Qexran/GongKeCompetition/训练/OpenMV巡线训练/训练工具TrackingLineProject_1.1/labeltool/tasks/D/verif/0094.jpg

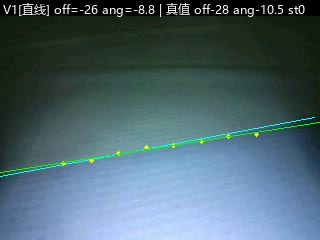
训练/OpenMV巡线训练/训练工具TrackingLineProject_1.1/labeltool/tasks/D/verif/0094.jpg
