Qexran/GongKeCompetition/README.md

# GongKeCompetition
2026年广东省工科大学生实验综合技能竞赛开源项目

持续施工中...
预计2026年1月1日完成所有工作。
给个三连吧TAT

## License

本项目基于 [Apache License 2.0](LICENSE) 开源。
