Qexran/GongKeCompetition/训练/md文档/GKS跑图评估_2026-10-09晚_四点待办.md

# GKS 跑图评估 —— 2026-10-09 晚（21:13:51 ~ 22:50:05）

> 数据源：`\\192.168.66.125\shared\Desktop\GKS_Competition\logs\`
> 覆盖 9 个 run 目录（`run_20261009_211414` ~ `run_20261009_224729`）、52 张归档帧。
> 本文只收敛**需要动手的四点**；时间线 / 视觉成功率 / 文档漂移那几节见当次会话的完整评估。

## 背景（5 行）

- 9 次跑图里 **7 次根本没跑起来**（串口找不到或刚连上就掉），跑起来的也只有 213532 跑满两趟。
- **所有跑图都是被 USB 串口掉线掐断的**，没有一次是路线逻辑跑错停下来的：
  窗口内 `[Errno 5] Input/output error` **12 次**，另有两次长时间找不到 `/dev/ttyUSB_GKS`
  （约 3.3 分钟、**12 分钟**，后者靠人工重插才回来）。
- Pi 侧的自动重启 + 重握手兜底是**活的**（每次 `握手成功（第 1 次尝试，用时 0.1s）`，重连后指令立刻恢复），
  **也没看出单片机被这条链弄聋**。这是赛前最该先解决的硬件问题，本文不展开。
- **路线与视觉本身是通的**：扫码 4/4、色球 4/4 三球齐、人质 4/4 三只齐、靶标 4/4 三色齐、
  平移射靶闭环 4/4 `SHOT ok: d=1~3px`、支点转弯接管 12/12 `PVL: r=2`（1568~1688ms）。
  抽看 13 张归档帧，**没有一张是框错的**。
- 下面四点里，**只有第 1 点是已确认的代码缺陷**（且只影响日志）；2~4 点是需要台架对照验证的可复现性问题。

---

## 1️⃣ 【固件·已确认】`ROAD fix:` 打印的是**横向**数值 —— 调试串张冠李戴

### 现象
只要同一步里横向（`use_y`）也动了，`ROAD fix: X mm(F/B)` 报出来的数字就是**横移量**，
不是纵移量；而且方向字母取自纵向、数字取自横向，两者会互相矛盾。

### 证据（`Application/app_rpi.c`）
| 行 | 代码 | 作用 |
|---|---|---|
| L1136 | `bt_fmt_f2(acMm, …, fMm)` | 纵向值写进 `acMm` |
| **L1212** | `bt_fmt_f2(acMm, …, fMmY)` | **横向值把 `acMm` 覆盖掉** |
| L1234 | `snprintf("ROAD fix: %smm(%s)", acMm, …)` | 拿被覆盖的 `acMm` 当纵向量打印 |

实际数据完全对得上（`ROAD_DX_SCALE_MM_PER_PX = 0.25`、`ROAD_DX_IDEAL_PX = 1070`）：

| 看路测得的 Δx | 横向那一行 | 打印的 `ROAD fix:` | 真正的纵向值 |
|---|---|---|---|
| 1048.7 | `fixy: skip (within deadband)` | `5.33mm(F)` | (1070−1048.7)×0.25 = **+5.33** ✅ 对（未被覆盖） |
| 1202.0 | `fixy: 4.92mm(R)` | `4.92mm(B)` | (1070−1202)×0.25 = **−33.0** ❌ 错 |
| 626.7 | `fixy: −21.86mm(L)` | `−21.86mm(F)` | (1070−626.7)×0.25 = **+110.8** ❌ 错，且与方向字母 F 矛盾 |
| 1312.0 | `fixy: 34.40mm(R)` | `34.40mm(B)` | (1070−1312)×0.25 = **−60.5** ❌ 错 |

窗口内 18 次看路里约 10 次横向也动了 → **这个 bug 在大多数步上都发作**。

### 影响
**实际运动是对的**（L1239 `vChassisMoveCameraForward(fMm, …)` 用的是没被覆盖的 `fMm`），
**只有日志一行错**。但这是「曾经把像素当角度读、导致一整轮排障跑偏」的同款陷阱：
现在这行会把人骗去调 `ROAD_DX_SCALE_MM_PER_PX` 或怀疑方向符号。

### 建议动作
L1234 之前补一句重格式化即可（一行）：

```c
bt_fmt_f2(acMm, (int)sizeof(acMm), fMm);   /* 横向那一段覆盖过 acMm, 打印前重新写回纵向值 */
(void)snprintf(acDbg, sizeof(acDbg), "ROAD fix: %smm(%s)", acMm, (fMm > 0.0f) ? "F" : "B");
```

顺手核对 `app_script.h` / `map.c` / `app_rpi.c` 里其它「两块标记共用同一个 `snprintf` 缓冲」的地方
有没有同类的跨段复用。

---

## 2️⃣ 【Pi·待查】连排两次看路，Δx 差 89~153px，而单次内散布只有 4~6px

### 现象
路线里 `看路` 是**连排两块**（本意是迭代收敛纵向）。但相邻两次测量差得离谱，而车在这两次之间
只收到了一条 5.33mm 的移动指令。

### 证据
| run | 第一次 | 第二次（约 3s 后） | Δ | 掩膜面积变化 |
|---|---|---|---|---|
| 215310 | Δx=1048.7，面积 355232，散布 4.0px | Δx=**1202.0**，面积 253516，散布 6.0px | **+153px** | **−29%** |
| 213532 | Δx=1120.0，面积 320324，散布 0.0px | Δx=**1209.0**，面积 249948，散布 20.0px | **+89px** | −22% |
| 222827 | Δx=1313.3，面积 196928，散布 2.0px | Δx=**1198.7**，面积 248228，散布 22.0px | **−115px** | +26% |

- 按 0.25 mm/px，5.33mm 的移动只该让 Δx 变 **21px** —— 实际变了 89~153px，**差一个数量级**。
- **单次内的逐帧散布只有 4~22px**，所以这不是测量噪声：**两次之间画面是真的变了**。
- 方向还不一致（+153 / +89 / −115），说明不是某个固定的系统性偏差。

### 嫌疑（按可能性排）
1. **有人在景**。这几次的归档帧里到处是人的腿/鞋/手：
   `215310/target_0001` 画面里有两条小腿，`222827/hostage_0001` 有只凉鞋，
   `221401/target_0007` 右上角有只手。跑图区显然有人围着转。
   而运行时覆盖把 `ROAD_ROI_BOTTOM` 从 0.72 放到了 **0.95**（见 `config_override.json`），
   ROI 已经把车身、地面大面积包进来，「最大连通块」的候选变多，更容易被前景干扰。
2. **补光灯开关时机**。`ROAD_LED_OFF_EN=1` 的时序是「`L,0` → 等 `ROAD_LED_OFF_DELAY_MS`(100ms) → 发 `G`」，
   而 `L,0` 要经 **MCU → Pi → OpenMV 三跳**才真的熄灯。前后两次测量只隔 3s，100ms 可能压根不够，
   灯态恰好横跨采样窗 → 两次看到的是两种照明。
3. **散布门挡不住这个**：`看路` 的 `散布超限` 判据只看**单次窗口内**的极差；
   一个人从窗口开始就站在景里、或者灯态在整个窗口里保持一致，测量就「自洽但是错的」。

### 建议动作
- **路线层**：别连排两块看路（要么去掉一块，要么中间插一个真正会改变位姿的步骤）。
- **判据层**：给看路加一道「同一停车位重复测量一致性」门，而不是继续靠窗内散布。
- **台架对照（先做这个，10 分钟能出结论）**：车摆好不动、现场清人、连发两次 `G,6000`，
  看两次 Δx 复现性；再在开/关 `ROAD_LED_OFF_EN` 两种条件下各做一遍。
  若静态复现良好 → 锅在前景/灯态；若静态就差 100px+ → 锅在测量本身（阈值/连通块选择）。

---

## 3️⃣ 【Pi + 固件】靶标「跨帧散布」作废 8/12 次，3 次把请求色整色丢掉 → 整步拒绝不动车

### 现象
`221401` 22:20 起的台架「射靶测试」里，12 次 `6`（靶标扫描）中有 **8 次（67%）**至少一个颜色被
「跨帧散布超限」作废；36 个色位丢掉 10 个（**28%**），其中蓝色最脆（12 次里 6 次被废）。

### 证据
12 次扫描的作废明细（`[WARN] 靶[X] 跨帧散布 NNpx 超限（机位在动或误检），作废`）：

```
靶[蓝] 91px | 靶[绿] 61px + 靶[蓝] 54px | 靶[蓝] 66px | 靶[红] 956px
| 靶[绿] 66px + 靶[蓝] 66px | 靶[蓝] 53px | 靶[蓝] 66px | 靶[红] 50px
```

12 次扫描保留的颜色数：红 10 / 绿 10 / **蓝 6**（应为各 12）。

**跨仓库后果**：有 3 次被作废的正好是**当次请求色**，固件收到不含该色的结果帧 →
整步拒绝、车一步不动：

```
[STM-DBG] SHOT fail: color 3 not found      ×2   (3 = 蓝)
[STM-DBG] SHOT fail: color 2 not found      ×1   (2 = 绿)
```

### 关键对比（说明这更像环境而非算法退化）
**同一晚路线内的 4 次靶标识别全部三色齐、零作废**（213532 两次、215310 一次、222827 一次）。
差别就是台架试验时人贴着车、手在画面里。

### 但脆性是真的
判定链目前是「该色整色作废 → 整步失败」。CLAUDE.md 记的 2026-10-07 那次（蓝 81px 冷启动散布被废、
cnt=2、目标红明明识别得很好）已经踩过一次；这次又踩了 3 次。

### 建议动作
- 请求色被作废时**先重采一次再判失败**（现在是一次就到底）。
- 或者把作废降级为「保留中位数 + WARN」——`截尾复核`（2026-10-07 加）已有雏形，可以再放宽一档。
- 台架上做对照时**先把人清出画面**，否则测到的是环境噪声。

---

## 4️⃣ 【固件·保持环】`TARGET_STREAM_MAX_S=12` 让保持模式每 12 秒瞎一次

### 现象
`221401` 的射靶测试（OLED 第 5 页「射靶测试」→ 保持档）里，Pi 的流线程**每 12 秒自己退出**
（`[WARN] 靶标流超过安全时长 12.0s，自动停止`），而保持环永不超时，只能靠自愈限速重发 `"7"`：

```
[STM-DBG] SHOT hold: stream stale, re-arm      ← 出现 5+ 次
```

每次重臂期间大约 **1 秒是完全盲的**（帧计数停涨 → 冻结），而保持模式的用途恰恰是
「一直咬住瞄准列」做人工标定 —— 反复瞎会直接影响标定读数。

### 附带发现：保持环的行程预算消耗比预期快
```
SHOT n=33  d=1px     tr=8mm   tot=-19mm
SHOT n=39  d=119px   tr=25mm  tot=-1mm     ← 一次扰动，1s 内 tr 25→82mm
SHOT n=54  d=7px     tr=82mm  tot=54mm
SHOT n=123 d=-226px  →  SHOT hold: noprog d=-226px frozen
```
`tc_travel_mm = 150` 只够这样一次半的大扰动。`d=-226px` 那次 noprog 冻结其实是**正确**的
（命令了约 124mm 车却不动 ⇒ 判断为锁错对象，拒动比瞎追好）。

### 建议动作
- **改 Pi 的运行时覆盖**：`TARGET_STREAM_MAX_S` 调到远大于一次实操时长
  （Web「设置参数」页可改，不用动源码、不用重启除服务和 gks 以外的东西）。
  它是安全阀（防 `"8"` 丢失后一直占相机），不是节拍器。
- 或者在保持档里让 `"7"` 只发一次、别靠自愈反复重臂。
- 若要继续用 12s：把 `tc_travel_mm` 按「一次扰动 ~60mm」重新给（现在 150 只够两次半），
  并接受每次重臂 1s 的盲窗。

---

## 附：口径

- 掉线计数 = 各 run 日志里 `接收失败: [Errno 5] Input/output error` 的行数（12）。
- 「看路」数据取自 Pi 的 `看路成功:` 行与固件的 `ROAD dx:` / `ROAD fixy:` / `ROAD fix:` 串，
  两张表按时间戳逐条手工配对（同一 attempt 的内部顺序是 `meas → dx → y → fixy → fix`）。
- 靶标作废/丢色统计取自 `221401` 的 `跨帧散布` 与 `靶标识别成功:` 行。
- 归档帧归档口径：每执行一次任务存一帧（成功 = 标注帧，失败 = 最后一帧原图），
  文件名 `<task>_NNNN.jpg` 递增不覆盖 —— ⚠️ **失败是时间维度时（跨帧/投票），
  归档的那一帧永远是"最后定格且正确"的那张**，光看图查不到原因。
