Qexran/GongKeCompetition/训练/md文档/对巡线改造第四版方案的评审.md

# 对《巡线改造（第四版）》的评审

> 结论先行：**v4 是四个版本里第一份可以批准实施的方案。** P1~P5 全部正确关闭，
> 其中"valid=0 ⟹ fWSum=0 ⟹ fW=0"的逐行核验（app_line.c:183-217）是重要新发现——
> 在 gyro_w=0 的现状下，valid=0 就是精确的"航向弃权"，不需要任何跨仓库常数。
> 但方案仍有一个**没量化过的新暴露**（R2，数字相当大）和一个**部署遗产丢失**问题（R1），
> 建议并入后再动工。

---

## 〇、P1~P5 关闭情况核验

| v3 评审项 | v4 处置 | 核验 |
|---|---|---|
| P1 angle 衰减到 0 = ±6rpm 常值旋转 | 删除衰减；窗口内保持上次可信值，窗口结束 valid=0（fW=0） | ✅ 逻辑成立；但窗口内冻结角本身有新的代价，见 R2 |
| P2 EMA 连坐删除 | 恢复 EMA(α=0.15) 作复核判据，带 robust running-mean 保护（0.5×sep 拒收）+ 只在健康帧更新 | ✅ 比我原版更好（多了拒收保护） |
| P3 二次拟合外推无 sanity | 三条门槛（控制列在跨度 1.5 倍内 / ≥6 点 / 曲率项 ≤0.5），不满足退回割线；趋势改 2~3 帧滑窗+6px 死区 | ✅ 成立 |
| P4 col_profile 无消费者 | 随 P2 恢复（EMA 复核需要 a/b） | ✅ |
| P5 阶段二时机 | 接受"赛后/§6 基线后再决定" | ✅ |

另外两处值得肯定的进步：
- **valid=0 ⟹ fW=0 的逐行核验**正确——这直接把"弃权"的实现成本降到零（发 valid=0 即可），
  也反过来解释了为什么 v2 的 NEUTRAL 常数从一开始就是多余的；
- 风险节**主动自曝**了强弓形直线的全点 RMS 误命中（两半斜差对弓免疫、全点 RMS 不免疫，
  两条判据是 OR）——这是本方案最诚实的自我标记，见 R3。

---

## R1【部署遗产】阶段一以 435 行原版为基底，会第三次丢掉两样已验证的修复

E:\main.py 当前是原版（435 行、4 字段、13条×12px、LED 1kHz）。方案的"不做"清单写着
"不动……LED、串口"，阶段一也完全没提性能——那么按此重写后：

1. **LED 蜂鸣修复丢失**：`freq=20000`（20kHz，实车确认过的蜂鸣问题）不在原版里，
   重写后蜂鸣声回来。一行改动，务必带上。
2. **帧率优化与测量仪器丢失**：STRIP 12→20（每帧 get_statistics 106→66 次）、
   邻域 ±1 条、色带 40/24、分阶段剖析器——都在 `.bak-strip20` 里。用户的未结抱怨
   恰恰是"帧率低、响应慢"，而 v4 新增的一堆动态阈值（OFFSET_SLEW / LOST_GRACE_MS /
   TRACK_GATE_PX 新鲜度）全部需要真实 fps 才能标定——**剖析器正是标定它们的仪器**。

**要求**：阶段一的基底改为 `.bak-strip20`（或显式移植上述三样），验收清单加一条
"prof 行 fps ≥ 20 且 LED 无声"。

## R2【新暴露，需量化】600ms 宽限窗内"冻结角 + valid=1" = 一次有界的航向过冲，但界不小

窗口期内 angle 不发新值、保持上次可信值，且 valid=1 → 固件航向环
**每拍都在拿这个冻结角当活测量做 P 控制**。过冲量的推演
（LINE_ANGLE_TO_W=2.0 rpm/°，1 rpm = 6°/s，LOST_GRACE_MS=600ms）：

| 出画前最后一帧的 angle | 航向环输出 | 600ms 内的偏转 |
|---|---|---|
| 0°（对齐常态，目标 −3°） | 6 rpm ≈ 36°/s | **≈ 22°** |
| 5° | 16 rpm ≈ 96°/s | ≈ 58° |
| 13.7°（img_0007 型） | 33 rpm ≈ 200°/s | **≈ 120°**（贴近 LINE_W_MAX=40rpm 限幅） |

也就是说：**最常见的"对齐状态下短暂丢线"事件，每次都要白给 20° 出头的航向偏转**；
拐角型角度下接近满限幅转半圈。原版（立即 valid=0）和我方版本都没有这个暴露——
它是宽限窗新引入的。若丢线原因是减速带撞击（正是本方案要救的场景），
这 20°~120° 叠加在撞击本身造成的航向紊乱上。

**建议（任选其一，都很便宜）**：
1. **窗口进入条件**：只有 `|last_angle| ≤ ANGLE_WINDOW_MAX_DEG(≈5°)` 时才开宽限窗
   （用 |last_angle| 作 |angle−target| 的代理，注明真常数在固件侧）；
   超限直接 valid=0 + state——方向反正由 Pi 定向找线接管；
2. **横摆预算缩窗**：`GRACE_MS = min(600, YAW_BUDGET_DEG / (|last_angle+3|×12°/s))`
   ——对齐情形给满 600ms，大角度情形自动缩到几十毫秒。

顺带指出一个更深的张力（台架要专门测）：只要 line_angle_target≠0，
valid 0↔1 抖动时**航向通道就是 (angle−target)×2 ↔ 0 的方波**，幅度随
|angle−target| 增大——在拐角处（切线 13~30°）恰好最大。v3 的"抽搐"如果实车日志显示
旋转通道在抖，根子在这里，而不是 steer 通道（steer 在保持期≈PID，本来就近乎连续）。

## R3 强弓形误命中（方案已自flag，补一个降险建议）

两条判据是 OR → 强弓形直线必然走全点 RMS 那条误命中。可以降险：
**分级而非并联**——两半各 ≥2 点时以两半斜差为唯一判据（对弓免疫）；
只有半边点不够时（0004/0006 型）才允许全点 RMS 兜底。
弓形误判就只剩"半边点不够 + 恰好弓形"的组合，暴露面小得多。
0004/0006 的兜底能力保留。台架复标时按这个结构测。

## R4 小项

- 文档"风险/验收"两节重复粘贴了一遍（编辑痕迹），定稿前清一下；
- img_0001 验收期望 state=3 与方向推演一致（+100 → err=−0.8 → 远离边界）✓；
- LOST_GRACE_MS=600ms 与 Pi 侧 LINE_STALE_TIMEOUT=0.5s / 30Hz 转发无时序冲突（已核）；
- EMA α=0.15 + 0.5×sep 拒收 + 健康帧更新——比我方原版（固定 α、无拒收）更完善，采纳。

---

## 结论

| 项 | 判定 |
|---|---|
| P1~P5 关闭 | ✅ 全部成立 |
| R1 部署遗产（LED 20kHz + strip20/剖析器） | ❌ 需并入阶段一基底 |
| R2 宽限窗冻结角的航向过冲（常态 ≈22°/次，拐角型可到 120°） | ❌ 需加窗口进入条件或按横摆预算缩窗 |
| R3 强弓形误命中 | ⚠️ 已自flag；建议"分级判据"降险 |
| 总体 | **批准实施（并入 R1/R2 后）**；§6 排查清单最先执行，拿基线 |

执行顺序建议：§6 摆车读 ang（零代码，定"越来越偏"的因）→ 阶段一（基底 = .bak-strip20
+ 本方案全部条目 + R1/R2 修正）→ PC 回归 + 台架复标 → 实车日志标定动态阈值 →
赛后决定阶段二。
