Qexran/GongKeCompetition/训练/md文档/爆爆桶对位_改动与适配指南.md

# 爆爆桶对位（看爆爆桶）—— 改动清单与适配指南

> 2026-10-24 实现 · 覆盖 OpenMV（相机盘 E:\） / 树莓派（GKS_Competition） / 单片机（GongKeCompetition）三端
> 相机固件版本升 **v3.4**（开机 UART 横幅 `gks-line v3.4 (2026-10-24: 新增爆爆桶检测 'B'起流/'b'停流)`）

---

## 1. 功能总览

爆爆桶（黑色桶块）对位是一个**独立阶段任务**（对位时车不巡线，2026-10-24 定案）：

```
OpenMV v3.4（检测黑色桶，每帧只报面积最大的一个桶 = 最近/最清晰）
   │  UART 文本帧: "B,<valid>,<cx>,<cy>,<w>,<h>\r\n"   @115200
   │  控制字节: 'B'=起流  'b'=停流  'S'=全停（兼容）
   ▼
树莓派（纯转发，独立线程，~20Hz；与巡线流/靶标流三方互斥）
   │  二进制 COORD 帧 TAG=0x0B: [0x0B][status][cx][cy][w][h] = 10B 定长
   │  单片机命令: "J"=起流（可带毫秒预算 "J,15000"）  "K"=停流
   ▼
单片机 ucRpiBarrelAlign（0x0B 流帧 → cx 偏差 → 纵移闭环）
   │  轴映射与平移射靶同款：相机装 90°，图像 cx ↔ 车体纵移 v_y（vChassisMoveCameraForward）
   ▼
底盘（位置/速度双模式；收敛拍数 + 行程闸 + noprog 闸 + 停稳窗）
```

设计要点（决策记录）：
- **多桶策略 = "OpenMV 挑好再报"**：相机端每帧只报面积最大的一个桶，Pi 不掺和选择（以后换策略只改相机/单片机，帧不变）。
- **检测不用任何 LAB 颜色阈值表**：暗阈值 L<26 一把尺（运行时可调），换场地不用重标颜色。
- **未标定自举**：`bc_cx_aim=0` 时对位步进**只测不改**模式——起流采 3 秒报中位 cx、一格不动（`BKT meas:` 日志行 + 蓝牙遥测 `bucket_err`），解决"瞄准常数永远是 0"的鸡生蛋问题。
- **帧活性靠帧计数**（同 0x05 靶标流语义）：无桶/陈旧也照发，`status bit0` 才是"本拍有没有桶"。

---

## 2. 帧契约速查

### 2.1 OpenMV → Pi（UART 文本，115200）

```
B,<valid>,<cx>,<cy>,<w>,<h>\r\n
```

| 字段 | 含义 |
|---|---|
| valid | 1=本帧选中了一个桶；0=没找到（坐标为上一帧沿用值，同 L 帧语义） |
| cx/cy | 选中桶 bbox 中心像素坐标（**320×240 QVGA 口径**） |
| w/h | 桶 bbox 宽高 [px]（轴对齐外接框） |

### 2.2 Pi → 单片机（二进制 COORD，TAG=0x0B，~20Hz）

```
DATA = [0x0B][status u8][cx u16 LE][cy u16 LE][w u16 LE][h u16 LE]   共 10 字节
```

| 字段 | 含义 |
|---|---|
| status | bit0 = 1 本拍有桶 / 0 无桶或数据陈旧（流还活着，帧计数照涨）；其余位保留 |
| cx/cy/w/h | 同上；valid=0 时是沿用值 |

示例（valid=1，桶中心 (143,67)、85×54）：
`0B 01 8F 00 43 00 55 00 36 00`

### 2.3 单片机 → Pi 命令

| 命令 | 含义 |
|---|---|
| `"J"` | 爆爆桶坐标流开始（独立线程，0x0B 流帧 ~20Hz）；`"J,<毫秒>"` = 单片机愿意等多久（同阻塞类指令口径，Pi 折算预算） |
| `"K"` | 爆爆桶坐标流停止（幂等） |

### 2.4 Pi → OpenMV 控制字节

| 字节 | 含义 |
|---|---|
| `'B'` | 开始爆爆桶流（发 B 帧；桶模式独占时跳过巡线测量省帧预算） |
| `'b'` | 停止爆爆桶流 |
| `'S'` | 全停（巡线 L 流 + 爆爆桶 B 流） |

### 2.5 与既有协议的兼容性（三端任一端不升级都不炸链路）

- 旧相机收到 `'B'` → 未知控制字节，忽略 → 流起不来，单片机帧计数停涨自动冻结（安全退化）。
- 旧 Pi 收到 `"J"` → 未知指令打一行 WARN。
- 旧单片机收到 0x0B 帧 → 没有该分支，10B 帧落进通用 last-packet 分支（不会误触发什么，等待方靠超时长鸣退出）。
- **旧固件发裸 "J" 没问题**；新 Pi 收到未知 'B' 字节进 openmv 串口时也只是忽略。

---

## 3. 各端改动文件清单

### 3.1 相机端（E:\，OpenMV MicroPython）

| 文件 | 改动 |
|---|---|
| `main.py` | v3.4：新增「爆爆桶检测」段（常量 + `bucket_probe/bucket_filter_pick/bucket_tiles/bucket_detect/bucket_frame_work`）；UART 加 `'B'/'b'` 命令与 `'N'` 参数（暗阈值 BUCKET_L_MAX，'V' 回执带 N=）；主循环加桶模式独占分支（第 0 步）与两流同开兜底（第 7.5 步）；桶模式下拍照仍可用（'P' 存的是带检测框的帧） |
| `bucket_test.py`（新） | 台架验证脚本：同目录有 1.bmp~6.bmp → 回放模式（打印候选簇/剔除原因/命中/耗时）；无 → 实时预览画框 + 1s 统计。不碰 UART 不写盘 |

相机端检测算法（标定依据：`C:\Users\Administrator\Desktop\爆爆桶图像\1~6.bmp`，2026-10-24 实拍）：
- 检测带 ROI y∈(30,175)（实拍桶体全部在内，避开顶部暗区/底部蓝区）。
- 暗阈值 `BUCKET_L_MAX=26`：桶 lum 4~8、地面 85~150、顶部暗区 ≥29，两侧都有余量。
- **几何剔线**（黑界线与桶亮度完全相同，只能几何区分）：宽>280 或 宽/高>8 或 左右同时触边 → 判线丢弃；桶 sanity 20≤w≤240、15≤h≤140。
- 主路径 `find_blobs`（进桶模式首帧探 3 种调用形态——本固件 2026-09-13 有 "can't convert tuple to int" 前科）；探测全败或运行中异常 → **永久落** `get_statistics` 瓦片网格兜底（16×16 瓦 180 块 + 4 邻接聚类 + 4px 列细扫精化 cx，~60ms/帧，全项目验证过的 API 必可用）。
- 实际走的路径会打印 +（DIAG 开时）镜像 UART：`自检: find_blobs 用 'lab' 形态` 或 `→ 瓦片兜底`。

### 3.2 树莓派端（\\192.168.143.125\shared\Desktop\GKS_Competition）

| 文件 | 改动 |
|---|---|
| `openmv_serial.py` | `_parse_bucket_line()` 解析 B 帧（**在 _parse_line 之前拦截**，防污染 bad_lines）；缓存 `_bucket/_bucket_ts`；`get_latest()` 增加 `bucket` 子字典（valid/cx/cy/w/h/timestamp/expecting/silent_s）；`send_command` 支持 `'B'/'b'`（expecting 状态 + "发了 B 无数据"告警） |
| `tasks/_bucket.py`（新） | 转发线程 `run_bucket_stream`：取快照 → 判新鲜（BUCKET_STALE_TIMEOUT）→ `build_bucket_frame`（函数名刻意唯一，防 __init__.py 重导出覆盖）→ `send_frame(TYPE_COORD, ...)`；`BUCKET_SEND_HZ` 限流；abort/超时/断串口退出 |
| `tasks/__init__.py` | 导出 `run_bucket_stream, build_bucket_frame` |
| `handler.py` | `"J"/"K"` 注册（"J" 进 `_MS_COMMANDS` 支持毫秒后缀）；`_cmd_bucket_start/_cmd_bucket_stop`（照靶标流模式：收尾等待窗 + 重复启动忽略 + finally 兜底发 'b'）；**三方互斥**——起桶流前停巡线流+靶标流，巡线/靶标/阻塞类任务起流前也停桶流；`"x"` 取消、`end/r/RM` 重启、`_safe_restart_program`、串口重连收尾全部联动停桶流 |
| `config.py` | `BUCKET_SEND_HZ=20` / `BUCKET_STALE_TIMEOUT=0.5` / `BUCKET_MAX_S=30` / `BUCKET_LOG_HZ=1`，全部登记 EDITABLE_CONFIG（Web「设置参数」可在线调） |
| `docs/串口协议.md` | 命令表加 J/K 两行；新增 **§6m 爆爆桶坐标流** 章节（帧布局/示例/多桶策略/部署顺序） |

### 3.3 单片机端（C:\Users\Administrator\Desktop\GongKeCompetition，9 个文件）

| 文件 | 改动 |
|---|---|
| `app_rpi.h` | 帧常量 `RPI_BUCKET_TAG=0x0B` / `RPI_BUCKET_LEN=10` / `RPI_BUCKET_ST_OK`；命令枚举 `RPI_TASK_BUCKET_START=28 "J"` / `RPI_TASK_BUCKET_STOP=29 "K"`（尾注释单行，控制台解析要求）；`ucRpiBarrelAlign` 声明 |
| `app_rpi.c` | `s_apcTaskCmd` 加 "J"/"K"；COORD 分发加 **0x0B 分支（插在通用 `ucDataLen>=9` 之前**——否则整帧被当 last packet 吞掉）；新原语 `ucRpiBarrelAlign`（含 `BKT_*` 内部常量） |
| `app_config.h` | `BUCKET_ALIGN_*` 十六个编译期默认宏（含取值范围与标定方法注释） |
| `app_beam.c` | `bc_*` 静态量 + getter/setter + `BEAM_ADAPT_*` 适配器；桶帧快照 `vSetBucketFrame/vGetBucketFrame/ulGetBucketFrameCount`（临界区、只帧计数无 ready）；蓝牙参数表「爆爆桶」组 18 行（含只读遥测 `bucket_err`） |
| `app_beam.h` | bc_* 声明 + 桶帧快照声明 |
| `app_script.h` | 积木枚举 `STEP_BARREL_ALIGN_WAIT` + DSL 参数注释行 |
| `app_script.c` | `case STEP_BARREL_ALIGN_WAIT`（调 `ucRpiBarrelAlign`；刻意**不进** FillTaskOf——车的补光照不到桶，OpenMV 自带补光上电常亮） |
| `map.c` | 预设表 `g_astScriptPreset46`（等握手 → 爆爆桶对位 20s）+ 注册表行 `{46, "测试爆爆桶对位", ..., 1u 可重入}` |
| `map.h` | `SCRIPT_PRESET_46` 枚举成员 + `SCRIPT_PRESET_NEXT_ID 47u` |

对位原语 `ucRpiBarrelAlign(timeout, keep_res)` 的流程（照抄平移射靶精调环，跳过二维码/粗调/双相机段）：

```
① 起流：发 "J"（等链路，失败直接返回，不发 "K"）
② 等停稳：连续 3 个新帧桶 cx 变化 < 4px（上限 800ms，到点照常往下走）
③ 若 bc_cx_aim=0（未标定）→ 只测模式：采 3s 报中位 cx（"BKT meas:" 行），停流返回 0
④ 闭环（每拍 bc_ctrl_ms=180ms）：
     中止位 → 帧新鲜度（停涨 > bc_stale_ms 冻结；> 2× 且限速到 → 重发 "J" 自愈）
     → 取桶帧（无桶continue）→ fDpx = cx − bc_cx_aim（swap 选轴）
     → 收敛判据（|fDpx| < bc_conv_px 连续 bc_conv_ticks 拍，排在 noprog 之前）
     → 偏差mm = fDpx × bc_px_to_mm × bc_sign → 位置模式（钳 ±bc_step_mm，
       阻塞 vChassisMoveCameraForward 纵移）/ 速度模式（rpm 连续修，零速带顶格）
     → 最小出力门 bc_db_mm / 行程闸 bc_travel_mm / noprog 闸
⑤ 无论成败发 "K" 停流（速度模式先显式停车）
⑥ keep_res=1 → 累计纵移折世界系记「路径残留偏移」
⑦ 收官：BKT ok / fail: noprog / fail: travel / abort / fail: timeout
```

---

## 4. 部署步骤（三端都向后兼容，推荐此序）

### 第 1 步：树莓派

```bash
sudo systemctl restart gks
```

- 验证：`journalctl -u gks -f` 无 import 错误；旧相机在位时无异常刷屏。
- 此时可先用**模拟器**（TCP:9997）验证 0x0B 帧收发。

### 第 2 步：相机（E:\）

1. 拷 `main.py` + `bucket_test.py` 到相机盘根，重启相机。
2. **先把 6 张实拍 bmp（`C:\Users\Administrator\Desktop\爆爆桶图像\`）拷到相机盘根**。
3. OpenMV IDE 打开 `bucket_test.py` ▶ 运行 → 回放模式：
   - 每张图打印 `命中 cx=.. cy=.. w=.. h=..` + 候选簇与剔除原因（`剔:过宽/过扁(线)` 等）；
   - 6/6 命中即算法与阈值就绪；命中率低 → 按剔除原因调 `BUCKET_L_MAX`（26→±5 扫）或几何门。
4. `tune_test.py`（Pi 上 `~/Desktop/tune_test.py`，需先 `sudo systemctl stop gks` 独占串口）：
   发 `B` 起流 + `D` 开遥测 → 应看到 `B,v=1,cx=..` 帧与 `#桶 v=1 ...` 状态行；发 `N30` 看阈值即时生效回执 `#OK N=30.0`。
5. 台架实时模式（删掉/挪走 bmp 再跑 bucket_test.py）看 fps：find_blobs 路径应 >20fps；瓦片兜底 ~13-15fps。

### 第 3 步：单片机（需 Keil，人工执行）

1. Keil 打开 `MDK-ARM/GongKeCompetition.uvprojx` 重新编译（本机无 AC5，**未编译过，以编译结果为准**）。
2. 烧录后，控制台（webconsole）重启 + 浏览器 Ctrl+F5（积木目录是加载时拉的）。
3. 蓝牙 Tab 应出现新分组「爆爆桶」（18 个参数 + 遥测 bucket_err）。

---

## 5. 现场标定流程（预设 46「测试爆爆桶对位」，可重入）

**前提**：车摆到"正对爆爆桶、即推桶臂/车头动作的起始位姿"。

| 步骤 | 操作 | 看什么 |
|---|---|---|
| ① 读瞄准列 | 不填 bc_cx_aim（保持 0）→ 跑一次预设 46 | `BKT meas: cx=143 cy=67 w=85 h=54 n=..  <-- 填进 bc_cx_aim`；或蓝牙遥测 bucket_err 稳定值。把 cx 填进蓝牙「爆爆桶」组 `bc_cx_aim` |
| ② 定方向 | 前后挪车 ±20mm，各跑一次 | `bucket_err` 变大 = bc_sign 对；单调变小也正常（在逼近）；**跑起来后偏差越来越远 = bc_sign 反了，改 -1** |
| ③ 标比例尺 | 记下挪动的真实 mm ÷ bucket_err 变化 px | 填 `bc_px_to_mm`（出厂 0.8 是**占位值**，必须实测重标） |
| ④ 收敛验证 | 再跑一次预设 46 | 日志 `BKT ok: d=..px`，车应自动微调到桶正对后停住；已在死区内则第一拍就收敛 |

标定完把终值回写 `app_config.h` 的 `BUCKET_ALIGN_*` 固化（同 tc_* 那套纪律）。

---

## 6. 参数速查表

### 相机端（'N<0~100>\n' 运行时调，重启回编译值）

| 参数 | 默认 | 说明 |
|---|---|---|
| BUCKET_L_MAX（'N'） | 26 | 暗阈值。检不到桶 → 调大；把暗区/阴影检进来 → 调小 |
| BUCKET_ROI_Y | (30,175) | 检测带。桶在画面里的高度带变了才动它 |
| BUCKET_LINE_W / _AR | 280 / 8.0 | 剔线门。误把桶当线删 → 抬宽门；线漏进来 → 降 |
| BUCKET_TILE | 16 | 瓦片边长（仅兜底路径）。帧率不够可放大（漏远端小桶则缩小） |

### 树莓派（Web「设置参数」在线调）

| 参数 | 默认 | 说明 |
|---|---|---|
| BUCKET_SEND_HZ | 20 | 转发上限频率；相机 ~13-15fps 时有新帧就发 |
| BUCKET_STALE_TIMEOUT | 0.5 | B 帧过期阈值（秒），过期按 valid=0 发 |
| BUCKET_MAX_S | 30 | 流安全上限（秒）；"J,\<ms\>" 会覆盖 |
| BUCKET_LOG_HZ | 1 | 状态日志限流 |

### 单片机（蓝牙「爆爆桶」组，断电回编译值）

| 参数 | 默认 | 说明 |
|---|---|---|
| bc_cx_aim | 0 | 瞄准列 [px]（0~320）。**0 = 只测模式**（标定自举） |
| bc_swap | 1 | 轴映射：1=cx→纵移（本车）；0=cy→纵移（换装法才改） |
| bc_px_to_mm | 0.8 | 比例尺 [mm/px]。**占位值，必须实测重标** |
| bc_sign | +1 | 纵移方向。偏差单调变大 = 反了改 -1 |
| bc_db_mm | 3.0 | 最小出力门 [mm]。**与 conv_px 配套**：conv_px × px_to_mm 应 ≥ db_mm，配反会"带外却永不出力"白烧超时 |
| bc_conv_px / bc_conv_ticks | 6.0 / 6 | 收敛带 [px] / 拍数。别比检测噪声（±2~4px）和 1rpm 顶格步长（~1.7px/拍）更紧 |
| bc_kp_scale / bc_step_mm | 0.8 / 20 | 环增益 / 单拍上限。振荡降 kp |
| bc_travel_mm | 150 | 行程闸（安全夹） |
| bc_ctrl_ms / bc_stale_ms / bc_meas_ms | 180 / 600 / 3000 | 节拍 / 帧新鲜度 / 只测时长 |
| bc_vel_mode | 1 | 0=位置模式（每拍一步停一步）1=速度模式（连续修） |
| bc_accel / bc_speed | 120 / 60 | 纵移加减速 |
| bucket_err（只读） | — | 本拍桶偏差 [px]——标定与排障第一入口 |

---

## 7. 排障指南

| 症状 | 先查什么 |
|---|---|
| 跑对位步秒退、日志 `BKT meas: ... n=0` 或一直 settle | 相机没升级到 v3.4（发 'B' 无回应——openmv_serial 会打"已触发爆爆桶流('B')但 Ns 无 B 帧"）；或 OpenMV 未上电/插错口 |
| Pi 日志 bad_lines 猛涨 | 相机在发 B 帧但 Pi 解析器是旧版（部署顺序错了：先 Pi 后相机） |
| 单片机帧计数停涨、冻结不动 | Pi 侧流线程死了（看 `[爆爆桶流]` 日志与 fps）——正常时 `BC_MAX_S=30s` 会自退、单片机 2×stale 后自愈重发 "J" |
| 回放模式命中率高、实时不命中 | 实时帧过了 `lens_corr`（回放样本是已校正的 'P' 帧）——用 'P' 拍现场帧喂回放对比；多为光照差异，调 'N' |
| 桶检到了但 cx 抖 ±8px | 走的是瓦片兜底路径（`探no`）——正常，列细扫已压到 ±2px；仍抖则 bc_conv_px 放大到 ≥8 |
| 桶贴黑界线时 valid=0 | 粘连成大块被剔线门杀——宁缺勿假是有意行为；调 ROI 上沿避开线，或等分榜现场给桶前留出地面 |
| 偏差单调变大 | bc_sign 反了 |
| 原地振荡 | 降 bc_kp_scale 或加大 bc_db_mm |
| `BKT fail: noprog` | 方向反 / 比例尺离谱 / 桶被顶住 —— 看 BKT n= 过程串的 d 走向 |
| `BKT fail: travel` | bc_travel_mm 用光：方向反或误检带飞；先看 bucket_err 遥测 |

---

## 8. 已知限制与诚实记录

1. **单片机 C 代码未经编译**（本机无 Keil/AC5）——全部按 `ucTargetShootCore` 既有模式书写，以编译结果为准；改了 app_script.h/map.* 后控制台要重启 + Ctrl+F5。
2. **find_blobs 探测结果未知**：三种形态（lab/flat/gray）若全失败自动走瓦片兜底，`#` 遥测与 IDE 打印会标明实际路径。
3. **桶贴黑界线粘连**是最大的算法风险（亮度完全相同）；几何过滤宁可错杀（valid=0）不放假桶。
4. **bc_px_to_mm=0.8 是占位值**，上场前必须按 §5-③ 实测重标。
5. E:\main.py 的改动通过补丁脚本完成（E 盘对编辑工具只读），补丁带 CPython 语法自检且已通过；**MicroPython 运行时行为仍需上机验证**（已规避 math.hypot 等 MP 不支持的 API，全部沿用工程验证过的 get_statistics / draw_* / % 格式化）。
6. 会话中 Windows shell 与 SMB 共享一度故障，树莓派 5 个 Python 文件均已通过 py_compile；共享恢复后建议肉眼过一遍 `handler.py` 的「爆爆桶坐标流」段（约 1146 行起）。
7. 临时工作目录 `C:\Users\Administrator\Desktop\_bucket_work`（补丁脚本/探针/文档中间件）用完可删。
8. 三端改动**均未提交 git**（E:\ 仓库 + 单片机仓库 + 树莓派仓库），需要的话再说。

---

## 9. 后续可扩展项（按需再做）

- **同时巡线+看桶**：相机端两流可同开（帧率掉到 ~10fps），Pi 侧把 0x0B 并进 `_line.py` 同一循环即可（现架构是互斥的，用户当前选择独立阶段）。
- **多桶上报**：0x0B 改 count 数组版（照 0x04 布局），单片机按"离瞄准列最近"挑——当前"挑好再报"够用。
- **对位后自动推桶**：预设里在 `STEP_BARREL_ALIGN_WAIT` 后排 `STEP_CHASSIS_MOVE_CAMERA_*`/世界系平移积木即可，无需新代码；keep_res=1 时勾"叠加残留"把对位平移吃进下一步。
- **OLED 测试页**：照「射靶测试」页给爆爆桶加一页（读 bucket_err + 保持档），现场调瞄准列更顺手。
