Qexran/GongKeCompetition/训练/OpenMV巡线训练/训练工具TrackingLineProject_1.1/harness/out/B_report.txt

===== 视频21: 容器帧 520 → 内容帧 276 =====

================ 视频21 | 内容帧 276 帧 = 19.7s ================
-- 分段时间线 (起-止 帧: 标签, off 均值) --
  #   0- 275: [直线(有效)]  off均值= -55.8  长276
-- 异常检测 --
  (无标签翻转 / 无 offset 跳变)
-- 汇总: 有效率 276/276 = 100% | [直线V ×n]
角度帧间步: n=275 max=2.30° p95=1.20° median=0.20° 超0.3°帧占比=42%
静态段(|Δoff|<=2)角度步: n=273 max=2.30° p95=1.20° median=0.20° 超0.3°=42%
叠加图已存: f0001, f0038, f0041, f0047, f0055, f0115, f0116, f0163

===== 视频22: 容器帧 456 → 内容帧 232 =====

================ 视频22 | 内容帧 232 帧 = 16.6s ================
-- 分段时间线 (起-止 帧: 标签, off 均值) --
  #   0- 231: [直线(有效)]  off均值=  +5.0  长232
-- 异常检测 --
  (无标签翻转 / 无 offset 跳变)
-- 汇总: 有效率 232/232 = 100% | [直线V ×n]
角度帧间步: n=231 max=2.30° p95=1.20° median=0.20° 超0.3°帧占比=41%
静态段(|Δoff|<=2)角度步: n=231 max=2.30° p95=1.20° median=0.20° 超0.3°=41%
叠加图已存: f0046, f0083, f0113, f0115, f0131, f0133, f0153, f0207

===== 视频23: 容器帧 456 → 内容帧 240 =====

================ 视频23 | 内容帧 240 帧 = 17.1s ================
-- 分段时间线 (起-止 帧: 标签, off 均值) --
  #   0- 239: [直线(有效)]  off均值= -72.0  长240
-- 异常检测 --
  (无标签翻转 / 无 offset 跳变)
-- 汇总: 有效率 240/240 = 100% | [直线V ×n]
角度帧间步: n=239 max=2.90° p95=2.00° median=0.20° 超0.3°帧占比=46%
静态段(|Δoff|<=2)角度步: n=228 max=2.90° p95=1.80° median=0.20° 超0.3°=45%
叠加图已存: f0026, f0037, f0068, f0069, f0124, f0181, f0189

===== 视频24: 容器帧 229 → 内容帧 120 =====

================ 视频24 | 内容帧 120 帧 = 8.6s ================
-- 分段时间线 (起-止 帧: 标签, off 均值) --
  #   0- 119: [直线(有效)]  off均值= -58.5  长120
-- 异常检测 --
  (无标签翻转 / 无 offset 跳变)
-- 汇总: 有效率 120/120 = 100% | [直线V ×n]
角度帧间步: n=119 max=2.00° p95=1.50° median=0.20° 超0.3°帧占比=36%
静态段(|Δoff|<=2)角度步: n=116 max=2.00° p95=1.40° median=0.20° 超0.3°=35%
叠加图已存: f0060, f0065, f0066, f0067, f0082, f0084, f0099, f0105

DONE
