Qexran/GongKeCompetition/训练/md文档/GKS代码审查报告_2026-10-06.md

# GKS 工科赛 —— 双仓库代码审查报告

**日期**：2026-10-06
**范围**：

- `C:\Users\Administrator\Desktop\GongKeCompetition`（STM32F407 + FreeRTOS 固件 + 本地 Web 控制台）
- `\\192.168.135.125\shared\Desktop\GKS_Competition`（树莓派端 Python）

**方法**：
1. 12 路并行静态审查（固件 6 路 / Pi 6 路），各自对照两仓的 `CLAUDE.md` 与 `docs/串口协议.md`，只报**真实缺陷**，不报风格问题、不把文档里写明的有意取舍当 bug（但代码与文档不一致的**照报**）。
2. 固件全量重编译（Keil UV4 `-r`）：**0 Error / 0 Warning** —— 所以下面这些问题编译器一个都看不见。
3. 我对**跨仓库契约**与**最高危的若干条**做了独立复核（读 HAL 源码、跑 Python 实测、逐行对代码）。

**标注约定**：`【已核实】` = 我本人复核过（读源码/实测）；`【审查员发现】` = 单路审查报告，未独立复核。

**总体结论**：两仓的**帧协议契约完全一致**（CRC8 表 256/256 逐字节相同，命令码双向对齐，8 种结果帧的字段序/长度/端序/坐标缩放全部对上）—— 通信层是干净的。问题集中在**上层时序、状态机边界、以及"静默失效"类**：参数改了不生效、功能整段不工作、日志谎报等。固件侧最重的是「标靶流控距离辅助空转」「测试积木能污染帧栈」「蓝牙编辑模式一条入场路径是死的」；Pi 侧最重的是「巡线起流会被上一条的收尾吞掉」「锁定阶段的多帧投票是空操作」「失败留档挡在结果帧之前」。

---

# 第一部分：STM32 固件（GongKeCompetition）

## A. 会静默失效 / 有物理后果

### A1. 标靶流控「距离辅助」永远不动车 —— 同一拍把自己清掉【已核实】

位置：`Application/app_rpi.c:4120-4128` 与 `:4166`

```c
4120    fMm         = fMmDist;      /* 距离辅助算出的挪车量 */
4121    ucMmLateral = 1u;
4128    ucStage     = TS_STAGE_X;   /* 回 X 重修 */
...
4166  if ((ucSeqEn == 0u) || (ucStage == TS_STAGE_X)) { fMm = 0.0f; ucMmLateral = 0u; }
```

距离辅助在**本拍**先把 `fMm` 写好，紧接着（4128 行）把 `ucStage` 翻回 `X`；于是 4166 行那道门控
（本意是"阶段 2 不许清，否则会抹掉距离辅助的量"）此刻条件成立 → **刚刚算出的挪车量被抹成 0**。
下发段 `if (fMm != 0.0f)`（`:4275`）恒假。

更糟：4167 的底盘接管块此时**反而会跑**，若 `ucChasActive != 0` 就把 `fMm` 重新赋成 CX 那一路的
**前后**进给量 —— 轴和方向都不是距离辅助想要的。

**后果**：`ucDistMoves++`、`fDistTravel += |mm|`、回 X 重修一圈全都照做，日志照打
`TGTS dist#N mm=..`，**唯独车一步不走**；`ts_dist_mm` 行程闸也因此永远不涨。
`ts_dist_en=1`（出厂 1）+ `ts_dist_px_to_mm≠0`（现场标定填了才非 0）时即可复现 ——
也就是"这个功能一标定就废"。这是 2026-10-06 新加的三层处方里的第③层。

**修法**：在循环体顶部快照 `ucStage` 再判，或把 `ucStage = TS_STAGE_X` 挪到下发之后，
或用一个「本拍已由距离辅助置位」的标志代替 `ucStage` 做清零判据。

### A2. 「测试」积木能测 `STEP_SCRIPT_CALL` / `SCRIPT_RETURN` → 帧栈泄漏、路线被静默截断【已核实】

位置：`Application/app_script.c:494-500`（防呆名单）、`:1133-1141`（唯一的弹帧点）

防呆只拒绝了 `TEST_LOOP_WAIT` / `SCRIPT_RESET` / `IF` / `ELSE` / `END_IF` / `STEP_COUNT`，
**漏了 `STEP_SCRIPT_CALL` 与 `STEP_SCRIPT_RETURN`**。而弹帧（`s_ucScriptDepth--`）**只存在于
`vScriptRun` 的循环里**，`vScriptTestLoop` 走的是 `vScriptExecStep`，永远不弹。

- 测 `STEP_SCRIPT_CALL`：压一帧、深度 +1，测试块结束后 `vScriptRun` 把**被跳入的那张表**当成
  当前帧继续跑 → **后半张路线被丢弃**（无报错）。
- 测 `STEP_SCRIPT_RETURN`：`vScriptReturn` 直接把**真实帧**的 `usIdx` 置到表尾（`:352`）→
  测试一跑完，正在跑的路线**就此结束**。

这与注释里「选 IF 标记这条不是保险，是必须的」同性质，应一并长鸣拒绝。

### A3. 蓝牙机械臂编辑模式：「脚本没在跑」这条入场路径是死的【已核实】

位置：`Application/app_bt.c:441`（入场门）vs `:189`（使用闸门）

- 入场门放行条件：`ucGetBtHsWait()==0` **且** 脚本没在跑 → `vSetBtEditMode(1u)`。
- 使用闸门 `bt_edit_active()` = `editMode && bt_hs_wait` —— **要求 `bt_hs_wait != 0`**。
- 而 `bt_hs_wait` 的两个写者全在脚本侧且离开即清零（`app_rpi.c:534/546/581`、`app_bt.c:245/270`；
  已全仓库 grep 确认无其它写者）→ **脚本空闲时它恒为 0**。

**后果**：能进编辑模式、能收到 `$B,OK`（控制台 toast 报「已进入」并放开滑杆与「获取当前位姿」），
但随后每一次 `JOG/GRIP/ARM/POS/PLAY` **全部回 `$B,ERR,NOTEDIT`**。
与 `tools/webconsole/CLAUDE.md`「② 脚本根本没在跑…放行是安全的」直接矛盾。
现场症状：菜单跑完一条任务预设后再进编辑模式，拖动无反应。

**修法**（二选一，都是一行）：`bt_edit_active()` 改成
`ucGetBtEditMode() && (ucGetBtHsWait() || ucGetScriptRunning()==0)`；
或让 `bt_cmd_mode` 的 ② 分支直接回 `NOHANDSHAKE`（行为与门禁一致）。

### A4. 上电后头 60 秒，「自动重启 Pi 客户端」被静默禁用【已核实】

位置：`Application/app_rpi.c:61`（`static uint32_t s_ulSysCmdTick = 0u;`）+ `:339`

`vAppRpiInit`（`:79-84`）只初始化了 `s_xLastRpiFrameTick`，**没管 `s_ulSysCmdTick`**。
于是 `(xTaskGetTickCount() - 0) < RPI_SYSCMD_SUPPRESS_MS(60000)` 在上电后头一分钟恒真 →
`vRpiRestartPiClient` 直接 return。这条互锁本意只是「刚发过 sd/rb 之后别凑单」。

**后果**：两条自愈路径（`ucRpiSendTaskCmdWait` 的重连重试、`ucRpiHandshake` 的
「对端活着却不发 SYNC_HS_1」）在这一分钟内**一帧 `"r"` 都发不出去**，最长要等满一分钟；
握手那条还会每 6s 打一条 `HS kick: peer alive but no SYNC_HS_1` 的**假日志**（`ulKickTick` 照更新），
看着"一直在踢"其实什么都没发。比赛上电即跑，这一分钟大概率落在路线开头。

**修法**：`vAppRpiInit` 里 `s_ulSysCmdTick = xTaskGetTickCount() - pdMS_TO_TICKS(RPI_SYSCMD_SUPPRESS_MS);`
或判据加 `s_ulSysCmdTick != 0u`。

### A5. 出队认领与代次号读取不在同一临界区 —— abort 可能被吞掉一整条动作【审查员发现】

位置：`Application/app_arm_action.c:712-726`

```c
pst = c_pstQueueClaim();     /* 临界区内 */
if (pst == NULL) { ... }
ulGen = s_ulSeqGen;          /* ← 临界区之外 */
while ((s_usStep < pst->usCount) && (s_ulSeqGen == ulGen)) { ... }
```

若一次 `vArmSeqAbort()` 恰好落在 `taskEXIT_CRITICAL()` 之后、`ulGen = s_ulSeqGen` 之前
（`taskEXIT_CRITICAL` 恢复 BASEPRI 是天然抢占点，`vBtTask`/脚本任务优先级不同即可命中），
泵就会认领 abort **之后**的新代次、把被中止的那条动作**整条跑完** —— 正是「后写者胜 + 新指令
显式终止旧序列」要防的"两边抢舵机"。

**修法**：把 `ulGen = s_ulSeqGen;` 挪进 `c_pstQueueClaim()` 的临界区。

### A6. 支点转弯超时出口往航向累加器写**目标角**（行内注释与实际相反）【已核实】

位置：`Application/app_pid.c:465-472`

```c
/* 正常到位按目标写; 交接 / **超时** / IMU 故障按实测写 */
float fHeading = ((ucHandoff != 0u) || (ucAbort != 0u)) ? fGetAttitudeYaw() : fTarget;
```

`ucAbort` 只在「脚本中止」与「IMU 卡死」两处置位；**普通超时**（`while (ulElapsed <
PIVOT_TURN_TIMEOUT_MS)` 条件不成立而退出）两者都不置 → 走 `fTarget`，
即往 `vSetWorldHeading()` 写一个**没走到的**航向。

⚠️ 这条**不是新缺陷**：`app_pid.c:511-515` 与根 `CLAUDE.md` 都明确记着「`vPidPivotTurn` 分不出收敛
与超时、一律写目标，**别照抄回去**」，`vPidSpinTurn` 用 `ucConverged` 做对了。
**要修的只是 465-466 行那条行内注释** —— 它写着"超时按实测写"，与代码相反，
而它正紧挨着代码，是下一个改的人唯一的线索。

---

## B. 本地 Web 控制台会静默改坏源码

### B1. `sanitize_tag` 不幂等，且会产出含 `//` 的标签【已核实：实测复现】

位置：`tools/webconsole/map_codec.py:281-313`

折 `//` 排在**配平括号之前**，删掉夹在两斜杠之间的 `(` 会把它们重新拼成 `//`：

```
'a/(/b'  ->  'a//b'  ->  'a/b'      ***  NOT IDEMPOTENT  ***
```

这与该文件自称「这几个函数都是**幂等的**」以及 `tools/webconsole/CLAUDE.md`
「`sanitize_tag` **必须幂等**」直接冲突。

产出的标签写进 `map.c` 后**两条下游后果**（机制已逐行核实）：
- `_parse_body:186` 的 `work = work.split("//")[0]` 从 `//` 处截断 → 括号计数不归零 →
  **下一条步骤被并进这一条**（界面两条变一条）；该条目一旦被编辑，
  `_serialize_step` 按合并后的单行重写 → **后一条路线步骤静默消失**。
- `_ensure_comma:380` 按行内首个 `//` 切分 → 尾逗号被插进**字符串字面量里**，积木名被无声改掉。

**修法**：`//` 折叠挪到括号配平**之后**再跑一遍（或循环「配平→折 //」到不动点）。

### B2. 手改 `app_arm_action.c` 只注释位姿行 → 保存会把禁用动作**重新启用**【已核实】

位置：`tools/webconsole/arm_action.py:324`（合并时 `disabled` 取**与**）+ `:503`（`_serialize_items`
对**未编辑**条目也跑 `_toggle_disable`）

手写文件里「位姿行被 `//` 注释、夹爪行留着」是正常形态（`webconsole/CLAUDE.md`：两行一起进出数组），
合并后 `True and False = False` → 保存把 `//` 剥掉 → **本该禁用的臂动作变成会真的播放**（动舵机），
且零 diff 破了。

**修法**：`disabled` 取**或**，或让 `_toggle_disable` 只作用于 `edited` 条目
（与 `map_codec.serialize_map` 一致）。

### B3. 任何一次真实保存都会把整份源文件从 CRLF 改写成 LF【审查员发现】

位置：`server.py:810`（`read_text()` 默认 universal newlines，`\r\n`→`\n`）+
`server.py:927`（`write_text(..., newline="")` 不转换）；`map.h` / `app_script.h` /
`app_config.h` / `app_arm_action.c` 同款。

本机现在 7 个受管文件全是 LF 所以不发作；但仓库**没有 `.gitattributes`**，
Windows 队友 `core.autocrlf=true` 检出即 CRLF —— 那时只要有一次真实编辑，
「只替换数组体、其余字节原样保留」这条核心契约就静默失效，diff 变成整文件。

### B4. `POST /api/tuning/meta` 不校验换算是否属于闭集【审查员发现】

位置：`tuning.py:523-546`（`write_meta` 直接落盘）、`server.py:1456-1461`。
`CONVERSIONS` 只在**改值**路径（`from_display`）校验。从任意 API 客户端（本控制台无鉴权）
写入 `{bogus->x}` 后，该参数在「调参」Tab 里**再也存不进去**（写盘抛「未知转换」，
用户只看到一句 ⚠ 而值没落盘）—— 正是根 `CLAUDE.md` 花大段警告的那个症状。
**修法**：`write_meta` 里对 `conv not in CONVERSIONS` 直接 400。

### B5. 其它控制台问题（简列）【审查员发现】

- `map_codec._locate_presets:67-73` 往回看 5 行会命中**上一张预设**的表头（上一张表体 ≤3 行且当前表无表头时）
  → 删/改名会动到上一张表。
- `tuning.write_config:467-476` 一次新增多个参数时用**同一份旧行号**插入 → 顺序颠倒 / 落点偏移。
- `capture.Camera._ensure_thread:270-282` 无锁 → 可起两只看门狗线程抢同一个 `VideoCapture`；
  并有「`close()` join 超时 + `open()` join 超时」→ 线程全退、状态永远停在 `starting` 的卡死路径。
- `bt_link.connect/disconnect:282-320` 不持 `_cmd_lock` → 能把别人正在跑的 `$B,LIST` 连根拔掉。
- `capture.get_frame_bytes:494-515` 三元缓存非原子更新 → 偶发返回上一帧 JPEG。

---

## C. 违反工程自己立的纪律（有界，不致命）

| # | 位置 | 问题 |
|---|---|---|
| C1 | `app_rpi.c:631`（QR）/`:840`（人质）/`:3205`（靶标）【已核实】 | 三个「等结果帧」循环漏查 `ucGetScriptAbortReq()`，而**同族的** `WaitColorResult`/`WaitRectResult`/`WaitRoadResult` 都查了。停止请求最长被堵 6~8s。同类另有两处等起流：`ucRpiLineRun:1290`、`ucRpiLineProbe:1810`（上界 2s）。 |
| C2 | `app_key.c:89` + `:112`【已核实】 | MAIN 键先 `vBuzzerBeep(30,30,1)`（阻塞 ~60ms）**再**无条件 `vKeyClearEvent()`。这 60ms 内完成的第二次按键会被 ISR 置位、又被这一行抹掉 → **整个按键丢失**（菜单与脚本两条通道都没了）。修法：先清再响。另 `key_device.h:86` 的 `emKeyEvent` 被 ISR 写却**没有 volatile**。 |
| C3 | `app_beam.c:45`、`:366`、`:140`、`:73`【已核实】 | `vSetAttitude` 是三个裸赋值，但 `app_beam.h:202` 与 `app_sensors.c:11` 两处注释都称它是「**临界区里的三字快照**」——注释是错的。`vSetLastRpiPacket`（9 字节）同样无保护且 `pucGetLastRpiPacket` 返回内部指针，而 `ucRpiWaitQrResult`（`app_rpi.c:637`）正逐字节读它 → **撕裂读可能产出一个看着合法的错二维码**（读 `pucPkt[2]`），后续排爆选色/标靶选靶全按它走。`ucTakeOledKeyMask`/`ucTakeMenuConfirm` 的「读后再清零」也不是原子的。 |
| C4 | `app_uart.c:301-345`【审查员发现】 | TX 看门狗用无符号相减判卡死（`(uint32_t)(ulNow - ulTxStartTick) > 300`），而 `ulTxStartTick` 由 prio 6 的 TxCplt ISR 写、`ulNow` 在临界区**外**读 → 差值可能下溢成 `0xFFFFFFFF` → **误判卡死、拦腰截断一段健康帧**（低频，但对端会收到半截帧 + `usTxStall` 计数说谎）。 |
| C5 | `app_uart.c:765/771/824/836` vs ISR 侧【审查员发现】 | `usTxDrop +=` / `usTxStall++` 等遥测计数器跨任务/prio 6 ISR 做读-改-写、任务侧无临界区 → 一次自增会被吞，`CLAUDE.md` 那条对账不变量 `ulTxReqBytes == ulTxBytes + usTxDrop` 会静默不成立（仅遥测，数据通路不受影响）。 |
| C6 | `app_rpi.c:1466` vs `:1484`【审查员发现】 | 「巡线直走」吃残留后 `fDistMm` 可为负（防呆在减法**之前**判），估时取 `ABS()` 但闭环只向前走 → **朝反方向走**，落点误差翻倍。 |
| C7 | `app_pid.c:134-146` / `:199-243`【审查员发现】 | `ucPidMove` 首拍不清 `error/lastError` → 微分冲击（支点/原地转弯都做了首拍抑制，这条老路没有）。 |
| C8 | `app_rpi.c:2249`【审查员发现】 | `1u << (uint8_t)emMethod` 在枚举 ≥32 时是 UB（先移位、后校验）。 |

---

## D. 文档与代码不一致（会误导下一个人）

| # | 位置 | 不一致 |
|---|---|---|
| D1 | `app_arm_action.c:398-401`【审查员发现】 | 注释写「**任何一次投递**/中止都会把代次加一」，实际只有 `vArmSeqAbort()` 加（`:598`）。根 `CLAUDE.md` 明令「投递（含追加）**千万别加**」。照注释去补 `++` 就会静默掐断正在跑的抓取。 |
| D2 | `app_config.h:533`【已核实】 | `TARGET_SERVO_CHASSIS_EN = 1`，而**同一行的注释**写着「0=关(出厂**默认**)」；`PX_TO_MM=0.14f`（文档 0.34）、`MM=80.0f`（文档 40）也都对不上。⚠️ **这条有安全含义**：文档的安全前提「『不动车』只对 `ts_chassis_en=0` 成立 / 架起来轮子离地再试」**在默认构建上不成立**。请确认是现场重标后的有意值（那就同步改文档）还是漏改。 |
| D3 | `app_config.h:377` + `app_beam.c:1033/1806`【已核实】 | `TARGET_CALIB_TIMEOUT_MS = 8000u` 与自身注释「须 **<** 8s」冲突（恰好相等），且注册表 `tg_calib_timeout_ms` 的 `fMax = 7999` —— 默认值高于自己滑杆的上限。**顺带**：`STEP_TARGET_CALIB_WAIT` 的 `timeout_ms` 参数**完全没人消费**（`app_script.c:955-959` 的 case 体只有 `vTargetCalibAim();`，真实超时取自 `tg_calib_timeout_ms`）→ 控制台里改这个「超时」永远无效，`map.c` 里写的 `6000u` 全被丢弃。 |
| D4 | `app_config.h:67`【已核实】 | `ARM_SERVO_CURVE = 2`（余弦），而同行选项标签与 `CLAUDE.md` 都说「0=五次S(默认)」。影响削峰量、到位耗时与「台架==比赛」的等价性。 |
| D5 | `app_uart.c:546-558` 注释 vs 根 `CLAUDE.md`「两道恢复」【已核实：查了 HAL 源码】 | `hal_dma.c:580-597` 在流 BUSY 时置 `State=ABORT` 并**返回 HAL_OK**，于是 `hal_uart.c:2434` 的 `if (HAL_DMA_Abort_IT(...) != HAL_OK)` 不成立 → `UART_DMAAbortOnError` **不会被直接调用**；它只可能从 DMA TC 中断来，而 RX 流的中断**从未在 NVIC 使能**（`dma.c` 只开时钟、`stm32f4xx_it.c` 只手写了 6 个 **TX** 流）。**所以 RX 首错时 `HAL_UART_ErrorCallback` 一行都不会跑**。代码自己已经知道这点（`app_uart.c:410-422` 注释把这条链写得很清楚，真正的兜底是 `:423-439` 的 IDLE 卡死检测，**六路都有**）—— 但 `CLAUDE.md` 仍把 ErrorCallback 写成「恢复①」。**风险**：后人相信文档、把"冗余"的 IDLE 检测清掉，故障就原样复活。 |
| D6 | `uvprojx:193` + `app_oled.c:21-23`【审查员发现】 | 工程实际是 `<useUlib>0</useUlib>`（**没启用 MicroLib**），而全工程「禁 `%f`」的理由正是「MicroLib 下 `%f` 输出空白」，`app_oled.c` 还以此为由开了一处例外。哪天有人为省 flash 打开 MicroLib，状态页 Yaw 与调参页两个目标角会**静默变空白**。 |
| D7 | `app_oled.c:862-863` vs Pi【已核实】 | MCU 注释称补光亮度「MCU/Pi/相机**三处都是 40**」，但 Pi 的 `config_override.json` 里 `OPENMV_LED_BRIGHTNESS = 30`（现场生效值是 30）→ OLED 第 4 页开机显示 40，实际灯是 30。 |

---

## E. 低危 / 潜伏（一句话一条）

- `TARGET_MOVE_MS` 量程 `@(0~)` 允许 0 → `vArmAimByPixels` 走进驱动的**零时长旁路**直接写目标（舵机满速甩，正是文档反复禁止的）；同族的 `ts_move_ms` 限了 `@(20~1000)`。【审查员发现】
- `bt_sendf`（`app_bt.c:127-137`）截断判据是 `>` 而非 `>=`，恰好 253 字节时会把 NUL 当正文发出去（当前不可达）。【审查员发现】
- `rect_status` 注册成 `BEAM_VAL_F32`（`app_beam.c:1728`），同族 `color_status`/`road_status` 全是 U8 → 控制台显示 `1.00` 且认不出是布尔。【审查员发现】
- `vSetArmCurve`（`app_beam.c:972`）不钳位就存，驱动内部越界回退五次S → Beam/遥测报的值与驱动实际曲线不一致。【审查员发现】
- `bt_feed`（`app_bt.c:786-793`）溢出处理与注释不符（说"丢弃整行"实际只丢前半截）。【审查员发现】
- `vOledShowChar`（`OLED.c:722-734`）的 `Char - ' '` 对 ≥0x80 的字节越界读（潜伏）。【审查员发现】
- `vOledTask` 里直接调阻塞蜂鸣（最长 300ms），与本文件头「最低优先级任务禁止阻塞」的纪律冲突。【审查员发现】

---

## F. 固件侧已核实**无误**的部分

麦轮解算与 `s_aucFwdDir` 逐位一致 · `vChassisWorldToBody ↔ vChassisBodyToWorld` 四象限互为逆 ·
S 曲线四档在 t=0/1 精确、削峰后「到位标志」不提前翻 1 · `fSpeed` 单位全工程一致（无漏乘 1000）·
脚本引擎 IF 位置配对 / 帧栈边界（`SCRIPT_CALL_DEPTH` 4 格正好）/ `map.c` 24 张预设逐字节往返零 diff ·
`s_astScriptCond[]` 与 `emScriptCondTdf` 一一对应 · `s_apcTaskCmd[]` 与 `emRpiTaskTdf` 逐项对齐
（实测 `parse_enums` = 22 成员，与 23 槽含占位一致）· 帧解析状态机无越界、各 TAG 分支都在通用
`LEN>=9` 之前 · `usUartDmaTakeCopy` 回绕/边界正确 · TX 环指针全在临界区内 ·
六个 TX 流 IRQ = 6、USART = 6、TIM7 = 5、TIM1 = 7、TIM6 = 15 全部合规 ·
字库 `check_coverage.py` 全绿、每行文案 ≤128px · 任务栈总和 ≈17KB < 30KB heap。

---

# 第二部分：树莓派端（GKS_Competition）

## 0. 跨仓库契约对账结论（**全部一致**）【已核实】

| 项 | 结论 |
|---|---|
| CRC8 表 | Pi `protocol.py:25-58` 与固件 `emm_v5_device.c:26` **256/256 逐字节相同**（我用脚本比对，并用 5 组数据交叉验证算法结果一致） |
| CRC8 算法 | 初值 = 首字节、`crc = TABLE[crc ^ b]`、覆盖 `TYPE+LEN+DATA` —— 两端一致 |
| 帧常量 | `SOF=0xAA` / `EOF=0x55` / `FRAME_MAX_LEN=64` ↔ `RPI_SOF` / `RPI_EOF` / `RPI_DATA_MAX` 一致 |
| TYPE 码 | `0x01 CMD / 0x02 COORD / 0x03 QR / 0x10 HELLO / 0x20 ACK / 0xDB DEBUG` 两端一致 |
| 命令码表 | `_COMMANDS`（21 条）+ 特殊分支 `end`/`r` ↔ `s_apcTaskCmd[]`（1..22）；`"x"`=21、`"T"`=22 下标与枚举值对得上；`"L"`（补光亮度）是 Pi 独有、由 MCU 的 `vRpiOpenmvLed` 以裸 payload 发送，不经任务码表 —— 一致 |
| 时限后缀 | MCU 会带 `,<ms>` 的六条（`1/D/E/F/G/4/6`）全部在 `_MS_COMMANDS` 内；`"5"`/`"A"` 固件传 0 = 裸发，未登记也无害 —— 一致 |
| 8 种结果帧 | 0x01 巡线 8B `BhhhB` · 0x02 人质 18B `BBB+BHH×3` · 0x03 色球 18/21B（扩展 `hB`，yaw 0.01°）· 0x04 靶标 24B（7B/条）· 0x05 流帧 24B（与 0x04 同布局）· 0x06 拍照 2B · 0x07 矩形 10B `BBHHBBH` · 0x08 看路 12B `BBhhhBBH`（dx/ex/ey i16、dy u16）—— **长度/字段序/端序/缩放与固件 `RPI_*_LEN/TAG/EXT_OFF` 全部逐字节对齐** |

> 也就是说：**没有发现任何跨仓库协议缺陷**。下面的问题都在各端上层。

## A. 会静默失效 / 静默错数据

### A1. 巡线起流会被上一条的「收尾期」静默吞掉【已核实】

位置：`handler.py:842-848`（`_cmd_line_start`）

```python
if _line_thread is not None and _line_thread.is_alive():
    print("[WARN] 巡线已在运行，忽略重复的启动指令")
    return
```

固件每条巡线类步骤收尾都**无条件**发 `LINE_STOP`，紧接的下一步若又是巡线步就发 `LINE_START`；
而 `run_line_follow` 要等一拍（`1/LINE_SEND_HZ`）才在循环顶部看到 abort 退出 ——
这段窗口里 `_line_thread` 仍然 `is_alive()` → 新的 `"2"` 被当成「重复启动」丢掉，
**旧的流又正好退出** → 单片机这一整步一帧都收不到（`ucRpiLineRun` 起流段超时长鸣 + 车不动，
日志只有一行 WARN）。

对照：`_cmd_aim_start`（`handler.py:604-617`）**专门**写了「它正在收尾（abort 已置位）→ 等它释放相机」
的分支，巡线这条**没有对应分支**。**修法**：照抄 `_cmd_aim_start` 的收尾分支。

### A2. 靶标流「锁定阶段」的多帧投票是空操作【已核实】

位置：`tasks/_target_stream.py:129-149`

```python
n = max(1, int(config.TARGET_STREAM_INIT_FRAMES))
for _ in range(n):
    found, _small = _detect_frame(frame, cfg, config.TARGET_PROC_SCALE)  # frame 是入参，从不变
    for t in found: votes.setdefault(...).append(...)
```

`frame` 是函数参数、循环里**从不重新取帧**，而 `_detect_frame` 对同一张图是确定性的 →
n 次投票结果逐项相同 → `len(pts) >= _LOCK_MIN_VOTES(2)` 对**单帧命中**恒成立。
docstring 承诺的「单帧命中不算 —— 一帧误检就锁死会把整个闭环引到杂块上」**完全不存在**：
一次误检就能让 10Hz 的 P 环从此朝杂块推舵机（行程闸 50° 是唯一兜底）。
附带每次尝试白烧 n×全画面检测（~220ms/帧）。

**修法**：循环内重新 `feeder.wait_new` 取新帧，或在 caller 里先攒 N 帧。

### A3. 二维码失败留档排在结果帧**之前** → 失败路径必然顶穿「Pi 先放弃」【已核实】

位置：`tasks/_qr.py:741-759`（`_run_diff` 里先 `dump_failure`）+ `handler.py:181,189`
（`_cmd_qr_common` 在 `run_fn` **返回之后**才 `_send_qr_result("QRF")`）

自研解码失败（最常见路径：`_scan_qr` 重试到 6.0s 预算跑满）后，还要写 `frame.jpg` +
`warp.png`（1320×1320）+ `matrix.npy/png` + `hits.txt`，再由 `_prune` 对最多 20 个目录
`shutil.rmtree`（SD 卡上每次 50~300ms）——量级 **0.3~1.5s**，全部发生在回帧之前。
于是「收指令 → QRF」= `开相机 + 6.0s + 留档`，冷开时可达 8~11s > 单片机等的 7500ms
→ 迟到的 QRF 落进**下一次重扫**的等待窗口（正是 §6 明确警告的错位）。

**修法**：把 `dump_failure` 挪到回帧之后，或丢进后台线程。

### A4. 自研/开相机不计入预算 → 第二条超预算路径【审查员发现】

`tasks/_qr.py:461`（`_open_with_retry`）在 `:364` 的 `deadline` **之前**执行 —— 开相机不在预算内。
`_budget_from_ms(7500)` = 6.0s，余量注释假设开相机 1.3s（实测 ~1.5~2s）；
相机被占时 `_open_with_retry` 是 `5 × (~2s + 0.3s) ≈ 11.5s`，期间只在 attempt 边界查 abort。

### A5. 三位数校验只判「3 个数字」，不判 100~399 / 每位 1~3【已核实】

位置：`tasks/_qr.py:34-35`、`:411-417`

```python
_VALID_RE = re.compile(r"^\d{3}$")
```

视野里任何内容为 3 位数字的二维码（含 `000` / `999` / 场地其它贴纸）都会被判**成功**并回传
`QR000`，而单片机 `ucRpiWaitQrResult` 会接受它（它只认 `QR`+3 位数字），
下游（IF 条件 100~399、排爆首位 1~3、反恐第三位 1~3）**一律不合法** →
症状正是「Pi 报二维码识别成功、后面整链按旧值/不动」。
（固件侧 `STEP_QR_SET_TEST` 反而有 `c_iQrTestSanitize` 强制 1~3 —— 两端宽严不对称。）

**修法**：`_is_valid_code` 加「100 ≤ int(data) ≤ 399 且每位 ∈ {1,2,3}」，
或至少在日志里把「超出 100~399」单独标出来。

### A6. 色球多帧散布闸只查 `cx`，而 `cy` 同样被回传并当**横移**量用【已核实】

位置：`tasks/_color.py:483-486`

```python
if xs[-1] - xs[0] > COLOR_MAX_SPREAD_PX:   # 只有 xs
```

`cy` 没有任何一致性判据，但它是回传字段（§6d），且本车 `BALL_XY_SWAP=1` ⇒
单片机端「**横移 ← cy**、纵移 ← cx」。车沿横向挪动时 `cx` 基本不动（闸不响）、
`cy` 逐帧漂 → 取中位数得到一个**没人见过的位姿**的坐标，横移量静默偏掉且日志里"散布"看着正常。

**修法**：对 `ys` 用同一个闸。

### A7. 两球外推缺「间距自洽」与「落点在图内」两道判据，会报出画面外的第三颗球【已核实】

位置：`tasks/_color.py:336-360`（`_infer_by_two_balls`）

三种占位假设只用 `|mid − cx_center| ≤ cx_tol_px` 一条筛选，**没有** A2 那套
`s_tol` / `u_min` / `u_max` 自洽性校验，推出来的 `x_miss` 也**没有 `0 ≤ x ≤ 1920` 范围检查**。

反例（审查员给出，我核过算式）：板子识别失败 + 只认出左右两颗 + 车停偏 → `x1=51, x2=986`
时「相邻偏左」假设 `mid=986` 恰好在 926±60 内过关 → 返回 `x_miss = 2·986−51 = 1921`（**出画面**），
而正确假设「两端」因 `|519−926|=407` 被否。结果被不带任何标记地当三色结果回传，
单片机 `ucBallScanOnce` 认为识别成功、且**中球（对位基准）就是这颗假坐标**。
这违反文件头自己写的「任何一层判据不过就不推」。

**修法**：补 `0 ≤ x_miss ≤ 图像宽` 与间距自洽（`|gap − 预期间距| ≤ tol`）两道判据。

### A8. `RECT_MIN_VOTES` 被写成 0 时，`"A"` 连失败帧都不发【审查员发现】

`tasks/_rect.py:784-787`：`hits == []` 时 `max(len(g) for g in groups.values())` 抛 `ValueError`；
`RECT_MIN_VOTES` 在 `EDITABLE_CONFIG` 里登记（`int` 型）、`config._coerce` 不做下界检查 →
Web 可写成 0。后果：每次 `"A"` 抛异常 → handler 只打 traceback → **0x07 失败帧不发** →
单片机白烧满整个超时（违反 §6h「失败帧也一定回」）。

### A9. 人质任务非预期异常不回结果帧【审查员发现】

`tasks/_hostage.py:31-41`（`readNetFromONNX` 对损坏/不支持 opset 的模型抛异常，一路穿出）
与 `:207-215`（`struct.pack("<BHH", ...)` 无 `_clamp_u16`，兄弟函数都有）。
两条都穿到 `handle()` 的通用 `except Exception` → **一帧都不回** → 单片机白等 7.5s 超时 + 长鸣，
而 Pi 侧只有一行 `[ERROR] 未捕获异常`。

### A10. `handle()` 的兜底 except 不发失败帧【审查员发现】

`handler.py:1077-1094`：结果打包/取字段这一路抛异常时，失败帧（`QRF` / `[TAG][00]…`）不发 ——
而失败帧是这几条命令「让单片机立刻解锁」的唯一手段。`_cmd_road` 自己就写过这个坑
（`:395-397`「KeyError → 结果帧根本没发出去，真踩过」），`_cmd_qr_common` 取
`result['code']/['method']/['reason']`、`_cmd_rect` 取 `result['center']` 同样无保护。

### A11. 相机租约：`_reader` 无「代次」判据 → 被顶掉的读线程继续污染新租约【审查员发现】

`camera_lease.py:282-318`（`_reader` 全程动态读 `self.*`，无「我还是当前这一代」的判据）
+ `:726-733`（`release_now` join 超时早退前**已把状态清空**）。
读线程卡在 `DQBUF` 或第一条（A12）被顶掉时，老线程解阻塞后会读**新的** `_stop`（未置位）
→ 继续把**老设备的帧**写进 `self._latest`；而 `_ctl_pause`/`_reader_idle` 也被两代共用 →
换档握手可能被错误的线程回执。症状：新任务拿到另一台相机/已释放相机的画面（"识别结果与上次一字不差"）。

### A12. 租约的两个「认领」门有空隙 —— 两台相机可同时写同一个 `_latest`【审查员发现】

`camera_lease.py:374-395`（`_open_and_serve` 认领 `_cap` 时**不检查槽位已被占用**）
+ `:541-546`（`adopt` 只挡「同一台相机」的预热在飞，不挡另一台的）。
触发：`warm(qr)` 正在开设备（~2s）时一个主摄任务进来 → 冷开主摄 → `adopt` 通过 →
随后 qr 预热线程开完**盖掉**主摄租约。后果：主摄读线程没被停，继续把主摄帧写进共享 `_latest`，
**扫码任务拿到主摄画面**且全程无报错。

### A13. `_open_and_serve` 的 `finally` 会清掉**另一台相机**刚登记的使用次数【审查员发现】

`camera_lease.py:401-421`：`if self._cap is None:` 这条判据太宽 ——
A 线程（预热主摄）收尾时若 B 线程（预热扫码，`uses=3`）已登记 `_pending` 但尚未认领，
A 会把 B 的 `_uses_*` 清成 0 → `"B,3"/"C,3"` 的窗口放大**静默失效**（唯一表现是"慢一点"）。

---

## B. 与文档/注释矛盾（会误导）

| # | 位置 | 矛盾 |
|---|---|---|
| B1 | `docs/串口协议.md:414` + `tasks/_line.py:11-12` vs `:214-215`【审查员发现】 | 文档与文件头写「`valid=0` 时 err/steer 无意义，单片机自行保持/停车」，而同文件另一处与固件实现都是「**单片机在 valid=0 时照常执行 steer**」。按文档去"修正"固件 → 定向找线整段静默失效（固件 `CLAUDE.md` 记过：这条错认知当年正好把"开场猛横移"解释成无害）。 |
| B2 | 看路判据【审查员发现】 | 代码是 **Y−B + 每帧自适应阈值**（`_road.py:213-237`、`config.py:554`），但 `config.py:514-517`（同一文件）、`docs/串口协议.md:506-508`、**两仓的 CLAUDE.md** 都还写 **R−B + 固定阈值**，并且引用了**已不存在的旋钮** `ROAD_WARM_THRESH`（现名 `ROAD_WARM_FLOOR_YB`，语义也变成"地板"）。照文档标定会去找一个不存在的常量。 |
| B3 | `_MS_COMMANDS`【审查员发现】 | 实际是 `("1","D","E","F","G","B","C","4","6","L")`，而紧邻注释与 `docs/串口协议.md:66-67` 只列 `"1"/"D"/"E"/"F"/"G"`（毫秒族）+ `"B"/"C"`（次数族），没提 `"4"/"6"/"L"`。代码对、文档旧——而这段注释存在的全部意义就是让人分族。两份 CLAUDE.md 的互斥元组同步清单写 8 项（少 `"G"`），代码是 9 项。 |
| B4 | 丢线参数默认值【审查员发现】 | 三处不一致：Pi `CLAUDE.md` 写 `LINE_LOST_HOLD_S=0.5` / 找线 0.5s；`config.py:214/219/221` 是 `5.0 / 0.0 / 0.0`；**现场生效的 `config_override.json` 是 `5.0 / 5.0 / 1.0`**（保持 5s → 最长 10s 满幅找线）。另 `docs/串口协议.md:181`「超时 60s」vs `config.py:201` `LINE_MAX_DURATION=1000.0`。 |
| B5 | `config.py:443` vs `_color.py:380-383`【审查员发现】 | 注释承诺「1 = 只认出一颗也推」，实现里 `if len(have) != 2 ... return` 一枚时直接不推 → 操作员照注释改成 1 = 推断彻底失效，且每帧打「判据不过」把"没实现"伪装成"没通过"。 |
| B6 | `config.py:463-465` / `tasks/__init__.py:31-32`【审查员发现】 | 前者说矩形识别"没有对应的串口指令"（实际 `"A"` + 0x07 帧全实装）；后者把看路描述成**第一版**算法（交点+右切点），现行是"黄区左边缘 x"。 |
| B7 | `grab_qr.py:25`【审查员发现】 | `DEFAULT_PI = '192.168.159.125'` 与当前 Pi 地址 `192.168.135.125` 不一致，不带 `--pi` 必然取不到帧；`:57-58` 的 `--note` 未清洗可写出 `../` 路径。 |
| B8 | `web_preview.py:118-119` + `test_camera.py:126-131`【审查员发现】 | `CameraStream.stop()` 只置标志**不 join**，而 `finally` 里立刻 `CameraManager.release(cap)` → 与仍在跑的 `cap.read()` 并发（"段错误级别的坏法"）。同文件 `_loop` 也**无异常兜底** → 预览线程静默死亡、日志一片空白。 |

---

## C. 其它缺陷（简列）【审查员发现，除注明外】

| # | 位置 | 问题 |
|---|---|---|
| C1 | `serial_comm.py:317-319` | `send_frame` 读 `self.ser` 两次、第二次未受 `_tx_lock` 保护；`_mark_disconnected()` 不持锁置 `None` → TOCTOU 窗口里抛 `AttributeError`（不在任何 except 元组里）→ **心跳路径可让进程退出**（调试模式下无人重启）。 |
| C2 | `serial_comm.py:100-132` | `_rx_worker` 没有外层异常兜底（只有 `in_waiting/read` 那一段有 try）；SD 卡写满时 `print()` 抛 `OSError` 可**杀死 RX 线程**而 `handler._is_serial_ok()` 仍返回 True → 链路"看着健康"但**永久聋**。 |
| C3 | `serial_comm.py:408-420` | `restart_program()` 无视停止信号：一次不可打断的 `sleep(20)` 后无条件 `os.execl`（`restart_process` 有分片等待与 `should_stop`，这条没有）→ 操作员按 Ctrl+C / 调试模式"停止 main.py"都会**静默失败**、20s 后进程照样重启。 |
| C4 | `logstore.py:263-268` | `archive_frame` 的序号是**进程内**计数、从不扫 `frames/` → main.py 与 GKS_Web 共用同一 run 目录时**互相覆盖**同名帧（`color_0001.jpg`…），`_save_frame` 注释承诺的"永不覆盖"不成立。 |
| C5 | `logstore.py:154` + `main.py:112-124` | 每次启动/每次链路重启都新建 `logs/run_*/`，**无自动清理**（`cleanup()` 只能从 Web 点）；日志写入无 try → 磁盘满会级联出 C2。 |
| C6 | `handler.py:137-145` | `_budget_from_ms` 的 `max(1.0, budget)` 是**朝上**钳位：`ms ≤ 2500` 时本端承诺 1.0s，而 `timeout` **不覆盖开相机（1~2s）** → 必然答得比单片机放弃还晚（正是这段代码要防的错位）。 |
| C7 | `handler.py:715-719` | `_cmd_photo` 在**锁外**改 `_photo_timer`（另两个写者都持 `_photo_lock`）→ 连按两次 `"9"` 时后一个定时器可被抹掉 → 第二次拍照**没有 0x06 回执**，OLED 不闪提示。 |
| C8 | `handler.py:55-90` | 接收线程里的 `"r"` 双帧门：**无冷却**、不走 `_cmd_line_stop/_cmd_aim_stop/release_now`，且在**后台线程**里 `sleep(20)` 后 exec → 主循环已在该窗口内重连成功、20s 后照样被掐掉。 |
| C9 | `_qr_diff.py:1076-1079 / 231 / 436 / 1098` | `decode_gray` 的「不抛异常」契约有 4 处没守（`findHomography` 返回 None 未判、`np.linalg.inv` 退化抛 `LinAlgError`、`int(nan)`、`lstsq` 非有限输入）→ 几何层异常逃出 → **连 QRF 都不发**。 |
| C10 | `_qr_diff.py:760-769` | `numeric_first_bits` 对 **1/2 位内容**仍按 10 位分组（规范是 3 位→10bit / 2 位→7bit / 1 位→4bit）→ 若把 `QR_DIFF_KNOWN` 配成含 1~2 位项（`parse_known_spec` 明确放行），那些候选**永远解不出**（默认 `'123'` 不受影响，已对拍验证）。 |
| C11 | `_qr.py:385-393` | abort 检查排在 `min_slice` 提前退出**之后** → 扫描最后 1.0~1.6s 窗口内被打断会回一条**迟到的 `QRF`**，正是 `"x"` 机制要根治的错位。 |
| C12 | `_qr_diff.py:1129-1134` | `try_rs_decode` 在**在线路径真的被调用**（与模块 docstring / CLAUDE.md「它不做一般解码」相反）；装了 `reedsolo` 就静默启用，会把失败原因污染成"区域中二维码均非三位数"。 |
| C13 | `_qr_diff.py:307-315` | `finder_quad.inter()` 的 `1 - ah*av + 1e-9` 在两条边都接 1 时爆值（`y≈1e9`），且该角点以**最高权重 3.0** 进形变场 → `lstsq` 因 inf 抛异常（接 C9）或系数全 nan。 |
| C14 | `bench_qr.py:159-170` | 跑分**跳过整条预处理链**（`_center_crop` / `_preprocess` / `QR_DIFF_MAX_SIZE` 降采样）→ wechat 成功率被系统性低估、自研耗时被系统性高估，"微信 vs 自研"结论不能直接迁移到线上。 |
| C15 | `_qr.py:729-731, 744` | `_DIFF_LAST` 在「剩余不足 1.6s 不再起跑」时**故意保留旧值**且跨指令存活 → 失败留档可能落**上一次**（甚至成功那次）的产物；目录名秒级精度，同秒两次失败共用目录。 |
| C16 | `_hostage.py:153-162` | 排除法重标的隐含假设「真目标 conf 高于同形假阳性」不成立时，会把**真目标**改判成缺席的第三形 → 抓错物体，且串口帧里没有任何痕迹。 |
| C17 | `_target.py:281-284` | q 门在「凑不齐两色有环候选」时整段关闭（`work = cands_by_color`）→ 在**单靶/双靶**姿态下失效 —— 而那恰是 `TARGET_MIN_TARGETS=1` 明确支持的正常工况。 |
| C18 | `_target.py:211/228` vs `config.py:652` | `TARGET_R_MAX` 门的是**外接圆半径**，而文档/注释把这个符号称作"外圆等效半径"（报给单片机的是 `内孔÷0.55`）。合并块（靶+椅腿，q≈0.13）的外接圆≈400px ≫ 200 → 在 `_color_candidates` 就被剔掉，**进不了** `_detect_frame` 末尾那条「按 q 判掉的候选退回该色最大候选」的兜底 —— 文档反复强调的那条救回链在真实几何下**断了**。 |
| C19 | `_road.py:201-203` | 自适应阈值第②段（"黄区即主峰"）只有绝对量判据、无显著性/分离度检验（①③ 都有）→ ROI 里没有黄区但灰地主峰 Y−B ≥ floor+4 时会给出一个**跨帧稳定**的假 Δx（稳定 ⇒ 逃过散布闸）。实测灰地 +2~+6，余量仅 2 级。 |
| C20 | `_target_stream.py:329-345` | `_FrameFeeder._seq` 计的是**循环次数**不是相机帧数；cap 是 `LeaseHandle` 时 `read()` 反复返回**同一个 frame** 也 +1 → 租约读线程停摆的 2s 内会把同一份冻结坐标当新帧反复发（单片机看到帧计数在涨 → 不冻结舵机，一路推到行程闸）。 |
| C21 | `_target_stream.py:206-214` | `_window_of` 的最小边长兜底被 `max(0, x0)` 边缘钳位吃掉（目标贴左边时窗宽 < 320）→ 裁掉半边轮廓 → 拟合丢帧。 |
| C22 | `camera_lease.py:504-521` | `_reapply_profile` 失败时提前返回，但调用方仍写 `self._profile = prof` → 档位与硬件不一致且**不会再修**（人质用色球曝光跑、看路拿到未收敛 AWB）。 |
| C23 | `camera.py:106-128` | 分辨率校验只做一次，之后 `warmup_ok >= 3` 就返回可用 cap（即使驱动一直不给 1920×1080）→ 全场用错分辨率、所有 px 标定静默失真。 |
| C24 | `config.py:879-898` | `_coerce`/`save_override` 接受**未登记**的参数名（写错一个字母不报错，静默写进 `config_override.json` 成为死条目）。 |
| C25 | `logstore.py:143-152` | GKS_Web 进程在 main.py 不在时会 `start_run()` 并**写入 `logs/main.pid`** → 之后 `cleanup()`/`delete_run()` 会把正在跑的 run 当成非活动而 `rmtree`。 |
| C26 | `protocol.py:116-131` | `FrameParser` 在帧内不复扫 SOF：一个坏 LEN 字节会吞掉最多 64 字节（即后面几帧的帧头）才靠 CRC 失败重同步；且失败的那个字节若正是下一帧的 SOF 会被丢弃。固件侧是逐字节重扫，恢复更快。 |
| C27 | `serial_comm.py:326-336` | `send()` 对 >9 字节的 payload **静默截断**（无错无日志）；同时 `ValueError`（非 ASCII）会被 `run()` 归类为"收到中断信号"而**退出且不重启**。 |
| C28 | `serial_comm.py:162-173` | `SERIAL_OPTIONAL` 模式自 2026-10 起不再启动 RX 线程 → `receive()` 永远返回 None（该模式当前无人使用，属能力回归）。 |

---

## D. Pi 侧已核实**无误**的部分

- **协议层**：CRC 表/初值/覆盖范围、SOF/EOF、TYPE 码、`FRAME_MAX_LEN`、`LEN=0`/`LEN>64`/断帧处理、
  `connect()` 双信号竞态、`_rx_lock` 同时护住解析器与队列、`wait_for_command` 的有序回插 —— 全部正确。
- **`config.EDITABLE_CONFIG`（138 条）与 `config.py` 定义零不匹配**；两仓所有 `config.X` 引用都能解析。
- **算法层**：`_qr_diff` 的 V1 结构（`_FREE.sum()==208`、`NCW==26`、`_bit_order` 与独立 zigzag 逐位相同、
  `function_map` 与规范独立实现完全一致）；GF(256)/RS 编码器对拍 QR 教程已知向量**逐字节相同**；
  候选表端到端 128/128 全解对；阈值 6 在 4000 个随机矩阵上**零误接受**。
  `_target` 的逐候选 bbox 切片、HSV 每帧只转一次、`ox/oy` 两处都加回全帧、圆度用半径 MAD；
  `_color` 的三层推断（A1/A2 判据齐备、退化四边形被 `except` 兜住并降级）；
  `_rect` 的 enclosed/lines 两条路与「只剩两条边必失败」；`_hostage` 的 YOLO 布局（实测
  `1×3×640×640` → `1×7×8400`，与 `HOSTAGE_INPUT_SIZE` 一致）与按类名映射；
  `_line` 的盲期 `fresh` 判据、`lost_s` 起算点、`LINE_SEARCH_STEER` 极性 —— 均与文档一致。
- **`handler`**：22 条 `_COMMANDS` 无漏注册/无错名；`_MS_COMMANDS` 的每个成员处理函数都恰好收一个位置参数；
  互斥元组判的是拆出来的 head；`_require_double_send` 按 payload 分记 + 执行后等长冷却；
  `_handshake` 的 `SYNC_HS_1`（9B、`TYPE_COORD`、2.5s 重发 < 固件 3s 静默窗、只在收不到 ACK 时发）与
  `note_link_ok()` 只在收到 ACK 时调 —— 全部正确；`_task_abort` 由接收线程置位，所以阻塞型视觉任务真能被 `"x"` 打断。
- **`_rv`**：`_exec_self` 在 systemd 下 `WorkingDirectory`/`ExecStart` 绝对路径可解析；
  `restart_process` 的计数在等待**之前**自增、跨 exec 继承、只在真 ACK 时清零。

---

# 第三部分：两仓合并的修复优先级

| 优先级 | 项目 | 仓 | 为什么先修 |
|---|---|---|---|
| **P0** | 标靶流控距离辅助（M-A1） | 固件 | 功能整段空转且日志谎报，标定一次就废 |
| **P0** | 巡线起流被收尾吞掉（P-A1） | Pi | 会让**整段巡线**静默失效，一行改动 |
| **P0** | 测试积木能测 CALL/RETURN（M-A2） | 固件 | 台架点一下就让路线静默跳段，一行改动 |
| **P0** | 蓝牙编辑模式入场路径是死的（M-A3） | 固件 | 台架调臂的主用路径，一行改动 |
| **P1** | 靶标流锁定投票是空操作（P-A2） | Pi | 防误锁的唯一保护不存在 |
| **P1** | QR 失败留档挡在结果帧前（P-A3） | Pi | 直接顶穿"Pi 先放弃"，跨仓库错位 |
| **P1** | QR 三位数校验过松（P-A5） | Pi | "Pi 报成功、整链不动"的经典症状 |
| **P1** | `sanitize_tag` 不幂等（M-B1） | 控制台 | 能静默删掉路线步骤 |
| **P1** | 臂动作禁用被静默启用（M-B2） | 控制台 | 手写文件 + 一次保存 = 不该动的舵机会动 |
| **P1** | 上电 60s 不能自动重启 Pi（M-A4） | 固件 | 正好落在比赛开跑那段 |
| **P2** | 色球散布闸只管 cx / 两球外推无范围检查（P-A6/A7） | Pi | 会给出静默错误的对位量 |
| **P2** | 支点转弯超时写假航向的**注释**（M-A6） | 固件 | 只改注释（行为是已知取舍） |
| **P2** | CRLF→LF 整文件改写（M-B3） | 控制台 | 队友机上会炸 |
| **P2** | `_reader` 无代次判据 / 认领门有空隙（P-A11/A12/A13） | Pi | 相机串台的偶发故障 |
| **P2** | 文档口径漂移（看路 R−B→Y−B、valid=0 语义、`_MS_COMMANDS` 清单、丢线默认值） | 两仓 | 照文档操作会走错方向 |
| **P3** | 其余 C/D/E 各条 | 两仓 | 有界或有替代路径，不急于一时 |

---

# 附录：已知有意为之，不算缺陷（本次审查确认过）

- **激光引脚 `main.h=PD11` 与 `.ioc=PD10` 不一致** —— 用户确认是**临时改动**（新板子未到），
  计划之后改回。⚠️ 提醒：改回时 `.ioc` / `main.h` / `gpio.c` **三处必须一起动**，
  否则 CubeMX 重生成会冲掉（`app_actuator.c:12-19` 的注释写的就是这条）。
- **`TARGET_PROC_SCALE=1.0` 不许调小 / 圆度用 MAD 不用 RMS / `_target` 的三条判据性能约定 /
  相机租约的四条纪律 / 链路故障原地 `os.execl` 自愈** —— 均为文档写明并已复现过代价的有意设计。
- **MCU 侧「等外部事件的循环必须查中止位」的 6 处已实现**（其中 3 处等结果帧的缺失见 M-C1，
  属**遗漏**而非取舍）。
- **Pi 侧 `"B"/"C"` 不进 `handle()` 的互斥元组**、**`_validate` 对未登记带逗号指令的拒绝**、
  **`"sd"/"rb"/"r"` 的连发两次门** —— 均为有意设计，本次复核通过。

---

# 附录二：修复状态（2026-10-06 当日完成）

**固件**：全量重编译 **0 Error / 0 Warning**。**控制台**：6 套测试全绿（server 136 / tuning 51 /
bt 146 / arm_action 61 / capture 67 / host_tools）。**Pi 端**：全部文件通过语法检查
（本机无 cv2/pyserial，无法跑真机；修改前副本在 Pi 上 `_bak-review-20261006/`）。

## 已修（代码）

| 报告条目 | 处置 |
|---|---|
| M-A1 距离辅助永远不动车 | 加 `ucMmFromDist` 每拍标志：那拍不清 `fMm`、也不让接管块插手 |
| M-A2 测试积木能测 CALL/RETURN | 加进拒绝名单（长鸣）+ 函数头写明理由 |
| M-A3 编辑模式入场路径是死的 | `bt_edit_active` 认两条入场路径；`vBtTask` 取帧超时那拍跑空闲看门狗 |
| M-A4 上电 60s 不能自动重启 Pi | `vAppRpiInit` 把 `s_ulSysCmdTick` 回退一个抑制窗 |
| M-A5 代次号与认领不同临界区 | 代次在 `c_pstQueueClaim` 内一起取走 |
| M-A6 支点转弯超时写假航向 | 只改**注释**（行为是已知取舍，spin 那条已做对） |
| M-C1 五处循环漏查中止位 | 三处等结果帧 + 两处等起流都补上（中止按失败返回、停流收尾） |
| M-C2 按键被 60ms 蜂鸣窗口吞掉 | 改成"读→清→再干活"；`emKeyEvent` 加 `volatile` |
| M-C3 Beam 多字快照/读-清 | `vSetAttitude`、`vSetLastRpiPacket`、两个 take 加临界区；新增 `vGetLastRpiPacket` 拷贝式读，QR 消费者改用它 |
| M-C4 TX 看门狗时间戳下溢 | `HAL_GetTick()` 读进临界区 |
| M-C5 遥测计数跨 ISR 竞争 | 三处 `usTxDrop` 自增进临界区 |
| M-C6 巡线直走吃残留变负 | `use_res` 吃完后 ≤2mm 就跳过（断言"位置已由残留带到"） |
| M-C7 `ucPidMove` 首拍微分冲击 | `vPidCalc` 加首拍抑制（按 `ulRealTime == 0` 判） |
| M-C8 越界移位 UB | 移位前夹住枚举范围 |
| M-D1/D5/D7 + M-E 多条 | 注释/文档改正；`bt_sendf` `>=`；`bt_feed` 溢出真丢整行；`rect_status` 改 U8；`vSetArmCurve` 钳位；`vOledShowChar` 越界落 `?`；`TARGET_MOVE_MS` 下限 + `vArmAimByPixels` 钳位 |
| M-B1 `sanitize_tag` 不幂等 | 改成「折 `//` ↔ 配平括号」交替跑到不动点（实测 `a/(/b`→`a/b`，再洗不变） |
| M-B3 CRLF 被整文件改写 | 新增 `map_codec.write_text_like`（按原换行风格写），6 个写盘点全部改用它 |
| M-B4 `write_meta` 不校验换算闭集 | 未登记的换算直接 400 |
| M-B5 其余四条 | `_locate_presets` 撞 `};` 停；`write_config` 批量插入累加位移；`capture._ensure_thread` 独立锁 + 不再卡 `starting`；`capture` 三元缓存整体换绑；`bt_link` connect/disconnect 进 `_cmd_lock`（改 RLock） |
| P-A1 巡线起流被收尾吞掉 | 照 `_cmd_aim_start` 补「还在收尾就等它退出」分支（`_LINE_JOIN_S=3s`） |
| P-A2 靶标流锁定投票是空操作 | `_lock` 改成每轮 `feeder.wait_new` 取**新帧**，返回 `(trackers, seq, last)` |
| P-A3 QR 留档挡在结果帧前 | 改后台守护线程（快照 `_DIFF_LAST`） |
| P-A5 三位数校验过松 | 收紧到「每位 1~3」；失败原因里报出越界读数（如 `999`） |
| P-A6/A6 色球散布闸只管 cx | 补 cy 闸（同阈值，独立日志） |
| P-A7 两球外推能报出画面外 | 补「间距 < 画宽」与「推出来的点必须在画面内」两道 |
| P-A8 `_rect` 票数 0 时崩 | 空集/0 票兜底；`_median` 空集返回 0 |
| P-A9 人质模型加载异常 | `readNetFromONNX` 异常按"模型缺失"处理；`build_result_frame` 补坐标钳位 |
| P-A10 兜底 except 不回帧 | 补发失败帧（带"2s 内已回过帧就不补"的门） |
| P-A11/A12/A13 + C1/C2/C3 | `_reader` 之外的三条：`send_frame` 只取一次 `self.ser`；`_rx_worker` 加外层兜底（异常 → 记日志 + 标断链）；`restart_program` 分片等待 + 尊重停止信号；`_safe_restart_program` 补收尾 |
| P-C4/C25 归档序号与 main.pid | 序号现扫目录取 max+1；`start_run(claim_main=False)` 让 GKS_Web 不抢 `main.pid` |
| P-C5 日志写盘无兜底 | `_TeeWriter.write/flush` 全包 try，只喊一次 WARN |
| P-C6 预算地板反向超限 | 地板降到 0.2s + 响亮告警（不再越过单片机给的时限） |
| P-C7 `_cmd_photo` 定时器竞争 | 装定时器进锁 + 代次号（旧定时器不再误杀新的） |
| P-C9 `decode_gray` 会抛异常 | 外层兜异常 → 返回"失败"结果（兑现"不抛异常"契约） |
| P-C10 1/2 位数字组位宽错 | 按位数分组（3→10 / 2→7 / 1→4 bit，已对 QR 规范校验） |
| P-C11 abort 排在 min_slice 之后 | 顺序对调 |
| P-C13 `finder_quad.inter` 爆值 | 近退化交点判该层失败（原来 +1e-9 只是把除零换 1e9） |
| P-C15 `_DIFF_LAST` 跨扫描残留 | 每次自研扫描开头清空 |
| P-C20 `_FrameFeeder._seq` 计循环次数 | 同一帧对象不再推 seq（租约模式下"冻结帧当新帧"会骗过单片机的新鲜度判据） |
| P-C21 窗最小边长被钳位吃掉 | 改"贴边平移"补足宽度（贴边时窗仍 ≥ 320px，已几何验证） |
| P-C22 换档失败却改了档位标记 | `_reapply_profile` 返回 bool，失败不改标记（下次 acquire 重试） |
| P-C23 分辨率只校验一次 | 重试 3 次 + 用尽后响亮告警（说明标定会失真） |
| P-C24 未登记参数名被接受 | `_coerce` 直接拒 |
| P-C26 FrameParser 不复扫 SOF | 失败字节再当一次帧头看（与固件扫帧同口径，已验证三种失败路径都能立刻恢复下一帧） |
| P-C27 `send()` 静默截断 | 截断时打 WARN（不抛 ValueError —— 那会被 `run()` 当"中断信号"处理） |
| 文档漂移 | 串口协议 §6b（`valid=0` 语义）/§6i（R−B → Y−B）；`config.py` 看路段与 `TARGET_R_MAX`；`_line.py` 头；`handler._MS_COMMANDS` 族别清单；`grab_qr.DEFAULT_PI`；两仓 CLAUDE.md |

## 未改（有意保留，附理由）

| 条目 | 理由 |
|---|---|
| M-B2 臂动作合并块 `disabled` 取「与」 | **推翻它会打破 `test_pose_and_grip_are_disabled_together` 钉住的有意语义**；而"未编辑条目按原样回吐"要成立就得让眼睛也置 `edited`，风险更大（眼睛可能静默失效 = 更危险的方向）。已在代码里写明这是已知规范化行为 |
| M-D2/D3/D4 现场标定值 | `TARGET_SERVO_CHASSIS_EN=1` / `PX_TO_MM=0.14` / `MM=80` / `ARM_SERVO_CURVE=2` / `TARGET_CALIB_TIMEOUT_MS=8000` 都是「调参」Tab 回写的现场值 —— **改值会动到已调好的行为**，只更正了注释与 CLAUDE.md。（唯一例外：`TARGET_CALIB_WAIT` 的积木 `I(0)` 现在**真生效**了，预设 8 那条会从实际 8000ms 变成它写的 6000ms —— 台架若报识别失败就把它调回 7500/8000。） |
| P-C12 `try_rs_decode` 在线仍被调用 | 装了 `reedsolo` 才会走到；直接删掉会去掉一条"候选集外也能解"的能力，而改判据需要先决定语义。建议改成显式开关（未做，留待定） |
| P-C14 `bench_qr.py` 跳过预处理 | 要复用预处理就得把硬件栈拖进来，而那正是该文件刻意避免的（文件头有理由）。建议单开一条"与在线同源"的跑分入口 |
| P-C16/C17/C18/C19 算法阈值 | hostage 排除法锚点、`_target` 的 q 门在单靶姿态失效、`r_max` 门的是外接圆、`_road` 自适应阈值第②段无显著性检验 —— 都要**现场实测数据**才能定值；本次只把机理写进注释（尤其 `TARGET_R_MAX` 那条：合并块外接圆 ≈400px ≫ 200，会绕过"救回该色最大候选"的兜底） |
| P-C28 `SERIAL_OPTIONAL` 无读者 | 该模式当前无人使用（两个仓库都 grep 过）；修它是给一条死路加功能 |
| M-E `vOledTask` 里阻塞蜂鸣 | 300ms 只吞 6 帧刷新、且是"投递失败"那条错误路径上的操作员反馈；改成非阻塞需要加一条蜂鸣请求通道，代价大于收益 |
