Qexran/GongKeCompetition/训练/md文档/对转角单帧不可分分析的反驳.md

# 对"转角弧与车歪看直边单帧不可分"分析的反驳

> 针对观点："在单帧里，转角弧与车歪了看直边不可分（判据全部失败），
> 直穿路口纯视觉无解，只能点数不够时弃权 + 排表绕开。"
> 结论先行：**该观点对一半。** img_0007 型的单帧不可分是真数学极限；
> 但"判据全部失败"是测量方法错误——全点 RMS 与两半斜差在实测中干净分离了
> 0004/0005/0006 型路口帧。且"只能排表绕开"忽略了系统里本来就有陀螺。

---

## 一、实测：把巡线管线在 7 张原图上跑一遍

模拟管线：8 列 × 13 条（12px）、b 通道、own_mid、邻域 swing、min_swing=0.5×max(spread,20)。

| 图 | 点数 | 全点RMS | 内点RMS | 两半斜差 |
|---|---|---|---|---|
| 0001 压黄区 | 2 | 0.0 | 0.0 | — |
| 0002 正常 | 8 | 3.7 | 3.7 | 7.8° |
| 0003 远边界 | 7 | 1.4 | 1.4 | 4.1° |
| **0004 路口** | 6 | **13.3** | 3.2 | **29.9°** |
| **0005 路口** | 7 | **8.6** | 3.3 | **20.3°** |
| **0006 左偏** | 6 | **9.3** | 5.7 | **22.8°** |
| **0007 右偏** | 8 | 3.1 | 3.1 | 3.9° |

（点数与原分析略有出入属正常：提取参数不同。0004/0005/0006 的曲率信号
远超直线图的噪声量级，结论对参数不敏感。）

## 二、对方说对的：img_0007 型单帧不可分是真极限

- 0007 全点 RMS 3.1、两半斜差 3.9°，与直线图完全同量级 ——
  大半径弧在测量窗内就是近似直线，单帧里"歪着看直边"与"弧的切线段"**不可分**。
- 由此推论正确：相机看到线就会贴弧走（把弧切线当航向基准）；
  单帧视觉定义不了"直穿"所需的"直"；
- "点数不够弃权"确实覆盖 0004/0006 那类部分弧（我们的实现已有：拟合需 ≥6 点）。

## 三、对方说错的：测量方法论错误

**"7 张图 RMS 全在 1.33~3.9、转角不突出"是用 RANSAC 剔完离群之后的内点 RMS 量的。**

- 内点 RMS 天然小：点正是因为残差大才被剔掉的。这等于**先藏起曲率，再宣布看不见曲率**；
- 换成**全点 RMS**：0004=13.3、0005=8.6、0006=9.3，直线图全部 ≤3.7
  —— 门槛 5.5~6 即可干净分开；
- **两半斜差**更显著：路口帧 20~30° vs 直线帧 ≤7.8°；
- 原分析只报了 img_0007（7 张里唯一真的近似直线的一张）就推广到全部，
  于是得出"判据全部失败"的过度结论。所谓"空间均匀性"判据失败可以成立，
  但"全部失败"不成立。

## 四、歪打正着：它指出了我们代码的一个真盲点

我们当前 `state=1` 曲线判据用的**恰恰是内点 RMS**（`robust_fit` 返回的 `e`
是对内点集合算的）：0004/0005 上 = 3.2/3.3，低于 `CURVE_RMS_PX=5`，
**现有代码在这些路口帧上确实不触发曲线重拟合**。

修复（一行改动）：判据换成 **全点 RMS > 6 或 两半斜差 > 12°**（数值可调），
0004/0005/0006 型帧即可被标为曲线并触发近半段重拟合 ——
近段切线比全弧平均切线更接近车下一步要走的路面。

img_0007 型维持现状：它本来就是窗内近似直线，全局拟合 = 切线，行为已经正确。

## 五、"纯视觉无解"对，但前提不成立：我们不是纯视觉

"要直穿路口，那一刻画面里除了转角没有别的参照" —— 对，但**系统里有陀螺**：

- 直穿路口的正确姿势从来不是"让视觉认出路口"，而是
  **"那一刻让视觉弃权（不纠航向），陀螺咬住世界航向直行"** ——
  `line_gyro_w=100`（纯陀螺）或定时直行段，现有巡线收敛积木已支持；
- 视觉弃权的触发可以是排表（人工），也可以是上面的曲率判据（自动）；
- img_0007 型（单帧真不可分的）还有**单帧之外的时域判据**：
  图像角在变而陀螺报车没转 = 路在弯（路边弯 vs 车自转）；
  MCU 的陀螺融合链路本就具备这两个量。

"只能靠排表绕开"低估了已有机制。

## 六、对原始问题（过减速带找回线）的影响：无

AI 自己承认"相机能看到线就一定能纠航向"。贴弧走对**找回线**不是缺陷而是正解
——弧的切线就是当下该对的基准。只有"直穿"那个任务才需要本节的陀螺兜底。

---

## 结论

| 命题 | 判定 |
|---|---|
| img_0007 型单帧不可分 | ✅ 成立（真数学极限） |
| "判据全部失败" | ❌ 不成立——内点 RMS 方法错误；全点 RMS/两半斜差可分 0004/0005/0006 |
| "0005/0007 类只能排表绕开" | ❌ 不成立——曲率判据可自动识别 0005；直穿由陀螺负责，排表只是人工触发方式之一 |
| "点数不够弃权" | ✅ 成立且已实现 |
| "贴弧走是缺陷" | ❌ 对找回线任务而言是正解 |

**待办**：把 `state=1` 判据从内点 RMS 换成全点 RMS / 两半斜差（OpenMV main.py，一行改动）。
