Qexran/GongKeCompetition/训练/OpenMV巡线训练/训练工具TrackingLineProject_1.1/labeltool/METRICS_LOG.md

# METRICS_LOG

每次算法改动追一行：日期 / 改动摘要 / off MAE / 状态判对率（口径：A~K 全任务，与
/compare 同源；`python harness/score_local.py` 复算。**第十六次起任务面扩为
A~K+U/V/T/P 共 12 任务 2403 帧**，历史行的口径仍是 A~K 1407 帧，对比时注意）。

| 日期 | 改动 | off MAE | 状态判对率 | 备注 |
|---|---|---|---|---|
| 2026-10-01 | 基线（用户改 MEAS_X (50,270) + gain10 后，第十四次训练起点） | 5.13 | 1158/1407 = 82.3% | angMAE 1.495°；角度最大单帧台阶 I 12.5° / J 17.5° / K 3.7° / A 4.3°；REACQ 死锁 A 21帧+E 27帧 |
| 2026-10-01 | （更早）再前基线：MEAS_X 改前 | 5.43 | 1110/1407 = 78.9% | K 58-112 全段假丢线（0→2×55）、I 0→3×51 |
| 2026-10-01 | **第十四次**：① _five_ok 跨度 120→90 ② 抛物线兜底 quad_fit_line(RMS≤2.0, 角度保持) ③ Δ同侧验收质量豁免 nk≥8/rms≤3.0 ④ 点票行连续门 ROW_VOTE_BAND=70 ⑤ 角度限速 ANG_RATE_MAX=5.0°/帧 | 5.12 | **1216/1407 = 86.4%** | angMAE 1.550°；角度最大台阶 I 6.6 / J 9.2 / K 5.8 / A 8.2；off 台阶 std 全任务 pred<gt；死锁 A/E 全清；A offMAE 9.42→7.66 |
| 2026-10-01 | **第十六次**：column_crossing 尾部新增「色度台阶重锚定 + 边缘强度门」（EDGE_STEP_SHARP=6.0，方向对齐门挡 LED 热点回卷），MARGIN_MIN 10→5；新任务 U/V/T/P（国赛图，视频23/24/25/27，996 帧）纳入训练面 | 3.82 | **2188/2403 = 91.1%**（A~K 子集 1268/1407 = 90.1%） | V 0→203/245、T 0→185/198（两任务原全盲）；U 84.0→95.6%、P 76.9→97.0%、J 65.3→80.8%、A 79.6→85.9%、D 87.8→94.9%；回退仅 B −3 / E −6 / I −1（I 的 3→0×29 与既有「口径差」记录同型）。off_max：A 171→10、I 112→17、P 42→9、U 51→37，全任务 ≤37。无真值体检：地图2 有效率 29→52%；**地图1 55→34%** —— 深灰段边界在暗场里台阶只有 3~5，低于强度门被整列不采（宁缺勿假；同段旧输出是钳在 off−99 的勉强有效），帧 24-25 的新增跳变是边界真扫掠非假锁 |

## 第十六次后剩余已知问题（按收益排序）

1. **V 残余 42 帧丢线（0→2×23 / 0→3×15 / 0→4×4）**：黄区离补光最远的帧，真边台阶
   6.2 恰卡在 EDGE_STEP_SHARP=6.0 门下（V#1 col63 实测）。抬门会放进渐变假线
   （5.0/4.0 档 V offMax 75~150 实测），治本 = 提高该场地补光/曝光后重录。
2. **B 3→0×4 / E 3→0×7 / I 3→0×29（已核实 = 口径差，非算法错，2026-10-01 复核）**：
   这些帧 gt=3（按车所在面标压黄）**且带真值线**，预测 valid 且 off 误差仅 2~17
   （E#13/14/91/195 实测 ≤12）—— 算法在"车压黄但边界仍可见"的帧上测得准，
   而标注口径把这种帧标丢线；旧算法在这些帧恰好测不出才"碰对"标签（E 基线
   混淆 0→3×2、I 基线 3→0×20 佐证此为存量现象）。按第十四次口径差处理：比对
   时人工剔除，不动算法。
3. 第十四次的 J 1→0×30（缓弧无分辨力）、A 雾区褶皱假有效（~5 帧）两条仍未动。

## 第十四次后剩余已知问题（第十四次原文存档）

1. **J 0→2×36**：边界在弱照度渐变里（暗区），逐列穿越锁到 LED 光边而非真边界 →
   拟合失败丢线。方向 = 第十三次记录的「按列照度包络归一化」，需另立一次改动。
   （第十六次后 J 0→2 残余见新表；本条的原机制描述仍有效。）
2. **J 1→0×30**：8 列采样对缓弧无分辨力（gt1 帧 RMS 1.1~4.4 与 gt0 最大 4.85 重合；
   近段-全局角差同样重合）。提 NCOL 或换曲率判据前先别动 CURVE_RMS_PX。
3. **A 56-57/108 等压黄期雾区褶皱假有效（~5 帧）**：过曝雾区的纯 L 褶皱边 nk=7，
   恰卡在验收豁免门（nk≥8）之下；且这些帧 base+15 阈值在深偏工作点下碰巧放行。
4. **口径差（非算法错误，约 40 帧）**：A/I/D 的 gt2/gt3 帧带真值线且预测 off 与真值
   吻合（边界可见+车在灰/黄区）。标注口径 = 车所在面；算法 st 仅丢线帧报方向、
   valid 帧恒 0/1（第七次解耦设计）。比对时这类「误判」应人工剔除。

## 第十八次（2026-10-06）：off 门自适应角度中位数（ANG_MED_N=5 + ANG_MED_OFF_GATE=6.0）

B1~B4（视频21~24，无标注）实测：静态场景角度帧间步是"主流态+单帧凹陷"的双稳态
翻动（视频23 #65-73：4.5↔2.7 两态逐帧交替），基线超 0.3° 帧占比 35~46%。

| 视频 | 基线 p95/max/超0.3% | 改后 p95/max/超0.3% |
|---|---|---|
| 21 (B1) | 1.20° / 2.30° / 42% | **0.90° / 2.30° / 13%** |
| 22 (B2) | 1.20° / 2.30° / 41% | **0.20° / 1.30° / 5%** |
| 23 (B3) | 1.80° / 2.90° / 45% | **0.90° / 2.80° / 14%** |
| 24 (B4) | 1.40° / 2.00° / 35% | **0.30° / 0.90° / 4%** |

GT 全任务（A~K/P/T/U/V，2403 帧）代价：state 与 off **逐位不变**（2188/2403=91.1%
与第十六次持平）；angMAE +0.25~0.66（A +0.66 / K +0.57 / I +0.51，均值 ~+0.4°）=
中位数在真实转弯坡上的滞后，系统性可补偿，换静态随机噪声 −3 倍。⚠️ 已否决：子条
带精采样（21/24 好但 22/23 反而差）、混合理智斜率 TS（16 代复测无增益 off 也差）、
无条件 med5/med3（转弯代价更大）。B2 桶区：机器人在沿桶区圆弧走，遮挡+弧线斜率
差导致的摆动被中位数压住单帧部分；弧线曲率的几何级建模另立改动。
