Qexran/GongKeCompetition/现场/决赛文档.pdf

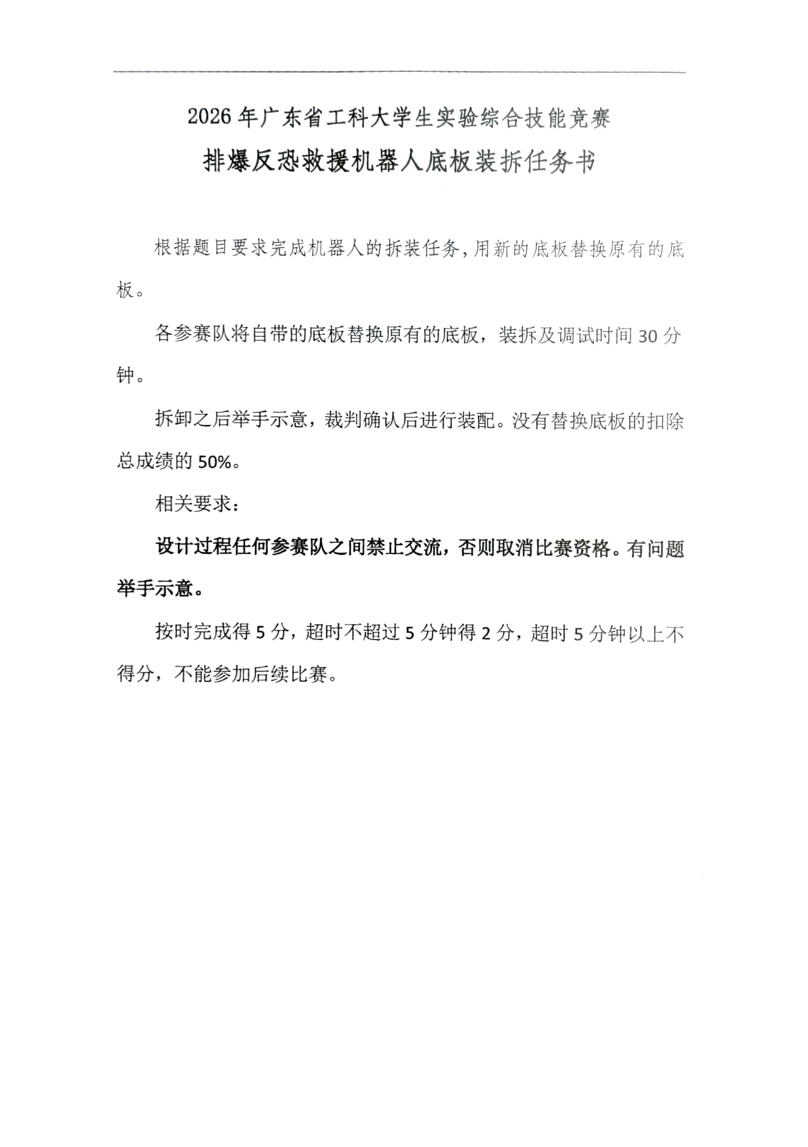
[picture p3: page 1]
