Qexran/GongKeCompetition/训练/OpenMV巡线训练/训练工具TrackingLineProject_1.1/harness/out/B_视频23_f0189_raw.png

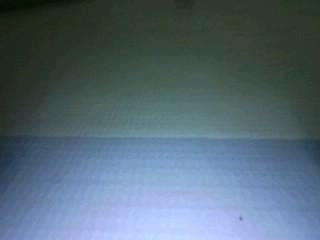
训练/OpenMV巡线训练/训练工具TrackingLineProject_1.1/harness/out/B_视频23_f0189_raw.png
