Qexran/GongKeCompetition/训练/OpenMV巡线训练/训练工具TrackingLineProject_1.1/harness/out/B_视频24_f0099_overlay.png

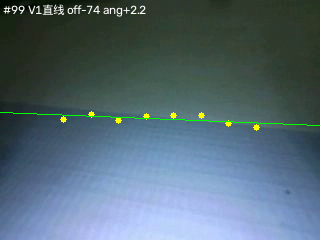
训练/OpenMV巡线训练/训练工具TrackingLineProject_1.1/harness/out/B_视频24_f0099_overlay.png
