Qexran/GongKeCompetition/训练/OpenMV巡线训练/训练工具TrackingLineProject_1.1/harness/out/dbg2/K_f072.jpg

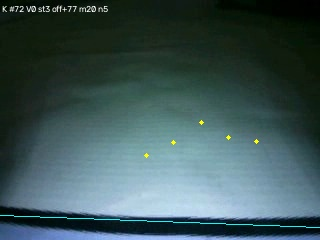
训练/OpenMV巡线训练/训练工具TrackingLineProject_1.1/harness/out/dbg2/K_f072.jpg
