Qexran/GongKeCompetition/训练/OpenMV巡线训练/训练工具TrackingLineProject_1.1/labeltool/tasks/15/frames/0039.jpg

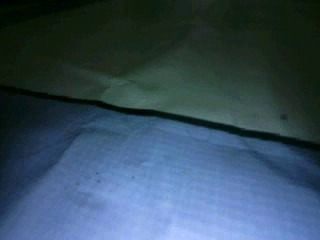
训练/OpenMV巡线训练/训练工具TrackingLineProject_1.1/labeltool/tasks/15/frames/0039.jpg
