Qexran/GongKeCompetition/训练/二维码训练(已弃用)/DiffcultQR/dev/rebuilt_norm.png

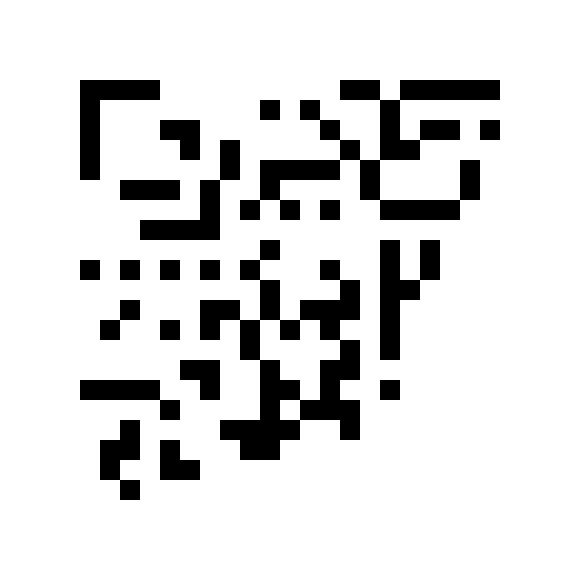
训练/二维码训练(已弃用)/DiffcultQR/dev/rebuilt_norm.png
