Qexran/GongKeCompetition/训练/二维码训练(已弃用)/DiffcultQR/dev/roi.png

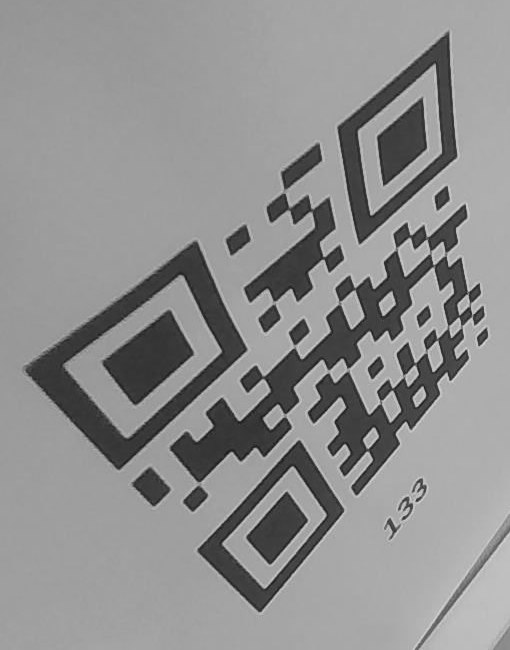
训练/二维码训练(已弃用)/DiffcultQR/dev/roi.png
