Qexran/GongKeCompetition/训练/二维码训练(已弃用)/qr_oblique_offline/qr_crop_big.png

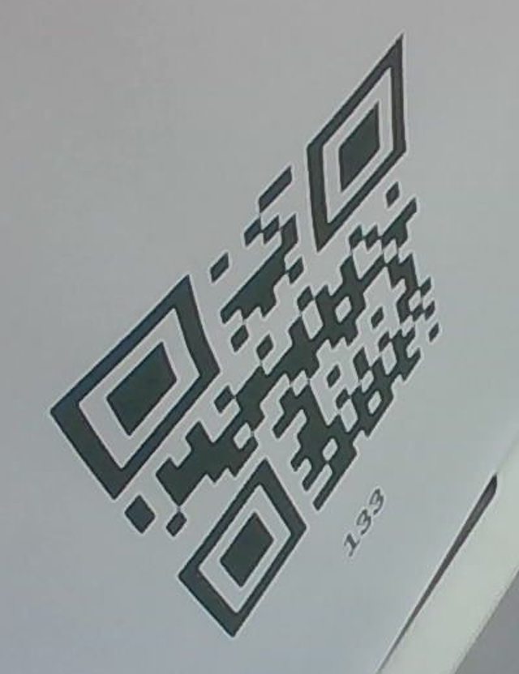
训练/二维码训练(已弃用)/qr_oblique_offline/qr_crop_big.png
