Qexran/GongKeCompetition/训练/二维码训练(已弃用)/qr_oblique_offline/real_rect_finders.png

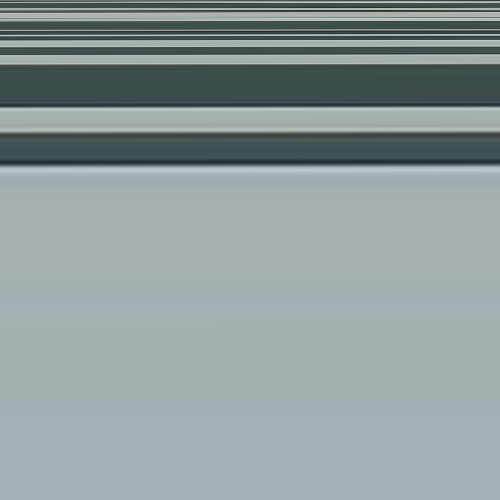
训练/二维码训练(已弃用)/qr_oblique_offline/real_rect_finders.png
