Qexran/GongKeCompetition/训练/矩形框(已弃用)/矩形框识别情况2.jpg

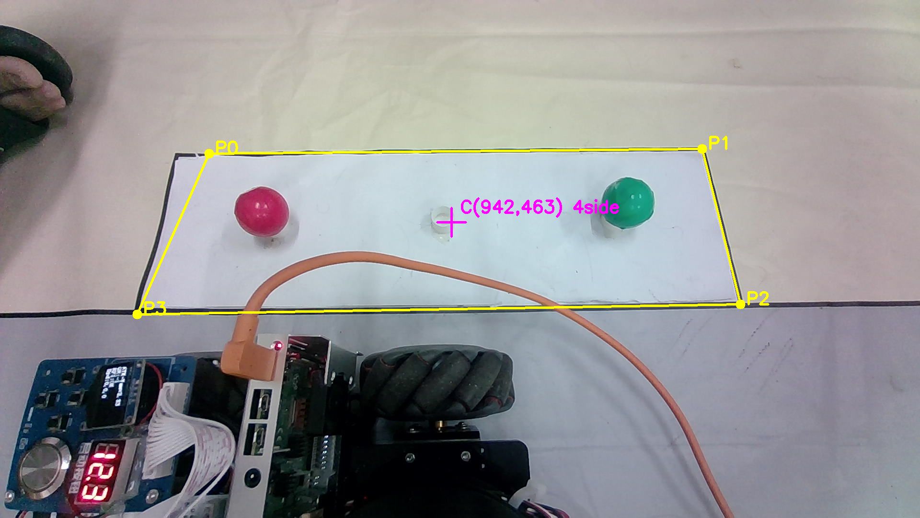
训练/矩形框(已弃用)/矩形框识别情况2.jpg
