Qexran/GongKeCompetition/模型/SLDPRT/地图.SLDPRT

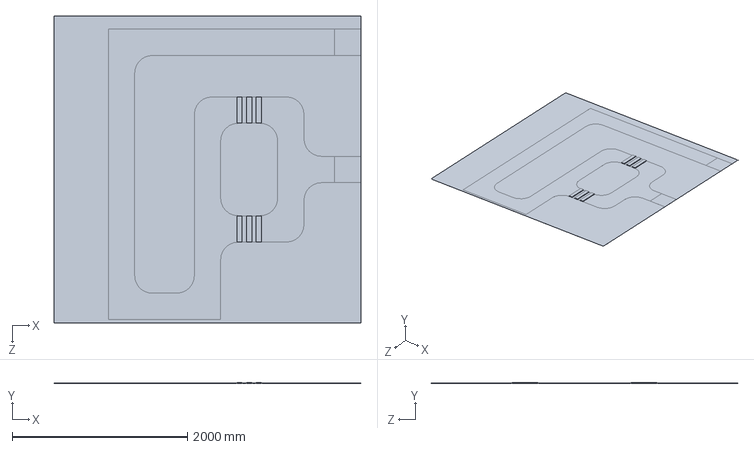
[picture p24: CAD file, 2026-11-12]
模型/SLDPRT/地图.SLDPRT
3500.0 x 10.1 x 3500.0 mm
