Qexran/GongKeCompetition/模型/STEP/球托.STEP

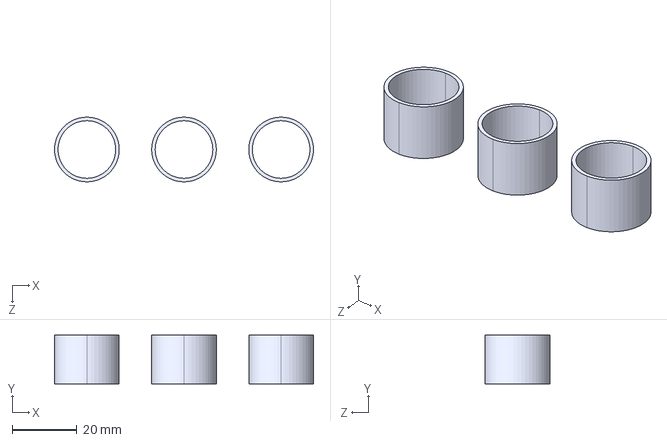
[picture p25: CAD file, 2026-11-12]
模型/STEP/球托.STEP
80.0 x 15.0 x 20.0 mm
