Qexran/GongKeCompetition/模型/SLDPRT/固定基准板3A 4mm.SLDPRT

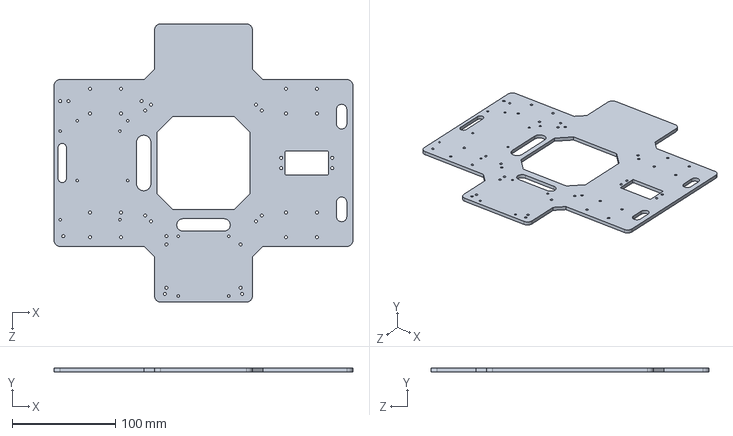
[picture p26: CAD file, 2026-11-12]
模型/SLDPRT/固定基准板3A 4mm.SLDPRT
290.0 x 4.00 x 270.0 mm
