Qexran/GongKeCompetition/模型/STEP/激光支架.STEP

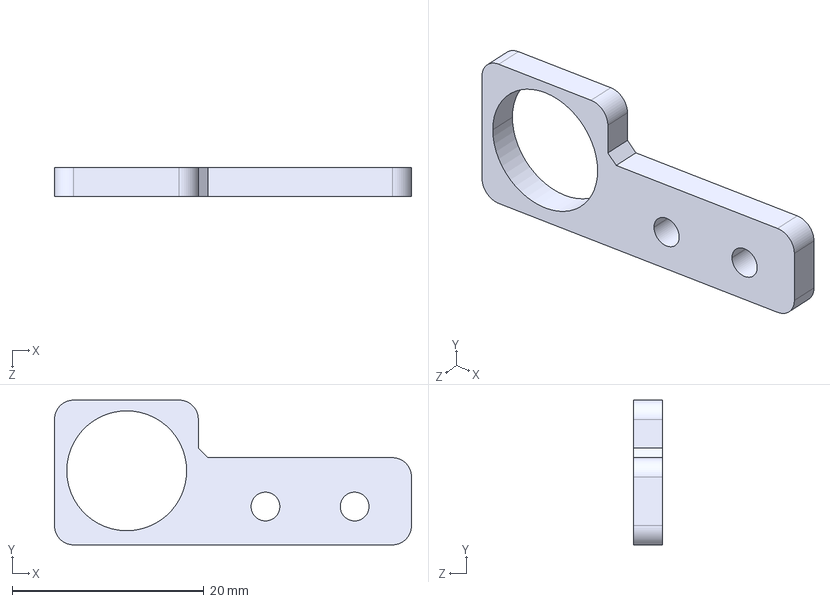
[picture p27: CAD file, 2026-11-12]
模型/STEP/激光支架.STEP
37.2 x 15.1 x 3.00 mm
