Qexran/GongKeCompetition/模型/SLDPRT/底板3A.SLDPRT

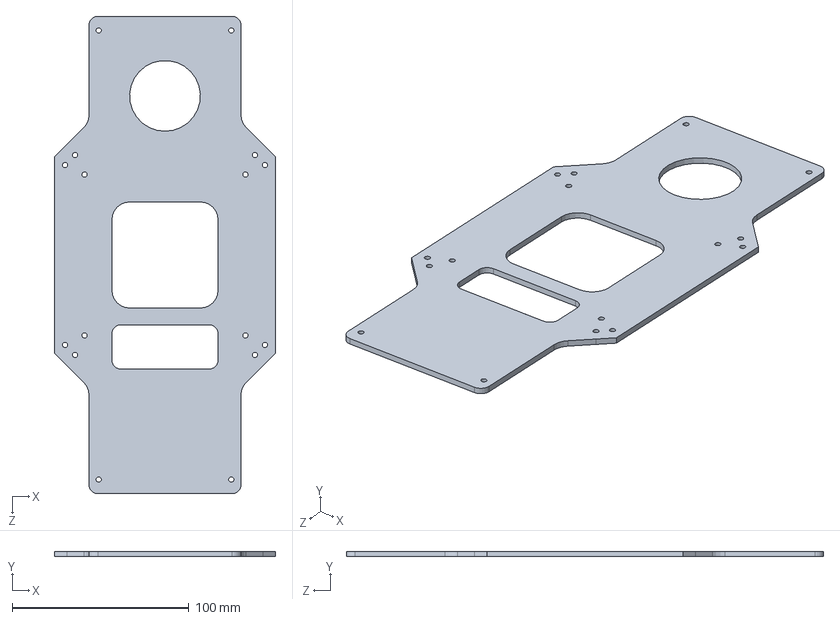
[picture p28: CAD file, 2026-11-12]
模型/SLDPRT/底板3A.SLDPRT
125.0 x 3.00 x 270.0 mm
