Qexran/GongKeCompetition/模型/STEP/靶子.STEP

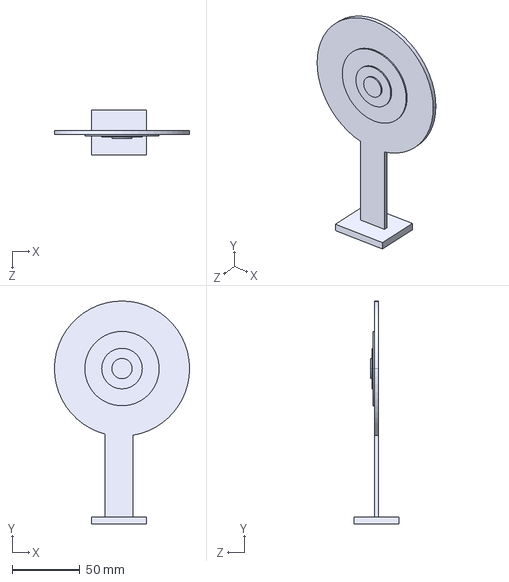
[picture p29: CAD file, 2026-11-12]
模型/STEP/靶子.STEP
100.0 x 165.0 x 33.0 mm
