Qexran/GongKeCompetition/模型/STEP/人质放置台.STEP

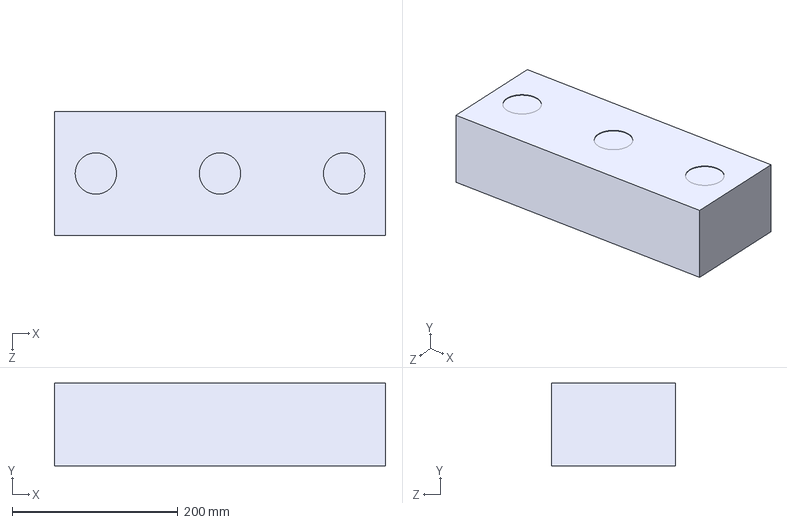
[picture p30: CAD file, 2026-11-12]
模型/STEP/人质放置台.STEP
400.0 x 100.0 x 150.0 mm
