Qexran/GongKeCompetition/模型/STEP/人质放置台V2.0.STEP

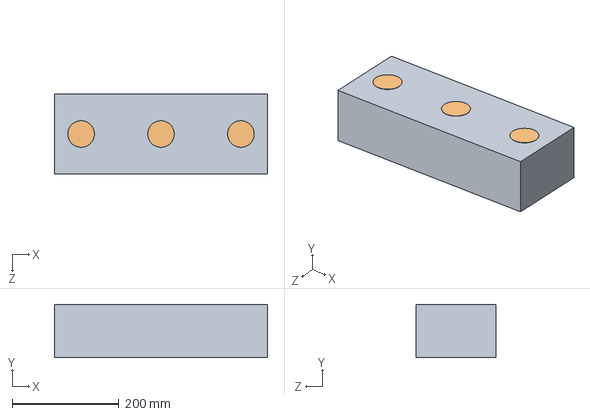
[picture p31: CAD file, 2026-11-12]
模型/STEP/人质放置台V2.0.STEP
400.0 x 100.4 x 150.0 mm
