Qexran/GongKeCompetition/模型/STEP/球体.STEP

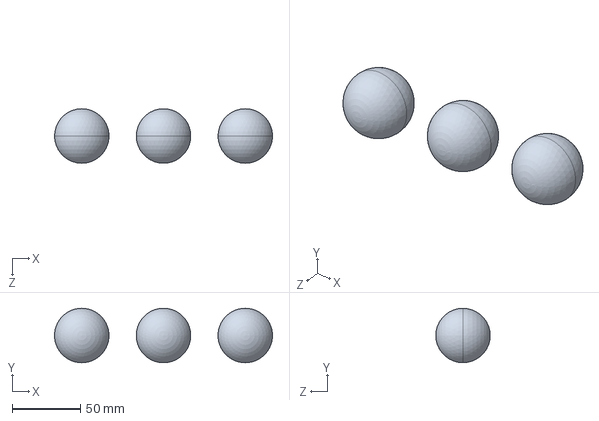
[picture p32: CAD file, 2026-11-12]
模型/STEP/球体.STEP
160.0 x 40.0 x 40.0 mm
