Qexran/GongKeCompetition/模型/SLDASM/c测试.SLDASM

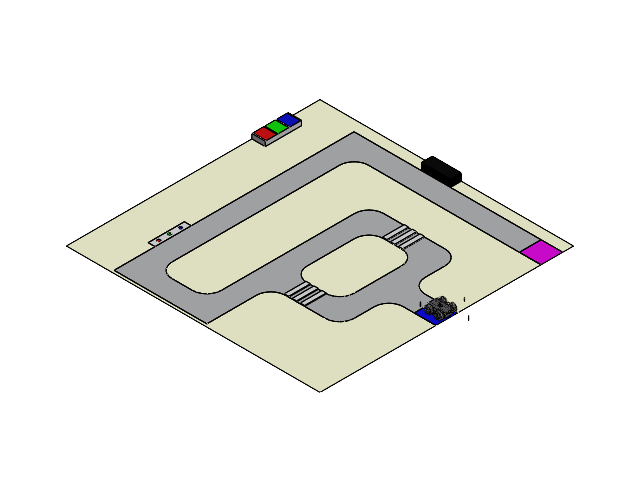
[picture p33: CAD file, 2026-11-12]
模型/SLDASM/c测试.SLDASM
100mm麦克纳姆轮右 x 2
100mm麦克纳姆轮左 x 2
ts-1145a-b-a_White.step.STEP x 8
User_Library-XH2_54-4P-AW.step.STEP x 4
XH2.54-8P_H-0.step.STEP x 4
Extruded.step.STEP x 4
Extruded-1.step.STEP x 4
42_STEPPER_MOTOR.STEP x 4
SHIM_3x7x3.STEP x 16
M3x6mm_Phillips.STEP x 16
ZDT_X42_V1.2.STEP x 4
WIRE_2.54.STEP x 4
42步进电机支架 x 4
M3x40铜柱
M3x50铜柱
M3x8螺丝杯头内六角
固定基准板3A 4mm x 2
M3x60铜柱 x 5
地图
