Qexran/GongKeCompetition/模型/SLDASM/装配体1.SLDASM

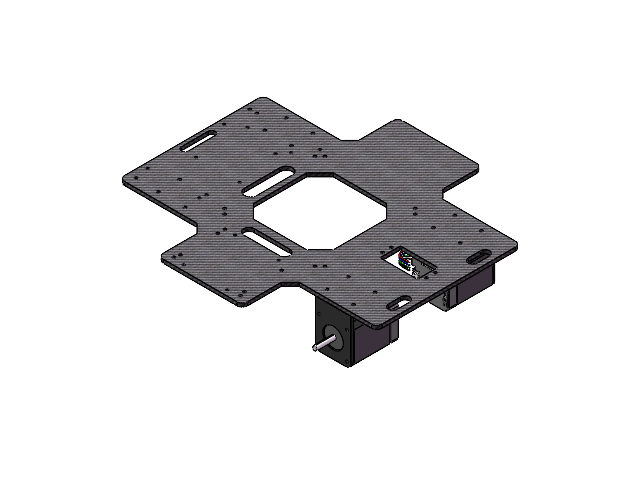
[picture p35: CAD file, 2026-11-12]
模型/SLDASM/装配体1.SLDASM
固定基准板3A 4mm
ts-1145a-b-a_White.step.STEP x 4
User_Library-XH2_54-4P-AW.step.STEP x 2
XH2.54-8P_H-1.step.STEP x 2
Extruded.step.STEP x 2
Extruded-0.step.STEP x 2
42_STEPPER_MOTOR.STEP x 2
SHIM_3x7x3.STEP x 8
M3x6mm_Phillips.STEP x 8
ZDT_X42_V1.2.STEP x 2
WIRE_2.54.STEP x 2
42步进电机支架 x 2
