Qexran/GongKeCompetition/(list of files, cad)

Other CAD files:
模型/3mf/AAA第二部分人质.gcode.3mf
模型/3mf/摄像模块2.gcode.3mf
模型/3mf/拓展支架.gcode.3mf
模型/3mf/QE球体.gcode.3mf
模型/3mf/靶子.gcode.3mf
模型/3mf/AAA主摄像头支架.gcode.3mf
模型/3mf/激光支架.gcode.3mf
模型/3mf/AAA第一部分人质.gcode.3mf
模型/3mf/球托.gcode.3mf
模型/SLDPRT/人质放置台.SLDPRT
模型/SLDPRT/球体.SLDPRT
模型/SLDPRT/球托.SLDPRT
