Qexran/GongKeCompetition/训练/二维码训练(已弃用)/qr_oblique_offline/cmp_clean_vs_printed.png

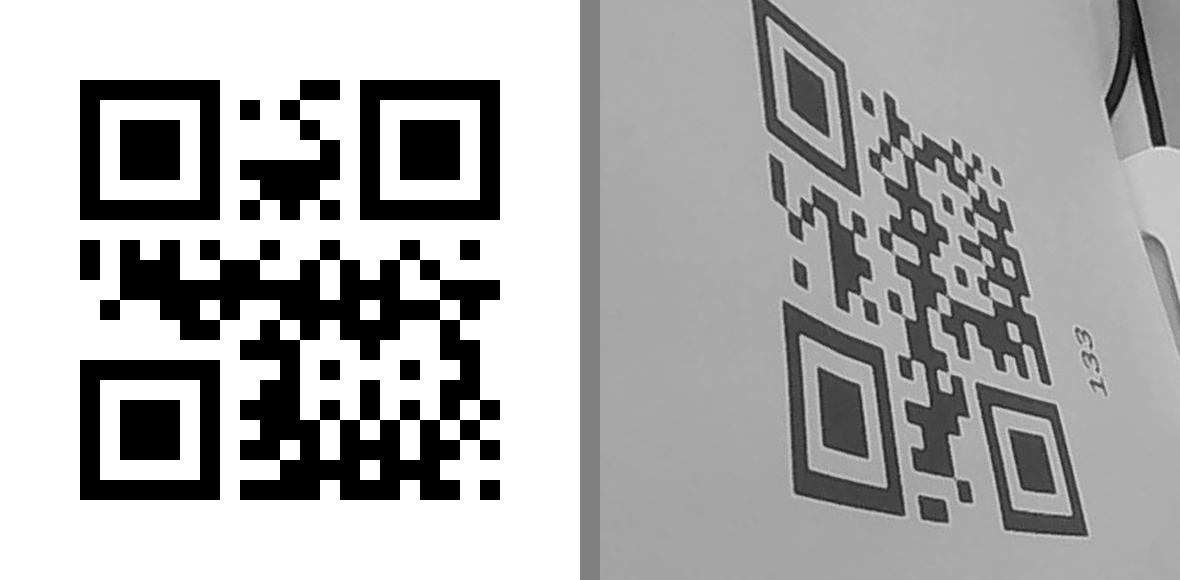
训练/二维码训练(已弃用)/qr_oblique_offline/cmp_clean_vs_printed.png
