Qexran/GongKeCompetition/训练/人质/旧pt模型/results.csv

epoch | time | train/box_loss | train/cls_loss | train/dfl_loss | metrics/precision(B) | metrics/recall(B) | metrics/mAP50(B) | metrics/mAP50-95(B) | val/box_loss | val/cls_loss | val/dfl_loss | lr/pg0 | lr/pg1 | lr/pg2
1 | 222.14 | 1.3998 | 3.15121 | 1.70891 | 0.16354 | 0.19511 | 0.329 | 0.22599 | 0.77034 | 2.37033 | 1.16214 | 0.000327778 | 0.000327778 | 0.06755
2 | 440.061 | 0.78244 | 1.75138 | 1.1833 | 0.25904 | 0.85236 | 0.38195 | 0.31677 | 0.49088 | 1.72936 | 0.90411 | 0.000656748 | 0.000656748 | 0.0345456
3 | 657.388 | 0.71168 | 1.54578 | 1.12775 | 0.5481 | 0.54601 | 0.51375 | 0.38804 | 0.49696 | 1.65958 | 0.94395 | 0.000981318 | 0.000981318 | 0.00153687
4 | 875.394 | 0.68295 | 1.41595 | 1.10581 | 0.45629 | 0.64501 | 0.6045 | 0.44331 | 0.52493 | 1.46713 | 1.00094 | 0.0009802 | 0.0009802 | 0.0009802
5 | 1088.64 | 0.62714 | 1.27263 | 1.08294 | 0.60073 | 0.51003 | 0.6906 | 0.55264 | 0.47372 | 1.35204 | 0.99444 | 0.0009736 | 0.0009736 | 0.0009736
6 | 1304.23 | 0.60404 | 1.27543 | 1.07039 | 0.61647 | 0.78515 | 0.76134 | 0.63345 | 0.49746 | 1.17649 | 1.02868 | 0.000967 | 0.000967 | 0.000967
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
