Qexran/GongKeCompetition/训练/OpenMV巡线训练/OPENMV调试训练过程截图/dbg_verify.png

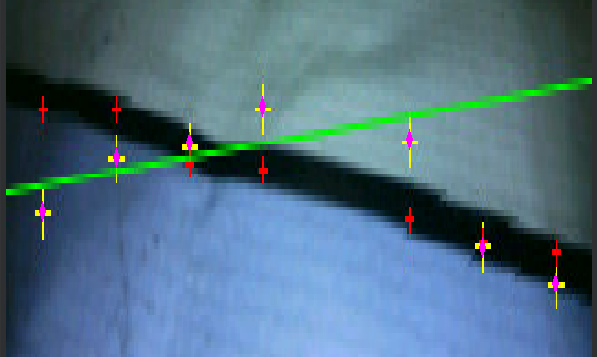
训练/OpenMV巡线训练/OPENMV调试训练过程截图/dbg_verify.png
