Qexran/GongKeCompetition/训练/OpenMV巡线训练/OPENMV调试训练过程截图/uuu.bmp

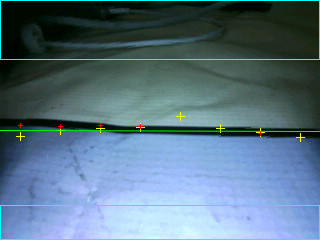
训练/OpenMV巡线训练/OPENMV调试训练过程截图/uuu.bmp
