Qexran/GongKeCompetition/训练/OpenMV巡线训练/OPENMV调试训练过程截图/直线误判成拐弯的情况.bmp

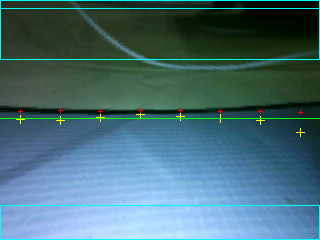
训练/OpenMV巡线训练/OPENMV调试训练过程截图/直线误判成拐弯的情况.bmp
