Qexran/GongKeCompetition/PCB/SCH_主板_2026-09-06.pdf

# 电机输入

# 控制面板

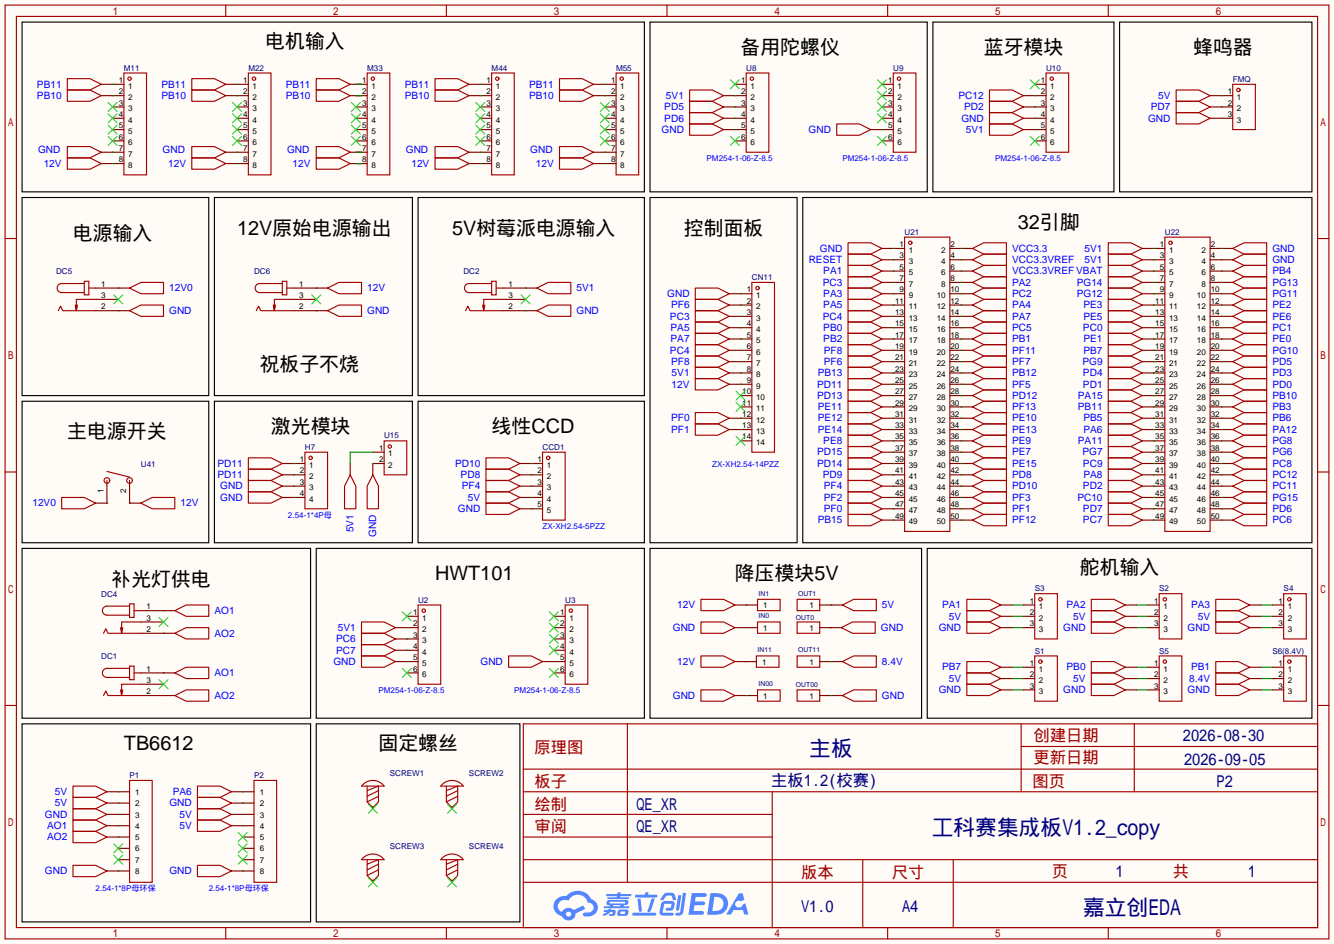
[picture p75: page 1]
