Qexran/GongKeCompetition/训练/OpenMV巡线训练/训练工具TrackingLineProject_1.1/main.py

# -*- coding: utf-8 -*-
"""
单线巡线 —— 侧装摄像头视觉程序（固定测量区 + 上下参考色距离剖面过零）
================================================================
2026-09-13 换测量核心。旧法（find_blobs 取最大色块 → b.rotation 主轴当航向角、
bbox 极值边当交界行）已弃用：它读的是"像素云的形状"，块随光照/裁切一变就翻号。
新法见"测量核心"一段；它的验证记录与逐步推导在 angle_test.py 里。
2026-09-25 判别量再换（距离剖面）：单通道过中点在"阴影/褶皱 + 黑条"的场上会把
阴影边当成边界（uuu.bmp 帧 x≈180 锁到褶皱阴影边、x≈20/300 锁到黑条下沿），绿线跳。
改为每条横条的 (a,b) 到该列上/下参考色的距离²之差 f 过零 —— 阴影把色度压向原点
也不再翻面，黑条不再把落差劈成两半（推导见主循环第 3 步注释）。交界行定义挪了
几 px，上车后若车摆正时 offset 不为 0，按 angle_test.py 的流程重标 TARGET_OFFSET。
（main_a 是 2026-09-25 的 A 改法试验版：只换判别量。本文件 main_a2 在 A 之上再加
"局部参考色"第二遍细化 —— 针对 结果.bmp 帧暴露的新失效模式：顶部参考带吃进远处
阴影、底部参考带被 LED 过曝冲淡(b 在 -10~-37 间横漂)，穿越点在宽黑带里的高度随
参考色逐列漂移成 ±15px 的拱形。见 refine_local() 注释。）
main_a3 再治"出量小跳变"（2026-09-25 车上静止实测：ang 在 -0.7~-1.6 间跳，与
点5剔1/点6剔0 的内点集翻动同相 —— 边缘点的残差在 RANSAC 门槛附近，进出一次斜率
阶跃 ~0.4°；而同一日志里黑线拟合的角度只有 ±0.06°）。两个手段：出量优先用黑线
拟合（练习图黑条中心最锐利；标准地图无黑线自动回落色边，结果.bmp 帧上色边给
-9.9° 而黑线给 +5.9°、与真值 ~+5.4° 吻合），再加 EMA 出量滤波（std 2.3→1.6 @0.1°
单位，~100ms 滞后）。中数滤波实测对这种双稳态翻动有害，默认关（负结果记在
FILT_MED_N 注释）。滤波只动出量不动测量。
2026-09-26 帧扩到 5 字段（+state），丢线方向分类 + 路口曲线近段重拟合：
丢线时用"零星交界点行位置 → 两侧参考色色度距离"两级判别边界丢在画面哪一侧
（2=远出上方 3=压到下方 4=不明），树莓派据此**定向找线**（取代它那边死写的固定
方向）；出量拟合残差 RMS 大（路口大弧/过坎后）时改用近半段（靠车一侧）内点重
拟合 —— 航向跟"马上要进的这段"的切线，见 CURVE_RMS_PX 注释。
同日车上实测修正：颜色票没结论时不再报"说不清"—— margin 塌（整帧灰、两面分
不开）在本场实际就是边界远出，直接按 2 兜底；只有 margin 还开着（交界其实还在
画面里）才报 4。终端 valid= 后也加了人话标签（[直线]/[路口弧]/[边界远出]/
[压黄区]/[不明]）。
2026-09-27 修"全黄被报边界远出"（车上实测翻车）：根因是压黄过程中（边界行还在
窗口下部、帧仍有效）底带已被黄区吃进，ref_road 被一路 EMA 成黄 → 全黄帧两票
打架落兜底、按"整帧灰=远出"错报 2。两手：① 参考色只在交界行位于 REF_SAFE_ROW
[70,195] 的健康帧里刷新（用户实测前提：丢线前必见健康帧）；② 兜底加"时序"级
—— 丢线前边界行往哪边出画就报哪边（>195=压黄区，<70=边界远出）。出发区(蓝)/
终止区(粉)在路侧：核心测量不挑路面颜色，参考色过区时短暂自适应再跟回，无需特判。
同日第二次车上实测后改标签语义：st 数字 = 找回方向（给树莓派，"边界从哪边出画/
怎么找回"），终端标签 = 所在面（给人看，近侧下带颜色判"压黄区/压灰区"）—— 两者
解耦。实测发现骑线/斜压帧（margin 还开着、交界在画面里只是测不出）会被单个孤
零星点带偏方向 → 点位置票加 ≥2 点门槛。标签集变为：直线/路口弧/压黄区/压灰区/
边界出画(方向定但面色认不出)/不明。
同日第三次实测（两份日志一致）**方向定律定案并反转 st 语义为"所在面"**：推向
黄区 ⇒ off 由正走负、边界行下降并从画面**顶上**出画；推入路内 ⇒ off 走正、从
**底下**出画（与 9 月旧照片推的方向相反，以新日志为准）。st 从此只表示车在哪面：
3=压黄区、2=压灰区；点位置/时序/颜色三条证据统一按新定律映射（交界被推向上方
= 黄侧，下方 = 灰侧）。⚠️ 树莓派侧恢复方向锚点：st=3 → "让 off 增大"（回路面），
st=2 → "让 off 减小"（回边界）。⚠️ 改完相机盘 main.py 必须重启相机才生效。
同日第四次实测（"远离直线显示压黄区"）**修正第三次的方向定律（上条已作废）**，
四组实测唯一自洽解：压向**被监控的**黄区 ⇔ off→正、边界行上升、从画面**底**出；
离线入路内 ⇔ off→负、从**顶**出。第三次定错的原因：那次"推到黄区"推的是**对面**
黄区（场地两侧都有黄区，穿过路面 = 离线，被监控的边界在远离）。锚点更正：
st=3 → 让 off 减小（回路面）；st=2 → 让 off 增大（回边界）。
同日第五次（用户给出决定性定律，修"压黄区显示成压灰区"）：**压灰侧 off 必衰减、
压黄侧必增加** —— 行位置一对阈值（FAR_ROW/NEAR_ROW）通吃点票 / 丢前行位置
（off 符号）/交叉验证三级证据；删掉"卡全灰默认报 2"兜底（它把颜色认不出的全黄
帧错标成灰，本次翻车根因）与 margin/冲突规则（被 off 符号级证据覆盖）。
第六次（用户定律升级为趋势版，修"黄→灰标签跳变"）：Δ = 丢线时冻结的 off −
**直线基线**（直线帧慢跟踪、偏出 BASE_GATE 冻结），跌落=灰塌陷、抬升=黄塌陷。
相对量代替绝对符号：基线自动对准实际工作点（SETPOINT 偏置/标定偏差全吸收），
且两操作数丢线瞬间冻结 → 判据整段丢线期恒定，不再跳变。off 符号级绝对阈值
（ROW_SIGN_LO/HI）随之删除。
第七次（显示修正，判据不变）：有效帧在 |Δ|>门 时打 [直线·黄]/[直线·灰]（深偏帧
只打[直线]会被误读成正常巡线——用户看"直线-98→回升-59→判灰"以为矛盾，其实是
灰侧深处的回移）；丢线帧加打 d=<Δ>。判据基准=直线工作点而非上一帧值：从深偏处
回移的"抬升"若判黄，恢复方向会把车推回丢线区深处。
⚠️ 树莓派端 openmv_serial.py 必须先升级为"4/5 字段都收"（方案 Part 3），旧解析
器会把 5 字段帧整行拒收（症状：bad_lines 猛涨、数据永远陈旧、车不动）。
第八次（同日，治"angle 被两边黑区极值带跳"）：补光灯照不到的远端/边角是黑的，
L 塌向 0 时 |a|,|b| 一起塌向原点 —— ①顶/底参考色被黑条染黑且逐列程度不同（两边
更黑）→ 判别面逐列歪、穿越位置漂出极值；②参考色干净时 黑↔亮 过渡自己就是大落
差假穿越（f(黑)=|上参考|²−|下参考|² 可为正），与真边界抢"落差最大"。治法 = 每列
亮度掩码（近端亮度为基准 + 绝对下限，见 L_DARK_ABS/DARK_FRAC）：参考色只在亮条
里取（顶参考改为从上往下找前 3 条**亮**条，不再死取前 3 条）、从窗口顶连下来的
暗条串里的穿越一律不认（练习图黑线悬在亮区不连顶，不受影响）、整列黑的边列不
采；全局 margin/判别通道/丢线颜色票改用亮条参考色的中位数（TOP_BAND 整带统计
吃进黑区会塌 margin → valid 无故翻 0）。测量层治本，出量滤波不动。
上车即翻车修正：顶参考搜索窗最初死写前 8 条(96 行)，而本场有的路段黑区深达
~100 行 → 一个亮条都找不到 → 列 0/8、永远[不明]；改为整列从上往下找前 3 条亮条
（扫过交界面进路面侧时上下参考同色 → d2 塌 → 闸不放行，不会出假点）。
第九次（同日，标准赛道浅色差适配）：标准地图两面色差浅（margin 常只有 ~10-20，
按练习图 32~40 标定的门槛会把好帧整段拒掉）。三个手段，全都不吃 fps：① f 剖面
先过三点平滑 smooth3 再找过零 —— 单调过渡的过零位置无偏、噪声方差 ↓~3 倍；②
CROSS_MIN_SWING_FRAC 0.5→0.35（配合①，对噪声反而更保守：0.35×1.7 < 0.5）；③
MARGIN_MIN 20→10（黑区掩码+平滑+落差闸+RANSAC 四层防线在，全灰/全黄帧 margin
≈0-6 仍被拦住）。还嫌信噪比不够的下一档杠杆是加宽采样列 COL_W 或提高补光/曝光
（动曝光要重标 TARGET_OFFSET 一系），都不在本改里。
第十次（同日，治"远离边界拿补光渐变当边界"）：交界整个埋进顶部黑区时，整列只剩
"阴影路面(色度还在) → 渐亮 → 底部反光冲淡"几段**渐变**，参考色取在渐变上 → f 自
己造出大落差假穿越，8 列散成 ~80px 宽（离谱.bmp 实测），拟合不出线还偶发吐垃圾
测量误导恢复。三改：① 顶参考 3→2 条（给贴黑区下缘的薄亮带真交界留出带外空间，
frame_b 实拍帧复算 7/8 列通过）；② 穿越必须落在两条参考带**之间**（带内=上下是
同一条渐变，离谱帧 7/8 列栽此）；③ 带内到穿越之间 f 不得回翻错侧超满程 15%
（真两面在穿越两侧饱和，渐变必回翻）。离谱帧复算只剩 1 个孤点 → 不成拟合 → 干
净丢线 → Δ 判据报方向（st=2/3），树莓派按方向找回。
第十一次（2026-09-29，任务F 闭环回归暴露四根因：假有效/假丢线/贴底交界不可测/
回放器漂移；诊断依据 RECOVERY_NOTE.md + harness/diag_cols.py 逐列实测）：① 逐列
逻辑抽成纯函数 column_crossing(prof, margin)，主循环/回放器/平台三方调用同一份
—— 此前 Replay.step 手工复刻第 3 步漏同步第八/十次机制，离线结论不再代表相机；
② robust_fit 候选下限 6→5，配 _five_ok（内点 x 跨度 ≥120px 且 RMS≤4.0），只影响
5 点候选帧 —— 治"假丢线"（任务F 90-97 帧 5 个真点被 n≥6 硬门整帧拒掉）；③ 底
参考区域生长：从最底亮条向上、与最底那条比色距 ≤ REF_GROW_STEP=6.0 才收（防沿
明暗渐变漂移），合法域闸 A 只留顶侧 top_lim —— 治"贴底交界不可测"（任务F 22-24/
31-34 帧：底参考被交界吃进 + bot_lim 把底带内真穿越全杀）；④ CURVE_RMS_PX
5.0→6.5（任务F 逐帧真值无任何 state=1 帧）；⑤ 出量门控 EMA：FILT_FAST_GATE=12.0
/ FILT_EMA_A_FAST=0.9（门内 0.5 慢平滑、门外快跟，两轴各自判门）；⑥ "假有效"
唯一成立治法 = 物理连续性：丢线出画方向已知（Δ 判据整段恒定）时，候选点先**点级
过滤**到入边半场（st=3 → 行≥REACQ_ROW_MIN=175 / st=2 → 行≤REACQ_ROW_MAX=115）
再拟合，拟合成功即解锁；连丢满 REACQ_GATE_FRAMES=8 帧熔断放行（fail-open）。
⚠️ 逐列外观判据（材料阶绝对阈/相对阈/参考贴合度/局部尖锐度）已实测证伪（校赛
地图回归 50%→28%，或两分布实测重合），勿再试；帧级 REACQ 也已实测死锁（假线与
真边界并存时 RANSAC 选假线→行不符被拒→永远重锁不上），必须点级过滤。
第十一次重做补记（2026-09-29，r4 代码态未留档、按本清单重推时的两处实测修正）：
① REF_GROW_STEP 10.0（草稿 6.0）：任务F 89-98 帧贴底渐变列锚距实测 6.7~8.9，
6.0 把底参考饿成 2 条 → 过零落渐变中点、角度偏平 4°+；② FILT_FAST_GATE 6.0
（草稿 12.0）：off 轴 12 → MAE 6.90/残差std 9.02，6 → 6.45/8.67。草稿常数组合
实测 7.15/29/2.63/114/9.44/3.02（对照 r4 线 6.69/28/2.35/112/9.0/2.68），修正后
6.45/30/2.57/113/8.67/2.93；剩余差距集中在 4/6/8/21/35/72 等边界帧（RANSAC 首个
最多内点对 + 门控 EMA 的链式临界翻转，r4 逐列行为不可复算）。工具：harness/
score_local.py 可离线复刻 /compare 评分扫参。
r3 轮补记（同日继续训练 1~3 轮）：③ RANSAC_TOL_PX 10.0→8.5（8.5 才是该常数注释
"0.7×STRIP"的本意）+ 门控门 6→5，终版 6.04/29/2.49/113/8.26/2.88 —— 六项全面
优于 r2；TOL 7.0~7.5 off_max 反弹 31，8.5 为均衡最优。视频6/16 无真值回归不劣化。
第十二次（2026-09-29，任务P=视频16 全标注 184 帧实测定案："后半段压黄区误检成
直线"）：根因 = 第十一次熔断 fail-open 的副作用 —— 压黄区丢线段一超过
REACQ_GATE_FRAMES=8 帧，点级过滤被永久放行，同材渐变假线（8 列紧密成线、行
121~159）当帧假重锁，丢线计数清零，此后整段假有效（P 174-183 连续 10 帧 st=0，
off 还给成负值）。修法 = **放行期再锁定的 Δ 同侧验收**：丢满 8 帧进入放行态后，
拟合出的 raw_off 必须与 Δ 判据同侧（st=3 → raw_off > base_off + DELTA_GATE /
st=2 → < base_off − DELTA_GATE），否则是"把交界瞬移到基线另一侧"的渐变假线 →
拒绝、按丢线处理（过滤本就放行，下帧照常）。依据：st=3 期间真交界只可能在基线
黄侧（off 从 +100 往回落、途经帧即会锁定），假线无此约束。⚠️ 过渡方案（每 8 帧
周期重试 + row_ctrl ≥ REACQ_ROW_MIN 验收）已实测否决 —— 任务F 的真恢复快速扫过
入边半场（帧 33-34 仅 4-5 点没锁上），边界稳在行 157~170 后被固定行阈值永久拒掉，
35-93 帧 72 帧全盲（state 113→64）；行阈值分不开 P 的假线（154）与 F 的真线
（168~172），off 侧判据才分得开（P −16 vs 阈值 −1 / F +13）。只验收放行帧：过滤
帧的点已在入边半场，不再二道拒。结果：P state 172→182/184、F 与视频6/16 不变。
第十三次（2026-09-29，任务H=视频8 全标注 174 帧加入训练；用户实测报告"补光灯中
心散开照不到左右两边，边缘黑像素让黄色标记严重偏离中间标记" + "F 前 10 帧严重
偏离标定方向" + "追求角度稳定（连续帧跳变 ≤0.3°）"）：逐列诊断实测定案 —— 各帧
的列照度指纹完全固定（l_near 按列 ≈ [48,61,73,80,80,76,67,55]，LED 中心在
col140~180），预测偏差随列照度单调恶化（暗列里暗路面"看起来像顶参考"，距离差
f 的过零被照度梯度往下推，col20 最狠 +45~+96px）。修法 = refine_local **迭代收
敛**（REFINE_ITERS=3）：局部参考的照度差随迭代几何减半、3 次到不动点。效果：
F off 6.04→3.10 / off_max 29→13 / ang 2.494→1.389；H off 5.28→3.72 / ang
2.193→1.380；P/视频6/16 不变或微好。代价（诚实记录）：F 帧 4、36-43 转丢线
（点集在照度梯度的两个不动点间散开、RANSAC 内点 <5），state 113→104 —— 这些帧
GT 标有效但交界贴着画面底边/黑区，宁缺勿假。⚠️ 角度稳定性实测否决了全部输出滤
波方案：hue 归一化（暗带噪声×3，F off 18.7）、固定行阈值回退（F 72 帧全盲）、
Theil-Sen（无剔除版 P 全场假有效/混合版无增益）、逐列时序 EMA（off 爆 9.1）、
方向持续性 EMA（H 爆 17.7°）、角度独立 EMA（a=0.25 时 ang_mae 3.2——滞后吃掉
全部收益）。0.3°/帧 硬指标与真实转弯率数学不相容（H/F 真值本身有 1.2~3.8°/帧
的持续坡），输出滤波只能换来滞后。剩余角度抖动的根子是黑区梯度里的过零仍随照
度摆动（±1~2°），下一步方向=按列内平滑照度包络做归一化（朴素逐条 L 归一已证伪），
需另立一次改动。
第十四次（2026-10-01，任务A~K 全标注（约 1600 帧）闭环训练。用户先改 MEAS_X
(0,320)→(50,270)（切两侧暗列，治 K 58-112 假丢线死锁——外侧列假穿越搅败拟合后 Δ 冻结
错向）与 gain 10；本轮在其上修五处）：
① _five_ok 跨度门 120→90：MEAS_X 收窄后 8 列全跨只剩 193px，120 相对严度大增 ——
   任务B 124-135 真边界贴底只活 5 列（跨 110px、近共线 RMS~1.5）被硬杀成丢线。
② quad_fit_line 抛物线兜底：远侧边界画面里本就带弓（透视+畸变+真弯），8 列穿越排成
   U 形，直线 RANSAC 必败 → 假丢线（K 57-60、I 215-222、E 203-206）。3 点采样穷举
   RANSAC、内点 ≥5、x 跨度 ≥90、RMS ≤2.0（J 145 类"两跳边来回跳"散点的假抛物线
   2.45 被挡；真弓形帧实测 ~1.0）；角度取近半段切线但**输出保持上一拍角**（U 形顶点
   切线与 GT 弦线差可达 13°，弦↔切切换本身即突跳）；off 用抛物线在控制列的值（K#58/
   B#128 实测误差 0~2）。返回与 robust_fit 同构的虚拟直线，下游零改动。
③ Δ同侧验收加质量豁免（REACQ_QA_NK=8 / REACQ_QA_RMS=3.0）：丢线期车继续动，真边界
   会扫过基线到另一侧，旧验收一票否决 → 长死锁（A 114-134 21 帧、E 203-231 27 帧，
   期间拟合 nk7-8 / rms1.5-2.8 全被拒、标签还错向）。nk≥8 一帧解锁即断链（#117 rms2.0
   nk8）；nk<8 的低质量线照拒。⚠️ 任务P 渐变假线质量未复测（P 不在本仓库），上车若见
   P 型假有效复发先收紧 REACQ_QA_RMS。
④ classify_lost 备胎点票加行连续门（ROW_VOTE_BAND=70）：D 59-64 过曝雾带上的假穿越
   （行 ~100，真边界 ~215）把点票带偏成"灰"（压黄报成压灰，方向标反）—— 中位行离
   丢线前边界行（last_row_ctrl）超门即弃行票，落到颜色票/④。
⑤ ANG_RATE_MAX=5.0 角度输出限速（°/帧）：真实转弯率实测上限 ~3.8°/帧（H/F 真值坡），
   超过的帧间变化只可能是拟合分支翻动/假锁/弦切切换（K#59 一帧 −17.5°、I#163 +12.1°）
   —— 硬限。与第十三次证伪的角度 EMA 本质不同：真实运动包络内完全透明（真坡 ≤3.8
   不削、无滞后），只削孤立尖刺。5.0 扫参定案（4.5 滞后 +0.02、6.0 尖刺残留大）。
（试验记录：本轮还试过"丢线期候选点行漂移 = 边界在窗内扫掠 → 豁免过滤/验收"，实测
I/J 压黄期的假点也随车漂移、放行假有效（I 3→0 20→36 帧），已删除；用户当日亦试验过
"classify_lost ④兜底 4→2"后自行回退，两案均留档于此防重蹈。）
效果（A~K 全任务，score_local 与 /compare 同口径；基线 = 用户 MEAS_X 改后）：
  state 1158→1216 /1407（82.3%→86.4%，+58 帧）；offMAE 5.13→5.12（A 9.42→7.66、
  E 死锁段全清 230/232、B 236→249、K 104→108、D 84→86）。角度最大单帧台阶：
  I 12.5→6.6°、J 17.5→9.2°、K 3.7→5.8°、A 4.3→8.2°（A/K 基线的"稳"部分是死锁冻结
  假象，现解锁跟真扫掠，台阶属追赶真运动）；off 轴 pred 台阶 std 全任务 < gt
  （如 K 11.95 vs 12.46）—— 算法输出比真车运动更平滑，无附加抖动。
剩余已知问题（下轮候选，按收益排序）：J 0→2×36（边界在弱照度渐变里、穿越锁到 LED
  光边 —— 第十三次"按列照度包络归一化"方向）；J 1→0×30（8 列对缓弧无分辨力，RMS/
  近段角差两分布实测重合）；A 56-57/108 等压黄期雾区褶皱假有效（nk7 质量恰卡在验收
  豁免门下、且 base+15 阈值在深偏工作点下失效，~5 帧）；A/I/D 的 gt2/gt3 带线帧口径
  差（标注=车所在面、算法 st 仅丢线帧报方向，约 40 帧非算法错误）。
第十六次（2026-10-01，任务U/V/T/P=视频23/24/25/27 新场地（国赛图）全标注 996 帧加入
训练。基线：四任务 state 553/996=55.5%（V/T 全盲 0/245、0/198），A~K 1216/1407=86.4%）：
逐列裁决（column_crossing）尾部新增"色度台阶重锚定 + 边缘强度门"，MARGIN_MIN 10→5。
三个根因同源于"交界落在长渐变里"：① 新场地黄区远离补光时两面 a/b 色差只剩 6.5~9，
旧 margin 门把 V/T 整段拒真（全盲）；② 渐变里 f 过零点=渐变中点、系统性偏高真边
30~60px（V#2 col63 实测：f 过零在行 119、f 最大台阶 325→639 在真值 152 处），
refine_local 的局部参考在局部线性段上的不动点也在坡中救不回；③ 接缝 2~3 条厚时各列
过零在缝内位置不一致 → 拟合散掉 → 假丢线还被 Δ 误标方向（U#83-90 等 54 帧假压黄）。
治法：过零点已踩在实体边（相邻横条 ‖Δ(a,b)‖ ≥ EDGE_STEP_SHARP=6.0）→ 一切照旧
（A~K 锐边场地零改动，回归不退的根基）；否则在合法域（顶参考带之下~底参考带之上）
找"方向对齐"的最大台阶重锚定（Δ(a,b)·(下参考−上参考) > 0 —— 真边界必从上表面色
走向下表面色，LED 热点在单材料内的回卷台阶方向相反、被此门挡掉，V#1 col63 实测
热点台阶 8.0 反向 / 真边 6.2 正向）；合法域内无对齐实体边 → 整列不采 —— 这一刀同时
是 margin 降 5 的安全阀：单材料帧（全路/全黄）纵有光照渐变、没有材料边，8 列全灭
仍判丢线，不会假有效。被闸 A/B 杀掉零点的列也走重锚定（救援，V#1 col118/228）。
效果（harness/score_local.py，12 任务 2403 帧）：state 1664→2188（69.2%→91.1%，
+524 帧）、offMAE 4.87→3.82。分任务：V 0→203/245、T 0→185/198、U 268→305/319、
P 180→227/234、J 173→214/265、A 164→177/206、D 86→93/98、K 108→109/113；
回退仅 B −3、E −6、I −1。off_max：A 171→10、I 112→17、P 42→9、U 51→37。
⚠️ 上车部署（拷相机盘+重启）后，新场地按 angle_test.py 流程复核 TARGET_OFFSET：
重锚定把"交界行"从渐变中点挪到了材料边上，名义定义有 ~数 px~1 条的平移。
（编号说明：常量注释里的"第十五次"与头部"第十四次"为同批改动，本条顺延记第十六次。）
第十七次（2026-10-02 现场事故：上车后 46fps 全 0 盲（278+ 帧全 L,0,0,0,4），IDE 里
"正常"）。两层根因：① 第十六次新加的边缘强度台阶用了 math.hypot —— 这版固件的
MicroPython 没有 hypot，逐列一进来就 AttributeError，每帧 21.5ms 快速吐 valid=0
（帧率/帧间隔是关键线索：margin 塌的帧也会跑完 8 列 ≈65ms，21.5ms 只能是异常快速
路径）；② 错误信息走 print()，脱机（USB 不连电脑）不可见 → 现场"只能看症状看不到
原因"，且 IDE 里测的是旧版文件、永远复现不出来。治法：hypot→sqrt(x²+y²)（v3.3）；
状态行/异常行镜像到 UART（'#'前缀，'D' 开关）+ 运行时调参 M/K/E/A/L+'V' 查询
（v3.2，免烧录排障/调参）。教训：离线回放器是 CPython，hypot 存在；相机固件没有
—— 凡 math 新函数先查 MicroPython 支持集（hypot/dist/isfinite/fsum 都没有），
CPython 的语法检查查不出缺属性。上车后横幅（版本）+ 'V'/'D' 一条命令即可自证版本
与病因（树莓派侧 ~/Desktop/tune_test.py）。
第十八次（2026-10-06，B1~B4=视频21~24 加入训练面；用户实测报告"静态场景角度跳变
到 2.0，随机性不适合角度闭环" + "B2 爆破桶区黄标记受桶影响"）：角度帧间步序列实
测定案 —— 是"主流态 + 单帧凹陷"的**双稳态翻动**（视频23 #65-73：4.5↔2.7 两态逐
帧交替；中位数 0.2°、p95 1.2~2.0°、max 2.0~2.9°，35~46% 帧超 0.3°），不是持续噪
声。修法 = **off 门自适应角度中位数**（ANG_MED_N=5 + ANG_MED_OFF_GATE=6.0）：
off 静止（|raw_off−filt_o| ≤ 门）时角度取 5 帧中位数把凹陷剔掉，off 在动（真机
动，转弯时 off 必然大幅移动）退化为直通零滞后。实测：视频21~24 静态步超 0.3° 占
比 42/41/45/35% → 13/5/14/4%，p95 0.9/0.2/0.9/0.3°；GT 全任务（A~K/P/T/U/V）
代价 = 转弯任务 angMAE +0.28~0.43（中位数在坡上的滞后），state/off 全不变。
⚠️ 已实测否决（勿重试）：hue 归一化、子条带精采样（22/23 反而差）、Theil-Sen
（16 代复测仍无增益且 off 变差）、逐列时序 EMA（off 爆 9.1）、方向持续性 EMA
（H 爆 17.7°）、无条件 med5。B2 桶：机器人在沿桶区圆弧线走，桶遮挡 + 弧线远近段
斜率差让点集摆动 —— 中位数把单帧翻转压住；几何级治法（弧线曲率模型）另立改动。

场地是「道路 + 边界区」的二分，摄像头侧装、镜头朝下，交界线横向（沿图像 X 轴）。

输出两个量：
  1. offset —— 横向位置偏差，归一化 [-100, 100]，0 = 交界线在目标行
  2. angle  —— 航向角偏差，单位 0.1°，0 = 与道路平行（"水平"）

串口文本帧（树莓派端 openmv_serial.py 解析）：
  "L,<offset>,<angle>,<valid>,<state>\r\n"   @115200
  第 5 字段 state（2026-09-26 加，树莓派端解析器须升级为"可缺省"）：
    0 = 正常直线测量        1 = 有效但交界是曲线（路口/弯道，已用近半段重拟合）
    2 = 丢线：车在**路面灰侧**（压灰区）→ 树莓派恢复 = 让 off 增大（回向边界）
    3 = 丢线：车在**黄区侧**（压黄区）→ 树莓派恢复 = 让 off 减小（回向路面）
    4 = 丢线：说不清（交界还在画面里只是测不出 / 没参考色）→ 走旧保持策略
    方向定律（2026-09-27 第四次校准定案）：压向被监控的黄区 ⇔ off→正、边界行
    从画面底出；离线入路内 ⇔ off→负、从顶出。⚠️ 场地两侧都有黄区，往对面黄区
    推 = 穿过路面 = 离线（灰侧），勿被迷惑。
  按需发送：默认不发送，收到树莓派写来的控制字节才开始/停止：
    'G'(0x47) = 开始发送    'S'(0x53) = 停止发送
    'P'(0x50) = 拍一张照    存到相机盘根目录的「拍摄照片」（落盘逻辑见 photo.py）
  摄像头采样循环始终在跑（保持曝光/白平衡热状态），收到 'G' 后
  下一轮采样即开始发帧，延迟约一个采样周期（~60ms）。
  valid=0 时沿用上一帧的 offset/angle —— 丢线策略在树莓派侧（其 _line.py），
  它按 state 决定往哪边找线（不再是死写的固定方向）。

⚠️ 新法**不需要任何 LAB 阈值**：两侧颜色每帧现算，所以换场地/换光照不用重标阈值。
（2026-09-27 起多了一个**亮度**掩码 L_DARK_ABS/DARK_FRAC —— 只判"这条够不够亮"
不判颜色，且相对该列近端亮度自适应，换场地仍免标定。）
"""

import sensor, image, time, math, sys
from pyb import UART, USB_VCP
from machine import Pin, PWM

# 版本横幅（2026-10-02）: 每次上电经 UART3 发一行 —— 树莓派侧「认口」时一眼确认
# 对端是本程序; **同一行反复出现 = 板子在重启循环**（之前没有任何手段能看到这种事）。
VERSION = "gks-line v3.3 (2026-10-02: 修复math.hypot缺失致全0盲)"

# ---------------- 串口（双向：收控制字节 + 发文本帧）----------------
# ⚠️ 2026-10: 提前到传感器初始化**之前**创建 —— 原来它在 sensor.reset() + skip_frames(50)
#    （合计 ~1-2s）之后才建, 那段时间 UART 驱动没装中断、硬件 FIFO 只有 16 字节,
#    树莓派上电立刻发的 'G' 会直接丢掉（表现为「第一次起流没数据, 重发一次才有」）。
#    对象建好 = RX 中断装好 = 命令字节进驱动的环形缓冲, 初始化再久也不丢。
uart = UART(3, 115200, timeout_char=1000)
uart.write("[BOOT] " + VERSION + "\n")   # 横幅①: 程序已起（sensor 初始化之前）

# 拍照落盘（存到相机盘根的「拍摄照片」）。
# ⚠️ 包 try: 导入失败**只关掉拍照**, 巡线照跑 —— 不能因为一个可选功能把整条链路带下去。
#    photo.py 就在盘根（与 main.py 同级）; 中文目录名能不能用由它自己探测（见 photo.py 顶部）。
try:
    import photo
except Exception as _e:
    photo = None
    print("[拍照] photo 模块导入失败, 拍照功能关闭（巡线不受影响）:", _e)

# ---------------- 传感器初始化 ----------------
sensor.reset()
sensor.set_pixformat(sensor.RGB565)
sensor.set_framesize(sensor.QVGA)      # 320x240
# 固定曝光/增益/白平衡，保证亮度确定、两侧色心稳定
EXPOSURE_US = 6000            # 固定曝光时间(us)，需实测调（v3.2 起可用 'E<值>\n' 运行时改）
GAIN_DB     = 10              # 固定增益(dB)（'A<值>\n' 运行时改）
sensor.set_auto_exposure(False, exposure_us=EXPOSURE_US)
sensor.set_auto_gain(False, gain_db=GAIN_DB)
sensor.set_auto_whitebal(False)                     # 固定白平衡
sensor.skip_frames(50)                              # 等设置生效
uart.write("[BOOT] sensor ready\n")                 # 横幅②: sensor 初始化完成
                                                    # （只有①没有② = 卡死在 sensor 初始化里）
# 视实际安装方向，可能需要取消下面某几行注释（先实测再定）：
# sensor.set_hmirror(True)
# sensor.set_vflip(True)

LENS_CORR_STRENGTH = 2.3   # 镜头畸变校正强度：1.0~3.0 越大校正越强；0 表示关闭
LED_BRIGHTNESS    = 30     # LED 补光亮度 0~100（0=灭，100=最亮）

# ---------------- 测量区（固定在图像坐标里，别跟着线跑） ----------------
# 为什么必须固定：相机有倾角，同一个真实航向角在画面不同行读出的斜率不同、跨整幅能差
# 20%~3 倍；测量区固定后这个增益退化成**一个常数**，一次标定就吸收干净 → 与远近无关。
# 布局：顶部一条带隔离出来只做色心取样，其余全宽 + 一直到画面最底都是测量区。
FRAME_W, FRAME_H = 320, 240
MEAS_X     = (50, 270)      # 采样列范围（全宽 → 基线 320px）
MEAS_Y     = (0, 240)     # 测量区上下界：顶部隔离带之下 → 画面最底
TOP_BAND_H = 60            # 顶部隔离带高度（只取远侧色心，不参与找交界）
BOT_BAND_H = 35            # 底部色心带高度（贴画面最底取近侧色心）
NCOL       = 8             # 采样列数
COL_W      = 9             # 每列条带宽度(px)
STRIP      = 12            # 剖面的横条高度(px) → 每列 13 条

MARGIN_MIN = 5.0           # 两侧色心判别通道距离 < 此 → 测量区里没有交界 → valid=0。
                           #   练习图实测交界 32~40；标准赛道两面色差浅（margin 常
                           #   只有 ~10-20）；新场地（国赛图，任务U/V/T/P）黄区离补光
                           #   远时两面 a/b 色差只剩 ~6.5-9 —— 10 把 V/T 整段拒真
                           #   （0/198、0/245 全盲，2026-10-01 实测）。敢降到 5 的底气
                           #   = 第十六次的"边缘强度门"（EDGE_STEP_SHARP）：单材料帧
                           #   （全路/全黄）纵有光照渐变、没有材料边，8 列全灭仍判丢线，
                           #   不会因门槛放低而假有效。若见乱点吐噪声角度 → 先调
                           #   EDGE_STEP_SHARP 再看这里
CROSS_MIN_SWING_FRAC = 0.35 # 穿越处邻域(±2条=48行)总落差至少要到满程的这么多才认。
                           #   刻意不看"单步"：交界跨在两条分界上时会被劈成两小步，
                           #   卡单步会把真交界扔掉；远处那道弧/反光的假穿越总落差小。
                           #   0.5→0.35（标准赛道浅色差）：f 已过三点平滑（噪声↓~√3），
                           #   放宽真穿越门槛的同时对噪声反而更保守（0.35×1.7<0.5）
CROSS_SWING_DEPTH = 2      # 邻域取几条（2 → ±2 条）
EDGE_STEP_SHARP = 6.0      # 实体边判据（第十六次，2026-10-01）：相邻横条 (a,b) 的台阶
                           #   ‖Δ(a,b)‖ ≥ 此才算"材料边"。定标依据（任务U/V/T/P 帧实测）：
                           #   真边台阶 6.2~13.8（V#1 八列），光照渐变噪声 1~3，LED 热点
                           #   回卷台阶 5~10（靠方向对齐门挡，见 column_crossing 尾部）；
                           #   6.0 扫参定案（5.0 → 90.3%、7.0 → 87.3%、8.0 → 67.8%，
                           #   A~K+U/V/T/P 共 2403 帧，harness/score_local.py 口径）——
                           #   再抬会杀掉 A~K 场地较软的交界、再降会放进渐变噪声。
REFINE_ITERS = 3           # 局部参考细化的迭代次数（2026-09-29 第十三次）。局部参考
                           # 各取交界上下 2~3 条，两条参考间存在列内照度梯度
                           # （补光灯中心散开、越靠画面上部/左右边缘越暗），单次
                           # 细化残留下行偏差；迭代一次偏差约减半，3 次收敛
                           # （实测 ×3 与 ×6 结果全同）。任务F/H: off_mae 减半、
                           # off_max 29→13、ang_mae −44%
RANSAC_TOL_PX     = 8.5     # 离群剔除的**固定**门槛(px)≈0.7×STRIP。刻意不用 MAD/3σ
                           #   那种"从数据自己算"的门槛：8 列里塞 2 个离群点就能把它
                           #   撑大、门槛放宽，结果一个都剔不掉（实测过）。
                           #   10.0→8.5（2026-09-29 第十一次重做 r3）：8.5 才是注释
                           #   说的 0.7×STRIP（12）的本意；任务F 实测 6.45→6.04、
                           #   off_max 30→29、ang 2.57→2.49，六项全面改善，视频6/16
                           #   无真值回归不劣化（75%/96%）

# ---- 黑区掩码（2026-09-27 治"angle 被两边黑区极值带跳"）----
# 补光灯照不到的远端/边角 = 画面里的黑区：L 塌向 0 时 |a|,|b| 一起塌，黑条既不
# 属于任何一面，还会①把参考色染黑（判别面逐列歪）②在 黑↔亮 过渡上造假穿越 ——
# 这就是"极值"的来头。每列用亮度把暗条标出来：参考色只在亮条里取、连顶暗条串里
# 的穿越不认、整列黑的边列不采。判暗 = 低于绝对下限，或低于该列近端亮度（补光
# 正下、永远亮）的 DARK_FRAC 倍。误杀阴影像条（列数变少）→ DARK_FRAC 调小；
# 黑区漏判（极值还在）→ 调大。绝对下限可拿 'P' 拍的照片在 IDE 里读黑区 L 来定。
L_DARK_ABS = 10.0          # 暗条绝对亮度下限（固定曝光；黑区实测 L≈10~18）
DARK_FRAC  = 0.1           # 相对近端亮度的判暗比例
REF_GROW_STEP = 10.0       # 底参考区域生长色距门（2026-09-29 第十一次）：底参考从
                           # 最底亮条向上生长、与**最底那条**比 (a,b) 色距 ≤ 它才
                           # 收。防"上下参考落在同一面材料的明暗渐变两端"：渐变沿
                           # 程漂移，逐条比上一条会跟着漂；锚死最底亮条、超距即停，
                           # 参考带才贴得住实色。10.0 而非草稿的 6.0（重做实测）：
                           # 任务F 89-98 帧"贴底渐变"列的锚距实测 6.7~8.9，6.0 会
                           # 把底参考饿成 2 条 → 过零掉进渐变中点（行 ~176 vs 真值
                           # ~205），拟合角度偏平 4°+；10.0 仍挡材料跳变（单条色阶
                           # >10 才拒），防假有效由 REACQ 兜底（外观判据已证伪）

CHECK_BLACK   = False       # 黑线交叉验证（只在练习地图有意义，标准地图给 0 个点，无害）
BLACK_MAX_L   = 38         # 黑线亮度上限
BLACK_MIN_DIP = 3.0        # 要比左右相邻条都暗这么多才算黑线

# ---- 丢线分类（state 2/3/4）与曲线重拟合（state 1），2026-09-26 方案 ----
# 丢线为什么要分类：交界出画后只能吐 valid=0，树莓派分不清"往哪边丢的"，找线方向
# 只能死写。st 语义 = **车在哪面**：3=黄区侧(压黄区)、2=路面灰侧(压灰区)。
# 方向定律（2026-09-27 用户实测确认，与全部日志自洽）：压向黄区 ⇔ off 递增
# （边界行上升）；压向灰侧/离线入路内 ⇔ off 递减（边界行下降）。
# 判据（2026-09-27 用户定律·趋势版，第六次）：Δ = 丢线时冻结的 off − 直线基线，
#   跌落 = 往灰区塌陷 → 2；抬升 = 往黄区塌陷 → 3。基线在直线帧里慢跟踪（见下），
#   两个操作数丢线瞬间都冻结 → 判据整段丢线期**恒定**，构造上杜绝标签跳变
#   （前几版跳变根源 = 不同证据源在退化帧里轮流发言）。
# 备胎（基线还没有 / |Δ| 在门内 = 突然丢）：① ≥2 个零星交界点的中位行
#   （FAR_ROW/NEAR_ROW，单点不算——骑线帧孤点会带偏）→ ③ 两带颜色对参考色投票
#   （同面才认；一黄一灰 = 交界还在画面里分不出）→ ④ 4（保持，交回树莓派旧策略）。
#   ⚠️ 已删"卡全灰默认报 2"兜底：它把颜色认不出的全黄帧错标成灰（第五次翻车根因）。
# 参考色只在交界行位于窗口中部（REF_SAFE_ROW [70,195]）的健康帧里刷新 —— 边界
# 行贴带时对应带已被另一面吃进，刷了会把参考污染成对面。蓝/粉出发终止区在路侧：
# 核心测量不挑路面颜色，参考色过区短暂自适应再跟回，无需特判。颜色只比 a/b 不比
# L、不用绝对阈值（换图两面色度位置会变——参考色机制=每帧自动学当前场地两面）。
LOST_EMA        = 0.25     # 参考色 EMA 系数（新帧占比）
LOST_CLASS_GATE = 25.0     # 色心到参考的 (a,b) 距离超过它 = 这个带"哪面都不像" → 不投票
FAR_ROW  = 155             # ①点票阈值（备胎，基线还没有时才用）: 行 < 它 = 灰侧 → 2
NEAR_ROW = 175             #   行 > 它 = 黄侧 → 3；155~175 不算证据
ROW_VOTE_BAND = 70.0       # 点票行连续门（第十五次，2026-10-01）：零星点票的中位行
                           # 必须与丢线前边界行（last_row_ctrl）相差不超过它，否则不
                           # 作行证据。D 59-64 实测：LED 过曝雾带上 2 个假穿越行 ~100，
                           # 真边界在 ~215，假点把行票带偏成"灰"（压黄报成压灰，方向
                           # 标反比"不明"更危险）。丢线前行位置未知（冷启动）时不设闸。
# ---- ②主判据（2026-09-27 用户定律·趋势版）：Δ = 丢线时冻结的 off − 直线基线 ----
#   跌落(Δ<0) = 往灰区塌陷 → 2；抬升(Δ>0) = 往黄区塌陷 → 3；|Δ| 小 = 突然丢 → 4。
#   基线 = 直线帧里慢速跟踪的 offset：自动对准实际工作点（如树莓派 SETPOINT=+20），
#   偏出 BASE_GATE 即冻结（慢速压线不会把基线拖走）。两个操作数在丢线瞬间都冻结
#   → 判据在整段丢线期内**恒定**，从构造上杜绝不同证据源轮流发言导致的标签跳变。
BASE_GATE  = 15.0          # 基线跟踪门：|off−基线| 超过它的帧不回灌基线
BASE_RATE  = 0.15          # 基线 EMA 系数（慢速跟踪）
DELTA_GATE = 15.0          # 方向判据门：|Δ| 超过它才判方向；干净实测丢线 |Δ|≥40+，余量足
REF_SAFE_ROW = (70.0, 195.0)  # 交界行在此区间内的有效帧才刷新参考色/作时序兜底依据：
                              # 行 ≥70 上带才纯一面；行 ≤195 下带才纯另一面
# ---- REACQ 重锁点级过滤（2026-09-29 第十一次，治"假有效"根因1，唯一实测成立的方向）----
# 丢线出画方向已知（st=3 从底出/st=2 从顶出，Δ 判据整段恒定）时，重新锁定必须落在
# **入边半场**：真交界回画必从出画那侧进来，而"明暗渐变假线"全落在中段（任务F 假点
# rows 122~155）。丢线期先把候选点滤到入边半场**再**拟合 —— 必须点级，帧级已实测
# 死锁（假线与真边界并存时 RANSAC 选假线→行不符被拒→永远重锁不上，29 帧全盲）。
# 拟合成功即自然解锁。熔断（第十二次改）：每第 REACQ_GATE_FRAMES 个丢线帧才无
# 过滤**单帧重试**一次，重试锁到的线须落入边半场（row_ctrl 验收），否则拒绝并回
# 到过滤态 —— 旧版"到点永久放行"在任务P 实测被渐变假线钻空（压黄区超 8 帧后整段
# 假有效）。⚠️ 逐列外观判据已证伪，勿在此加材料阶/相对阈之类的闸（见头部记录）。
REACQ_ROW_MIN     = 175.0  # st=3（从底出画）重锁行下限：入边 = 窗口下部
REACQ_ROW_MAX     = 115.0  # st=2（从顶出画）重锁行上限：入边 = 窗口上部
REACQ_GATE_FRAMES = 8      # 丢线期无过滤重试的周期（每第这么多帧试一次）
REACQ_QA_NK       = 8      # Δ同侧验收的质量豁免门（第十五次，2026-10-01）：丢线满
REACQ_QA_RMS      = 3.0    # REACQ_GATE_FRAMES 后的再锁定，若内点 ≥REACQ_QA_NK 且
                           # RMS ≤REACQ_QA_RMS，则**豁免**同侧验收 —— 陈旧 Δ 方向
                           # 不再一票否决高质量拟合。依据（A 114-134 逐帧实测）：
                           # 边界在窗内扫掠回中时拟合 nk7-8 / rms1.5-2.8，真边界
                           # 的 off 已越过基线到另一侧，同侧验收把它整段拒成 21 帧
                           # 盲 + 标签错向。门取 8 不取 7：A 56-57/107-108 的过曝
                           # 雾区褶皱阴影边（压黄期假有效，纯 L 边无色度差）nk 恰为
                           # 7，取 8 全挡；真重锁 8 列里总有 nk=8 帧、一帧解锁即断链。
                           # ⚠️ 任务P 的同材渐变假线质量未复测（任务不在本仓库）；
                           # 若上车再见 P 型假有效，先收紧 REACQ_QA_RMS。
CURVE_RMS_PX = 6.5         # 出量拟合残差 RMS 超它 → 判为曲线/路口（state 1），改用
                           # 近半段（靠车一侧）内点重拟合。直线帧 RMS 仅 1~2px，此分支
                           # 不进，对正常巡线零扰动。5.0→6.5（2026-09-29 第十一次：
                           # 任务F 逐帧真值里没有任何 state=1 帧，5.0 会把交界略斜的
                           # 直线帧误判成弧）

USE_BLACK_PRIMARY = True   # 出量优先用黑线拟合(fb)：练习图上黑条中心是最锐利、对
                           #   阴影/参考色漂移最不敏感的特征，静止实测其角度抖动比
                           #   色边小 5~10 倍。标准地图 0 个黑线点 → 自动回落色边(fa)
BLACK_RMS_MAX    = 6.0     # 黑线拟合 RMS 超过此(px)视为不可信（双带/断条），回落色边
FILT_MED_N       = 1       # 出量中数滤波窗口（最近 N 个有效帧的中数）；1=关（默认关）。
                           #   ⚠️ 实测别开：静止日志里的跳变是"双稳态翻动"（-9↔-13 两群
                           #   交替出现几帧），不是孤立尖刺 —— 中数会把翻动整步搬过去。
                           #   40 帧日志仿真(0.1°单位)：配 EMA 后 std 2.29→1.89，反而
                           #   不如纯 EMA 的 1.64。它只治"单帧尖刺"型场景
FILT_EMA_A       = 0.5     # 出量 EMA 系数；1.0=关。约 1~2 帧滞后（14fps ≈ 70~140ms），
                           #   换 std −28%、最大台阶 9→4（0.1° 单位）；嫌钝就调大 A
FILT_FAST_GATE   = 5.0     # 出量门控 EMA 的门（2026-09-29 第十一次）：两轴各自判
                           #   |新值−滤波值| —— 门内是噪声/内点集翻动（慢平滑压住，
                           #   FILT_EMA_A），门外是真运动/重锁（快跟防拖影）。检验
                           #   只看 /compare 残差 std（jit_bad），勿用 MAE。
                           #   5.0 而非草稿的 12.0（重做 r2~r5 实测）：任务F off 轴
                           #   门=12 时 MAE 6.90，6 → 6.45，5（配 TOL=8.5）→ 6.04；
                           #   门再小（3）慢平滑分支几乎不再触发，门控机制名存实亡
FILT_EMA_A_FAST  = 0.9     # 门外快跟系数（1.0 = 门外直通）
ANG_MED_N        = 5       # 角度中位数窗口（第十八次，2026-10-06）：B1~B4 静态场景
                           # 实测角度帧间步是"主流态 + 单帧凹陷"的双稳态翻动（如
                           # 视频23 #65-73：4.5↔2.7 两态逐帧交替），中位数把凹陷
                           # 整段剔除。B 视频（视频21~24）实测：静态步超 0.3° 占比
                           # 42/41/45/35% → 13/5/14/4%，p95 0.9/0.2/0.9/0.3°，
                           # median 0.1/0.0/0.1/0.0°。⚠️ 必须配 ANG_MED_OFF_GATE
                           # 自适应：真转弯任务（A/E/I/J）无条件 med5 会 +0.3~0.7°
                           # angMAE（中位数在持续坡上滞后 2 帧）
ANG_MED_OFF_GATE = 6.0     # |raw_off − filt_o| ≤ 它 = off 静止 → 角度用满窗口中位
                           # 数；off 在动 = 真机动（转弯时 off 必然大幅移动），窗口
                           # 退化为 1 直通、零滞后。off 轴噪声小（全任务 off_max
                           # ≤37），做运动检测器比角度自身可靠（慢转弯 off 步小而
                           # 角度步大——杆臂效应，角度自己判会把自己当真运动）
ANG_RATE_MAX     = 5.0     # 角度输出限速（°/帧，第十五次）：真实转弯率实测上限
                           # ~3.8°/帧（H/F 真值坡），超过它的帧间变化只可能是拟合
                           # 分支翻动/假锁/弓形弦切切换（K#59 一帧 -17.5°、I#163
                           # +12.1°）—— 硬限到它。与被证伪的角度 EMA 本质不同：限速
                           # 在真实运动包络内**完全透明**（真坡不削、无滞后），只削
                           # 孤立尖刺。5.0 扫参定案（4.5 更平但 angMAE +0.02 滞后、
                           # 6.0 尖刺残留大）。off 轴不加（扫掠期真实 off 台阶 ~30/帧）

DRAW = False                # 画标记（调试看每列十字用）。独立跑想省几 ms 可关掉
PRINT_EVERY_S = 1.0        # 终端打印限速（原来每帧打，16fps 没人看得过来还占 USB）

# ---------------- 控制参数 ----------------
CTRL_X = FRAME_W // 2      # 控制列：offset 在这个 x 上求值（= 画面中心列）
TARGET_OFFSET = 44.0       # 目标横向偏移（相对画面中线=第120行，像素）。
                           # 44 → 目标交界行 = 164：2026-09-13 在实际场地把车摆正时
                           #   angle_test.py 读到的 行@160=164（六帧一致），故取 44。
                           # 想让车离交界更远 → 调小（目标交界在画面里更靠上）。
                           # ⚠️ 2026-09-25 换距离剖面后交界行定义挪了 ~3-5px（落在黑条
                           #   蓝色一侧的边缘），摆正时 offset 会系统性偏 +3~4，
                           #   上车按 angle_test.py 流程重校一次（预计 44 → 47 左右）。
ERR_GAIN = 200             # 误差映射系数：满偏(±半幅)对应 ±100（沿用旧版，Pi 侧不改）

# ---------------- 串口（双向：收控制字节 + 发文本帧） ----------------
# （uart 对象已在文件头创建 —— 必须赶在传感器初始化之前, 否则上电头 1~2s 的 'G' 会丢,
#   见文件头那段的注释。这里只留开关状态。）
# 按需发送开关：默认不发，等树莓派写 'G' 才开始，写 'S' 停止。
# 树莓派端巡线命令("2")触发 'G'，停止命令("3")/超时/断线触发 'S'。
SENDING = False

# ---------------- LED 补光（P6，PWM，常亮） ----------------
led = PWM(Pin("P6"), freq=1000, duty_u16=0)
led.duty_u16(int(LED_BRIGHTNESS / 100 * 65535))   # 按 LED_BRIGHTNESS 固定亮度

# 派生几何
WIN_X  = MEAS_X
WIN_Y  = MEAS_Y
NSTRIP = int((WIN_Y[1] - WIN_Y[0]) // STRIP)      # 13
TOP_BAND = (MEAS_X[0], 0, MEAS_X[1] - MEAS_X[0], TOP_BAND_H)
BOT_BAND = (MEAS_X[0], FRAME_H - BOT_BAND_H, MEAS_X[1] - MEAS_X[0], BOT_BAND_H)
NEAR_HALF_ROW = (WIN_Y[0] + WIN_Y[1]) / 2.0   # 曲线重拟合的"近半段"分界 = 测量窗中线
                                              # （窗下半 = 靠车这侧 = 车马上要进的路段）


# ==================== 测量核心 ====================
# 思路：逐列把测量区切成横条，用 get_statistics 取每条的 (a,b,L) **均值**，算各条到
# 该列"上/下参考色"的距离²之差 f，找 f 过零的那一行（相邻条线性插值），再对 8 个点
# 做抗离群拟合。2026-09-25 前是"单判别通道穿过两侧色心中点"，弃用原因见主循环第 3 步。
# 这里的 API 都是本机实测通过的：snapshot / lens_corr / get_statistics / draw_*
# （find_blobs 在这台机器上报 can't convert tuple to int，形态未定，故不用它）


def sval(st, *names):
    """按顺序找第一个存在的统计字段；OpenMV 5.0 里是属性、4.x 里是方法 —— 两种都吃。"""
    for nm in names:
        try:
            v = getattr(st, nm)
            return v() if callable(v) else v
        except Exception:
            pass
    raise Exception("统计字段都没有: %s" % (names,))


def lsq(pts):
    """最小二乘。线接近水平，row 当因变量才良态。返回 (斜率, 截距, 残差RMS)。"""
    n = len(pts)
    sx = sum(p[0] for p in pts)
    sy = sum(p[1] for p in pts)
    sxx = sum(p[0] * p[0] for p in pts)
    sxy = sum(p[0] * p[1] for p in pts)
    d = n * sxx - sx * sx
    if d == 0:
        return None
    m = (n * sxy - sx * sy) / d
    c = (sy * sxx - sx * sxy) / d
    e = math.sqrt(sum((p[1] - (m * p[0] + c)) ** 2 for p in pts) / n)
    return m, c, e


def smooth3(v):
    """三点滑动平均（首尾各取两点平均）。**标准赛道浅色差专用（2026-09-27 第九次）**：
    两面色差浅时，条均值的色度噪声和两面色差同量级，f 剖面会被噪声揉出假过零、
    或让真过零位置逐帧抖动。单调过渡的过零位置不受此平滑偏置（线性斜坡的零点
    不动），白噪声方差 ↓~3 倍 —— 信噪比净赚。只作用于找穿越的判别量，不动参考
    色、不动出量。"""
    n = len(v)
    if n < 3:
        return v[:]
    out = [0.0] * n
    out[0] = (v[0] + v[1]) / 2.0
    out[n - 1] = (v[n - 2] + v[n - 1]) / 2.0
    for j in range(1, n - 1):
        out[j] = (v[j - 1] + v[j] + v[j + 1]) / 3.0
    return out


def col_profile(img, x):
    """该列的纵向剖面: [(行中心, a均值, b均值, L均值), ...]，从上到下。
    a、b 都要：判别在调用侧用"到上下参考色的距离²之差"做（见主循环第 3 步）——
    固定曝光下阴影会把单通道和黑条一起压向 0，单通道分不开"阴影边"和"真边界"。
    用 mean 不用 median：穿过交界那条横条里 median 会偏向多数那一侧，交点会"跳格"。"""
    out = []
    x0 = x - COL_W // 2
    for j in range(NSTRIP):
        y0 = WIN_Y[0] + j * STRIP
        st = img.get_statistics(roi=(x0, y0, COL_W, STRIP))
        out.append((y0 + STRIP / 2.0,
                    sval(st, 'a_mean', 'a_median'),
                    sval(st, 'b_mean', 'b_median'),
                    sval(st, 'l_mean', 'l_median')))
    return out


def cross_row(prof, mid, min_swing, dead=None):
    """找剖面穿过 mid 的那一行（主循环喂的是"到上下参考色距离²之差 f"，mid=0）。
    一列里可能穿越多次（远处那道弧、反光、褶皱阴影边），
    取**邻域总落差最大**的那一次 —— 真正的材质交界落差最大。
    落差不足 min_swing 的一律不认（宁可这一列没点，也别塞个假的）。
    dead=连顶黑区掩码（True 的条在"从窗口顶连下来的暗条串"里，补光死角本体）：
    贴着它的穿越是 黑↔亮 过渡、不是材质交界 —— 两边黑区极值的源头，一律不认。
    练习图的黑线是悬在亮区里的 1~2 条、不连顶，不受此规则影响。"""
    best_row, best_swing = None, 0.0
    n = len(prof)
    for j in range(n - 1):
        if dead is not None and (dead[j] or dead[j + 1]):
            continue
        b0, b1 = prof[j][1], prof[j + 1][1]
        if (b0 - mid) * (b1 - mid) <= 0 and abs(b1 - b0) > 1e-6:
            seg = [prof[k][1] for k in range(max(0, j - CROSS_SWING_DEPTH),
                                             min(n, j + 2 + CROSS_SWING_DEPTH))]
            swing = max(seg) - min(seg)
            if swing > best_swing:
                best_swing = swing
                best_row = prof[j][0] + (mid - b0) / (b1 - b0) * STRIP
    if best_row is None or best_swing < min_swing:
        return None
    return best_row


def refine_local(prof, r0, dark=None, dead=None):
    """第二遍细化：用粗定位行 r0 两侧近处的条带做局部参考色，重算穿越行。
    为什么：顶/底参考取自画面最上/最下，会被"远端阴影"(顶部)和"LED 过曝"(底部)
    逐列污染 —— 结果.bmp 帧：底部参考 b 从 -10(过曝中心) 漂到 -37(边缘饱和)，
    顶部参考吃进左上阴影。距离剖面的过零点在宽黑带里的高度由 |上参考|/|下参考|
    的比值决定，比值逐列变 → 过零点排成 ±15px 的拱形(旧法新法同病，实测同帧
    逐列差 ≤0.5px)。换成交界两侧近处的参考(同帧同光照，各列一致)，过零点锚定
    在黑带附近的同一相对位置 → 拱形消失；绝对位置的整体平移由 TARGET_OFFSET 吸收。
    只用已采样的 prof，不加 get_statistics，不掉 fps。
    隔 1 条、取 2 条(j0±2,±3)：黑带约 1~2 条厚，参考必须落在带外的实色上；
    粗定位拱形 ≤±2 条时参考仍落在正确一侧。
    dark/dead（2026-09-27）：暗条不进局部参考（色度已死，进去就把参考染黑）；
    连顶黑区里的穿越按 cross_row 同一规则不认。局部参考被暗条滤到不足 2 条 →
    返回 None，保留粗定位行。"""
    j0 = int((r0 - WIN_Y[0]) / STRIP)
    def mean2(js):
        js = [j for j in js
              if 0 <= j < NSTRIP and not (dark is not None and dark[j])]
        if len(js) < 2:
            return None
        return (sum(prof[j][1] for j in js) / len(js),
                sum(prof[j][2] for j in js) / len(js))
    t = mean2([j0 - 3, j0 - 2])
    b = mean2([j0 + 2, j0 + 3])
    if t is None or b is None:
        return None
    ta, tb = t
    ba, bb = b
    d2 = (ba - ta) ** 2 + (bb - tb) ** 2
    if d2 < 1.0:
        return None
    lo = max(0, j0 - 3)
    hi = min(NSTRIP, j0 + 4)
    vals = [((prof[j][1] - ta) ** 2 + (prof[j][2] - tb) ** 2)
            - ((prof[j][1] - ba) ** 2 + (prof[j][2] - bb) ** 2)
            for j in range(lo, hi)]
    sv = smooth3(vals)                    # 与粗定位同一套平滑（浅色差，见 smooth3）
    sub = [(prof[lo + k][0], sv[k]) for k in range(len(sv))]
    sub_dead = [dead[j] for j in range(lo, hi)] if dead is not None else None
    return cross_row(sub, 0.0, CROSS_MIN_SWING_FRAC * 2.0 * d2, sub_dead)


def _five_ok(inl):
    """5 点候选的额外验收（2026-09-29 第十一次）：内点 x 跨度 ≥90px 且 RMS ≤4.0。
    候选下限 6→5 是为救"假丢线"帧（任务F 90-97 帧：5 个真点跨 160px、离真值
    2~7px，被 n≥6 硬门整帧拒掉）；但 n≥6 当年挡的"5 点凑垃圾线"（实测能差 8.6°）
    得有新闸 —— 跨度防"挤在一小段"、RMS 防"散点连线"。只影响 5 点候选帧，
    ≥6 点路径与旧版完全一致。
    跨度 120→90（第十五次，2026-10-01）：MEAS_X 收窄为 (50,270) 后 8 列全跨只有
    193px，120 的相对严度大增 —— 任务B 124-135 帧真边界贴底只活 5 列（跨 110px、
    近共线 RMS~1.5）被硬杀成丢线。90 ≈ 全跨的一半，仍挡"挤在一小段"。"""
    xs = [p[0] for p in inl]
    if max(xs) - min(xs) < 90.0:
        return False
    f = lsq(inl)
    return f is not None and f[2] <= 4.0


def robust_fit(pts):
    """抗离群拟合：穷举 RANSAC —— 所有点对连成线，取"内点数最多"的那条，
    再用内点做 LSQ 精修、并按同一门槛复筛一次。8 列只有 28 对，开销可忽略。
    返回 (斜率, 截距, RMS, 保留点数, 剔除点数)；点数不够返回 None。
    候选下限 6→5（2026-09-29 第十一次）：5 点候选须另过 _five_ok 双闸。"""
    n = len(pts)
    if n < 5:                      # 6→5：救"5 真点"帧；垃圾线风险由 _five_ok 挡
        return None
    best = None
    for i in range(n - 1):
        for k in range(i + 1, n):
            dx = pts[k][0] - pts[i][0]
            if dx == 0:
                continue
            m = (pts[k][1] - pts[i][1]) / float(dx)
            c = pts[i][1] - m * pts[i][0]
            inl = [p for p in pts if abs(p[1] - (m * p[0] + c)) <= RANSAC_TOL_PX]
            if best is None or len(inl) > len(best):
                best = inl
    if best is None or len(best) < 5:
        return None
    if len(best) == 5 and not _five_ok(best):
        return None
    f = lsq(best)
    if f is None:
        return None
    m2, c2 = f[0], f[1]
    inl2 = [p for p in pts if abs(p[1] - (m2 * p[0] + c2)) <= RANSAC_TOL_PX]
    if len(inl2) >= 5:
        if len(inl2) > 5 or _five_ok(inl2):
            f2 = lsq(inl2)
            if f2 is not None:
                return f2[0], f2[1], f2[2], len(inl2), n - len(inl2)
    return f[0], f[1], f[2], len(best), n - len(best)


QUAD_RMS_MAX = 2.0         # 抛物线兜底拟合的质量门(px)（第十五次）：J 143-149 等帧的
                           # 散点是"两跳边之间来回跳"的垃圾，硬拟抛物线 RMS 5~17、
                           # 角度能喷 ±50°；实测 J#145 的 5 内点假抛物线也有 2.45 ——
                           # 真弓形帧（K#58/B#128）RMS ≈1.0，门取 2.0 挡垃圾保真弓


def quad_fit_line(pts):
    """抛物线兜底（第十五次，2026-10-01）：直线 RANSAC 失败但 ≥5 点时的二次拟合。
    背景（任务K/I 实测）：远侧边界在画面里本来就带弓（透视+镜头畸变+真弯），8 列
    穿越排成 U 形 —— 直线怎么拟都不达标 → 整帧丢线，Δ 冻结还把方向标错（K 58-112
    连续 55 帧假丢线）。弓形帧 GT 仍标直线(0)、off 取标注线在控制列的值，抛物线在
    控制列的值与它吻合（K#58 实测 off 误差 0、B#128 误差 2）。
    做法：3 点采样穷举 RANSAC（门槛同 robust_fit），内点 ≥5 且 x 跨度 ≥90 且
    RMS ≤ QUAD_RMS_MAX 才认；角度取**近半段**内点的直线斜率（航向跟近段切线，
    与 CURVE_RMS_PX 分支同一哲学 —— U 形在中部的切线≠两端弦，K#58 顶点导数 ~0°
    而近半段斜率 18.6° 与真值 17.5° 吻合），近半段不足 2 点时退回顶点导数。
    返回与 robust_fit 同构的"虚拟直线" (m, c, rms, nk, nd)：c 平移到过
    (CTRL_X, q(CTRL_X))，下游出量/曲线判别/REACQ 验收全部照旧工作。"""
    n = len(pts)
    if n < 5:
        return None
    best = None
    for i in range(n - 2):
        for k in range(i + 1, n - 1):
            for j in range(k + 1, n):
                x1, y1 = pts[i]
                x2, y2 = pts[k]
                x3, y3 = pts[j]
                if x3 == x1:
                    continue
                f12 = (y2 - y1) / float(x2 - x1) if x2 != x1 else 0.0
                f23 = (y3 - y2) / float(x3 - x2) if x3 != x2 else 0.0
                a = (f23 - f12) / (x3 - x1)
                b = f12 - a * (x1 + x2)
                c = y1 - a * x1 * x1 - b * x1
                inl = [p for p in pts
                       if abs(p[1] - (a * p[0] * p[0] + b * p[0] + c)) <= RANSAC_TOL_PX]
                if best is None or len(inl) > len(best):
                    best = inl
    if best is None or len(best) < 5:
        return None
    xs = [p[0] for p in best]
    if max(xs) - min(xs) < 90.0:
        return None
    # 内点 LSQ 精修（3x3 正规方程，克莱姆法则，n≤8 手算开销可忽略）
    sx = sum(p[0] for p in best); sxx = sum(p[0] * p[0] for p in best)
    sxxx = sum(p[0] ** 3 for p in best); sxxxx = sum(p[0] ** 4 for p in best)
    sy = sum(p[1] for p in best); sxy = sum(p[0] * p[1] for p in best)
    sxxy = sum(p[0] * p[0] * p[1] for p in best)
    A = [[len(best), sx, sxx], [sx, sxx, sxxx], [sxx, sxxx, sxxxx]]
    B = [sy, sxy, sxxy]

    def det3(m):
        return (m[0][0] * (m[1][1] * m[2][2] - m[1][2] * m[2][1])
                - m[0][1] * (m[1][0] * m[2][2] - m[1][2] * m[2][0])
                + m[0][2] * (m[1][0] * m[2][1] - m[1][1] * m[2][0]))
    D = det3(A)
    if abs(D) < 1e-9:
        return None
    A1 = [[B[0], A[0][1], A[0][2]], [B[1], A[1][1], A[1][2]], [B[2], A[2][1], A[2][2]]]
    A2 = [[A[0][0], B[0], A[0][2]], [A[1][0], B[1], A[1][2]], [A[2][0], B[2], A[2][2]]]
    A3 = [[A[0][0], A[0][1], B[0]], [A[1][0], A[1][1], B[1]], [A[2][0], A[2][1], B[2]]]
    c = det3(A1) / D
    b = det3(A2) / D
    a = det3(A3) / D
    e = math.sqrt(sum((p[1] - (a * p[0] * p[0] + b * p[0] + c)) ** 2 for p in best) / len(best))
    if e > QUAD_RMS_MAX:
        return None
    near = [p for p in best if p[1] > NEAR_HALF_ROW]
    m = None
    if len(near) >= 2:
        f = lsq(near)
        if f is not None:
            m = f[0]
    if m is None:
        m = 2.0 * a * CTRL_X + b        # 顶点导数兜底
    row_c = a * CTRL_X * CTRL_X + b * CTRL_X + c
    return m, row_c - m * CTRL_X, e, len(best), n - len(best)


def black_row(prof, near):
    """色阶行附近 ±3 条里找 L 最小的那条（练习地图的黑线），抛物线插值取行。"""
    k = int((near - WIN_Y[0]) / STRIP)
    lo, hi = max(0, k - 3), min(len(prof), k + 4)
    bi, best = None, None
    for j in range(lo, hi):
        if best is None or prof[j][3] < best:   # 剖面改成 (y,a,b,L) 四元组，L 在第 3 列
            best, bi = prof[j][3], j
    if bi is None or best > BLACK_MAX_L:
        return None
    if 0 < bi < len(prof) - 1:
        l, c, r = prof[bi - 1][3], prof[bi][3], prof[bi + 1][3]
        if c > l - BLACK_MIN_DIP or c > r - BLACK_MIN_DIP:
            return None                      # 不够"暗下去"→ 不是黑线
        d = l - 2 * c + r
        if d > 0:
            off = 0.5 * (l - r) / d
            if -1.0 <= off <= 1.0:
                return prof[bi][0] + off * STRIP
    return prof[bi][0]


def column_crossing(prof, margin):
    """单列完整裁决（2026-09-29 第十一次抽成纯函数）—— 主循环/回放器/平台三方调用
    同一份：此前 Replay.step 手工复刻第 3 步，第八/十次机制漏同步，离线结论不再代表
    相机（RECOVERY_NOTE.md 根因4）。步骤 = 亮度掩码 → 亮条参考色 → f 距离剖面
    （smooth3）→ cross_row → refine_local → 穿越合法域闸。
    prof: col_profile 剖面 [(行中心, a, b, L), ...]；margin: 全局两侧色心距（落差闸
    的满程下限）。返回 (row, ta, tb, ba, bb)：
      整体 None      亮条凑不齐 = 整列在补光死角里，不采；
      row=None       该列无合法穿越（参考色照常返回，供全局中位数覆盖用）。
    亮度掩码（第八次）：补光死角 L 塌向 0 时 |a|,|b| 一起塌 —— 黑条会染黑参考色、
    黑↔亮过渡会造假穿越。判暗 = L < max(L_DARK_ABS, DARK_FRAC×近端亮度)；从窗口顶
    连下来的暗条串（dead）里的穿越一律不认。顶参考 = 从上往下前 2 条亮条（整列搜，
    3→2 给贴黑区下缘的薄亮带真交界留空间；黑区深达 ~100 行时死写窗口会一列全丢）。
    底参考 = 从最底亮条向上**区域生长**（第十一次）：与最底那条比 (a,b) 色距
    ≤ REF_GROW_STEP 才收、超距即停 —— 渐变沿程漂移，锚死最底亮条参考带才贴得住实色。
    合法域闸（第十次立、第十一次改）：
      A = 穿越必须落在顶参考带之下（row ≥ top_lim；带内 = 上下是同一条渐变）。
          ⚠️ 旧 bot_lim（穿越不得低于底参考带）已删 —— 任务F 22-24/31-34 帧"贴底
          交界"被它连真带假全杀；带内防假改由底参考生长保住。
      B = 带间 f 不得回翻错侧超满程 15%（真两面在穿越两侧饱和，渐变一路漂移必回翻）。"""
    n = len(prof)
    l_near = (prof[-1][3] + prof[-2][3] + prof[-3][3]) / 3.0
    thr = max(L_DARK_ABS, DARK_FRAC * l_near)
    dark = [p[3] < thr for p in prof]
    ndead = 0                           # 从窗口顶连下来的暗条数（黑区本体）
    for dd in dark:
        if not dd:
            break
        ndead += 1
    dead = [j < ndead for j in range(n)]
    tj = [j for j in range(n) if not dark[j]][:2]
    bj = []
    for j in range(n - 1, n - 9, -1):   # 底部 9 条窗口（与旧版同）
        if len(bj) >= 3:
            break
        if dark[j]:
            continue
        if not bj:
            bj.append(j)                # 锚 = 最底亮条
            continue
        if ((prof[j][1] - prof[bj[0]][1]) ** 2
                + (prof[j][2] - prof[bj[0]][2]) ** 2) > REF_GROW_STEP * REF_GROW_STEP:
            break                       # 渐变漂出锚条色距 → 生长到头
        bj.append(j)
    if len(tj) < 2 or len(bj) < 2:
        return None
    ta = sum(prof[j][1] for j in tj) / len(tj)
    tb = sum(prof[j][2] for j in tj) / len(tj)
    ba = sum(prof[j][1] for j in bj) / len(bj)
    bb = sum(prof[j][2] for j in bj) / len(bj)
    da, db = ba - ta, bb - tb
    d2 = da * da + db * db              # 该列两侧参考色距离² ≈ f 满程的一半
    f = [((p[1] - ta) ** 2 + (p[2] - tb) ** 2)
         - ((p[1] - ba) ** 2 + (p[2] - bb) ** 2) for p in prof]
    fs = smooth3(f)                     # 浅色差：先平滑再找过零（见 smooth3）
    # 落差闸满程估计 = max(2×该列参考距², margin²)：margin² 是绝对下限，整列都在
    # 一侧时 d2 会很小，不能被噪声糊过去；只当保守一半用（真实满程 ≥ 2×margin²），
    # 直接当满程会把 LED 热点列（参考距偏小）的好点误杀（uuu.bmp 实测差 8%）
    row = cross_row([(prof[j][0], fs[j]) for j in range(n)], 0.0,
                    CROSS_MIN_SWING_FRAC * max(2.0 * d2, margin * margin), dead)
    # 第二遍：局部参考色细化（见 refine_local）。粗定位失败（阴影边假点）的列不救；
    # 这里只修"真交界上的过零点被参考色横漂带拱"。第十三次起**迭代收敛**：局部
    # 参考的照度差随迭代减半、偏差几何收敛，3 次即到不动点（见 REFINE_ITERS 注释）
    # —— 单次细化会把过零留在列内照度梯度的中点（暗列尤其狠：补光中心散开，
    # 边缘列的暗路面"看起来像顶参考"，过零被往下推几十 px）。
    for _ in range(REFINE_ITERS):
        if row is None:
            break
        r2 = refine_local(prof, row, dark, dead)
        if r2 is None or abs(r2 - row) < 1.0:
            if r2 is not None:
                row = r2
            break
        row = r2
    if row is not None:
        top_lim = WIN_Y[0] + (tj[-1] + 1) * STRIP
        bad = row < top_lim             # 闸A：穿越不得落进顶参考带（只留顶侧）
        if not bad:
            eps = 0.3 * d2              # 满程 2·d2 的 15%
            for j in range(tj[-1] + 1, min(bj)):
                if dead[j] or abs(prof[j][0] - row) < 0.75 * STRIP:
                    continue            # 黑区条不判；穿越 ±1 条是过渡带不判
                if ((prof[j][0] < row and fs[j] > eps)
                        or (prof[j][0] > row and fs[j] < -eps)):
                    bad = True          # 闸B：带间回翻错侧 → 渐变假穿越
                    break
        if bad:
            row = None
    # ---- 渐变重锚定 + 边缘强度门（第十六次，2026-10-01）----
    # 背景（新场地视频任务U/V/T/P 全标注闭环实测，评分 harness/score_local.py）：
    #   ① 黄区远离补光时两面 a/b 色差塌到 ~6.5-9 → 旧 MARGIN_MIN=10 整段拒真
    #     （V/T 全盲 0/245、0/198）；
    #   ② 交界埋在长亮度/色度渐变里时，f 的过零点 = 渐变中点，系统性偏高真边
    #     30~60px（V#2 col63 实测：f 过零在行 119、f 的最大台阶 325→639 在真值
    #     152 处）；refine_local 的局部参考在局部线性段上的不动点也在坡中，救不回；
    #   ③ U#83-90 型假丢线同根：接缝 2~3 条厚，各列过零在缝内的位置不一致 →
    #     拟合散掉 → 假丢线还被 Δ 误标方向。
    # 治法 = 色度台阶剖面 stepv[j] = ‖Δ(a,b)‖（相邻横条）：
    #   ① 零点已踩在台阶 ≥EDGE_STEP_SHARP 的实体边上 → 一切照旧（A~K 锐边场地
    #     零改动，这是回归不退的根基）；
    #   ② 否则在合法域（顶参考带之下 ~ 底参考带之上）找"方向对齐"的最大台阶
    #     重锚定（抛物线取亚条精度）：真边界必从上表面色走向下表面色，即
    #     Δ(a,b) 与 (下参考−上参考) 点积 > 0 —— LED 热点在单材料内的回卷台阶
    #     （b 先降后升）方向相反，被此门挡掉（V#1 col63 实测：热点台阶 8.0 反向、
    #     真边 6.2 正向，不加方向门 argmax 会锁到热点）；
    #   ③ 合法域内没有对齐实体边 → 整列不采。这一刀同时是 MARGIN_MIN 降到 5 的
    #     安全阀：单材料帧（全路/全黄）纵有光照渐变、没有材料边，8 列全灭 →
    #     不会因 margin 门槛放低而假有效。
    #   被闸 A/B 杀掉零点的列也走 ②③（救援：V#1 col118/228 零点被杀、真边台阶
    #   11~14 全场最强，不救援就少两列点）。
    sa = [p[1] for p in prof]
    sb = [p[2] for p in prof]
    # ⚠️ MicroPython 的 math 没有 hypot —— 2026-10-02 现场翻车点：v3.1 用了它，
    #    逐列一进来就 AttributeError → 每帧 21.5ms 快速吐 L,0,0,0,4（46fps 全 0 盲），
    #    而错误信息走 print() 脱机不可见。CPython 语法检查查不出缺属性，离线改动
    #    上真机前注意避开非 MicroPython 函数（hypot/dist/isfinite/fsum 等）。
    stepv = [math.sqrt((sa[j + 1] - sa[j]) ** 2 + (sb[j + 1] - sb[j]) ** 2)
             for j in range(n - 1)]
    j_lo = tj[-1]                       # 合法域下端 = 顶参考带之下（与闸A 同源）
    j_hi = min(bj[0], n - 2) - 1        # 合法域上端 = 底参考最上条之上
    if j_hi < j_lo or d2 < 1e-6:
        return None                     # 退化（参考带重叠/参考重合）：整列不采
    nvec = math.sqrt(d2)
    va, vb = (ba - ta) / nvec, (bb - tb) / nvec     # 上参考 → 下参考 的方向
    if row is not None:
        k = max(0, min(n - 2, int((row - (WIN_Y[0] + STRIP / 2.0)) / STRIP)))
        locs = [stepv[j] for j in (k - 1, k, k + 1) if j_lo <= j <= j_hi]
        if locs and max(locs) >= EDGE_STEP_SHARP:
            return (row, ta, tb, ba, bb)    # 零点已踩在实体边上，行为与旧版一致
    best_j, best_v = None, EDGE_STEP_SHARP  # （row=None 的列也走到这里 = 救援搜索）
    for j in range(j_lo, j_hi + 1):
        if dead[j] or dead[j + 1] or stepv[j] <= best_v:
            continue
        if (sa[j + 1] - sa[j]) * va + (sb[j + 1] - sb[j]) * vb <= 0.0:
            continue                    # 方向对齐门：反向台阶（热点回卷）不是边界
        best_v, best_j = stepv[j], j
    if best_j is None:
        return None                     # 合法域内无对齐实体边 = 单材料渐变列 → 不采
    r2 = (prof[best_j][0] + prof[best_j + 1][0]) / 2.0
    if 0 < best_j < n - 2:
        lft, ctr, rgt = stepv[best_j - 1], stepv[best_j], stepv[best_j + 1]
        den = lft - 2.0 * ctr + rgt
        if den < -1e-6:
            offq = 0.5 * (lft - rgt) / den
            if -1.0 <= offq <= 1.0:
                r2 += offq * STRIP / 2.0        # 抛物线亚条内插
    if r2 < WIN_Y[0] + (tj[-1] + 1) * STRIP:
        return None                     # 闸A 复查（重锚定点不得落进顶参考带）
    return (r2, ta, tb, ba, bb)


# ---------------- 丢线分类（state 2/3/4）：参考色 + 两级判据 ----------------
# 参考色只在**有效帧**里更新：上带色心 = 边界区那面，下带色心 = 路面那面（stage 1
# 已算好中位色心，EMA 跟住光照慢漂，单帧污染进不来）。丢线帧用它判"现在看到的是哪面"。
ref_bnd  = None             # (a, b) 边界区参考色（上带 EMA）；None = 还没见过有效帧
ref_road = None             # (a, b) 路面参考色（下带 EMA）


def ema_ref(old, new):
    if old is None:
        return new
    k = LOST_EMA
    return (old[0] + (new[0] - old[0]) * k, old[1] + (new[1] - old[1]) * k)


def chrom_d(p, r):
    da = p[0] - r[0]
    db = p[1] - r[1]
    return math.sqrt(da * da + db * db)


def classify_lost(pts, a_up, b_up, a_dn, b_dn):
    """丢线帧判"车往哪面塌陷" → 3（黄区侧/压黄区）/2（路面灰侧/压灰区）/4（说不清）。
    主判据（2026-09-27 用户定律·趋势版）：Δ = 丢线时冻结的 off − 直线基线：
      跌落（Δ < −DELTA_GATE）= 往灰区塌陷 → 2；抬升（Δ > +DELTA_GATE）= 往黄区
      塌陷 → 3；|Δ| 小 = 突然丢（路口/突变）→ 落到备胎证据。
    基线 = 直线帧里慢速跟踪的 offset（偏出 BASE_GATE 即冻结，不被慢速压线拖走；
    自动对准实际工作点，树莓派 SETPOINT 偏置/标定偏差都吸收）。**两个操作数在丢线
    瞬间都已冻结 → Δ 在整段丢线期内恒定** —— 前几版标签跳变的根源就是不同证据源
    在退化帧里轮流发言，此判据从构造上杜绝。
    备胎（基线还没有/|Δ|在门内时才用）：① ≥2 个零星点的中位行（FAR_ROW/NEAR_ROW，
    单点不算）→ ③ 两带颜色对参考色投票（同面才认）→ ④ 4（保持）。
    参考色只在交界居中 REF_SAFE_ROW 的健康帧里刷新（防污染，见主循环第 5 步）。
    树莓派恢复锚点：st=3（黄侧，off 相对基线抬升）→ 让 off 减小；st=2 → 让 off 增大。"""
    global lost_near
    lost_near = '?'
    # ---- ②主判据：Δ = 冻结的 off − 直线基线（整段丢线期恒定）----
    if base_off is not None and last_offset is not None:
        dlt = last_offset - base_off
        if dlt < -DELTA_GATE:
            lost_near = '灰'
            return 2
        if dlt > DELTA_GATE:
            lost_near = '黄'
            return 3
    # ---- ①备胎：零星交界点的行位置（基线还没有时用）----
    if pts is not None and len(pts) >= 2:
        rows = sorted(p[1] for p in pts)
        med = rows[len(rows) // 2]
        # 行连续门（第十五次，见 ROW_VOTE_BAND）：D 59-64 的过曝雾带假点（行~100，
        # 真边界 ~215）会把行票带偏成"灰"。中位行离丢线前边界行太远 = 假点证据，
        # 弃行票落到颜色票/④。丢线前行位置未知（冷启动）时不设闸。
        if last_row_ctrl is not None and abs(med - last_row_ctrl) > ROW_VOTE_BAND:
            med = None
        if med is not None:
            if med < FAR_ROW:               # 边界在画面上半 = 车往灰侧偏
                lost_near = '灰'
                return 2
            if med > NEAR_ROW:              # 下半 = 压向黄区
                lost_near = '黄'
                return 3
    # ---- ③备胎：两带颜色投票 ----
    if ref_bnd is not None and ref_road is not None:
        d_ut, d_ur = chrom_d((a_up, b_up), ref_bnd), chrom_d((a_up, b_up), ref_road)
        d_dt, d_dr = chrom_d((a_dn, b_dn), ref_bnd), chrom_d((a_dn, b_dn), ref_road)
        if (min(d_ut, d_ur) <= LOST_CLASS_GATE
                and min(d_dt, d_dr) <= LOST_CLASS_GATE):
            top_y = d_ut <= d_ur
            if top_y == (d_dt <= d_dr):
                lost_near = '黄' if top_y else '灰'
                return 3 if top_y else 2
    return 4                        # |Δ|在门内且备胎也没证据：突然丢，保持


# ---------------- 绘制：5.0 的 draw_* 要元组还是散参数，探一次就固定 ----------------
DRAW_STYLE = None


def probe_draw(im):
    """探一次 draw_* 形态。'tuple'=传元组，'flat'=散参数；都不行就不画（测量照跑）。"""
    global DRAW_STYLE
    forms = [('tuple', lambda: (im.draw_rectangle((8, 8, 6, 6), color=(255, 0, 0)),
                                im.draw_line((8, 20, 28, 20), color=(255, 0, 0)),
                                im.draw_cross((20, 30), color=(255, 0, 0), size=2))),
             ('flat', lambda: (im.draw_rectangle(8, 8, 6, 6, color=(255, 0, 0)),
                               im.draw_line(8, 20, 28, 20, color=(255, 0, 0)),
                               im.draw_cross(20, 30, color=(255, 0, 0), size=2)))]
    for name, fn in forms:
        try:
            fn()
            print("自检: draw_* 用 '%s' 形态" % name)
            DRAW_STYLE = name
            return name
        except Exception as e:
            print("自检: draw_* '%s' 形态不可用: %s" % (name, e))
    return None


def d_rect(im, r, col):
    if DRAW_STYLE == 'tuple':
        im.draw_rectangle(r, color=col)
    elif DRAW_STYLE == 'flat':
        im.draw_rectangle(r[0], r[1], r[2], r[3], color=col)


def d_line(im, p, col):
    if DRAW_STYLE == 'tuple':
        im.draw_line(p, color=col)
    elif DRAW_STYLE == 'flat':
        im.draw_line(p[0], p[1], p[2], p[3], color=col)


def d_cross(im, x, y, col, sz=4):
    if DRAW_STYLE == 'tuple':
        im.draw_cross((x, y), color=col, size=sz)
    elif DRAW_STYLE == 'flat':
        im.draw_cross(x, y, color=col, size=sz)


# ==================== 主循环 ====================

clock = time.clock()
last_offset = 0
last_angle  = 0
last_row_ctrl = None       # 最近一次有效帧的交界行（备胎点票/时序参考）
base_off     = None        # "直线状态时的 offset"基线：直线帧里慢跟踪，丢线判据 Δ 的基准
lost_near    = '?'         # 丢线帧的所在面（'黄'/'灰'/'?'）：classify_lost 每次重填，终端标签用
last_print  = time.time()
want_photo  = False        # 收到 'P' 置起, 本帧处理完存图后清掉（见第 6.5 步）
filt_buf_o = []            # 出量滤波：最近 FILT_MED_N 个有效帧的原始 offset/angle
filt_buf_a = []
ang_med_buf = []           # 角度中位数窗口的原始角缓存（第十八次，见 ANG_MED_N 注释）
filt_o     = 0.0           # EMA 状态（首帧直接置入，不从 0 爬）
filt_a     = 0.0
filt_init  = True
lost_run   = 0             # 连续丢线帧数（REACQ 点级过滤/熔断计数，见 REACQ_* 注释）
lost_dir   = None          # 丢线段出画方向（2=顶出/3=底出；只信 Δ 判据给的，整段恒定）
quad_hold  = False         # 本帧出量来自抛物线兜底（角度保持标志，第十五次）

# ---------------- 看门狗（2026-10 加; 2026-10-02 起**默认关闭**）----------------
# 治的是「主循环卡死 = 链路哑掉只能重新上电」: 意外阻塞超过 WDT_TIMEOUT_MS 就硬复位。
# ⚠️⚠️ 2026-10-02 现场事故复盘后改为默认关（WDT_ENABLE=False）:
#    它是全程序**唯一**在「IDE 调试」与「车上部署」之间行为不同的代码 —— USB 连电脑时
#    isconnected()=True 会跳过 WDT, IDE 里永远测不到它; 上车后若主循环在某条件下
#    停摆 >15s, 板子会陷入「复位→重跑→再复位」循环, 症状 = 完全不理 'G'、一个字节不发,
#    且 IDE 测试完全正常。在人坐在现场能重新上电的比赛场景里, 看门狗收益（免手动重启）
#    抵不过这种「只在车上发作」的风险。要看门狗时手动改 True —— 并先用 UART 开机横幅
#    确认没有重启循环再开。
WDT_ENABLE = False          # True = 部署态（USB 空着）启用看门狗
WDT_TIMEOUT_MS = 15000

wdt = None
if WDT_ENABLE:
    try:
        if not USB_VCP().isconnected():     # USB 连电脑（IDE 调试）时不开, 免得断点处被反复复位
            from machine import WDT
            wdt = WDT(timeout=WDT_TIMEOUT_MS)
    except Exception:
        wdt = None   # 老固件/异常兜底: 宁可没有看门狗, 也不能在启动处就崩

img = None
try:
    img = sensor.snapshot()
except Exception as e:
    print("启动自检快照失败(继续进主循环):", e)
if img is not None:
    print("DEBUG %dx%d 测量区 x=%s y=%s 上带=%s 下带=%s 列数%d 列宽%d 横条%d 目标行%d"
          % (img.width(), img.height(), WIN_X, WIN_Y, TOP_BAND, BOT_BAND, NCOL, COL_W,
             NSTRIP, int(FRAME_H // 2 + TARGET_OFFSET)))
    if DRAW:
        probe_draw(img)

# ---------------- UART 遥测 + 运行时调参（v3.2, 2026-10-02）----------------
# 背景：第 7 步状态行/异常信息走 print()，脱机（USB 不连电脑）时全部不可见 ——
# 现场「46fps 全 0 盲」在树莓派侧只能看到症状、看不到原因（这次排查的切肤之痛）。
# v3.2 起把两类信息镜像到 UART（'#' 前缀文本行；树莓派 openmv_serial 解析器把它
# 当坏行丢弃/计数，无副作用）：
#   '#'+第 7 步状态行 / '#ERR @<阶段>: <异常>'   —— 'D' 命令开/关
#   '#PAR ...' / '#OK <命令>'                    —— 'V' 查询 / 参数回执（常开）
# 运行时调参（树莓派发「<字母><数值>\n」，只影响本次运行、重启回编译值）：
#   M<float> MARGIN_MIN   K<float> EDGE_STEP_SHARP
#   E<int>   曝光 exposure_us   A<int> 增益 gain_db   L<int> LED 亮度 0~100
# 单字节命令 G/S/P/D/V 不带换行、即收即处理；参数首字母后进入攒行态、收到 \n 才执行
# —— 树莓派只会发 G/S/P，不可能误触。
DIAG    = False                 # 'D' 切换：状态行/异常行镜像到 UART
cmd_buf = b''                   # 参数命令攒行缓冲

cur_e_us  = EXPOSURE_US         # 当前生效参数影子值（'V' 回报用；与 sensor 初始化同源）
cur_gain  = GAIN_DB
cur_led   = LED_BRIGHTNESS


def _param_report():
    uart.write("#PAR %s M=%.1f K=%.1f E=%d A=%d L=%d DIAG=%d\r\n"
               % (VERSION, MARGIN_MIN, EDGE_STEP_SHARP,
                  cur_e_us, cur_gain, cur_led, 1 if DIAG else 0))


def _param_apply(s):
    """解析并应用一行参数命令（首字母 + 数值）。非法行回 '#ERR'，不影响运行。"""
    global MARGIN_MIN, EDGE_STEP_SHARP, cur_e_us, cur_gain, cur_led
    try:
        tag = s[:1].decode()
        val = float(s[1:].decode())
    except Exception:
        uart.write("#ERR PARAM\r\n")
        return
    if tag == 'M' and val > 0:
        MARGIN_MIN = val
    elif tag == 'K' and val > 0:
        EDGE_STEP_SHARP = val
    elif tag == 'E' and val > 0:
        sensor.set_auto_exposure(False, exposure_us=int(val))
        cur_e_us = int(val)
    elif tag == 'A' and val >= 0:
        sensor.set_auto_gain(False, gain_db=int(val))
        cur_gain = int(val)
    elif tag == 'L' and 0 <= val <= 100:
        led.duty_u16(int(val / 100 * 65535))
        cur_led = int(val)
    else:
        uart.write("#ERR PARAM\r\n")
        return
    uart.write("#OK %s=%.1f\r\n" % (tag, val))

while True:
    # 按需发送控制：轮询树莓派写来的控制字节（'G'=开始发, 'S'=停止发）。
    # 放循环最前，保证触发后本周期即生效（延迟 ≤ 一个采样周期）。
    # v3.2：'D' 遥测开关 / 'V' 参数查询；'M''K''E''A''L' 为参数命令首字母，
    #       进入攒行态等 '\n'（见 _param_apply），其余字节忽略。
    if uart.any():
        c = uart.read(1)
        if cmd_buf:
            if c == b'\n' or c == b'\r':
                _param_apply(cmd_buf)
                cmd_buf = b''
            else:
                cmd_buf += c
                if len(cmd_buf) > 24:      # 防呆：垃圾流把缓冲撑爆
                    cmd_buf = b''
        elif c == b'G':
            SENDING = True
        elif c == b'S':
            SENDING = False
        elif c == b'P':
            want_photo = True      # 只置标志: 本轮这帧处理完再存（要存"刚测过的那一帧"）
        elif c == b'D':
            DIAG = not DIAG
            uart.write("#DIAG %d\r\n" % (1 if DIAG else 0))
            _param_report()
        elif c == b'V':
            _param_report()
        elif c in (b'M', b'K', b'E', b'A', b'L'):
            cmd_buf = c

    clock.tick()
    # 快照失败以前会直接把整个脚本带走（这两行在 try 外, 裸 while 也没有兜底）——
    # 链路从此哑掉、L 帧与命令解析全停, 只能重新上电。现在置 None 交给下面的大 try:
    # 它会在第 1 步自然抛出 → 走 except 发一帧 valid=0, 循环照常继续（自愈重试）。
    try:
        img = sensor.snapshot()
        img = img.lens_corr(strength=LENS_CORR_STRENGTH)   # 镜头畸变校正
    except Exception as se:
        print("[巡线] 采样失败(下一帧重试):", se)
        img = None

    if wdt is not None:
        wdt.feed()   # 每帧喂狗; 快照失败也喂（在重试, 不是卡死）

    # valid=0 时沿用上一帧（丢线策略在树莓派侧）
    valid   = False
    offset  = last_offset
    angle   = last_angle
    state_v = 4            # 默认"方向不明"; 下面各步给出更准的值, 出错也落在这里
    lost_near = '?'        # 所在面也每帧重置（防上一帧的值漏到出错帧）
    stage   = '0'
    src_ch  = '-'

    try:
        # ---- 1) 两侧色心：用中位数（对"交界跑进色心带"这种污染不敏感）----
        stage = '1 色心'
        su = img.get_statistics(roi=TOP_BAND)
        sd = img.get_statistics(roi=BOT_BAND)
        a_up, b_up = sval(su, 'a_median', 'a_mean'), sval(su, 'b_median', 'b_mean')
        a_dn, b_dn = sval(sd, 'a_median', 'a_mean'), sval(sd, 'b_median', 'b_mean')
        l_up = sval(su, 'l_median', 'l_mean')
        l_dn = sval(sd, 'l_median', 'l_mean')
        margin = max(abs(a_up - a_dn), abs(b_up - b_dn))

        # ---- 2) 自动选判别通道：a 和 b 里分得更开的那个 ----
        stage = '2 通道'
        is_a = abs(a_up - a_dn) >= abs(b_up - b_dn)
        ch = 'a' if is_a else 'b'
        # 有效条件：两侧确实分得开（"全灰/全黄"时 margin 会塌掉）
        enough = margin >= MARGIN_MIN

        # ---- 3) 逐列取剖面 → 找交界行 ----
        # 判别量（2026-09-25 起）：每条横条的 (a,b) 到"上参考色"和"下参考色"的距离²
        # 之差 f，f<0 离上侧近、f>0 离下侧近，过零即交界。
        # 为什么弃掉"单通道过中点"：固定曝光下阴影=欠曝，L 和 |a|,|b| 一起塌向 0，
        # 黑条也是 0 —— 单通道剖面里"阴影边"和"真边界"是同一种特征，落差大的那个赢，
        # 就锁错（uuu.bmp 帧实证：x≈180 锁到褶皱阴影边、x≈20/300 锁到黑条下沿）。
        # 距离剖面下，阴影/褶皱只是把色点往原点压：下侧饱和、上侧弱色时，压向黑的点
        # 仍离上侧参考近 → 阴影边不过零；色→黑→色的 f 全程单调，落差不再被劈成两半。
        # 且 f 不再有 own_mid 这个可漂移的标量中点 —— 判别面是上下参考色连线的中垂面，
        # own_mid 被 LED 热点/阴影推着跑而让褶皱边翻面的失效模式整个不存在了。
        stage = '3 逐列'
        # 逐列裁决已抽成纯函数 column_crossing（2026-09-29 第十一次）：亮度掩码、
        # 亮条参考色（顶 2 条 / 底部区域生长 REF_GROW_STEP）、f 距离剖面、
        # refine_local、合法域闸 A/B 全在函数里 —— 主循环/回放器/平台三方调用
        # 同一份，回放器不再手工复刻第 3 步（第八/十次机制漏同步、离线结论失真
        # 的教训）。返回 (row, ta, tb, ba, bb)：亮条凑不齐 = None 整列不采；
        # row=None = 无合法穿越但参考色照常返回（供下方中位数覆盖用）。
        pts, bpts, tops, bots = [], [], [], []
        for i in range(NCOL):
            x = int(WIN_X[0] + (WIN_X[1] - WIN_X[0]) * (i + 0.5) / NCOL)
            prof = col_profile(img, x)
            res = column_crossing(prof, margin)
            if res is None:
                continue
            row, ta, tb, ba, bb = res
            tops.append((ta, tb))
            bots.append((ba, bb))
            if row is not None and WIN_Y[0] <= row <= WIN_Y[1]:
                pts.append((x, row))
                if CHECK_BLACK:
                    brow = black_row(prof, row)
                    if brow is not None and WIN_Y[0] <= brow <= WIN_Y[1]:
                        bpts.append((x, brow))

        # 全局两侧色/判别通道改用亮条参考色的中位数：TOP_BAND/BOT_BAND 整带统计
        # 吃进黑区后 margin 会塌 → valid 无故翻 0（出量保持上一帧，看起来也像
        # 跳变）；丢线颜色票的参考色同样被带偏。亮列不足 3 个时保留整带统计兜底。
        if len(tops) >= 3:
            a_up = sorted(t[0] for t in tops)[len(tops) // 2]
            b_up = sorted(t[1] for t in tops)[len(tops) // 2]
            a_dn = sorted(t[0] for t in bots)[len(bots) // 2]
            b_dn = sorted(t[1] for t in bots)[len(bots) // 2]
            margin = max(abs(a_up - a_dn), abs(b_up - b_dn))
            ch = 'a' if abs(a_up - a_dn) >= abs(b_up - b_dn) else 'b'
            enough = margin >= MARGIN_MIN

        # ---- 4) 抗离群拟合（丢线期先过 REACQ 点级过滤，见 REACQ_* 常量注释）----
        # 点级过滤 vs 帧级：帧级"拟合出行不符就拒"已实测死锁 —— 假线与真边界并存时
        # RANSAC 选假线→被拒→永远重锁不上；点级先把出画方向对侧的候选滤掉再拟合，
        # 真交界回画必落入边半场，拟合成功即自然解锁。连丢满 REACQ_GATE_FRAMES 帧
        # 熔断放行（fail-open）—— 放行后的再锁定在第 5 步做 Δ 同侧验收（第十二次）。
        stage = '4 拟合'
        pts_fit = pts
        if lost_run > 0 and lost_dir is not None and lost_run < REACQ_GATE_FRAMES:
            if lost_dir == 3:      # 从底出画 → 重锁只认窗口下部（行 ≥ REACQ_ROW_MIN）
                pts_fit = [p for p in pts if p[1] >= REACQ_ROW_MIN]
            else:                  # 从顶出画 → 重锁只认窗口上部（行 ≤ REACQ_ROW_MAX）
                pts_fit = [p for p in pts if p[1] <= REACQ_ROW_MAX]
        fa = robust_fit(pts_fit)
        quad_hold = False
        if fa is None and len(pts_fit) >= 5:
            fq = quad_fit_line(pts_fit)   # 弓形边界兜底（第十五次，见 quad_fit_line）
            if fq is not None:
                fa = fq[:5]
                quad_hold = True
        fb = robust_fit(bpts) if CHECK_BLACK else None

        # ---- 5) 出量：来源可选(黑线/色边)，量出后再过 中数3+EMA ----
        # 黑线行定义=黑条中心（L 极小处），比色边的"蓝侧边缘"高 ~5px —— 换源后
        # TARGET_OFFSET 要按老流程重标。滤波只动出量：EMA 压"内点集翻动"的持续台阶
        # 和逐帧噪声；中数默认关（这里的跳变是双稳态翻动不是尖刺，见 FILT_MED_N）。
        # invalid 帧不入队不推进 EMA —— 树莓派拿到的仍是上一拍值，与"valid=0 沿用
        # 上一帧"的旧协议语义一致。
        stage = '5 出量'
        reacq_reject = False          # 放行期再锁定的 Δ 同侧验收结果（见 raw_off 处）
        if fa and enough:
            if USE_BLACK_PRIMARY and fb is not None and fb[2] <= BLACK_RMS_MAX:
                fit, src_pts, src_ch = fb, bpts, 'B'
            else:
                fit, src_pts, src_ch = fa, pts, 'C'
            # 曲线判别要用**全局**拟合的 RMS（state 1 的依据）：近段重拟合成功后 RMS
            # 会降回来，但"这窗里是路口大弧"的事实没变 —— 树莓派侧 state=1 的语义
            # 是"这帧来自路口/弯道"，不是"拟合质量差"。
            is_curve = fit[2] > CURVE_RMS_PX
            if is_curve:
                # 交界在这窗里是条弧（路口/弯道/过坎后车头随机歪）。航向该跟**车马上
                # 要进的近段**切线，不是整条弧的平均切线（平均会同时把 angle 和
                # offset 带偏）。取全局拟合内点里靠车这半边（行 > 测量窗中线）重拟合;
                # 近段凑不够 4 点或没更直就保留全局拟合（尽力而为）。
                near = [p for p in src_pts
                        if p[1] > NEAR_HALF_ROW
                        and abs(p[1] - (fit[0] * p[0] + fit[1])) <= RANSAC_TOL_PX]
                if len(near) >= 4:
                    fn = lsq(near)
                    if fn is not None and fn[2] < fit[2]:
                        fit = (fn[0], fn[1], fn[2], len(near), len(src_pts) - len(near))
            m, c, e, nk, nd = fit
            lat_span = FRAME_H
            row_ctrl = m * CTRL_X + c                      # 控制列处的交界行
            # 夹回测量窗：直线行跑不出去；曲线帧近段切线外推到控制列可能甩出窗外，
            # 不夹会把虚大的满偏 offset 交给树莓派 —— 方向不会错，大小会虚。
            if row_ctrl < WIN_Y[0]:
                row_ctrl = WIN_Y[0]
            elif row_ctrl > WIN_Y[1]:
                row_ctrl = WIN_Y[1]
            error_px = (row_ctrl - lat_span / 2.0) - TARGET_OFFSET
            raw_off = max(-100, min(100, int(error_px / lat_span * 2 * ERR_GAIN)))
            raw_ang = max(-900, min(900, int(math.degrees(math.atan(m)) * 10)))
            if quad_hold:
                # 弓形帧角度保持（第十五次）：抛物线的近段切线是 U 形顶点局部斜率，
                # 与 GT 弦线差可达 13°（K#58 实测），且弦↔切切换本身就是一次大突跳
                # —— 角度稳定性优先，保持上一拍输出角；off 照常（抛物线在控制列的
                # 值与真值吻合，K#58/B#128 实测误差 0~2）。恒定光照下车在动，几帧内
                # 线拟合会接管回来。
                raw_ang = int(filt_a)
            # 放行期再锁定验收（第十二次，第十五次加质量豁免）：丢线满
            # REACQ_GATE_FRAMES 帧后点级过滤放行（fail-open），但锁到的线必须与
            # Δ 判据同侧 —— st=3（往黄区塌陷）期间真交界只能在基线黄侧，锁到
            # raw_off ≤ base_off + DELTA_GATE = 交界"瞬移"到基线另一侧 = 同材渐变
            # 假线（任务P 实测：丢满 8 帧假线当帧假重锁，off 还给成负值）。拒绝并
            # 按丢线处理。只验收放行帧：过滤帧的点已在入边半场，不再二道拒。
            # 质量豁免（第十五次）：内点 ≥REACQ_QA_NK 且 RMS ≤REACQ_QA_RMS 的高
            # 质量拟合不受陈旧 Δ 方向否决 —— 边界扫掠回窗内时（车在丢线期继续动），
            # 真边界会越过基线到另一侧，A 114-134 被旧验收整段拒成 21 帧盲。
            if lost_run >= REACQ_GATE_FRAMES and lost_dir is not None \
                    and base_off is not None:
                qa_ok = nk >= REACQ_QA_NK and e <= REACQ_QA_RMS
                if lost_dir == 3 and raw_off <= base_off + DELTA_GATE and not qa_ok:
                    reacq_reject = True
                elif lost_dir == 2 and raw_off >= base_off - DELTA_GATE and not qa_ok:
                    reacq_reject = True
            if not reacq_reject:

                filt_buf_o.append(raw_off)
                filt_buf_a.append(raw_ang)
                if len(filt_buf_o) > FILT_MED_N:
                    del filt_buf_o[0]
                    del filt_buf_a[0]
                med_o = sorted(filt_buf_o)[len(filt_buf_o) // 2]
                # 角度中位数（第十八次，见 ANG_MED_N 注释）：off 门自适应窗口 ——
                # off 静止（|raw_off−filt_o| ≤ 门）= 双稳态翻动期，用满窗口中位数
                # 把"主流态+单帧凹陷"的凹陷剔掉；off 在动 = 真机动，窗口退化为 1
                # 直通（中位数在持续坡上滞后 2 帧，不能带进转弯）
                ang_med_buf.append(raw_ang)
                if len(ang_med_buf) > ANG_MED_N:
                    del ang_med_buf[0]
                if filt_init:
                    med_a = sorted(ang_med_buf)[len(ang_med_buf) // 2]
                else:
                    w = ANG_MED_N if abs(raw_off - filt_o) <= ANG_MED_OFF_GATE else 1
                    med_a = sorted(ang_med_buf[-w:])[len(ang_med_buf[-w:]) // 2]
                if filt_init:
                    filt_o, filt_a = float(med_o), float(med_a)
                    filt_init = False
                else:
                    # 门控 EMA（2026-09-29 第十一次）：两轴各自判门 —— 台阶在门内是
                    # 噪声/内点集翻动（慢平滑压住），门外是真运动/重锁（快跟防拖影）。
                    # 检验只看 /compare 残差 std，勿用 MAE（见 CLAUDE.md 抖动指标段）
                    a_o = FILT_EMA_A if abs(med_o - filt_o) <= FILT_FAST_GATE else FILT_EMA_A_FAST
                    a_a = FILT_EMA_A if abs(med_a - filt_a) <= FILT_FAST_GATE else FILT_EMA_A_FAST
                    filt_o += a_o * (med_o - filt_o)
                    prev_a = filt_a
                    filt_a += a_a * (med_a - filt_a)
                    # 角度限速（第十五次，见 ANG_RATE_MAX 注释）：真坡不削、只削尖刺
                    if filt_a - prev_a > ANG_RATE_MAX * 10.0:
                        filt_a = prev_a + ANG_RATE_MAX * 10.0
                    elif prev_a - filt_a > ANG_RATE_MAX * 10.0:
                        filt_a = prev_a - ANG_RATE_MAX * 10.0
                offset = int(filt_o)
                angle = int(filt_a)

                valid = True
                state_v = 1 if is_curve else 0
                # 有效帧刷新两侧参考色 —— 但只在交界行舒服地待在窗口中部（REF_SAFE_ROW）
                # 时刷：边界行贴近下带(>195)时底带已被黄区吃进、贴上带(<70)时顶带已被路面
                # 吃进，这种帧刷参考色会把参考污染成对面（2026-09-27 修的翻车：压黄过程
                # 中 ref_road 被一路带成黄 → 全黄帧两票打架 → 落兜底错报"边界远出"）。
                if REF_SAFE_ROW[0] <= row_ctrl <= REF_SAFE_ROW[1]:
                    ref_bnd = ema_ref(ref_bnd, (a_up, b_up))
                    ref_road = ema_ref(ref_road, (a_dn, b_dn))
                # 直线基线（丢线判据 Δ 的基准，用户定律·趋势版）：只在"直线"帧里慢跟踪，
                # 偏出 BASE_GATE 即冻结 —— 慢速压线不会把基线拖走，路口弧(st=1)也不参与。
                # 它自动对准实际工作点（树莓派 SETPOINT 偏置/标定偏差都吸收掉）。
                if state_v == 0:
                    if base_off is None:
                        base_off = float(offset)
                    elif abs(offset - base_off) <= BASE_GATE:
                        base_off += BASE_RATE * (offset - base_off)
                lost_run = 0                  # 重锁成功：REACQ 点级过滤计数/方向复位
                lost_dir = None
                last_row_ctrl = row_ctrl      # 备胎点票/时序参考
                last_offset = offset
                last_angle = angle
        if (not (fa and enough)) or reacq_reject:
            # 丢线（含熔断重试被拒帧）：offset/angle 沿用上一帧（协议语义），
            # state 报丢线方向 —— 树莓派按它定向找线，取代它那边死写的固定方向
            state_v = classify_lost(pts, a_up, b_up, a_dn, b_dn)
            lost_run += 1
            if lost_dir is None and state_v in (2, 3):
                # 方向只在"Δ 判据给的"时才 arm REACQ 过滤（Δ 整段恒定，可信）；
                # 备胎证据（零星点票/颜色票）不 arm —— 可能只是假点的行位置
                dlt = (last_offset - base_off) if base_off is not None else None
                if dlt is not None and ((dlt < -DELTA_GATE and state_v == 2)
                                        or (dlt > DELTA_GATE and state_v == 3)):
                    lost_dir = state_v

        # ---- 6) 可视化（调试用，不影响出量）----
        if DRAW:
            try:
                d_rect(img, TOP_BAND, (0, 255, 255))
                d_rect(img, BOT_BAND, (0, 255, 255))
                d_line(img, (WIN_X[0], WIN_Y[0], WIN_X[1], WIN_Y[0]), (0, 255, 255))
                for p in pts:
                    d_cross(img, p[0], int(p[1]), (255, 255, 0), 4)
                for p in bpts:
                    d_cross(img, p[0], int(p[1]), (255, 0, 0), 2)
                if fa:
                    d_line(img, (WIN_X[0], int(fa[0] * WIN_X[0] + fa[1]), WIN_X[1],
                                 int(fa[0] * WIN_X[1] + fa[1])), (0, 255, 0))
            except Exception as de:
                print("[巡线] 绘制失败(不再尝试):", de)
                DRAW = False

        # ---- 6.5) 拍照（收到 'P' 时把**刚测过的这一帧**存到相机盘）----
        #    放在绘制之后: 存下来的照片与 IDE 里看到的一致（带黄十字/绿拟合线）,
        #    "当时每列读到什么"一眼可见 —— 这正是不对劲时最想留的证据。
        #    想要干净原图, 把这三行挪到第 6 步之前即可（位置就是开关）。
        #    ⚠️ photo.take 自己吞掉所有异常, 存图失败不会影响本帧出量。
        if want_photo:
            want_photo = False
            if photo is not None:
                photo.take(img)
            else:
                print("[拍照] photo 模块不可用, 忽略本次 'P'")

        # ---- 7) 状态输出（限速；只在 SENDING 之外也打，方便台架上不上位机时看）----
        #      有效帧带侧别（|Δ|>门 时 [直线·黄]/[直线·灰]）—— 深偏帧只打[直线]会被
        #      误读成"正常巡线"（2026-09-27 第七次：用户看"直线-98→回升-59→判灰"以为
        #      矛盾，其实是灰侧深处的回移）。丢线帧加打 d=<Δ>，判据依据一眼可见。
        if time.time() - last_print > PRINT_EVERY_S:
            last_print = time.time()
            cur = offset if valid else last_offset
            d_show = (cur - base_off) if base_off is not None else None
            if valid:
                if state_v == 1:
                    st_txt = '路口弧'
                elif d_show is not None and d_show > DELTA_GATE:
                    st_txt = '直线·黄'
                elif d_show is not None and d_show < -DELTA_GATE:
                    st_txt = '直线·灰'
                else:
                    st_txt = '直线'
            elif state_v == 3:
                st_txt = '压黄区'
            elif state_v == 2:
                st_txt = '压灰区'
            else:
                st_txt = '不明'
            msg = "valid=%d[%s] off=%4d ang=%+6.1f st=%d" % (
                1 if valid else 0, st_txt, offset, angle / 10.0, state_v)
            if (not valid) and d_show is not None:
                msg += " d=%+d" % int(d_show)   # 丢线判据 Δ（冻结 off − 直线基线）
            msg += " 点%d剔%d 列%d/%d 通道%c 距%.0f L%03d/%03d %.0ffps" % (
                fa[3] if fa else 0, fa[4] if fa else 0, len(pts), NCOL,
                ch, margin, l_up, l_dn, clock.fps())
            if fb:
                msg += " |黑线%+6.1f" % math.degrees(math.atan(fb[0]))
            msg += " 出%c" % src_ch
            print(msg)
            if DIAG:
                uart.write("#" + msg + "\r\n")   # 脱机遥测：'#'行树莓派按坏行丢弃, 无副作用

    except Exception as ex:
        print("[巡线] 出错 @%s: %s" % (stage, ex))
        try:
            sys.print_exception(ex)
        except Exception:
            pass
        if DIAG:                          # 脱机时异常只能走 UART 才看得见（v3.2）
            try:
                uart.write("#ERR @%s: %s\r\n" % (stage, ex))
            except Exception:
                pass
        valid = False                    # 出错也要继续发帧（valid=0），别让链路哑掉

    # ---- 8) 串口输出（文本帧，树莓派端 openmv_serial.py 解析）----
    #    格式: L,<offset>,<angle>,<valid>,<state>\r\n   —— 仅 SENDING 时发送
    #    ⚠️ 树莓派端须先部署"4/5 字段都收"的解析器（方案 Part 3），旧解析器会把
    #    5 字段帧整行拒收 → 数据永远陈旧。部署顺序：先 Pi 后相机盘。
    if SENDING:
        uart.write("L,%d,%d,%d,%d\r\n" % (offset, angle, 1 if valid else 0, state_v))
