Qexran/GongKeCompetition/电控/GongKeCompetition/Application/app_config.h

/**
  * @file       app_config.h
  * @brief      应用层统一配置：设备号映射、任务优先级等。
  */

#ifndef __APP_CONFIG_H
#define __APP_CONFIG_H

#include "main.h"
#include "project_config.h"
#include "app_uart.h"
#include "key_device.h"
#include "servo_device.h"
#include "emm_v5_device.h"

/* ==================== UART 设备号映射 ==================== */
#define UART_RPI        UART_ID_RPI      /* 树莓派 // USART1  PA9/PA10 */
#define UART_OPENMV     UART_ID_OPENMV   /* OPENMV // USART2  PD5/PD6（现由副陀螺口占用, 见 UART_GYRO_SUB） */
#define UART_EMM        UART_ID_EMM      /* EMM V5 步进驱动 // USART3  PB10/PB11 */
#define UART_EXT        UART_ID_EXT      /* 外部串口 // UART4  PA0/PC11 */
#define UART_BT         UART_ID_BT       /* 蓝牙 // UART5  PC12/PD2 */

/* ==================== 姿态传感器选型开关 ==================== */
/* 两个物理口**各选一个设备类型, 可以互换、也可以选同型号**（两口都插 M0 / 都插 ATK 都行）——
   固件按本段选型给每个口分派解析, 不认死谁在哪个口。口 / 设备码的对应在 app_sensors.h：
     主口 = USART6 (PC6/PC7, 板上丝印 HWT101_TX/RX)
     副口 = USART2 (PD5/PD6, 板上丝印 VICE_GYRO)
   ⚠️ 选错（与实物不符）**不报错**, 只是那个口收不到帧 —— 看蓝牙的 gyro_main_frames /
      gyro_sub_frames 哪个不涨，或 OLED 标签。开了自动切换时会被换掉。
   每口下面的「回传频率 / 波特率」作用于**该口当前选的设备**（ATK 没有这两个旋钮, 填了也不理会;
   M0 / HWT101 开机由固件自动下发, 不用上位机）。 */
#define GYRO_MAIN_DEV   2    /* 主陀螺设备 @(0~2) // 0=ATK-901 1=M0 2=HWT101; 选项:0=ATK-901 1=M0 2=HWT101 */
#define GYRO_SUB_DEV    1    /* 副陀螺设备 @(0~2) // 同上; 选项:0=ATK-901 1=M0 2=HWT101 */
#define SENSOR_GYRO_SRC 0    /* 启用哪一颗 @(0~1) // 首选(下面"自动切换"里说的首选就是它); 运行时开关=蓝牙 gyro_src(零重编译), 本宏只是上电默认; ⚠️手动切源瞬间 yaw 会跳到另一颗的零点, 闭环/走路线时别切; 选项:0=启用主口那颗 1=启用副口那颗 */
#define GYRO_AUTO_SWITCH 1   /* 陀螺自动切换 @(0~1) // 1=热备: 当前那颗停摆就立刻换另一颗(跑路线中也换), 首选恢复健康再自动切回; 0=关(与加这个功能前一致); 运行时量=蓝牙 gyro_auto_switch; 每次换源往 Pi 打一条 GYRO: 串 */
#define GYRO_AUTO_SWITCH_MS 600u  /* 停摆判定窗 [ms] @(200~) // 连续这么久收不到当前那颗的姿态帧才判停摆; 太短会在开机自配期误判(ATK 初始化 ~0.4s, M0/HWT101 开机配置 ~0.5s) */

/* ---- 每口的回传频率与波特率（作用于该口当次选的设备; 改完要重编译烧写）----
   ⚠️ 会合机制: 两口在 CubeMX 里固定 115200 **别动**, 模块 RAM 不保存、上电也回 115200 ——
   固件每次开机都在 115200 上先"会合", 下发完新波特率后 MCU 本口立刻跟着换挡, 两端没有中间态。
   所以波特率只在「下发开关」打开时生效; 填错给模块重新上电即自愈, 不必拿上位机救。 */
#define GYRO_MAIN_RATE_HZ    200.0f  /* 主口回传频率 [Hz] @(0.1~200) // 主口那颗的开机回传频率, 固件就近匹配该型号的档位表(HWT101 连续档最高 200Hz, 125Hz 档是 WT931 专属; M0 档到 1000 但 ⚠️>200 时两帧把 115200 打满会丢帧, 除非波特率也提到 230400); ATK 不理会 */
#define GYRO_MAIN_BAUD       230400u /* 主口波特率 @(4800~230400) // 主口那颗的开机波特率; 仅下一行开关=1 时生效(先按 115200 会合→下发模块→MCU 本口跟着换); 模块只改 RAM 不写 Flash, 断电自愈; 选项:4800=4800 9600=9600 19200=19200 38400=38400 57600=57600 115200=115200 230400=230400 */
#define GYRO_MAIN_BAUD_APPLY 1       /* 主口下发波特率 @(0~1) // 1=开机把上一行的波特率发给主口模块并把 MCU 主口一起换挡(改它要重编译); 0=不碰波特率(默认, 与选 115200 等价) */
#define GYRO_SUB_RATE_HZ     100.0f  /* 副口回传频率 [Hz] @(0.1~200) // 同主口那两条, 作用于副口 */
#define GYRO_SUB_BAUD        115200u /* 副口波特率 @(4800~230400) // 同主口; 选项:4800=4800 9600=9600 19200=19200 38400=38400 57600=57600 115200=115200 230400=230400 */
#define GYRO_SUB_BAUD_APPLY  0       /* 副口下发波特率 @(0~1) // 同主口; ⚠️副口选 M0 时波特率最大 115200(M0 档位表没有 230400, 编译期会拦) */

/* ==================== 陀螺模块专属参数（跟型号, 不跟口 —— 挂在哪个口都对同型号生效） ==================== */
#define M0_GYRO_YAW_SIGN     (-1.0f)     /* M0 yaw方向符号 @(-1~1) // 模块顺时针为正、本工逆时针为正, 故默认 -1; 装反/方向不对就翻符号; 用蓝牙 m0_yaw 与 att_yaw 对比现场确认 */
#define M0_GYRO_ZERO_ON_BOOT 1           /* M0 上电yaw零点 @(0~1) // 1=开机给模块发一次 yaw 置零(只改模块 RAM, 不写 Flash)让"开机朝向=0°"成立; 0=沿用模块上次保存的零点 */
#define GYRO_HWT_ZERO_ON_BOOT 1          /* HWT 上电yaw零点 @(0~1) // 1=开机给 HWT101 发一次 CALSW=CALANGLEZ Z轴置零(同样只改 RAM); 与 M0 那条配对 —— 两颗都以上电朝向为零点, 热备互切时 yaw 才不会跳出一大截; ⚠️上电时车必须静止 */

/* ==================== 按键设备号映射 ==================== */
#define KEY_MAIN        emKeyDevNum0    /* 启动/确定 // PF6 */
#define KEY_LEFT        emKeyDevNum1    /* 左 // PF8 */
#define KEY_RIGHT       emKeyDevNum2    /* 右 // PA5 */
#define KEY_UP          emKeyDevNum3    /* 上 // PC4 */
#define KEY_DOWN        emKeyDevNum4    /* 下 // PA7 */

/* ==================== 机械臂舵机映射（6 轴） ==================== */
#define ARM_SERVO1      emServoDevNum0  /* 舵机1 // SERVO1 5V 180° TIM4_CH2 PB7 */
#define ARM_SERVO2      emServoDevNum1  /* 舵机2 // SERVO2 5V 180° TIM2_CH3 PA2 */
#define ARM_SERVO3      emServoDevNum2  /* 舵机3 // SERVO3 5V 180° TIM2_CH2 PA1 */
#define ARM_SERVO4      emServoDevNum3  /* 舵机4 // SERVO4 5V 180° TIM2_CH4 PA3 */
#define ARM_SERVO5      emServoDevNum4  /* 舵机5 夹爪 // SERVO5 5V 180° TIM3_CH3 PB0 */
#define ARM_SERVO6      emServoDevNum5  /* 舵机6 底座 // SERVO6 8.4V 360°角度型 TIM3_CH4 PB1 */

/* ==================== 机械臂组 / 夹爪 ==================== */
/* 组动作联动 5 轴 = SERVO1,2,3,4 + SERVO6(底座)，参数顺序与此一致；
 * 夹爪 SERVO5 不进组，由 SET_ZHUASHOU 单独控制 */
#define ARM_GROUP_NUM               5           /* 组动作轴数 @(5~5) // ⚠️结构量非旋钮: 与 app_arm.c 的 5 元素初始化表、afF[6] 三处耦合, 改动必编译错或越界读 */
#define ARM_GRIPPER                 ARM_SERVO5  /* 夹爪舵机 // 不进组, 由 SET_ZHUASHOU 单独控制 */
#define ARM_GROUP_WAIT_TIMEOUT_MS   3000u       /* 组动作等待超时 [ms] @(0~) // Wait 轮询超时即放行(只是**下界**: 实际还会按「全臂最坏行程/速度闸 + 余量」自适应加长, 否则 360° 轴走满程会被提前放掉) */
#define ZHUASHOU_OPEN_ANGLE         0.0f        /* 夹爪全开角度 [°] @(0~180) // 新夹爪结构行程即 0~180 (旧爪为 45~85); 张开/闭合反了就与下一行**对调** */
#define ZHUASHOU_CLOSE_ANGLE        180.0f      /* 夹爪全闭角度 [°] @(0~180) // 同上; 必须整行对调而非各自改值, 否则已录的动作预设会整体反向 */
#define ZHUASHOU_MOVE_MS            300u        /* 夹爪开合时长 [ms] @(0~) // S 曲线; app_arm.c 另用它 *4 作自身等待上界 */
/* 全臂总速度闸 —— **拖动与播放都受它管**（app_arm.c 初始化时写进 6 个舵机的 fSpeed）。
 * 拖动时是恒速趋近的速度; 播放时是 S 曲线的削峰上限（曲线中段峰值 1.875·Δ/时长,
 * 大行程会明显超出舵机允许转速, 由它削掉）。越小越慢。
 * 参考: 这类 5V 舵机空载约 0.12~0.16s/60° ≈ 375~500°/s; 折半到 200~260 已经很斯文。 */
#define ARM_SERVO_MAX_SPEED_DPS     160.0f      /* 舵机最高转速 [°/s] @(30~1000) // 全臂速度上限; 越小越慢。⚠️这是上电初值: 运行时量=蓝牙/积木 arm_speed_dps, 中途可用「舵机速度」积木改 */
#define ARM_SERVO_CURVE             0         /* 插值曲线 @(0~3) // S曲线播放的进度形状: 0=五次S(默认,两端零速,峰速1.875×均值) 1=三次S(峰速1.5×,中段更匀) 2=余弦(峰速1.57×,减速段更长) 3=线性(恒速,靠削峰成梯形)。全局六轴共用, 当场生效(进行中的动作下一拍就按新曲线算, t 不重置); 运行时量=蓝牙 arm_curve; 选项:0=五次S 1=三次S 2=余弦 3=线性。⚠️ **0 = 与加这个选择功能之前逐字节一致**（那才是"默认"的意思）; 本机现值是 **2（余弦）** —— 现场选定的, 别照"默认"两字改回 0（会动到已经调过的动作手感 + 削峰量 + 到位耗时） */

/* ==================== 组动作角度偏移（台架标定） ==================== */
/* **下发角 = 动作预设里写的角 + 本偏移**，作用于全部组动作。
 *
 * 为什么需要它:「编辑模式拖到位」与「组动作播放到位」的**物理落点**不一定一致 ——
 * 拖滑杆是恒速趋近、播放是 S 曲线（快得多），舵机死区 + 齿轮回差会让两者停在不同地方，
 * 带整臂惯量的底座 S6 最明显。于是台架上拖准的位姿一进路线就偏。
 * 现场用「蓝牙」Tab 的「臂偏移」组当场试出来填（零重编译）；这里只是**断电后的上电默认**，
 * 「调参」Tab 改的也是这个持久默认。
 *
 * ⚠️ 只作用于**组动作**（STEP_ARM_GROUP_WAIT / NO_WAIT / $B,ARM / 动作预设播放 ——
 *    app_arm.c::vArmGroupMoveNoWait 是它们唯一的收口）。刻意**不含**拖滑杆的点动（$B,JOG）
 *    与夹爪：编辑模式是标定基准，把它也挪走就成了「滑杆读数与物理位置互相追着跑」，永远标不准。
 * ⚠️ 标靶校准（vArmAimByPixels）也不吃它 —— 那步是增量式、靠像素偏差自己迭代。
 * ⚠️ 这是**单向补偿**（只按你标定的那个方向修）。若回差是主因，反方向来的动作会过头。 */
#define ARM_GROUP_OFS_S1            0.0f        /* 组偏移-舵机1 [°] @(-90~90) // 下发角 = 预设角 + 本值 */
#define ARM_GROUP_OFS_S2            0.0f        /* 组偏移-舵机2 [°] @(-90~90) // 同上 */
#define ARM_GROUP_OFS_S3            0.0f        /* 组偏移-舵机3 [°] @(-90~90) // 同上 */
#define ARM_GROUP_OFS_S4            0.0f        /* 组偏移-舵机4 [°] @(-90~90) // 同上 */
#define ARM_GROUP_OFS_S6            0.0f        /* 组偏移-底座S6 [°] @(-180~180) // 量程 0~360, 偏移上限放宽; 主诉偏差轴 */

/* ==================== 补光灯（TIM9_CH1@PE5 PWM, 频率见 app_actuator.c 的 FILL_LIGHT_PWM_HZ, 千分比占空比） ==================== */
#define FILL_LIGHT_ON_DUTY          1000u       /* 开灯占空比 [%] {‰->%} @(0~100) // 底层是千分比 0~1000（按当前周期等比换算, >1000 静默钳位）; 界面填 % 自动换算 */

/* ==================== 任务补光（看路/色球/射靶/人质/主摄扫码 步骤期间自动开灯, 步末自动关） ==================== */
/* 6500K 补光灯装在主摄旁（机械臂倒数第二节）, 四类任务 + 主摄二维码扫描这些要靠相机
 * 看东西的步骤全程点亮、出了那一步就灭 —— 开/关的唯一出口在 app_script.c::vScriptExecStep
 * （进步查表开灯、出步无条件灭）, 与路线里手排的 STEP_BUGUANG_KAI/_GUAN 积木互不替代。
 * ⚠️ 2026-10 起这批宏只是**上电默认**: 真值在 Beam（「蓝牙」Tab「补光」组, OLED
 *    「名字调参」也能按名绑定）, 改完**下一个任务步骤就生效**、断电回宏 —— 现场调好
 *    把终值写回这里固化。宏本身仍进「调参」Tab（改它 = 改默认, 要重编译）。 */
#define FILL_TASK_EN                1           /* 任务补光总开关 @(0~1) // 0=各任务一律不碰灯（现场不想要补光时一键全关, 不用逐个改五个开关）; 只管自动这盏, 积木手动开灯不受它管 */
#define FILL_TASK_PCT               60          /* 默认亮度 [%] @(0~100) // 各任务的亮度**留空**时用这一档。灯就在主摄旁边, 太亮会冲淡颜色/反光, 先按 60 现场再调 */
#define FILL_TASK_ROAD_EN           1           /* 看路开灯 @(0~1) // 看路对位/看路校准（主摄看黄区那两步）期间开。⚠️ 灯在主摄旁, 若黄区 R−B 色差被冲淡（当年关 OpenMV 灯 ROAD_LED_OFF_EN 就是这个顾虑）, 先把这一档关掉试 */
#define FILL_TASK_ROAD_PCT          70          /* 看路亮度 [%] @(0~100) // 留空=255 默认取FILL_TASK_PCT(界面空框+「默认」hint, 跟随默认亮度); 填 0=这一任务开灯但 0% 亮(等效灭); 1~100=单独覆盖 */
#define FILL_TASK_BALL_EN           1           /* 色球开灯 @(0~1) // 色球识别/色球对位/色球单动作抓取/排爆抓取 期间开 */
#define FILL_TASK_BALL_PCT          70          /* 色球亮度 [%] @(0~100) // 留空=255 默认取FILL_TASK_PCT(空框+「默认」hint); 填 0=开灯但 0% 亮(等效灭); 1~100=单独覆盖 */
#define FILL_TASK_SHOOT_EN          0           /* 射靶开灯 @(0~1) // 标靶识别/标靶对位/标靶校准/标靶流控/平移射靶/射靶保持 期间开 */
#define FILL_TASK_SHOOT_PCT         60          /* 射靶亮度 [%] @(0~100) // 留空=255 默认取FILL_TASK_PCT(空框+「默认」hint); 填 0=开灯但 0% 亮(等效灭); 1~100=单独覆盖 */
#define FILL_TASK_HOSTAGE_EN        1           /* 人质开灯 @(0~1) // 人质识别/人质对位/人质单动作抓取/反恐任务 期间开 */
#define FILL_TASK_HOSTAGE_PCT       50          /* 人质亮度 [%] @(0~100) // 留空=255 默认取FILL_TASK_PCT(空框+「默认」hint); 填 0=开灯但 0% 亮(等效灭); 1~100=单独覆盖 */
#define FILL_TASK_QR_EN             0           /* 二维码开灯 @(0~1) // 只挂主摄扫码（STEP_QR_SCAN_MAIN_WAIT）; 扫码副摄那步不挂 —— 灯在机械臂主摄旁, 照不到副摄画面。⚠️ 黑白码反光/过曝会把码打花, 扫不出来先关这一档或降亮度试试 */
#define FILL_TASK_QR_PCT            60          /* 二维码亮度 [%] @(0~100) // 留空=255 默认取FILL_TASK_PCT(空框+「默认」hint); 填 0=开灯但 0% 亮(等效灭); 1~100=单独覆盖 */

/* ==================== 边走边转（PID 闭环, 依赖 IMU） ==================== */
#define PID_TIMEOUT_CALIBRATE_MS    1000u       /* 粗调段时长 [ms] @(0~) // vPidTurn */
#define PID_TIMEOUT_FINE_MS         1000u       /* 精调段时长 [ms] @(0~) // vPidTurn / vPidMoveAndTurn */
#define PID_TIMEOUT_BACKOFF_MS       400u       /* 回退时长 [ms] @(0~) // vBackToRoad; 设 0 会改变状态机行为 */
#define PID_TIMEOUT_TRANSIT_MS       300u       /* 边走段时长 [ms] @(0~) // vPidMoveAndTurn */
#define PID_TIMEOUT_TRANSIT_FINE_MS  500u       /* 消差段时长 [ms] @(0~) // vPidMoveAndTurn */
#define CHASSIS_BACK_OFF_SPEED        (-30)     /* 回退速度 [rpm] // 负值=后退; vBackToRoad */
#define PID_MOVE_MS_PER_MM          4.0f        /* 边走边转时间估算 [ms/mm] @(0~) // pro 标定初值 */

/* ==================== 弧线转弯（位置模式写死, 不走 PID/不依赖 IMU） ==================== */
#define ARC_TURN_PULSE_PER_DEG      2.0f        /* 每度差动脉冲 [脉冲/°] @(0~) // 两轮组差动脉冲, 待实车标定 */
#define ARC_TURN90_FWD_MM           150.0f      /* 90°弧线前进量 [mm] @(0~) // 待实车标定 */
#define ARC_TURN_SPEED              80          /* 弧线速度 [rpm] @(0~65535) // 落进 uint16_t; 保守首测 */
#define ARC_TURN_ACCEL              100         /* 弧线加速度 @(0~255) // ⚠️落进 uint8_t, >255 会静默截断 */

/* ==================== 支点转弯（单侧双轮 + 陀螺仪闭环, vPidPivotTurn） ==================== */
/* 只驱动**一侧**双轮当动力、另一侧持 0 不主动转（当支点）, 靠 IMU 航向闭环转到目标角。
 * 物理方向定死: 左转 = 驱动右侧 {2,4} 正转, 右转 = 驱动左侧 {1,3} 正转
 * （见 app_chassis.c::vChassisPivotDrive）, 与陀螺仪符号无关。
 * ⚠️ 单侧出力, 增益与 vPidTurn（四轮）不可直接套用, 须实车单独标定。
 * 标定顺序: KP(偏差大就加 / 到位后过冲就减) → MAX_SPEED(压过冲) → CONVERGE_DEG(精度)。 */
#define PIVOT_TURN_KP               3.0f        /* 比例系数 @(0~) // 单侧两轮出力, 增益须实车标定 */
#define PIVOT_TURN_KI               2.0f        /* 积分系数 @(0~) // 2026 现场实测**有意开启**(消单侧驱动静差, 配 MAX_INTEGRAL=7); 若见到位前来回摆先降它, 0=关积分 */
#define PIVOT_TURN_KD               1.0f        /* 微分系数 @(0~) // 抑制过冲 */
#define PIVOT_TURN_MAX_INTEGRAL     7.0f        /* 积分限幅 @(0~) // KI=0 时无作用 */
#define PIVOT_TURN_MAX_SPEED        130.0f      /* 驱动轮转速限幅 [rpm] @(0~) // 直接决定最快角速度 */
#define PIVOT_TURN_ACCEL            0           /* 电机加速度 @(0~255) // 0=驱动不插值, 由 50ms 闭环自己平滑; ⚠️落进 uint8_t, >255 静默截断 */
#define PIVOT_TURN_PERIOD_MS        50u         /* 闭环节拍 [Hz] {ms->Hz} @(20~200) // 底层 vTaskDelay; 与 PID 任务同节拍 */
#define PIVOT_TURN_CONVERGE_DEG     1.0f        /* 到位角度阈值 [°] @(0~) // |err| 连续 N 次小于它即认定到位 */
#define PIVOT_TURN_CONVERGE_N       4           /* 到位采样数 @(1~50) // × 节拍 = 稳定窗; 太小会被陀螺噪声骗到 */
#define PIVOT_TURN_TIMEOUT_MS       4000u       /* 安全超时 [ms] @(0~) // 超时强制停车; 防 IMU 故障时长转 */
#define PIVOT_TURN_MIN_DEG          0.5f        /* 最小转角 [°] @(0~) // 小于此值不发指令直接返回 */
#define PIVOT_TURN_YAW_SIGN         (1.0f)      /* 航向符号 // 左转时陀螺仪 yaw 反而变小(装反/符号反)才改 -1; 待实车核对 */
/* --- 交接给巡线（STEP_PIVOT_LINE_WAIT: 转到阈值就让巡线接管, 陀螺退出） ---
 * 发 LINE_START 后**边转边等起流**: 两个判据都在转弯闭环里逐拍查（误差进 HANDOFF_DEG
 * **且** 帧已起流）→ 那几百毫秒起流时间就被转弯吃掉了, 这才是省时间的地方。
 * ⚠️ 写成"先等满起流、再开始转"就一点没省（串行版真写过, 已改回）。
 * 三个**时长**都是积木参数（fwd_ms 交接前盲走 / settle_ms 交接后只对准 / line_ms 交接后沿线走）,
 * 本段只留两个"怎么动"的量 —— 交接阈值与前进速度。
 * ⚠️ 前提是**转弯终点能看到线**; 看不到线时 Pi 会按它的定向找线策略做大横移。
 * ⚠️ 交接**不停车**: 驱动侧残留转速由巡线的第一拍覆盖（省一次停稳再起步）。
 * 标定顺序: HANDOFF_DEG(先小后大, 看落点) → fwd_ms(看相机什么时候看得见线) → FWD_SPEED。 */
#define PIVOT_LINE_HANDOFF_DEG      10.0f       /* 交接阈值 [°] @(0~90) // 转弯误差小于它就把舵交给巡线(陀螺退出)。必须 > PIVOT_TURN_CONVERGE_DEG 否则永不触发; 太大则车还在快速转就松手, 巡线拿到的是一张旋转中的画面 */
#define PIVOT_LINE_FWD_SPEED        60          /* 前进速度 [rpm] @(0~65535) // **两处共用**: ①交接前**盲走**一段(fwd_ms, 不看线) ②交接后**沿线走**(line_ms, 边前进边修)。都用**体坐标系**(vChassisMove 的 v_y, 正=前进), 不走 vChassisMoveWorld 的变换 → 不依赖航向累加器。本值只定快慢, 走多久由积木参数给 */

/* ==================== 原地转弯（四轮绕中心自转 + 陀螺仪闭环, vPidSpinTurn） ==================== */
/* 四个麦轮**对称反向**出力、绕车身中心自转（解算见 app_chassis.c::vChassisMove 的 w 通道:
 * vx=vy=0 时 speed[1..4]=∓w 两组反向, 配合电机 1/2 反装即绕中心自转）。w>0 = 逆时针 = 左转。
 * 与支点转弯的区别: 支点只驱动单侧、车心会平移; 本动作车心基本不动。
 * ⚠️ 四轮对转靠辊子打滑, **同样的轮速下角速度约为支点转弯的 2 倍**（差速自转 ω=2v/轮距）,
 *    且打滑更大 —— 增益**不可**套用 PIVOT_TURN_*（见上面那条警告）, 须实车单独标定。
 * 标定顺序: MAX_SPEED(先压住打滑) → KP(偏差大就加 / 到位后过冲就减) → CONVERGE_DEG(精度)
 * → YAW_SIGN(方向反了改 -1)。 */
#define SPIN_TURN_KP                3.0f        /* 比例系数 @(0~) // 四轮自转出力, 增益须实车标定 */
#define SPIN_TURN_KI                2.0f        /* 积分系数 @(0~) // 默认 0: 自转静差小, 上积分易来回摆 */
#define SPIN_TURN_KD                1.0f        /* 微分系数 @(0~) // 抑制过冲 */
#define SPIN_TURN_MAX_INTEGRAL      7.0f        /* 积分限幅 @(0~) // KI=0 时无作用 */
#define SPIN_TURN_MAX_SPEED         100.0f      /* 自转轮速限幅 [rpm] @(0~) // 直接决定最快角速度; 保守首测, 打滑就先降它 */
#define SPIN_TURN_ACCEL             0           /* 电机加速度 @(0~255) // 0=驱动不插值, 由 50ms 闭环自己平滑; ⚠️落进 uint8_t, >255 静默截断 */
#define SPIN_TURN_PERIOD_MS         50u         /* 闭环节拍 [ms] @(20~200) // 底层 vTaskDelay; 与 PID 任务同节拍 */
#define SPIN_TURN_CONVERGE_DEG      1.0f        /* 到位角度阈值 [°] @(0~) // |err| 连续 N 次小于它即认定到位 */
#define SPIN_TURN_CONVERGE_N        4           /* 到位采样数 @(1~50) // × 节拍 = 稳定窗; 太小会被陀螺噪声骗到 */
#define SPIN_TURN_TIMEOUT_MS        4000u       /* 安全超时 [ms] @(0~) // 超时强制停车; 防 IMU 故障时长转 */
#define SPIN_TURN_MIN_DEG           0.5f        /* 最小转角 [°] @(0~) // 小于此值不发指令直接返回 */
#define SPIN_TURN_YAW_SIGN          (1.0f)      /* 航向符号 // 左转时陀螺仪 yaw 反而变小(装反/符号反)才改 -1; 待实车核对 */

/* ==================== 底盘动作组（时间轴速度混合播放器, app_chassis_action.c, 2026-10 加） ==================== */
/* 一组「世界系平移段 / 陀螺闭环转弯段 / 臂事件」排在时间轴上, 20ms 一拍的速度混合器
 * 连续播放（叠加=向量求和; 直走+转弯叠加=弧线）, 取代「位置模式走一步→停→转一步」。
 * 数据表在 app_chassis_action.c 的数据区（控制台「底盘动作组」Tab 生成）。
 * 增益/限幅分两层（同巡线那套）: 本区宏 = 上电默认, 蓝牙「底盘动作组」的 ch_*
 * 运行时量当场改（20ms 生效）、断电回宏。保护/判据类（CONV/ARM_WAIT/TURN_MS/
 * STALE/ITEMS_MAX）刻意不做运行时量: 安全阀不给无线一键关掉的通路。 */
#define CH_ACT_TIME_SCALE          1.0f        /* 时间系数 k @(0.01~5) // 平移段 mm→时长: 位置模式同款估时 × k = 实际播放时长（同 line_time_scale 的角色: 估时搬到速度模式斜坡带系统偏差, 走过了调小/没走到调大, 落点偏差全折进 k 现场标）。⚠️上电默认: 蓝牙组 ch_time_scale 当场改、下一次播放生效; 控制台排时间轴用宏默认值折算显示 */
#define CH_ACT_HEAD_KP             2.0f        /* 航向环比例系数 [rpm/°] @(0~20) // 转弯段的 PID 比例项 + 航向保持共用（与支点/原地转弯的 KP 同量纲）。⚠️ 纯 P 在目标附近指数减速拖尾 —— 到位慢配 KI, 超调配 KD */
#define CH_ACT_HEAD_KI             0.7f        /* 航向环积分系数 @(0~5) // **只作用转弯段**（保持层仍是纯 P）。与支点/原地转弯同口径: integral += err*KI, 带 ±KI_MAX 限幅。消静差/消拖尾 —— 到位慢就加它, 到位前来回摆就减/关 */
#define CH_ACT_HEAD_KD             0.0f        /* 航向环微分系数 @(0~20) // **只作用转弯段**: (err−上拍err)*KD 直接进输出, 抑制超调 —— 超调就加它/减 KP。⚠️ 20ms 拍比支点/原地转弯的 50ms 快 2.5 倍, 从那边抄增益先除 2~3 试 */
#define CH_ACT_HEAD_KI_MAX         7.0f        /* 航向环积分限幅 @(0~50) // 同 PIVOT/SPIN_TURN_MAX_INTEGRAL 的口径; KI=0 时无作用 */
#define CH_ACT_HEAD_DB_DEG         1.0f        /* 航向保持死区 [°] @(0~10) // 只作用于保持层（转弯段的收敛判据用 CH_ACT_CONV_DEG）, 同巡线陀螺死区 */
#define CH_ACT_W_MAX               100.0f      /* 旋转通道限幅 [rpm] @(0~200) // 转弯/保持的 w 上界。⚠️ 只约束**没设段内 w≤ 的转弯**（段值 >0 时盖过它, 2026-10 改: 段上抬速度必须看得见效果）与航向保持层。保守首测, 打滑先降它 */
#define CH_ACT_WHEEL_MAX           500.0f      /* 四轮转速饱和钳 [rpm] @(0~1000) // |vx|+|vy|+|w| 的保守上界, 超了保 w、平移按余量缩（叠加多段时防超速）。默认给足: 单段速度本身就该在段参数里管 */
#define CH_ACT_CONV_DEG            1.0f        /* 转弯收敛阈值 [°] @(0~) // |err| 连续 N 拍小于它 = 收敛（同支点/原地转弯） */
#define CH_ACT_CONV_TICKS          4           /* 转弯收敛拍数 @(1~50) // ×20ms = 稳定窗; 太小会被陀螺噪声骗到 */
#define CH_ACT_TURN_MS             4000u       /* 转弯防故障兜底 [ms] @(0~) // 单段转弯已转动超过它仍未收敛 = 真故障（机械打滑/增益配错/IMU 停摆期间在转）: 写指令目标+长鸣放行。⚠️ **不是段上限** —— 转弯没有段上限（转到位为止, 组尾等收敛, 2026-10 车主定案）; 正常转弯永远碰不到这个兜底; 0=关（危险: 故障时长转） */
#define CH_ACT_ARM_WAIT_MS         60000u      /* 等臂事件默认上限 [ms] @(0~) // 同臂队列 drain 的 60s 护栏; 超时放行但必须响（表里 ARM_WAIT 的 dur=0 时用它） */
#define CH_ACT_ARM_GRACE_MS        120u        /* 等臂认领宽限 [ms] @(0~1000) // ARM 事件与 ARM_WAIT 同刻时, 臂泵要过一拍才把 busy 抬起来; 没见过 busy=1 前至少等这么久再判「臂已跑空」 */
#define CH_ACT_GYRO_STALE_MS       500u        /* IMU 停摆判定 [ms] @(0~) // 姿态帧号停涨超过它 = 航向权威整拍不出力（0=关, 危险: 误差冻结成常数 w 会一直转）。帧号法, 同巡线 */
#define CH_ACT_TELEM_MS            250u        /* 行内遥测间隔 [ms] @(0~1000) // 播放中按此节拍发 CA: 遥测（t=时间轴 vx/vy=当拍车体速度 w=旋转 h=航向误差 a=权威0无/1保持/2转弯/3支点, !=IMU停摆）—— 调 k 全靠它; 0=关 */
#define CH_ACT_ITEMS_MAX           16          /* 每组条目上限 @(1~32) // 播放器的运行时状态数组按它静态分配; 超了整组拒绝(长鸣) */
#define CH_ACT_LOOP_MS             20u         /* 播放器节拍 [Hz] {ms->Hz} @(5~200) // 底层 20ms（同巡线: 一拍 4 条 EMM 速度帧 ≈8.4ms 忙等 + 延时, 20ms 是验证过的预算, 别更快）; 控制台时间轴的吸附网格也是它 */

/* 支点转弯段（CH_ACT_KIND_PIVOT）的航向 PID —— 出厂值直接**引用** PIVOT_TURN_*
 * （现场标定过的那一套; 「调参」Tab 改支点转弯增益, 这里跟着变）, 蓝牙
 * 「底盘动作组」的 ch_pivot_* 当场改、断电回此引用值。20ms 拍 vs 支点转弯
 * 的 50ms: 同名增益出力更猛, 现场从 PIVOT_TURN_* 抄到 ch_pivot_* 先除 2~3 试。 */
#define CH_ACT_PIVOT_KP            (PIVOT_TURN_KP)        /* 支点段 P */
#define CH_ACT_PIVOT_KI            (PIVOT_TURN_KI)        /* 支点段 I（现场实测有意开启, 消单侧驱动静差） */
#define CH_ACT_PIVOT_KD            (PIVOT_TURN_KD)        /* 支点段 D */
#define CH_ACT_PIVOT_KI_MAX        (PIVOT_TURN_MAX_INTEGRAL)   /* 支点段积分限幅 */
#define CH_ACT_PIVOT_W_MAX         (PIVOT_TURN_MAX_SPEED) /* 支点段驱动侧轮速限幅 [rpm] */

/* ==================== RPI 通信 ==================== */
#define RPI_HANDSHAKE_CONFIRM_MS    3000u       /* 握手静默确认窗 [ms] @(2500~) // 须大于 Pi 端 2.5s 重发周期 */
#define RPI_DISCONNECT_TIMEOUT_MS   8000u       /* 心跳超时判定 [ms] @(6000~) // 须 > Pi 二维码阻塞(~6s) */

/* ---- 链路不通时挂起任务 / 自动重启 Pi 客户端（2026-09 加, 见 app_rpi.c 的
 *      ucRpiSendTaskCmdWait）----
 * ⚠️ RPI_LINK_RETRY_TIMEOUT_MS 与 RPI_DISCONNECT_TIMEOUT_MS **没有大小关系**:
 *    计时从**投递任务那一刻**起算, 不是从链路翻转起算（等待者只在链路已经不是 OK 时才等）。
 *    真正的硬下界是 RPI_HANDSHAKE_CONFIRM_MS —— 小于它会在 Pi 刚起来、正走握手静默窗时
 *    又去打断它 → 自激成"无限重启"。 */
#define RPI_LINK_RETRY_TIMEOUT_MS   6000u       /* 等链路重连超时 [ms] @(1000~60000) // 等超过它就发一对 "r" 让 Pi 重启客户端程序, 往复不封顶(只靠中止位退出); ⚠️等待时间**不进**积木的 I(0); ⚠️Pi 收到 "r" 是"关串口→等 20s→原地重启"(serial_comm.restart_program), 一次成功恢复要 20s+, 期间本端还会白发几对(丢在已关的端口上) —— 判"成功没有"看 rpi_rx_bytes 恢复 / rpi_link 变 1, 别看 rpi_link_retry 涨多快 */
#define RPI_RESTART_CONFIRM_GAP_MS   500u       /* "r" 双发间隔 [ms] @(100~3000) // Pi 侧 _require_double_send 要"两次操作各一帧"才执行(handler.py:795 对 "r" 同样门控), 所以两帧必须分开发; 一次调用里连发两帧会被只登记不执行; 上界是 Pi 的 SYSTEM_CMD_CONFIRM_S(默认 10s), 超了第一帧作废 */
#define RPI_SYSCMD_SUPPRESS_MS     60000u       /* 危险系统指令抑制窗 [ms] @(0~) // 本端发过 sd/rb 后这么久内不自动重启 Pi。**已核实是冗余护栏**: Pi 的确认门 _system_cmd_arm/_last 是**以指令为键**的 dict, 不同指令各记一份, 凑单不可能发生 —— 留着是防那边哪天改成全局单槽。0=关掉 */
#define RPI_HEALTH_TIMEOUT_MS      12000u       /* 健康检查超时 [ms] @(3000~30000) // 握手积木勾了「健康检查」时, 发 "Z" 后最多等这么久(阻塞, 期间脚本不会往下走); Pi 依次开主摄/扫码副摄/CSI/OpenMV 各出一帧, 冷开约 1.5~2s/台, 12s 够四台 + 余量。⚠️Pi 预算 = 本值 − CMD_MARGIN_S(1.5s), 调小到 8s 以下会不够 CSI 冷启动; 超过 RPI_DISCONNECT_TIMEOUT_MS(8s) 时链路会在检查中期闪一次 Disconnected(结果到达即自愈, 不是故障) */

/* ==================== 巡线闭环（Pi 端 steer → 横移 vx, 收敛） ==================== */
/* 读 Pi 端 LinePID 算好的 steer（巡线帧）, 映射为麦轮横移速度消除横向偏差 err。
 * 符号/速度/收敛阈值均待实车标定: 转向反了改 LINE_VX_SIGN; 过头改 LINE_STEER_TO_VX。
 * ⚠️ 增益/死区/限幅/方向分两层（2026-10-06 起, 同 BALL_* 那套）: 本区宏 = 上电默认
 *    (持久), 蓝牙 Tab「巡线」组的**同名量** = 当场生效(断电回宏) —— 现场标定走蓝牙
 *    零重编译, 闭环每拍现取(20ms 生效), 标好把终值写回宏固化。
 *    保护类窗口量（本区 LINE_STALE_TIMEOUT_MS / LINE_FIRST_FRAME_TIMEOUT_MS 与
 *    LINE_GYRO_STALE_MS）与收敛判据（LINE_CONVERGE_* / LINE_CE_*）**刻意不做**
 *    运行时量: 安全阀不给无线一键关掉的通路, 判据有跨参约束（阈值 ≥ 死区）。 */
#define LINE_FIRST_FRAME_TIMEOUT_MS  2000u       /* 等 Pi 起流超时 [ms] @(0~) // ucRpiLineConverge 发 LINE_START 后等巡线帧计数变化; 超时=拒绝且不动车（不响, 留痕）; 0=不等直接进闭环 */
#define LINE_STALE_TIMEOUT_MS        2000u       /* 帧新鲜度超时 [ms] @(0~) // 帧号超过它没变=Pi 停发/掉线→停车; Pi 30Hz 一帧≈33ms, 2000ms≈连丢 60 帧——取这么宽是给 Pi 忙时(YOLO/日志)的帧停顿留余量; 代价=掉线后按最后一帧 steer 最多多走 ~0.8m(LINE_VX_MAX≈0.4m/s), 嫌大可实测压到 1000; 0=关闭保护(危险) */
#define LINE_LOOP_PERIOD_MS          20u         /* 闭环节拍 [Hz] {ms->Hz} @(5~200) // 底层 20ms; Pi 巡线帧是 30Hz, 每帧约被读 1~2 次 */
#define LINE_LIVE_TELEM_MS           250u        /* 行内遥测间隔 [ms] @(0~1000) // 巡线闭环**过程中**按此节拍往 Pi 日志发一行 LV: 遥测（t=已走时间 e=横向偏差 h=航向误差 vx/w=当拍横移/旋转指令 f=前进分量 v=是否在线）——「巡线直走」这类边走边修的步骤, 光看步末的 LW:/LINE: 根本看不出过程中纠正在哪, 这条就是过程录像; 0=关。⚠️步末汇总仍是 LINE:/LW:, 两者互补 */
#define LINE_END_YAW_DBG             1           /* 步末记录 Yaw @(0~1) // 巡线闭环（收敛 / 直走 / 支点接管的沿线段）**结束**时往 Pi 日志发一条 `LINE yaw: <当前Yaw>` —— 把每段收尾的世界航向排在一起看, 看陀螺漂移、看这一段把车转歪了多少; 记录的是**工作航向**(与 OLED/各闭环同一个数, 已扣看路校准偏置)。0=关(一条都不产生, 与加这个开关之前逐字节一致) 1=开 */
#define LINE_STEER_TO_VX             30.0f       /* steer→横移速度映射 [rpm/单位] @(0~) // **原地对准组**: 巡线收敛 / 支点接管 settle 段用。待标定。⚠️上电默认: 蓝牙「巡线」组 line_steer_to_vx 当场改(零重编译)、断电回本值 */
#define LINE_WALK_STEER_TO_VX        50.0f       /* 边走边修 steer→横移映射 [rpm/单位] @(0~) // **边走边修组**: 巡线直走 / 支点接管沿线段专用（iFwdRpm≠0 的段）。前进本身会让横向偏差发散, 同样的 err 要比原地对准更强的横移才修得住 —— 所以与上面那组**分开各调各的**（出厂=同值=行为不变, 现场按 LV: 遥测往上加）。⚠️Pi 端 LINE_KP 两个场景共用, 直走要更猛只调本值; 横移限幅 LINE_VX_MAX 两组共用。⚠️上电默认: 蓝牙「巡线」组 line_walk_steer_to_vx 当场改、断电回本值 */
#define LINE_VX_SIGN                 (+1.0f)     /* 横移方向 // 转向反了改 -1; 待标定。蓝牙「巡线」组 line_vx_sign 当场改、断电回本值 */
#define LINE_VX_MAX                  60.0f       /* 横移速度限幅 [rpm] @(0~) // 保守。⚠️上电默认: 蓝牙「巡线」组 line_vx_max 当场改、断电回本值 */
#define LINE_TIME_SCALE              0.36f       /* 直走时间系数 @(0.01~5) // 「巡线直走」的 mm→时间换算倍率: 估时(ms) × 本值 = 实际闭环时长。⚠️这里只是**上电默认**: 运行时量 line_time_scale(蓝牙「巡线」组)当场改、断电回本值。估时是位置模式的梯形公式, 搬到速度模式斜坡上带系统偏差(实测偏长) → 现场标定: 走过了就调小(<1)、没走到就调大(>1) */
/* --- 第二闭环: 航向环（交界线倾角 或 陀螺世界航向 → 麦轮旋转 w） --- */
/* 与位置环正交: vx 管"横着偏多少", w 管"斜了多少"。角速度 w 在 vChassisMove 的麦轮
 * 解算里与 vx 叠加（speed[] = ±vx ±vy ∓w），所以两条环共用一次下发。
 * ⚠️ 航向环是**纯 P、无微分**: 摆振就把**那条源**的增益（LINE_CAM_TO_W / LINE_GYRO_TO_W）
 *    绝对值调小（别指望调大能稳住）。 */
#define LINE_ANGLE_TARGET_DEG        -2.3f       /* 目标图像角 [°] @(~90) // **相机那条的目标**: 相机报出的「交界线倾角」该维持在多少 —— 0=与线平行; 相机装歪几度就填几度(补偿安装)。属**安装标定**, 现场基本不动, 所以只留蓝牙/本宏两条路(没有积木参数)。⚠️本宏只是**上电默认值**: 蓝牙 Tab 的 line_angle_target 当场改(零重编译), 断电才回本值。⚠️名字里的 ANGLE 指"图像角", 与蓝牙量 line_angle_target 同名同义(要改一起改), 不是"相机"那两个字 */
#define LINE_CAM_TO_W                (-3.0f)     /* 相机增益 [rpm/°] @(-5~5) // **原地对准组**: 巡线收敛 / 支点接管 settle 段用。**有符号**(负=反向): 老 LINE_W_SIGN(−1.0f) 已折进本值, 所以 −2.0f 与改造前的 2.0f×(−1.0f) **逐位等价**(乘 ±2.0f 只是指数移位, 无舍入)。摆振就调小绝对值。⚠️上电默认: 蓝牙「巡线」组 line_cam_to_w 当场改(零重编译)、断电回本值 */
#define LINE_WALK_CAM_TO_W           (-2.0f)     /* 边走边修组相机增益 [rpm/°] @(-8~8) // **巡线直走 / 支点接管沿线段专用**（iFwdRpm≠0 的段）。歪头前进时旋转环是把车扳平的唯一手段, 而图像角被透视压缩(真偏角≈图像角×3): 实测 h=-3° 只出 w=6rpm, 210rpm 前进下发散追不上修正——「直走看着不纠偏」的主因就是它。与上面**原地对准组分开各调各的**（出厂=同值=行为不变, 现场按 LV: 的 h/w 列往上加绝对值, 建议先 -4）。⚠️上电默认: 蓝牙「巡线」组 line_walk_cam_to_w 当场改、断电回本值 */
#define LINE_CAM_DEADBAND_DEG        0.8f        /* 相机死区 [°] @(0~) // 小于此角不修正: 相机角分辨率 0.1° 且有噪声, 没死区四个轮子会一直微调抖。**量纲是图像角**(与陀螺那条的真角度不是一回事, 数值别互抄)。蓝牙「巡线」组 line_cam_db_deg 当场改、断电回本值 */
#define LINE_W_MAX                   50.0f       /* 旋转速度限幅 [rpm] @(0~) // 两条源、对准/边走边修两组**共用**; 保守。⚠️上电默认: 蓝牙「巡线」组 line_w_max 当场改、断电回本值 */
/* --- 航向环的信号源（2026-10-30 起**全局**化; 2026-10-08 加回**输出端加权**的融合档 src=3） ---
 * 航向源是全局的: 「调参」Tab 的 LINE_CONV_SRC（出厂 3=融合），六种巡线积木统一听它。
 * ⚠️ 2026-10-30 起 `src` / `cam_pct` **不再是积木参数**（map.c 老行已按新布局重写）:
 *    要逐段换源只能改本宏重编译 —— 过雪弗板那种「这一步设为不修」的排法不再支持。
 *   ① 相机(src=0):        err_cam  = 图像角 − LINE_ANGLE_TARGET_DEG  （图像角尺度, 贴着线走）
 *   ② 陀螺(src=1):       err_gyro = 短弧(本目标 − yaw)              （真角度, 咬住一个世界航向）
 *   ③ 不修(src=2)        只修位置, 航向环出力恒 0（交界被遮挡等场合）
 *   ④ 融合(src=3):       两条**各自走完自己的环**（误差→死区→各自增益）, 最后只把两个**输出 w**
 *                        按 LINE_CAM_PCT:(100−LINE_CAM_PCT) 加权 —— 陀螺仪会漂、相机量的是
 *                        场地角度, 现场要的正是"信相机多些、陀螺兜底"的折中。
 * 目标由人给(绝对世界航向, 零点=开机那一刻的车头朝向, 与 STEP_SPIN_TURN_WAIT 的 absolute=1 同口径)。
 * ⚠️ **不叠加、不互相降级**: 选中的源不可用时那一拍**就是没有它的修正**（位置环照旧听 Pi 的 steer）
 *    —— 相机那条丢线(valid=0)如此, 陀螺那条 IMU 停摆(姿态帧号停涨)也如此。融合档里表现为
 *    "该源本拍出 0 力、另一源仍按自己的权重出力", **不**把空出的权重补给对方（补给 = 增益台阶
 *    40%↔100% 跳变, 会抖）。⚠️ 2026-10-30 起 src 全局化: 丢线多的段落只能把 LINE_CONV_SRC
 *    改成 1(陀螺) 重编译, 不能再逐块排 src=陀螺。
 * ⚠️ **两条量纲不同**(图像角 vs 真角度: 地面线的倾角被透视压缩, 差约 3.3 倍), 所以增益/死区
 *    **各一套**, 数值不要互相套用; 两条的**符号也各自独立**(相机那条的正方向由相机脚本定)。
 * ⚠️ **陀螺那条是"保持航向", 不是"跟线"**: 线与车头不一致时车会**斜着平移**（位置环在修横向
 *    偏差, 但航向咬在目标角上）。要沿线拐弯只能用相机那条, 或者按段改目标角。
 * ⚠️ 陀螺那条的"绝对"只相对**开机朝向**: 中途转过向的段落要按 OLED 第 1 页读到的 Yaw 填
 *    （标签随当前姿态源变: ATK / HWT / M0, 见 app_oled.c 状态页）,
 *    别按"我转了 90° 所以现在是 90"推。
 * ⚠️⚠️ **删除记录（2026-09 定案）**: 这里原来是两条误差**加权平均**（权重 line_gyro_w %,
 *    靠 LINE_GYRO_SCALE 把真角度换算成图像角尺度）。那条路有一个**能翻符号的闭环增益**:
 *    尺的符号标反时两条从"相加"变成"相减", 加权系数 `k − w(k+|s|)` 越过零点之后
 *    **负反馈变正反馈** —— 车顶在 LINE_W_MAX 上朝一个方向无限转（现场实测: 权重开到 50% 以上
 *    就犯, 而那个宏是出厂 1.0、从来没标定过）。所以砍掉融合、改成积木级二选一,
 *    三个宏（LINE_GYRO_W_PERCENT / LINE_GYRO_SCALE / LINE_W_SIGN）随之删除。
 *    ⚠️ 2026-10-08 加回的融合档(src=3)**不是**把那条路改回去 —— 旧法在**误差端**加权,
 *    必须先跨量纲换算（可翻符号的尺由此而生）; 新法在**输出端**加权, 两条各自的符号折在
 *    各自的增益里（单源档各自标定过）, 凸组合没有可翻的符号（详见 app_line.c 融合分支）。
 *    **误差端加权/跨源换算尺仍然禁止加回来。 */
#define LINE_GYRO_TARGET_DEG         -0.4f       /* 陀螺目标角 [°] @(-180~180) // **陀螺那条的目标** = 我要的世界航向(零点=开机朝向, 同绝对转弯): 0=保持开机朝向。⚠️由各巡线积木的 angle/gyro_target 参数给(每步一个; 是否采用由全局 LINE_CONV_SRC 决定), 蓝牙可当场覆盖; 本宏只是上电默认 */
#define LINE_GYRO_TO_W               (5.0f)      /* 陀螺增益 [rpm/°] @(-5~5) // **原地对准组**: 巡线收敛 / 支点接管 settle 段用。**有符号**(负=反向, 与相机那条各自独立): 起手值 ≈ 相机增益 × 0.3（透视压缩比, 球那边实测 1/3.3）。台架掰一下车确认方向与大小 —— 方向反了车会**越修越偏**。⚠️上电默认: 蓝牙「巡线」组 line_gyro_to_w 当场改(零重编译)、断电回本值 */
#define LINE_WALK_GYRO_TO_W          (-0.6f)     /* 边走边修组陀螺增益 [rpm/°] @(-8~8) // **巡线直走 / 支点接管沿线段专用**（iFwdRpm≠0 的段）, 与上面**原地对准组分开各调各的**（出厂=同值=行为不变）。全局 LINE_CONV_SRC=1 的直走段用本值。⚠️上电默认: 蓝牙「巡线」组 line_walk_gyro_to_w 当场改、断电回本值 */
#define LINE_GYRO_DEADBAND_DEG       0.2f        /* 陀螺死区 [°] @(0~) // 量纲是**真角度**(不是图像角); IMU 分辨率远好于相机, 但留一点防微抖。蓝牙「巡线」组 line_gyro_db_deg 当场改、断电回本值 */
#define LINE_GYRO_STALE_MS           600u        /* IMU 停摆判定窗 [ms] @(0~) // 陀螺那条要求 IMU 在喂数: **姿态帧号**在这段时间里一点不涨 = 陀螺停摆 → 本拍不修航向(选它就是因为要它, 没有别的源可退)。⚠️**陀螺模式下设 0 = 关掉这道保护**: yaw 冻在旧值 → 误差恒定 → 车按常数 w 一直转。取值 ≥ ATK 驱动一次阻塞读的超时(500ms) + 余量 */
#define LINE_CONV_SRC                1           /* 收敛航向来源 @(0~3) // 六种巡线积木共用(巡线收敛/直走/支点·自转接管/色球·人质单动作抓取 mode=2); **不再是积木参数**。0=相机(贴线走) 1=陀螺(咬各步 angle/gyro_target) 2=不修(只修位置) 3=融合(按 LINE_CAM_PCT 加权)。⚠️编译期量, 改完重编译烧录; 选项:0=相机 1=陀螺 2=不修 3=融合 */
#define LINE_CAM_PCT                 40.0f       /* 融合相机占比 [%] @(0~100) // **仅 LINE_CONV_SRC=3(融合) 参与**: 两个输出 w 按 相机:陀螺 = 本值:(100−本值) 加权。0=全听陀螺、100=全听相机; 陀螺会漂 → 相机该占大头, 出厂 50(与当前主路线一致)。两源的误差量纲不同(图像角/真角度), 所以**没有**"占比该配多少才等效"的换算 —— 折中点按 LV: 遥测现场试。⚠️**不再由积木逐块写**: 六种巡线积木一律传 LINE_CAM_PCT_KEEP, 本宏只是 Beam 上电默认; 蓝牙「巡线」组 line_cam_pct 当场改(零重编译)、断电回本值 */
#define LINE_CONVERGE_ERR_THRESHOLD  0.05f       /* err 收敛阈值 @(0~) // 归一化; 配合下面采样数决定是否提前退出 */
#define LINE_CONVERGE_SAMPLES        0           /* 提前退出采样数 @(0~255) // 0=不提前退出(跑满 converge_ms); 连续 N 次 |err|≤阈值即提前收敛, 计数器是 uint8_t */
#define LINE_CONV_OVERTIME_MS        1500u       /* 超时收敛时间 [ms] @(0~) // 「巡线收敛」积木勾了"启动即返回"时专用: 收敛时长内没判到收敛就再给这么久的**超时收敛**, 期间判到随时走, 到点仍未收敛才强制结束。0=不允许超时(没收敛也准时走)。⚠️勾"否"的积木本值完全不参与(跑满收敛时长, 老行为); "怎么算收敛"在下面「巡线收敛增强」区配 */

/* --- IF 条件「巡线是否在线上」的主动探测（app_script.c::c_ucCondLine → app_rpi.c::ucRpiLineProbe） --- */
/* 起流 → 数窗口内的有效帧 → 收流; 车不动, 只问 Pi 一句「现在还看得见线吗」。
 * ⚠️ dt 是**全局**的, 不是每个 IF 积木各自的 —— 探测窗口是 Pi 帧率的物理属性, 不随路线位置变。 */
#define LINE_PROBE_MS             150u       /* 巡线探测窗口 [ms] @(50~500) // 发 LINE_START 后等这么久再发 LINE_STOP */
#define LINE_PROBE_MIN_VALID      1u         /* 在线上判据 [帧] @(1~10) // 窗口内 valid=1 的**帧数**达到几才算「在线上」（不是采样次数）; 150ms 窗口 @30Hz 大约只有 5 帧, 设得比这高会永远失败且不报错; 实测丢线帧占比很高, 别定成「帧帧有效」 */

/* ==================== 巡线收敛增强 ==================== */
/* 「巡线收敛」积木勾「启动即返回=是」后不再死跑 converge_ms, 而是逐拍用下面这套判据
 * 认定"收敛完成": 位置误差达标 **且** 航向误差达标(按该积木 src 选中的源判, 阈值 0=
 * 不判航向), **连续**保持 LINE_CE_STABLE_MS → 提前返回(实际耗时落在 0 < t < 收敛时长);
 * 收敛时长内没判到 → 再给 LINE_CONV_OVERTIME_MS(上面「巡线闭环」区)的超时收敛, 期间
 * 判到随时走。勾"否"的积木这些全不参与, 与加这套之前逐字节一致。
 * ⚠️ LINE_CE_POS_TH 是**总闸**: 它 = 0 → 判据全关, 积木就算勾了"是"也按老行为跑满
 *    (防"判据没配好就一块块秒过"的空转)。
 * ⚠️ 航向阈值必须 **≥ 对应源自己的死区**(LINE_CAM_DEADBAND_DEG / LINE_GYRO_DEADBAND_DEG):
 *    控制器在死区内不出力, 误差压不进比死区更小的阈值 → 永远判不到收敛 → 每次都白吃满超时。
 * ⚠️ 判据只在 valid=1 的帧上累加, 丢线/IMU 停摆那一拍直接算"不满足"并清零稳定窗 ——
 *    Pi 起流盲期发的就是 valid=0 的帧(tasks/_line.py), 不会被上一次运行的陈旧快照骗成"已收敛"。
 * ⚠️ 只影响「巡线收敛」积木; 支点转弯接管 / 巡线直走 / 单动作抓取里的并行收敛都传"否",
 *    仍是老行为。老的 LINE_CONVERGE_ERR_THRESHOLD/SAMPLES 保持不动(见上, SAMPLES 必须 0)。 */
#define LINE_CE_POS_TH              0.05f       /* 位置误差阈值 @(0~) // 归一化 |err| ≤ 它算位置到位(与 LINE_CONVERGE_ERR_THRESHOLD 同量纲); **0=总闸**, 关掉后整套增强不启用 */
#define LINE_CE_ANG_TH_CAM          1.0f        /* 相机航向阈值 [°] @(0~) // **图像角**尺度 |图像角−目标| ≤ 它算航向到位; 0=不判航向。⚠️须 ≥ LINE_CAM_DEADBAND_DEG(1.0): 压不进死区的误差判不到收敛 */
#define LINE_CE_ANG_TH_GYRO         0.5f        /* 陀螺航向阈值 [°] @(0~) // **真角度**尺度 |目标−yaw| ≤ 它算航向到位; 0=不判航向。⚠️须 ≥ LINE_GYRO_DEADBAND_DEG(2.0)。与相机那条量纲不同, 数值别互抄 */
#define LINE_CE_STABLE_MS           100u        /* 稳定窗 [ms] @(0~) // 上面两条**连续**满足这么久才算收敛完成(按 20ms 拍取整); 0=一拍满足即走。防单帧毛刺/相机角噪声把"没对齐"骗成"对齐了" */

/* ==================== 色球识别（排爆区, Pi HSV → 开环横移对位） ==================== */
/* 一次性识别红/绿/蓝三球的顺序与中心坐标（Pi 端 TAG=0x03 帧, 见 app_rpi.h）。
 * STM32 按二维码首位查出目标色在左/中/右, 换算横向位移做**开环位置移动**
 * （不做视觉伺服闭环: 摄像头锁 30fps, 闭环滞后太大）。
 * 用「蓝牙」Tab 的 color1/2/3_x/y 遥测读实拍坐标, 不用反复烧录。 */
/* ⚠️ 本组是**开机默认值**: 小球对位的全部标定量已做成 Beam 运行时量, 蓝牙 Tab
 * 「小球对位」组当场可改(零重编译); 这里改的值只决定上电初值(持久)。现场标定走
 * 蓝牙, 标好把终值写回这里固化。 */
#define BALL_ALIGN_YAW_EN         0         /* Yaw修正开关 @(0~1) // 1=对位时同时按三球连线角转正(转完自动复测一次); 0=只修横/纵移。运行时开关=蓝牙 ball_yaw_en, 本宏只是上电初值 */
#define BALL_CX_CENTER            926.0f    /* 理想停止位中球列 [px] @(0~1920) // 对位基准: 中间球应停到的像素列; 标定法=车摆理想停止位发一次5, 蓝牙Tab读 color2_x; 运时量=蓝牙 ball_cx_center */
#define BALL_CY_CENTER            408.0f    /* 理想停止位中球行 [px] @(0~1080) // 同上读 color2_y; ⚠️必须现场标定, 默认 540 只是画面中心, 差 100px 就会纵移 100mm; 运时量=蓝牙 ball_cy_center */
#define BALL_PX_TO_MM_X           0.3f      /* 横向比例 [mm/px] @(0.01~5) // 中球 cx 偏差→车体横移 mm; 初值同 BALL_PX_TO_MM_Y, 现场标定; 运时量=蓝牙 ball_px_to_mm_x */
#define BALL_PX_TO_MM_Y           0.3f      /* 纵向比例 [mm/px] @(0.01~5) // 中球 cy 偏差→车体纵移 mm; 纵向角分辨率低, 预期明显大于横向; 运时量=蓝牙 ball_px_to_mm_y */
#define BALL_YAW_SCALE            1.25f     /* 图像角→车体角倍率 @(0.5~10) // 车体角=三球连线**图像**角×本值 ≈ Z/h; ⚠️不是1.0(图像角≠车体角, 车转3°图像只斜~1°); 标定法=垫转已知角读 ball_yaw 反算; 运时量=蓝牙 ball_yaw_scale */
#define BALL_YAW_SIGN             (-1.0f)   /* 转正方向 // 转反了改 -1; 运时量=蓝牙 ball_yaw_sign */
#define BALL_YAW_TARGET_DEG       2.5f      /* 理想角度 [°] @(-90~90) // **理想停止位下三球连线角的读数**(图像角, 就是蓝牙 ball_yaw 那个数): 对位时按 (实测−本值) 转正, 而不是死按 0。标定法=车摆理想停止位跑一轮读 ball_yaw 填进来(相机装歪/地面不平都会让它非 0); 运时量=蓝牙 ball_yaw_target */
#define BALL_YAW_DEADBAND_DEG     1.0f      /* 车体角死区 [°] @(0~) // 小于此值不转正; vPidSpinTurn 收敛带本身±1°, 设更小无意义; 运时量=蓝牙 ball_yaw_db_deg */
#define BALL_DX_DEADBAND_MM       3.0f      /* 横移死区 [mm] @(0~) // 小于此值不横移; 运时量=蓝牙 ball_dx_db_mm */
#define BALL_DY_DEADBAND_MM       3.0f      /* 纵移死区 [mm] @(0~) // 小于此值不纵移; 运时量=蓝牙 ball_dy_db_mm */
#define BALL_SIDE_SIGN            (1.0f)    /* 横移方向 @(-1~1) // 车横移方向反了改 -1; 现场标定。⚠️编译期量(无蓝牙运时量): 小球对位链与矩形板心方案共用（矩形整套复用小球那套标定, 见「矩形板心对位」段） */
#define BALL_FWD_SIGN             (-1.0f)   /* 纵移方向 // 车纵移方向反了改 -1; 运时量=蓝牙 ball_fwd_sign */
#define BALL_XY_SWAP              1         /* XY整体对调 @(0~1) // 0=图像X→车体横移(cx驱动)、图像Y→车体纵移(cy驱动); 1=连轴带系数整套对调: 横移改由cy驱动、纵移改由cx驱动, 两路mm/px增益也换过来用(相机相对车体装了90°时的情形)。⚠️对调后方向符号可能也要翻: 横移看 BALL_SIDE_SIGN、纵移看 BALL_FWD_SIGN; 运时量=蓝牙 ball_xy_swap */
#define BALL_ALIGN_ACCEL          120       /* 对位加速度 @(0~255) // ⚠️落进 uint8_t, >255 会静默截断; 运时量=蓝牙 ball_accel */
#define BALL_ALIGN_SPEED          60        /* 对位速度 [rpm] @(0~65535) // 保守首测; 运时量=蓝牙 ball_speed */
#define BALL_PULLBACK_MM          180.0f    /* 缺球拉回距离 [mm] @(0~500) // ALIGN_PULLBACK 用: 只认出两球且推断也失败(Pi 失败帧带方向)时沿排开环倒回的距离, 走完重扫三球。≈一颗球间距(554px×0.34mm/px≈188)取整; 不求准——把球排弄回画面即可, 精对位交给重扫后的三球方案; 现场按"拉一次球排回画面"微调; 运时量=蓝牙 ball_pullback_mm */

/* ⚠️ 下面这对是**编译期**量（同 ROAD_LED_OFF_EN 的形态, 不进蓝牙组）: 行为开关不是标定值,
 *    改完重编译即可。 */
#define BALL_LED_OFF_EN            1         /* 色球识别前关 OpenMV 补光 @(0~1) // 1=色球单动作抓取**识别段**（扫描/拉回重扫/转正复测）之前先把 OpenMV 的补光灯临时关掉 —— 2026-10-30 场地换边后它的 LED 热点进了主摄视野、冲淡色球识别的 HSV 阈值; 识别结束（拿到结果或放弃）立刻恢复成 Pi 配置里记住的亮度, 后面 mode=2 的并行收敛/路线巡线照常用灯。0=不碰补光灯（老行为一字不变）。⚠️ 只覆盖色球抓取的识别段（识别期间 OpenMV 流是停的, 灭灯对它无感; 任何巡线起流 Pi 也会自动把灯点回, 显式恢复是双保险） */
#define BALL_LED_OFF_DELAY_MS      400u      /* 关灯后延时 [ms] @(0~2000) // **只在上面 =1 时生效**: 关灯之后先等这么久再发 "5" —— 给主摄**自动曝光**留出适应"灯灭了"的时间（色球识别是 HSV 阈值, AE 追稳前那几帧颜色会漂, 而标定是开灯时做的; 机理与 ROAD_LED_OFF_DELAY_MS 完全同款, 400 是那边的实测起点）。⚠️ 只在识别段**进门**等一次, 段内重扫（拉回后/转正后）不重复等; 纯阻塞等待（vTaskDelay 让出式, 不查中止位 —— 有界固定时长, 同看路那对的口径）, 不占积木 I(0) 超时预算（那个是发 "5" 之后才起算）。0=不等 */

/* ==================== 矩形板心对位 ==================== */
/* 「色球对位」积木的多方案链里 ALIGN_RECT 那一档（STEP_BALL_ALIGN_WAIT → ucRpiAlignChain）
 * 用的标定量：板子在画面里的中心该停在哪。
 * ⚠️ **本段只有两个量** —— 比例尺/方向/XY对调/加减速**整套复用小球那一套**
 *    （同一台相机、同一个停车位、同一个平面 ⇒ mm/px 与方向符号都可迁移）：
 *    ball_px_to_mm_x/y、BALL_SIDE_SIGN、ball_fwd_sign、ball_xy_swap、
 *    ball_dx/dy_db_mm、ball_accel/speed。
 * ⚠️ 必须和 ball_cx/cy_center **在同一个停车位姿下**标定：两种方案的测量定义不同
 *    （量胶带内沿 vs 中线, 实测差 ~15px≈5mm），那点差会被各自的中心量**天然吸收**
 *    —— **不要**再去加什么补偿量, 补偿反而给矩形方案引入 5mm 系统偏移。
 * 标定法：车摆理想停止位 → 蓝牙 Tab 读 rect_cx/rect_cy → 把读数填进下面两个宏（或蓝牙当场改）。 */
#define RECT_ALIGN_CX             896.0f    /* 理想板心列 [px] @(0~1920) // ⚠️**0 = 未标定**: 未标定时矩形方案会拒绝执行（不响, 留痕 —— 链内统一静音; 不给假数、不动车）; 运时量=蓝牙 rect_cx_center */
#define RECT_ALIGN_CY             465.0f    /* 理想板心行 [px] @(0~1080) // 同上, 0 = 未标定; 运时量=蓝牙 rect_cy_center */

/* ==================== 人质对位（人质区） ==================== */
/* 链路（脚本步骤 STEP_HOSTAGE_ALIGN_WAIT → ucRpiHostageAlign）:
 *   发 RPI_TASK_HOSTAGE("4") → Pi 回 TAG=0x02 帧（三只人质的形状 + 中心像素,
 *   已按 cx 升序 = 图像从左到右）→ 取**参数指定的那一只**(0左/1中/2右)作基准
 *   → 它的 cx/cy 偏差 → 车体横移/纵移到位。与小球对位同构, 差别只有三处:
 *     ① 基准人质由**积木参数**给（小球固定取中间那颗）;
 *     ② **不做转正** —— 0x02 帧没有 yaw/fit_ok 扩展字段, 而圆柱/圆锥/腰鼓三种
 *        形状的质心高度本身就不同, 三点连线角会被形状污染, 固件硬算会越转越歪。
 *        要做必须先在 Pi 端给 0x02 帧加扩展字段(照抄色球帧的做法), 不是本端能单独完成的;
 *     ③ 调试串前缀 "HSTG"（小球是 "BALL"）, Pi 日志里一眼分得清是哪一段在跑。
 *
 * 标定量**独立成一套**（不与 BALL_* 共用）: 人质区的停止位姿与球区不同, 两边共一套
 * 会互相打架。全部做成 Beam 运行时量, 蓝牙 Tab「人质对位」组当场可改(零重编译),
 * 断电回本组宏的上电初值; 「调参」Tab 改的是持久默认。
 * ⚠️ 现场标定顺序: HOSTAGE_CX/CY_CENTER（车摆理想停止位跑一轮读遥测）→
 *    HOSTAGE_SIDE_SIGN / HOSTAGE_FWD_SIGN（方向对不对）→ HOSTAGE_PX_TO_MM_X/Y（走多少）。
 *
 * ⚠️⚠️ **超时值由路线表积木参数 timeout_ms 给（现用 7500）, 别照抄小球那套的 6000**（实测踩过:
 *   Pi 打印「人质识别成功 (368,889) (785,859) (1139,840)」的同一刻, 本端打
 *   `HSTG fail: wait(t=6000ms) st=0 cnt=0`, 紧接着 `COORD tag=2 len=18` —— 结果帧迟到
 *   几百毫秒, 正好卡在超时外面）:
 *      人质检测是**主摄 YOLOv8 ONNX 跑 CPU**（~1.5s/帧, 凑满 3 个才算成功, 实测要 ~5s）,
 *      而小球的色球识别是 HSV 掩膜（亚秒级）—— 同一个 6000 对前者根本不够。
 *    下限 = Pi 的 HOSTAGE_TIMEOUT（config.py, 默认 6.0s, **Web「设置参数」里可改**）
 *          + 摄像头打开（_open_hostage_with_retry, 实测 ~1s; Web 正在推流时更久）
 *          + 结果帧发送 ≈ 7.1s  →  取 **7500**（~400ms 余量）。
 *    上限 = RPI_DISCONNECT_TIMEOUT_MS(8s): 这条命令是**阻塞**的, 期间 Pi 不发心跳,
 *          本端超过 8s 无帧会把链路判成 DISCONNECTED —— 对本次对位**无害**（结果帧一到
 *          就恢复 OK, 帧解析也不看链路态, 见 app_rpi.c::vRpiTask 只在「100ms 无新字节」
 *          时翻状态）, 但会让 OLED 闪一下 RPI:Disconnected、并关掉蓝牙臂编辑窗。
 *    ⚠️ Pi 那边 HOSTAGE_TIMEOUT 被人调大了（例如 8s）, 这里**必须**跟着抬, 否则复现同一个
 *       「Pi 说成功、单片机报超时」—— 两者是**跨仓库耦合**的一对数, 改一边要想到另一边。 */
#define HOSTAGE_CX_CENTER         948.0f    /* 理想基准人质列 [px] @(0~1920) // 基准人质应停到的像素列; 标定法=车摆理想停止位发一次4, 蓝牙Tab读 hostage{1,2,3}_x; 运时量=蓝牙 hs_cx_center */
#define HOSTAGE_CY_CENTER         520.0f    /* 理想基准人质行 [px] @(0~1080) // 同上读 hostage{1,2,3}_y; ⚠️必须现场标定(默认只是小球的初值); 运时量=蓝牙 hs_cy_center */
#define HOSTAGE_PX_TO_MM_X        0.18f     /* 横向比例 [mm/px] @(0.01~5) // 基准人质 cx 偏差→车体横移 mm; ⚠️人质是立体柱状物, 质心比小球高、距离稍远, 现场按实走量反标; 运时量=蓝牙 hs_px_to_mm_x */
#define HOSTAGE_PX_TO_MM_Y        0.24f     /* 纵向比例 [mm/px] @(0.01~5) // cy 偏差→车体纵移 mm; 纵向角分辨率低, 预期明显大于横向; 运时量=蓝牙 hs_px_to_mm_y */
#define HOSTAGE_DX_DEADBAND_MM    3.0f      /* 横移死区 [mm] @(0~) // 小于此值不横移; 运时量=蓝牙 hs_dx_db_mm */
#define HOSTAGE_DY_DEADBAND_MM    3.0f      /* 纵移死区 [mm] @(0~) // 小于此值不纵移; 运时量=蓝牙 hs_dy_db_mm */
#define HOSTAGE_SIDE_SIGN         (1.0f)    /* 横移方向 // 车横移方向反了改 -1; ⚠️与 BALL_SIDE_SIGN/BALL 那套无关(独立标定量); 运时量=蓝牙 hs_side_sign */
#define HOSTAGE_FWD_SIGN          (-1.0f)   /* 纵移方向 // 车纵移方向反了改 -1; 运时量=蓝牙 hs_fwd_sign */
#define HOSTAGE_XY_SWAP           1         /* XY整体对调 @(0~1) // 语义同 BALL_XY_SWAP: 横向驱动轴 + 两路 mm/px 增益整套对调(相机相对车体装了90°)。⚠️相机怎么装的与区域无关, 本值应与 BALL_XY_SWAP 保持一致; 运时量=蓝牙 hs_xy_swap */
#define HOSTAGE_ALIGN_ACCEL       120       /* 对位加速度 @(0~255) // ⚠️落进 uint8_t, >255 会静默截断; 运时量=蓝牙 hs_accel */
#define HOSTAGE_ALIGN_SPEED       60        /* 对位速度 [rpm] @(0~65535) // 保守首测; 运时量=蓝牙 hs_speed */

/* ==================== 单动作抓取（色球/人质, 2026-10 新方案） ==================== */
/* 链路（STEP_BALL_GRAB_ONE_WAIT → ucRpiBallGrabOne / STEP_HOSTAGE_GRAB_ONE_WAIT
 *   → ucRpiHostageGrabOne, 都在 app_rpi.c）:
 *   只录**一个**抓取动作（=抓"中间"那颗/那只的动作）。到区后照老逻辑识别拿到
 *   目标位置(0左/1中/2右)与基准(中间)偏差 dx/dy → 平移 = dx/dy **叠加**
 *   (位置-1)×one_lat_mm（于是目标被平移到"中间"正前方, 单动作直接抓）。
 *   色球版抓完**反向回中**再放置（爆破桶在车上, 放置是车相对动作, 但回中是为了
 *   后续路线的账好算）; 放置动作可填「无」(0) = 只回中不放（决赛换边的编法）。
 *   人质版**默认不回中**, 残留位移写进 path_res_x/y, 由后续世界系平移积木的
 *   "叠加上次残留偏移"一次性吃掉; 若 place 选了动作, 则抓完只回退间距分量到
 *   中间对齐位（=爆爆桶位）再放, 播完清残留。
 *
 * ⚠️ 现场标定顺序: ① one_lat_mm（实际量相邻目标中心距; 比例尺有误差, 别拿图纸值当真）
 *   → ② one_lat_dir（方向/轴: 平移后看是偏向哪边, 反了换一档）→ ③ one_line_ms（mode=OpenMV
 *   那档的收敛时长, 收不拢就加大）。前两个都能在蓝牙 Tab「单动作抓取」组当场改, 断电回本段默认。 */
#define ONE_GRAB_LAT_MM           145.0f    /* 相邻目标间距 [mm] @(0~500) // 平移分量 = (位置-1)×本值(中间目标=0不平移); 人质区=150mm(现场确认, 2026-10-26 用户); 色球区按现场球距另标; 运时量=蓝牙 one_lat_mm */
#define ONE_GRAB_LAT_DIR          3         /* 平移分量方向 @(0~4) // 0=不叠加(只对基准位) 1=横向正向 2=横向负向 3=纵向正向 4=纵向负向。横向=与对位横移同轴(球排/人质排方向); 第一颗(左)取负、第三颗(右)取正, 现场反了就在1/2(或3/4)之间换; 运时量=蓝牙 one_lat_dir */
#define ONE_GRAB_LINE_MS          800u      /* 巡线收敛段时长 [ms] @(0~10000) // 单动作抓取里 mode=OpenMV 那档每次收敛(识别前/抓取后; 放置后 2026-10-23 起不收敛)共用的时长; 运时量=蓝牙 one_line_ms */
#define ONE_GRAB_ARM_WAIT_MS      15000u    /* 等机械臂后台序列跑空上限 [ms] @(0~) // 抓取/放置都入队即返回, 本步靠等 arm_seq_busy 归零确认做完; 正常一次动作几秒, 30s 只是兜底(超时+继续, 不响只留痕, 别当精度旋钮 */
#define ONE_GRAB_LEAD_PAD_MS      150u      /* "剩提前量"允许估时少多少毫秒 [ms] @(0~1000) // 2026-10-20 起**抓取**改为「估时倒计时剩 grab_lead_ms 就发臂」; 梯形估时偏紧(实际到位晚于估时)时会早发, 本值把触发往**晚**垫 —— 爪晚到无害(车停了球不动, 只是慢), 爪早到会撞球。放大=更保守, 触发时刻 = 估时到位 −(lead−本值)。⚠️放置 2026-10-23 改回起点后延时, 不吃本值 */
#define ONE_GRAB_MIN_DELAY_MS     0u        /* 发臂最短延迟 [ms] @(0~5000) // 2026-10-20 加: 从**整段平移开始**至少等这么久才允许把动作投给臂泵(**只作用于抓取**; 放置 2026-10-23 改回 place_delay_ms 起点后延时, 不吃本值)。0=旧行为 —— 短行程时"剩提前量"触发首拍即命中, 等于与底盘同时开始; 设大后短行程自动补足: 例 平移估时50ms+pad150ms 也凑不出提前量时, 若本值=500 则平移开始 500ms 后才发(车早已停稳)。只把触发往晚推, 长行程(触发时刻本就晚于本值)不受影响; 轴估时先走完而本值没到时, 本轴原地等到点发完才交棒(下一轴相应推迟, 无害) */

/* ==================== 标靶校准（反恐区打靶） ==================== */
/* 链路（脚本步骤 STEP_TARGET_CALIB_WAIT → vTargetCalibAim）:
 *   发 RPI_TASK_TARGET("6") → Pi 回 TAG=0x04 帧（三颗靶的靶心像素 + 外圆等效半径）
 *   → 按二维码**第二位**挑目标色 → Δ = 靶心 − 画面中心 → 乘比例尺得角度增量
 *   → **舵机6 管画面横向(X)、舵机3 管画面纵向(Y)** 各走一段。
 *
 * ⚠️ **增量式**：以舵机**当前角度**为基准加偏移。所以同一个积木连排两次就是迭代收敛
 *    —— 单次开环的落点取决于比例尺标得准不准，想更准就多排一步，不用改参数。
 * ⚠️ **二维码没认出来就整段不做**（拒绝返回，不动机械臂; 不响, 留痕）。
 * ⚠️ 标定顺序建议：先 TARGET_X_SIGN / TARGET_Y_SIGN（方向对不对）→ 再比例尺（走多少）。
 * ⚠️ 上面那个段头**必须写成单行注释**（一行里由注释定界符包住、等号夹着名字）——
 *    tuning.py::RE_SECTION 只认那一种形式。写成跨多行的块注释的话，
 *    这一段参数会被**静默归到上一段**（这里就是「色球识别」），
 *    「调参」Tab 里看着像"根本没加进去"。现场真踩过。
 *    ⚠️ 还有: 注释里**别写注释定界符本身的字面量** —— C 注释不嵌套, 会提前闭合。 */
#define TARGET_CALIB_TIMEOUT_MS   8000u     /* 标靶识别超时 [ms] @(0~) // 标靶校准（"6" 是阻塞命令）本端等结果帧的上限。⚠️ 它**等于** RPI_DISCONNECT_TIMEOUT_MS(8s): 一次跑满会让链路在阻塞期闪一次 Disconnected（不是故障, Pi 一应答即自愈, 代价是 OLED 闪一下 + 蓝牙臂编辑窗被关一次）。想不闪就调到 7500 以下（同二维码那条建议）。⚠️ 积木 STEP_TARGET_CALIB_WAIT 的 timeout_ms 非 0 时**以积木为准**, 本值只是它的回落。 */
#define TARGET_CENTER_X           950.0f    /* 瞄准点列 [px] @(0~1920) // 靶心应停在这里(列=x); 默认=画面正中列960; 兼作落点整体平移; 2026-10-05 两轮实地校正 +9.0 */
#define TARGET_CENTER_Y           505.0f    /* 瞄准点行 [px] @(0~1080) // 靶心应停在这里(行=y); 默认=画面正中行540; 2026-10-05 两轮实地校正 -13.0 */

/* ---- 瞄准点的「距离视差」补偿（2026-10 加，默认关）----
 * 病根：相机与激光**不同轴**（刚性同装倒数第二节臂，但有基线）—— 车-靶**距离**一变，
 * "光斑打到物理圆心时靶心的图像位置"就沿基线方向漂移（横向/纵向都有分量），而
 * 上面那对 TARGET_CENTER_X/Y 是一个**固定像素点**，只在标定距离上成立 —— 这就是
 * 「调试时稳在圆心、停位一变就飘」「推远/推近落点不定」的几何根源。
 * 处方：标 N 个距离（每个距离把光斑对准圆心后，用 GKS_Web 的「视差标定」页采点，
 * 拿到该距离下靶心的图像坐标与靶半径 r），运行时按**当帧靶半径 r** 在锚点表上
 * **分段线性插值**出 center —— r 与 1/距离 成正比，是现成的距离代理（0x04/0x05
 * 帧都带 usR，不用动协议）。r 越界钳到端点，不外推。
 * ⚠️ **RCOMP_EN=0 时锚点表一个字节都不参与**，行为与加它之前逐字节一致。
 * ⚠️ 锚点表按 R **升序**填（插值代码不再排序）！同距离重复采的点取中位后再填。
 * ⚠️ 默认三锚点重合在 (TARGET_CENTER_X, TARGET_CENTER_Y)：即"未标定=常数 center"，
 *    等效于关闭 —— 所以就算误开 EN 也不炸，只是没补偿。
 * ⚠️ 不要在蓝牙运行时改这套（没做成 Beam 量，标定本来就是低频操作）—— 改宏重编译。 */
#define TARGET_CENTER_RCOMP_EN    0         /* 距离视差补偿 @(0~1) // 0=关(用固定 CENTER_X/Y, 同旧行为); 1=按当帧靶半径 r 在锚点表插值。2026-10-06 视差标定页采 4 点填入 */
#define TARGET_CENTER_ANCHOR_N    4         /* 锚点个数 @(2~8) // ≥2 个不同距离才有意义 */
#define TARGET_CENTER_ANCHOR_R    { 81.7f, 89.3f, 98.9f, 103.4f }   /* 锚点靶半径[px] **升序** — 2026-10-06 标定值（视差标定页采点, 升序已核对） */
#define TARGET_CENTER_ANCHOR_CX   { 970.0f, 959.6f, 955.9f, 957.0f }   /* 各锚点的瞄准点列[px] */
#define TARGET_CENTER_ANCHOR_CY   { 478.7f, 470.6f, 473.2f, 466.4f }   /* 各锚点的瞄准点行[px] */

#define TARGET_PX_TO_DEG_X        0.02f     /* X 比例尺 [°/px] @(0~) // 1px 偏差 → 舵机6 转多少度; 现场标定 */
#define TARGET_PX_TO_DEG_Y        0.02f     /* Y 比例尺 [°/px] @(0~) // 同上, 舵机3; 现场标定 */
#define TARGET_X_SIGN             (-1.0f)   /* X 方向 // 靶心偏画面右侧时舵机6 该往哪转; 反了改 -1 */
#define TARGET_Y_SIGN             (-1.0f)   /* Y 方向 // 同上, 舵机3; 反了改 -1 */
#define TARGET_DEADBAND_PX        8.0f      /* 死区 [px] @(0~) // 偏差小于此值不动机械臂, 防原地抖 */
#define TARGET_MOVE_MS            1000u     /* 单次微调时长 [ms] @(20~1000) // S 曲线; 会被 ARM_SERVO_MAX_SPEED_DPS 削峰。⚠️ 下界 20: 0 会让驱动走"零时长旁路"直接写目标（舵机满速甩 = 砸齿轮）, vArmAimByPixels 里另有兜底钳位（同 ts_move_ms 的量程） */
#define TARGET_MAX_STEP_DEG       20.0f     /* 单次微调上限 [°] @(0.5~90) // 一次最多修正多少度; 见下 */
#define TARGET_MOVE_SLACK_MS      200u      /* 到位轮询余量 [ms] @(0~2000) // 到位等待上界 = 行程/速度 + MOVE_MS + 本值 */
#define TARGET_XY_SWAP            0         /* XY整体对调 @(0~1) // 0=画面X→舵机6、画面Y→舵机3(默认); 1=两轴**连比例尺整套对调**(画面X改由舵机3驱动并用 TARGET_PX_TO_DEG_Y, 画面Y改由舵机6并用 TARGET_PX_TO_DEG_X)。方向符号仍各走 TARGET_X_SIGN/Y_SIGN, 不跟着翻。相机相对车体装了90°时才开; 运时量=蓝牙 tg_xy_swap */

/* ⚠️ **TARGET_MAX_STEP_DEG 是安全夹, 别当"精度旋钮"调**。
 *    修正量 = 偏差px × TARGET_PX_TO_DEG_X/Y, 本来**没有上限**: 靶心落在画面边缘时
 *    偏差可达 ±900px, ×0.05°/px 就是 **±45° 的臂摆动** —— 而那一路坐标可能来自一次
 *    误检（比如识别到画面角落里一个同色杂块）。开环增量式瞄准一旦被这种错误带动,
 *    下一帧的偏差反而更大, 会连着往同一个方向越走越远。
 *    有了这道夹, 单次最多只走 20°, 误检的代价被限制在"这一小步"上; 真正的收敛靠
 *    **同一块积木连排几步迭代**（见 CLAUDE.md「标靶校准」）, 而不是靠一步走到底。
 *    ⚠️ **定这个默认值时要跟路线里的步数配着看**: 默认比例尺 0.05°/px 下 20° ≈ 400px,
 *       而「测试标靶」预设排的是**两步**（开环落点 + 迭代收敛）→ 两步覆盖 ~800px,
 *       恰好把整幅画面宽度兜住。**把这个值调小就要同步在路线里多排几步**,
 *       否则初始位姿偏得远时会停在一个没收敛的位置上 —— 而它不会报错, 只是打不准。
 *       它现在是蓝牙可改的（tg_max_step_deg）, 台架上一边看落点一边收更省事。
 * ⚠️ **TARGET_XY_SWAP 与 BALL_XY_SWAP / HOSTAGE_XY_SWAP 同语义**（"横/纵两路「轴+增益」
 *    整套对调"）: 开 = 画面X 改由**舵机3**驱动并用 TARGET_PX_TO_DEG_Y, 画面Y 改由**舵机6**
 *    驱动并用 TARGET_PX_TO_DEG_X。方向符号仍各走 TARGET_X_SIGN / TARGET_Y_SIGN, 不跟着翻。
 *    做成"一个开关"而不是"两个舵机号"是**故意的**: 两个独立编号可以配成"两根轴都指同一个
 *    舵机"这种危险组合, 而开关注定只有两个合法状态。真要换个非 6/3 的舵机, 那属于接线改造,
 *    改 vArmAimByPixels 里的 ARM_SERVO6 / ARM_SERVO3 —— 不是标定时该拧的旋钮。 */

/* ==================== 标靶对位（反恐区打靶: 先把车横移摆正, 再让机械臂细瞄） ==================== */
/* 指令 "6" 已经有靶心坐标了, 本步只是拿其中**一颗基准靶**的横向偏差去横移底盘 ——
 * 与人质对位/小球对位**同构**, 所以标定量也**各持一套**（反恐区的停止位姿与球区/人质区
 * 都不同, 共用一套就是系统性偏差, 而且是"调好一边动了另一边"）。
 *
 * 为什么打靶要单独来这一步: 瞄准轴（舵机6/3）是**开环增量式**、单步还有 20° 上限
 * （见上面 TARGET_MAX_STEP_DEG）。车停歪得多的时候, 光靠底座舵机去够既吃力又容易撞上
 * 量程, 而且落点精度差。先用底盘把车横移到基准靶接近画面中心, 机械臂就只剩一点点细修 ——
 * **粗调用车、细调用臂**, 与「过坎」那套"先用低精度手段把误差收进小范围, 再上精的"同一思路。
 *
 * 标定顺序: SIDE_SIGN（横移方向反了改 -1）→ PX_TO_MM_X（走多少）→ DX_DEADBAND_MM（收到不抖）。
 * ⚠️ 和 TARGET_*（瞄准）是**两套独立的量**: 那一套管"舵机转多少度", 这一套管"车走多少毫米",
 *    单位都不同, 别混着调（TARGET_CENTER_X 是瞄准点, TARGET_ALIGN_CX_CENTER 是对位基准点）。
 *    ⚠️ 超时由路线表积木参数 timeout_ms 给（须 < RPI_DISCONNECT_TIMEOUT_MS(8s)）。 */
#define TARGET_ALIGN_CX_CENTER    921.0f    /* 基准靶列 [px] @(0~1920) // 基准靶应停在这一列, 车才算横移到位 */
#define TARGET_ALIGN_CY_CENTER    532.0f    /* 基准靶行 [px] @(0~1080) // 只在本步不做纵移; 仅当 XY_SWAP 开了才被用到 */
#define TARGET_ALIGN_PX_TO_MM_X   0.25f     /* 横向比例 [mm/px] @(0~5) // 1px 横向偏差 = 车该横移多少 mm */
#define TARGET_ALIGN_DX_DEADBAND_MM 3.0f    /* 横移死区 [mm] @(0~50) // 偏差小于此值不动车, 防原地来回蹭 */
#define TARGET_ALIGN_SIDE_SIGN    (-1.0f)   /* 横移方向 // 基准靶偏画面右侧时车该往哪移; 反了改 -1 */
#define TARGET_ALIGN_XY_SWAP      1         /* XY整体对调 @(0~1) // 语义同 BALL_XY_SWAP/HOSTAGE_XY_SWAP: 0=图像X→车体横移(cx驱动, 用 CX_CENTER); 1=改由cy驱动(用 CY_CENTER)。方向符号仍走 TARGET_ALIGN_SIDE_SIGN; 运时量=蓝牙 ta_xy_swap */
                                            /* ⚠️ **本值应与 BALL_XY_SWAP 保持一致 —— 本车 1**（相机怎么装是车身属性, 与区域无关;
                                             *  BALL_XY_SWAP = HOSTAGE_XY_SWAP = 1, 所以这里也是 1）。别照着"默认不该是 1"的印象改回 0:
                                             *  改回 0 的后果是**照着靶的上下位置去横移车**, 车会朝着莫名其妙的方向跑。
                                             *  ⚠️ 注意它与 TARGET_XY_SWAP（标靶校准那个）**问的不是同一件事**:
                                             *  那个问"画面X 由舵机6 还是舵机3 来pan"(舵机侧的映射, 见 CLAUDE.md 标靶校准一节),
                                             *  这个问"画面X 对应车体的横移还是纵移"(车身侧的映射)。两者取值不同**不矛盾**。 */
#define TARGET_ALIGN_ACCEL        120       /* 横移加速度 @(0~255) // 同人质对位初值; ⚠️落进 uint8_t */
#define TARGET_ALIGN_SPEED        60        /* 横移速度 [rpm] @(0~65535) // 同人质对位初值; 保守首测 */

/* ==================== 标靶流控伺服（反恐区打靶, 2026-09 加） ==================== */
/* 链路（脚本步骤 STEP_TARGET_SERVO_WAIT → app_rpi.c::ucRpiTargetServo）:
 *   发 RPI_TASK_AIM_START("7") 起流 → Pi 在**小跟踪窗**内 ~20Hz 回传 TAG=0x05 流帧
 *   （靶心 + 外圆等效半径, 全分辨率; 与 0x04 帧逐字节同布局, 区别只在它是连续流）
 *   → 本端 10Hz 节拍做 P 闭环: Δ = 靶心 − 瞄准点 → ×tg 比例尺 × ts_kp_scale
 *   → 钳单拍上限 → 舵机6/3 各走一小步 S 曲线 → 连续 ts_conv_ticks 拍进死区判收敛
 *   → **无论成败**发 RPI_TASK_AIM_STOP("8") 停流。
 *
 * ⚠️ 这是**新方案**, 与「标靶校准」(STEP_TARGET_CALIB_WAIT, 开环迭代) 并存, 两者可在
 *    同一条路线里混排; 老方案一行未动（"6" / 0x04 帧 / vTargetCalibAim 全保持原样）。
 *    病根与处方: 老方案的开环执行链有三个随机源 —— ①比例尺线性近似只在标定位姿附近
 *    成立, 首轮大修正落在非线性区且步数有限时停在半收敛位**不报错**; ②舵机回差使
 *    「指令到位 ≠ 实际到位」, 最终落点取决于最后一次逼近方向（这就是落点随机的典型
 *    症状）; ③相机-激光视差烤死在 tg_center_x/y 一个固定瞄准点里。
 *    闭环把①②**根治**（回差表现为死区, 环会持续推过去; 比例尺失准只影响收敛速度、
 *    不影响终点）, ③**缓解**（收敛姿态每次一致, 残余视差变成常数偏移, 标一次长期有效）。
 *
 * ⚠️ 瞄准点/比例尺/方向/XY对调**共用 TARGET_(tg_*)** 那一套 —— 同一套物理标定, 所以
 *    新方案第一天就能继承已经标好的全部 tg_*, 不用重新标一遍;
 *    本段只管**闭环节拍类**参数（走多快 / 何时算收敛 / 何时放弃）。
 *    断电回本段宏 = 上电默认; 运行时量 = 蓝牙「标靶流控」组（ts_*）。
 * ⚠️ 下面那个段头**必须写成单行注释**（详见上面「标靶校准」段头那段警告）——
 *    多行块注释会被 tuning.py::RE_SECTION 静默归到上一段（这里是「标靶对位」）。 */
#define TARGET_SERVO_CTRL_MS     250u     /* 控制节拍 [ms] @(20~500) // 闭环每拍间隔; ⚠️**必须 > MOVE_MS**, 差值就是"停稳段"(见下); 运时量=蓝牙 ts_ctrl_ms。2026-10 默认 180→280: 80ms 停稳段不够舵机3 走完 100ms 的 S 曲线（削峰后实际更久）, 闭环采到运动帧 → dy 读数随机, 30 次超时全是"dx 已收敛、dy 卡死区外振荡"; 280-100=180ms 停稳段后 dy 振荡显著收窄。⚠️ 节拍变长 → 同样超时预算里拍数变少, 路线里这块的 I(0) 超时余量要跟着看一眼 */
#define TARGET_SERVO_MOVE_MS     100u     /* 单拍时长 [ms] @(20~1000) // 每拍小步的 S 曲线时长; ⚠️会被 ARM_SERVO_MAX_SPEED_DPS 削峰(收尾切恒速), 大行程短时长时真实耗时 = 行程/速度闸; 运时量=蓝牙 ts_move_ms */
#define TARGET_SERVO_STEP_DEG    2.0f     /* 单拍上限 [°] @(0.1~20) // 每拍最大修正角; 0.04°/px 下 2°≈50px; 振荡先降 KP_SCALE 再降它; 运时量=蓝牙 ts_step_deg */
#define TARGET_SERVO_CONV_PX     4.5f     /* 收敛阈值 [px] @(0~100) // 两轴偏差均低于此值算"在靶"(固件是严格<, 整数卡点要留余量); 检测噪声地板≈0.3px; 2026-10-05: 5→落点散布±5px, 3→低于舵机3回差地板(dy=4卡死到超时), 4.5=实测折中; 运时量=蓝牙 ts_conv_px */
#define TARGET_SERVO_CONV_TICKS  5u       /* 收敛拍数 @(1~50) // 连续 N 拍在靶才判收敛(100ms×5=0.5s, 抗单帧抖动); 运时量=蓝牙 ts_conv_ticks */
/* 行程上限的来由（2026-10-01, 25→50; 同日现场再抬到 60）:
 *   实测「1° 舵机行程 ≈ 17~19px 图像偏差」（同一份日志两轮算得）⇒ 25° 只能吃 ~440px 的
 *   **起手**偏差。现场出现过 619px 起手（红靶 cx=297、瞄准点 900 = 画面左 1/3），那时环在
 *   单调收敛、符号方向全对，却因闸先到而在 dx 还差 172px 时放弃（`TGTS fail: travel`; 不响, 留痕）。
 *   ⇒ 50° ≈ 880px 已够; 60°（≈1050px）是 2026-10-01 当天为起手更偏的机位再放宽的实值,
 *      比注释里的论证值多 20%——敞口同比例放大, 用前知悉, 实测起手吃不满可回收。
 *   ⚠️ 本闸是「起手偏差能吃多大」的硬上限，与 ts_step_deg 无关：**抬单拍上限不减少总行程**
 *      （单调逼近时累计行程 ≈ 实际走过的度数），想再放宽只能抬本值或排表上先用车粗对位。
 *   ⚠️ 代价：误检带飞时的敞口同比例变大。机械上的最后一道防线仍是**下发前的静态量程钳位**
 *      （app_rpi.c 下发处 + 驱动各钳一次，舵机3 量程 0~180 / 舵机6 0~360）——放宽不会推过量程。
 *      「环根本没起作用」另有一道独立的闸 noprog（连续几拍偏差不降即收手），不受本值影响。
 * ⚠️ 说明放这里而不是尾注释: tuning.py::RE_DEFINE 是**行锚定**的 `^...$`，尾注释一跨行
 *    这个参数就会丢掉显示名/单位/范围（「调参」Tab 里打回宏名）。尾注释永远保持单行。 */
#define TARGET_SERVO_TRAVEL_DEG  60.0f    /* 单轴行程上限 [°] @(1~90) // **安全夹**(不是精度旋钮): 闭环被误检带飞时"越纠越偏", 累计到此值即拒绝放弃（不响, 留痕）, 代价限制在已知范围内; 对应老方案 TARGET_MAX_STEP_DEG 的教训; 也决定"起手偏差能吃多大"(1°≈17~19px), 见上方说明; 运时量=蓝牙 ts_travel_deg */
#define TARGET_SERVO_STALE_MS    400u     /* 帧新鲜度 [ms] @(50~2000) // 流帧计数停涨超此值 = Pi 掉线/停发 → **冻结不动舵机**(不是放弃: Pi 回来即续跑, 同 app_line.c 的丢线处理); 运时量=蓝牙 ts_stale_ms */
#define TARGET_SERVO_KP_SCALE    1.0f     /* 增益系数 @(0.1~2) // ×tg_px_to_deg_x/y 的总增益; **振荡时降它**(而不是动共用的 tg 标定); ⚠️运行中改会直接改变控制律; 运时量=蓝牙 ts_kp_scale */

/* ---- 底盘参与闭环（2026-09 加）--------------------------------------------------
 * 动机: 舵机6 颗粒度不够 + 有齿轮回差, 细调段落点常在一环外且左右来回跳（极限环）。
 * 做法: |dx| 落进门限以内后**舵机6 让位**, 改由**底盘位置模式小步横移**继续闭环;
 *       画面 Y 仍全程归舵机3。
 * ⚠️ **为什么用位置模式而不是速度模式**（这条是选型的全部理由, 别改回去）:
 *    速度模式的 `usVel` 是 **uint16_t 整数 RPM**（emm_v5_device.c）, 所以最小分辨率
 *    就是 **1 rpm = 5.079 mm/s = 3.0 px/拍**（×0.34mm/px ÷ 0.2s）—— 那是死区
 *    CONV_PX(4px) 的 75%, 一旦为了"更细"收紧死区就变成**永久极限环**（现象是"一直超时",
 *    会被误诊成增益不对）。而位置模式的量化是 **1 脉冲 = 1/10.5 mm ≈ 0.095 mm ≈ 0.28 px**,
 *    比它细 10 倍, 死区随便收紧。
 *    另外位置模式**自终止**（脉冲走完电机就停）: 速度模式那种"忘了显式发 0 就带着末速
 *    一直爬"的收尾风险不存在, 所以本方案**不在任何出口发停车指令**。
 *    而且 `fChassisMoveDelay` 的阻塞等待**天然就是"停稳段"**, 比速度模式"车永远在动"更贴合
 *    下面「动-停-测」的设计前提。
 * ⚠️ **但代价是底盘那一拍的实际耗时 ≈ CTRL_MS + 平移阻塞(≈100~300ms) ≈ 2× 名义值**,
 *    而 `ulElapsed` 只按名义节拍累加 —— 所以开了本开关就得给积木的 I(0) 留 ~2× 余量,
 *    否则会被误诊成超时。
 * ⚠️ 不变式 **CHASSIS_PX 必须 > CONV_PX**: 否则接管带整个落在死区里, 底盘几乎没机会接管。
 * ⚠️ 标定顺序: SIGN 看方向（故意摆偏, 看误差收敛还是发散）→ PX_TO_MM 看一步走多少
 *    （大了过冲振荡、小了收敛慢; 因为是闭环复测, 偏了不致命）→ MM 收行程。
 * ⚠️⚠️ **底盘那一路走的是"前后", 不是"左右"**（2026-09-27 踩过并修正）: 本车相机相对
 *    车体装了 **90°** —— 证据是 BALL_XY_SWAP / HOSTAGE_XY_SWAP / TARGET_ALIGN_XY_SWAP
 *    三个默认全为 1, 注释写明"相机相对车体装了 90°时的情形"。于是
 *    **图像横向 cx 对应的是车体纵移**。色球对位那段是同一件事的现成例子
 *    （ball_xy_swap=1 分支）: 横移 ← usCy、纵移 ← usCx。
 *    所以本组喂的是 `vChassisMoveCameraForward`（v_y / AXIS_Y）。
 *    ⚠️ 用 `vChassisMoveCameraLateral`（v_x）会去改图像的 **cy** —— 轴用错, 而现象是
 *    "车在动、但偏差不降", 极容易被误诊成"符号反了"然后一路去翻 SIGN。
 * ---------------------------------------------------------------------------- */
#define TARGET_SERVO_CHASSIS_EN       1      /* 底盘参与闭环 @(0~1) // 0=关: 本组参数一个字节都不参与, 行为与加这个之前完全一致; 1=|dx|落进门限后舵机6让位, 由底盘位置模式小步**前后**进给闭环(⚠️是前后不是左右, 见上面段头); 运时量=蓝牙 ts_chassis_en。⚠️ **本机现值是 1（现场标定后留的）** —— 于是「不动车」的前提只在 ts_chassis_en=0 时成立, 台架试 STEP_TARGET_SERVO_WAIT 请把轮子架起来（本文档旧版把这行写成"0=出厂默认", 与值不符, 已改） */
#define TARGET_SERVO_CHASSIS_PX       20.0f  /* 接管门限 [px] @(1~100) // |dx| 小于它 → 舵机6 让位、底盘接管; 退出滞环=本值×1.5(见 AIM_CHAS_HYST_PCT); ⚠️必须 > CONV_PX; 运时量=蓝牙 ts_chassis_px */
#define TARGET_SERVO_CHASSIS_PX_TO_MM 0.14f  /* 前后比例 [mm/px] @(0.01~5) // 1px **图像横向**偏差 = 车该前后走多少 mm; 初值同 BALL_PX_TO_MM_X(它就是"cx→纵移"那把尺, 不是 ta_px_to_mm_x —— 那个在 swap=1 下配的是 cy); 只影响收敛速度与是否过冲, 不影响终点; 运时量=蓝牙 ts_chassis_px_to_mm */
#define TARGET_SERVO_CHASSIS_SIGN     1.0f   /* 前后方向 @(-1~1) // 图像横向偏差为正(靶偏画面右侧)时车该往哪走; 反了改 -1。⚠️初值 +1 是从色球那套等效换算来的(cx→纵移的等效符号 = BALL_FWD_SIGN 取反), **不是**照 ta_side_sign —— 那个是 cy→横移的符号, 与本法无关; 运时量=蓝牙 ts_chassis_sign */
#define TARGET_SERVO_CHASSIS_MM       80.0f  /* 累计行程闸 [mm] @(1~500) // **安全夹**(不是精度旋钮): 方向标反/比例尺离谱时"越纠越偏", 累计到此值即拒绝放弃（不响, 留痕）, 代价限制在已知范围内(对应 TARGET_SERVO_TRAVEL_DEG 的教训); ⚠️按**指令值**累加, 轮子打滑/架空时它照样涨; 运时量=蓝牙 ts_chassis_mm */

/* ---- 阶段化 X→Y + Y轴踢步 + 底盘距离辅助（2026-10-06 加）--------------------------------
 * 背景: 舵机3（图像上下那一路）**没有位置回读**, servo_device 的 fCurrentValue 是纯指令
 *   模型 —— 小步长(如 dy=4px→0.08°)低于静摩擦/回差阈值时舵机原地不动, 模型却照常推进,
 *   指令目标以每拍一步的速度从物理位置"溜走", 某拍突破静摩擦后一口气冲向溜走的终点,
 *   就是现场看到的"给了值不动, 憋久了突然大角度超调"（2026-10-05 实测 dy=4px 卡 9 拍到超时;
 *   手动"给值不动/突然大跳"同源）。
 * 三层处方（ts_seq_en=0 时本组**全部不参与**, 行为与加这一段之前完全一致）:
 *   ① 阶段化: 先只修左右(舵机6→底盘接管, 现有机制), 收敛后切到只修上下 —— Y 阶段通道安静
 *     (底盘不再搅动 dy 读数), 两轴收敛阈值也分开(X 有底盘兜底可收紧, Y 用自己的地板);
 *   ② 踢步: Y 停滞(连续 N 拍改善<1px)且 |dy|<2×conv_px 时, 朝 P 律方向发一次**独立于
 *     单拍限幅**的大步 —— 钢珠破静摩擦: 小力只让齿面弹性形变, 大力突破后咬合相位重排;
 *     下一拍按图像裁决: 变好≥1px 收货 / 没动→退回(溜走量有界) / 动了没变好→原地让 P 环重进。
 *     手动"先给大偏离再给目标值"的开环抽签由此变成带相机反馈的定向搜索;
 *   ③ 距离辅助(默认关, 等灵敏度实测): 踢完仍卡 → 底盘**离靶远近**微调（⚠️是车体**横移**
 *     v_x, 不是前后 —— 本车相机**侧看**靶, "离靶远近"物理上是车体横移, 车体前后只是沿靶面
 *     滑动、图像 cy 纹丝不动; 2026-10-06 首版实现错在这里, 用户现场抓到"到Y阶段底盘
 *     还是在横移"）→ 回 X 阶段重修（挪车扰动 dx: 光点视差项随远近变）→ 再回 Y。
 *     ⚠️ 斜率的**符号和大小必须实测**: 摆在真实射击线上打一发 → 远离 5~10cm → 再打一发,
 *     读 dy 位移。黄区余量只有 ~3cm, 方向反了就只剩远离可用。
 * ------------------------------------------------------------------------------ */
#define TARGET_SERVO_SEQ_EN        1        /* 阶段化X→Y @(0~1) // 1=先只修左右(舵机6→底盘接管)收敛后只修上下; 0=旧并行环(逐字节等同旧行为, 本组其余参数一个都不参与); 运时量=蓝牙 ts_seq_en */
#define TARGET_SERVO_CONV_X_PX     4.5f     /* X收敛阈值 [px] @(0~100) // 阶段1(左右)的收敛判据, 固件严格<; X 有底盘兜底(分辨率0.28px), 想更紧可降它; 运时量=蓝牙 ts_conv_x_px */
#define TARGET_SERVO_CONV_Y_PX     2.5f     /* Y收敛阈值 [px] @(0~100) // 阶段2(上下)的收敛判据, 比旧 conv_px 紧 —— 靠踢步突破舵机3回差地板(~4px)后才够得着; 踢完仍达不到但 <旧conv_px 时按"宽容收敛"收货(打 TGTS grace 行); 运时量=蓝牙 ts_conv_y_px */
#define TARGET_SERVO_STALL_TICKS   3u       /* 停滞判定拍数 @(1~50) // 连续 N 拍 |dy| 改善<1px 判"停滞"→触发踢步; 太小把慢收敛误判成停滞, 太大拖时间; 运时量=蓝牙 ts_stall_ticks */
#define TARGET_SERVO_KICK_DEG      2.0f     /* 踢步幅度 [°] @(0.05~5) // 一次踢步的指令角增量, **独立于 ts_step_deg 限幅**(就是要越过它); 初值按"手动能踹动舵机3的量"取, 现场从 0.2 起试; 运时量=蓝牙 ts_kick_deg */
#define TARGET_SERVO_KICK_MAX      10u      /* 踢步次数上限 @(0~20) // 全程共用不重置(防时间爆炸); 用尽后: |dy|<旧conv_px 宽容收货, 否则冻结等 noprog/距离辅助; 运时量=蓝牙 ts_kick_max */
#define TARGET_SERVO_DIST_EN       1        /* 距离辅助 @(0~1) // 开启前必须: ①ts_chassis_en=1; ②先实测灵敏度(见上面段头)。开启后踢完仍卡→底盘**离靶远近**(车体横移 v_x)微调→回X重修→回Y(最多2次); 路线积木的 I(0) 超时余量要再留一份挪车+重修的时间; 运时量=蓝牙 ts_dist_en */
#define TARGET_SERVO_DIST_PX_TO_MM 0.0f     /* dy→远近比例 [mm/px] @(-50~50) // **带符号**: 每消除 1px 的 dy 需要车沿"离靶远近"方向(车体横移!)走多少 mm; 符号实验定 —— 反了就翻负; 0=不挪(即使 en=1); 运时量=蓝牙 ts_dist_px_to_mm */
#define TARGET_SERVO_DIST_MM       30.0f    /* 距离辅助行程闸 [mm] @(1~100) // 距离辅助自己的累计行程闸(外面还罩着 ts_chassis_mm 总闸); 黄区余量~3cm, 别配超过它; 运时量=蓝牙 ts_dist_mm */

/* ⚠️ **为什么是 P 环 + 三道阻尼, 刻意不做 I/D**: 靶静止、无负载扰动, P 到死区即收敛。
 *    迟延链 ~150-200ms（采集 + 处理 + 串口 + 节拍）, Kp 直接沿用 0.04°/px 起步即可;
 *    三道阻尼分别是 —— 单拍限幅（TARGET_SERVO_STEP_DEG）、收敛阈值（CONV_PX）、
 *    连续拍数（CONV_TICKS）。振荡时降 KP_SCALE, 别去动那套共用的 tg 标定。
 * ⚠️⚠️ **`CTRL_MS` 必须 > `MOVE_MS`，差值就是"停稳段"**（2026-09-20 台架实测后的修正）。
 *    「走 N ms → **停** → 采帧 → 下一拍」里那个**"停"不是自动的**：
 *    `vTaskDelay(CTRL_MS)` 之后立刻读的是**最新一帧**，而那一帧是相机在舵机**运动过程中**
 *    采的（Pi 那边还要 ~45ms 处理 + 串口）。CTRL_MS == MOVE_MS 时舵机刚停、
 *    采到的却全是运动中的画面 —— **等于没有"停"这一步**。
 *    实测症状（台架，初始偏差仅 22px）：偏差反复穿越零点（+22→−42→+65→−29），
 *    幅度一路涨到行程闸；逐拍看"实际移动 ÷ 期望移动"在 **7.0× 与 0.1× 之间乱跳**
 *    （采样落点随机：有时在运动最快的中段、有时在还没起步处）。
 *    ⚠️ 这不是增益问题 —— 增益不对会让这个倍率**一致地**偏离 1，而它是乱跳的。
 *    所以**先查 CTRL_MS/MOVE_MS 的比例，再动 KP_SCALE**。
 *    默认 200/100 = 走 100ms + 停 100ms；想更快就两边一起收（如 160/80），
 *    **别把 CTRL_MS 压到 MOVE_MS 以下或相等**。
 *    代码里 `ulCtrlMs <= ulMoveMs` 时会打一条 `TGTS warn: ctrl<=move no settle` 提醒。
 *    ⚠️ **底盘接管阶段这条纪律不适用**: 那个"停稳"由 `vChassisMoveCameraLateral` 内部的
 *    `fChassisMoveDelay` 阻塞等待提供（位置模式会一直等到估算到位）, 与 MOVE/CTRL 的差值无关。
 *    在底盘阶段照这节的处方去调 CTRL/MOVE 比例是白费功夫 —— 要查就查 PX_TO_MM（过冲/太慢）。
 * ⚠️ Pi 起流后要先做几帧全画面锁定（~0.5-1s）才有流帧, 所以路线里那块的超时默认 6000ms
 *    够覆盖「起流 1s + 收敛 1-2s + 余量」。⚠️ **这个值没有 <8s 的硬约束** ——
 *    流模式下 Pi 心跳照发（跟踪跑在独立线程里, 不像阻塞命令那样断心跳）,
 *    但别配太大, 路线节奏会拖沓。 */

/* ==================== 平移射靶（激光固定在底盘: 沿靶排纵移、全程不动机械臂, 2026-10-07 加） ==================== */
/* 链路（脚本步骤 STEP_TARGET_SHOOT_WAIT → app_rpi.c::ucRpiTargetShootAlign）:
 *   前提 = 激光**固定在底盘上**, 俯仰/偏航角度在测试阶段手动定死（高度一次给定）,
 *   于是"瞄准"只剩一个自由度: 沿靶排平移车体 = **车体纵移 v_y**（vChassisMoveCameraForward）。
 *   ⚠️⚠️ **轴是纵移不是横移**: 本车相机装 90°、靶排沿车体纵向排开（同球排/人质排,
 *      ONE_GRAB 的 one_lat_dir 预期 3/4 那条）, 车体前后 = 沿靶面滑动, 靶排在画面里
 *      沿图像横向 cx 排开 → 沿排对齐 = **cx 偏差驱动纵移**（swap=1; swap=0 改由 cy 驱动）。
 *      ❌ 「标靶对位」那把 cy→横移的尺管的是**离靶远近**（横移经视差动 cy）, 拿来沿排
 *      对齐就是轴用错 —— 首版实现就错在这里（用户现场抓到"运动的轴弄反了"）。
 *   流程 = 粗调(现成 "6"/0x04 全画面识别, 按二维码第二位选色 → 一次纵移到位)
 *        → 精调(现成 "7"/0x05 流帧, 位置模式小步闭环, 同「标靶流控」底盘接管的轴)
 *        → keep_res=1 时把累计纵移记成「路径残留偏移」(≈±150mm, 标靶中心距),
 *          离开靶区的那步世界系平移勾"叠加上次残留偏移"一次性补掉。
 *   ⚠️ 全程**不碰机械臂**（不进 c_bIsArmStep）; 相机位姿由路线在前面的摆臂步骤排定。
 * ⚠️ 比例尺/方向**独立一套**(初值 = TARGET_SERVO_CHASSIS 那对现场标定值, 它就是靶区
 *    "cx→纵移"的尺与符号) —— 刻意不直接共用 ts_chassis_ 量: 为调本步翻符号会连带改坏
 *    「标靶流控」的底盘接管(同 ts_chassis 当年不共用 ta_side_sign 的理由)。
 * ⚠️ 瞄准常数(CX/CY_AIM)**只有换算到 swap 开关选中的那一个参与运算**, 另一个不读;
 *    0 = 未标定 → 本步**拒绝动车**(不响, 留痕; 同看路 road_dx_ideal 的哨兵约定,
 *    宁可不动也不照占位值跑)。标定: 车摆在激光正打中间靶中心的位姿 → 发"6" →
 *    读中间靶的 **cx** 填 CX_AIM(swap=1, 本车; 现值 1000 = 2026-10-07 现场标定)。
 *
 * ⚠️⚠️ **2026-10-16 起把 pi(树莓派 CSI)摄像头接进平移射靶**（它**固定在底盘上**; 主摄装在
 *   机械臂上, 臂位姿与残余振动会让瞄准列漂 —— 这就是加它的理由）。
 *   2026-10-18 **定案: 粗调固定主摄、细调走 pi**（不是"优先 pi"了）:
 *   · 粗调（"6" 全画面识别）**永远用主摄**: 它的位移是 `偏差px ÷ tc_gap_px × tc_gap_mm`,
 *     而 `tc_gap_px` 只有主摄那一把（150mm ↔ 289px ≈ 1.9px/mm）; pi 满视场在同一距离是
 *     ≈3.8px/mm（靶 r 95→190px, 正好两倍）⇒ 拿 pi 的像素差套主摄的格距会算出**约两倍**
 *     的位移。加上 pi 视场更窄（三颗排开常只框到 1~2 颗）—— 粗调没有理由用它。
 *   · 细调（"7" 流帧）**优先 pi**（`tc_use_picam=1`）: 闭环只吃"每拍偏差 × tc_px_to_mm",
 *     px/mm 大反而让 1px 对应更小的一步; 起不来/中途掉帧由 Pi **整条改用主摄**重跑,
 *     每帧 bit7 决定本端换哪把瞄准尺 —— 即"pi 不行就粗细都主"的老方案，自动成立。
 *   · 本端**任务码不变**("6"/"7"/"C"), 只在末尾追加一个 `is_use_picam` 字段
 *     （"6,&lt;ms&gt;,&lt;pi&gt;" / "7,0,&lt;pi&gt;" / "C,&lt;uses&gt;,&lt;pi&gt;"）。**标志为 0 时整段省略**,
 *     所以"只用主摄"时线上与改造前**一字不差**。Pi 侧用 `_split_payload` 认这个形状。
 *     ⚠️ 2026-10-18 起本步**不再给 "6" 带这个字段**（粗调固定主摄）, 只有 "7" 带。
 *   · **由 Pi 决定实际用哪台**（CSI 打不开/掉线/看不到靶它自己退回主摄）, 并在回帧
 *     `status` 的 **bit7** 回报这一帧是哪台测的（见 app_rpi.h 的 RPI_TGT_ST_CAM_PI）。
 *     本端按它选瞄准列 —— 所以下面**每个相机一对**瞄准列/行。
 *   · ⚠️ 预热: 「平移射靶」前建议用 `STEP_RPI_WARM_CAM` 的 **WARM_CAM_MAIN_PI**
 *     （一条积木预热两颗, 见 app_rpi.h）—— CSI 冷启动 ~3s 而细调起流只等 3s, 提前热好
 *     才能第一步就命中; 窗口 = uses × 15s。
 *   · ⚠️⚠️ **两台相机的坐标系不一样**: 坐标系 = **Pi 侧取流尺寸**（`PICAM_ROTATE` 转不转
 *     会把宽高换个个儿）。2026-10-16 定稿: 取流 **2592×1944**（传感器原生满分辨率,
 *     帧率随之降到 10）+ **`PICAM_ROTATE=0`（不转）** ⇒ 画面就是 **2592×1944**
 *     （瞄准列 0~2592 / 瞄准行 0~1944; 主摄是 1920×1080 —— 见下面两个宏的 @(范围)）。
 *     ⚠️ 尺寸/旋转这两件事**改一个就换坐标系**: 瞄准常数重标 + app_beam.c 那两行的
 *     钳位跟着改。历史教训（一天内改了三轮, 值得记）:
 *       ① 侧装时"世界水平方向 = 画面高" ⇒ 三靶并排那排能否全进画面**只看取流的高**;
 *       ② rpicam 按请求挑**传感器模式**: 1920×1080 与 1440×1080 都落到 1920×1080 那档
 *          **窄视场**模式（1440×1080 实测靶盘坐标逐像素不变 = 白改）, **高 > 1080** 才落到
 *          4:3 满视场那档 ⇒ 现在直接取原生满分辨率 2592×1944（视场上限 = 408mm 短边 /
 *          543mm 长边）;
 *       ③ 分辨率一换, **所有 px 量都要重核**: 真靶 r（176 → 238px! 卡在 200 的
 *          `TARGET_R_MAX` 上会被整颗剔掉 ⇒ 靶标识别永远「找到 0/1 颗」）、半径门
 *          `AIM_R_TARGET_PI_*`、瞄准列/行。
 *   · **未标定哨兵仍是 0**: `tc_cx_aim_pi == 0` → **细调**直接按"只用主摄"发 + 一条
 *     `SHOT warn: pi aim not calibrated, use main`。⇒ 出厂值下本功能**完全惰性**。
 *   · 标定 CSI 瞄准列: 车摆"激光正打中间靶中心"位姿 → 蓝牙把 `tc_use_picam` 置 1 →
 *     跑一步看回帧/遥测 `shoot_cam=1`（网页「靶标识别(pi)」按钮也会把**转正后**的画面与
 *     每颗靶的 cx 直接显示出来, 标定用它最省事）→ 读中间靶 cx 填 `tc_cx_aim_pi`。
 *   · `tc_use_picam=0` = **只用主摄**（标定/调兜底那一套参数时用）。
 *   · ⚠️ 目前**只分瞄准列/行**这一对（两台相机相对位置不同）。若实测粗调那一下走过头/
 *     不够, 最该先补的是 **pi 的每格像素**（tc_gap_px 那套对 CSI 不成立, 而且 90° 旋转
 *     把横向像素尺度整个换了 —— 主摄那把 289px/格 是按 1920 宽的画面量的）—— `tc_gap_mm`
 *     是物理真值(一格 150mm)**不该拿它凑**; 再其次是精调比例。另: 半径门
 *     `AIM_R_TARGET_PI_MIN/MAX_PX`（app_rpi.c, 编译期）已按相机各一套。 */
#define TARGET_SHOOT_CX_AIM     975.0f   /* 瞄准列 [px] @(0~1920) // ta_xy_swap=1(**本车**)时参与: 目标靶心应停在这一列 = 底盘激光已对准它; 标定=车摆"激光打中间靶中心"位姿读中间靶 cx; 0=未标定拒绝动车; 运时量=蓝牙 tc_cx_aim */
#define TARGET_SHOOT_CY_AIM     0.0f     /* 瞄准行 [px] @(0~1080) // ta_xy_swap=0 时才参与(图像Y→纵移的装法); 本车 swap=1 用不到; 运时量=蓝牙 tc_cy_aim */
#define TARGET_SHOOT_GAP_MM     150.0f   /* **粗调格距** [mm] @(1~500) // 打边靶走多远的**总旋钮**: 粗调位移 = 视觉偏差 ÷ GAP_PX × 本值 —— 一格 = 一颗靶的**真实**间距(现场量 150)。⚠️ 2026-10-08 由 160 改回 150: 160 是当初故意留的余量, 但它和 GAP_PX 的偏差**叠加**起来让粗调整体超调 ~19%(实测一发: 命令 169mm、该走 144mm), 而超调那一截要靠精调环慢慢爬回来(那一发多花 ~3s)。两把尺校准后粗调基本一步到位; 运时量=蓝牙 tc_gap_mm(当场调) */
#define TARGET_SHOOT_GAP_PX     289.0f   /* 每格像素 [px] @(1~1920) // 一格靶距在画面里占多少 px。⚠️ 2026-10-08 由 274 改 **289**: 274 是早期按"150mm÷274px"反推的旧值, 而现场 0x04 帧实测相邻靶 cx 差是 **288~293px**(02:43 那帧 绿405/红695/蓝983 → 290/288)。它与 GAP_MM 一起把粗调尺的偏差从 ~19% 收到 ~5%。⚠️ 这数目**随车的位置变**(沿排透视): 实测范围 274~292, 取工作区中值即可, 别追单帧。挪机位/改了 tc_cx_aim 后重标: 发"6"看两颗相邻靶的 cx 差; 0=未标定拒绝动车; 运时量=蓝牙 tc_gap_px */
#define TARGET_SHOOT_PX_TO_MM   0.55f    /* 精调前移比例 [mm/px] @(0.01~5) // **只归精调环**: 每拍出力 = 沿排偏差px × 本值 × tc_kp_scale(粗调已按 tc_gap_mm 走完大位移, 这里只收最后几个px)。填**物理值** 0.55 = 150mm÷274px 沿排透视折算; ⚠️ 它与 tc_kp_scale 只以**乘积**进环(乘积决定增益与零速带宽度, 算式见 tc_vel_mode 那条), 但本值对了算式的 mm 才可读; ⚠️ 别拿它调"粗调走多大" —— 那是 tc_gap_mm; 运时量=蓝牙 tc_px_to_mm */
#define TARGET_SHOOT_SIGN       1.0f     /* 前移方向 @(-1~1) // 目标偏画面一侧(cx 偏差为正)时车该往前还是往后; 反了改 -1。初值=TARGET_SERVO_CHASSIS_SIGN(+1, 靶区 cx→纵移的现场标定符号); 运时量=蓝牙 tc_sign */
#define TARGET_SHOOT_DB_MM      2.0f     /* 前移死区 [mm] @(0~50) // 粗调偏差小于此值不动车(精调环还会收尾), 防原地来回蹭; 运时量=蓝牙 tc_db_mm */
#define TARGET_SHOOT_ACCEL      120      /* 平移加速度 @(0~255) // 粗调+精调的纵移共用(EMM 单字节档位, 落 uint8); ⚠️独立一套不共用「标靶对位」的 ta_* —— 调它不影响别处; 运时量=蓝牙 tc_accel */
#define TARGET_SHOOT_SPEED      60       /* 平移速度 [rpm] @(0~65535) // 位置模式=纵移速度; 速度模式=**微调速度上限**(每拍按偏差比例出力, 钳到它); 1rpm ≈ 5.08mm/s → 60rpm 沿排 ~305mm/s; 运时量=蓝牙 tc_speed */
#define TARGET_SHOOT_VEL_MODE   1        /* 精调微调模式 @(0~1) // 0=位置模式(每拍走一步停一步, 步进量化 0.095mm, 有顿挫); 1=速度模式(每拍按偏差比例发 rpm 连续修, 平滑无顿挫)。⚠️ 速度模式 1rpm 量化 = 5.08mm/s —— 换算不足 1rpm 的"零速带"边界 = 5.079 ÷ (tc_px_to_mm × tc_kp_scale) px(0.55尺×0.8增益下 ≈ 11.5px), 带内由固件**顶格兜住**(发最小 1rpm: 180ms = 0.91mm ≈ 1.7px/拍, 一步跨进收敛带); 所有出口显式发 0 停车(速度指令是持久的); ⚠️ 速度模式**没有**位置模式那种"阻塞平移自带停稳" —— 车全程在滚、每拍都是边走边测; 运时量=蓝牙 tc_vel_mode */
#define TARGET_SHOOT_MAX_MM     250.0f   /* 粗调上限 [mm] @(1~500) // 粗调一次纵移的钳位(安全夹): 标靶中心距150mm+停车误差, 250 够兜; 误检带飞的敞口由它限定; 运时量=蓝牙 tc_max_mm */
#define TARGET_SHOOT_CONV_PX    8.0f     /* 收敛阈值 [px] @(0~100) // 精调闭环: |沿排偏差px| 连续 N 拍低于此值判对准, 固件是**严格<**。⚠️ 被两条下界夹着: ① 检测噪声带 ±2px(流帧 cx 在瞄准列附近抖), ② 速度模式 1rpm 顶格步长(≈1.7px/拍) —— 比它们还紧的话, d 在带边界来回跳会把连续计数清零、N 拍永远攒不满(2026-10-07 现场 d=1px 已对准却判 noprog fail)。4.5px ≈ 2.5mm, 对 10 环半径 7.5mm 仍足够细; 运时量=蓝牙 tc_conv_px */
#define TARGET_SHOOT_CONV_TICKS 6u       /* 收敛拍数 @(1~50) // 连续 N 拍在靶才判收敛(抗单帧抖动); ⚠️ 180ms/拍, 6 拍 ≈ 1.1s —— 够速度模式下命令归 0 之后车减速停稳(设 20 会白等 3.6s, 且贴着积木的 10s 超时预算); 运时量=蓝牙 tc_conv_ticks */
#define TARGET_SHOOT_KP_SCALE   0.5f     /* 增益 @(0.1~2) // 精调环总增益(×tc_px_to_mm); 振荡降它; 运时量=蓝牙 tc_kp_scale */
#define TARGET_SHOOT_STEP_MM    20.0f    /* 单拍上限 [mm] @(0.5~100) // 精调每拍最大纵移; 粗调已把误差收进小范围, 这只是阻尼; 运时量=蓝牙 tc_step_mm */
#define TARGET_SHOOT_TRAVEL_MM  150.0f   /* 行程闸 [mm] @(1~500) // **安全夹**(不是精度旋钮): 精调累计指令行程超此值拒绝放弃(不响, 留痕; 方向反/比例尺离谱/误检带飞时"越纠越偏"); 标称最坏(粗调被 tc_max_mm 钳住后剩下的残差) ≈100mm, 150 留余量、敞口又只约一格靶距; 只管精调段, 粗调那段有自己的 tc_max_mm; 运时量=蓝牙 tc_travel_mm */
#define TARGET_SHOOT_CTRL_MS    180u     /* 控制节拍 [ms] @(20~500) // 精调每拍的测量间隔; 平移阻塞(fChassisMoveDelay)自带停稳, 这里只是节流; 运时量=蓝牙 tc_ctrl_ms */
/* ---- pi(树莓派 CSI)摄像头那一套（2026-10-16 加; 语义见上面段头那段）---- */
#define TARGET_SHOOT_USE_PICAM  1        /* 细调优先pi @(0~1) // 1=**细调**("7"那股流)优先 CSI(固定在底盘, 几何稳), 它打不开/掉线/看不到靶时 Pi 自己整条退回主摄; 0=细调也走主摄(标定/调兜底那套参数时用)。⚠️ 2026-10-18 起**粗调固定主摄**, 本宏不再影响粗调; 运时量=蓝牙 tc_use_picam */
#define TARGET_SHOOT_CX_AIM_PI  1402.0f  /* pi瞄准列 [px] @(0~2592) // CSI 的"目标靶心该停在这一列"(与主摄那根**相对位置不同**, 必须各标各的); 0=未标定 → 本步自动按"只用主摄"走(惰性, 不蜂鸣); 运时量=蓝牙 tc_cx_aim_pi。⚠️ 2026-10-16 **刻意留 0**: 一天里坐标系换了三轮（侧装转 90°→ 不转 + 取流 2592×1944）, 任何旧值都已作废 —— 实测重标后再填（标定法见上面段头） */
#define TARGET_SHOOT_CY_AIM_PI  0.0f     /* pi瞄准行 [px] @(0~1944) // ta_xy_swap=0 的装法才参与(同 tc_cy_aim); 本车 swap=1 用不到; 运时量=蓝牙 tc_cy_aim_pi */
/* ⚠️ **复用的量不在本段**: 帧新鲜度复用 ts_stale_ms(同一条 0x05 流); 每格像素/精调比例/方向
 *    目前两台**共用** tc_gap_px/tc_px_to_mm/tc_sign —— 只分瞄准列是刻意的, 实测偏差大再细分
 *    （最该先补每格像素, 理由见上面段头）。 */

/* ==================== 爆爆桶对位（2026-10-24 加, STEP_BARREL_ALIGN_WAIT 的标定量） ==================== */
/* 链路: STEP_BARREL_ALIGN_WAIT → ucRpiBarrelAlign 发 RPI_TASK_BUCKET_START("J")
 *   → Pi 转告 OpenMV('B') 起爆爆桶流 → Pi 回 0x0B 流帧（TAG=0x0B, **320×240 口径** ——
 *   ⚠️ 与 0x04/0x05 的 1920×1080/2592×1944 都不是一套, 标定量绝不能互相抄）,
 *   见 docs/串口协议.md §6m。
 * 闭环 = ucTargetShootCore 精调环的**桶版**（跳过二维码/粗调段）: 每拍按
 *   fDpx = cx − CX_AIM → fDmm = fDpx × PX_TO_MM × SIGN → 死区外小步**纵移** →
 *   连续 N 拍进 CONV_PX 判收敛。
 * ⚠️⚠️ **轴是纵移不是横移**（同平移射靶的定案）: 本车相机装 90°, 交界线/路面沿图像 X 轴
 *   排开 = 车体前进方向 ≈ 图像 cx —— 对齐爆爆桶 = cx 偏差驱动 v_y（纵移）。
 *   爆爆桶在实拍帧里位于中景、紧贴黑界线上方（横贯画面的黑线是检测的最大干扰,
 *   相机端已按几何过滤剔除）。
 * ⚠️ 瞄准常数 CX_AIM **0 = 未标定** → 本步进**只测不改**模式（起流采 ~3s 报中位 cx、
 *   不动车 —— 标定自举）: 车摆到"推桶臂/车头正对爆爆桶"的理想位姿 → 跑一次本步 →
 *   读 "BKT meas:" 日志行填 CX_AIM → 再跑一次应显示 skip（已在死区内）。
 * ⚠️ PX_TO_MM 初值是**占位值**: 用 bc_swap=1 的 cx 口径, 按实拍几何先估 ~0.8mm/px
 *   （桶 85px 宽 ≈ 真桶 70mm 量级 —— 上场先用"只测模式"+已知位移实测重标）。 */
#define BUCKET_ALIGN_CX_AIM     0.0f     /* 瞄准列 [px] @(0~320) // 选中桶 bbox 中心应停在这一列 = 推桶位姿; 0=未标定 → 只测不改模式; 运时量=蓝牙 bc_cx_aim */
#define BUCKET_ALIGN_CY_AIM     0.0f     /* 瞄准行 [px] @(0~240) // bc_swap=0 的装法才参与(图像Y→纵移); 本车 swap=1 用不到; 运时量=蓝牙 bc_cy_aim */
#define BUCKET_ALIGN_SWAP       1        /* 轴映射 @(0~1) // 1=cx 偏差驱动纵移(**本车**, 同 tc 的 ta_xy_swap=1); 0=cy 驱动(换装法才改); 运时量=蓝牙 bc_swap */
#define BUCKET_ALIGN_PX_TO_MM   0.8f     /* 比例尺 [mm/px] @(0.01~5) // 每拍出力 = 偏差px × 本值 × bc_kp_scale; ⚠️ 初值占位, 上场实测重标(方法见段头); 运时量=蓝牙 bc_px_to_mm */
#define BUCKET_ALIGN_SIGN       1.0f     /* 方向 @(-1~1) // 桶偏画面一侧(cx 偏差为正)时车该往前还是往后; 偏差单调变大=反了改 -1; 运时量=蓝牙 bc_sign */
#define BUCKET_ALIGN_DB_MM      3.0f     /* 死区 [mm] @(0~50) // 换算位移小于此值不出力; 对位精度要求比激光打靶松, 3mm ≈ 4px 够用; 运时量=蓝牙 bc_db_mm */
#define BUCKET_ALIGN_ACCEL      120      /* 平移加速度 @(0~255) // 与 TARGET_SHOOT_ACCEL 同域(EMM 档位); 刻意独立一套 —— 调它不影响射靶; 运时量=蓝牙 bc_accel */
#define BUCKET_ALIGN_SPEED      60       /* 平移速度 [rpm] @(0~65535) // 位置模式=纵移速度; 速度模式=微调速度上限; 运时量=蓝牙 bc_speed */
#define BUCKET_ALIGN_VEL_MODE   1        /* 微调模式 @(0~1) // 0=位置模式(每拍一步停一步); 1=速度模式(每拍按偏差比例发 rpm 连续修, 平滑; 指令持久 —— 死区/所有出口显式发0停车, 1rpm≈5.08mm/s, 不足1rpm由顶格逻辑兜住); 同 tc_vel_mode; 运时量=蓝牙 bc_vel_mode */
#define BUCKET_ALIGN_CONV_PX    6.0f     /* 收敛阈值 [px] @(0~100) // |cx−瞄准列| 连续 N 拍低于此判对准(严格<)。⚠️ 被两条下界夹着: 相机端 cx 噪声(瓦片兜底路径 ±2~4px)、速度模式 1rpm 顶格步长 ≈1.7px/拍 —— 别比它们紧; 推桶 6px×0.8mm/px ≈ 5mm 足够; 运时量=蓝牙 bc_conv_px */
#define BUCKET_ALIGN_CONV_TICKS 6u       /* 收敛拍数 @(1~50) // 连续 N 拍在带内判收敛(抗单帧抖动); 180ms/拍 × 6 ≈ 1.1s; 运时量=蓝牙 bc_conv_ticks */
#define BUCKET_ALIGN_KP_SCALE   0.8f     /* 增益 @(0.1~2) // 环总增益(×PX_TO_MM); 振荡降它; 运时量=蓝牙 bc_kp_scale */
#define BUCKET_ALIGN_STEP_MM    20.0f    /* 单拍上限 [mm] @(0.5~100) // 位置模式每拍最大纵移(阻尼); 运时量=蓝牙 bc_step_mm */
#define BUCKET_ALIGN_TRAVEL_MM  150.0f   /* 行程闸 [mm] @(1~500) // 安全夹: 累计指令行程超此值放弃(方向反/比例尺离谱/误检带飞); 运时量=蓝牙 bc_travel_mm */
#define BUCKET_ALIGN_CTRL_MS    180u     /* 控制节拍 [ms] @(20~500) // 每拍测量间隔; 运时量=蓝牙 bc_ctrl_ms */
#define BUCKET_ALIGN_STALE_MS   600u     /* 帧新鲜度 [ms] @(100~3000) // 0x0B 帧计数停涨超此值 = 流死了, 冻结不动车; 超 2× 自愈重发 "J"(Pi 侧 BUCKET_MAX_S=30s 会自己退流); 运时量=蓝牙 bc_stale_ms */
#define BUCKET_ALIGN_MEAS_MS    3000u    /* 只测模式时长 [ms] @(500~10000) // bc_cx_aim=0 时起流采这么久, 报选中桶 cx 的中位数(标定读数); 运时量=蓝牙 bc_meas_ms */

/* ==================== 底盘脉冲系数（实测标定, 换轮/打滑重标） ==================== */
#define CHASSIS_PULSE_PER_MM_X      10.5f       /* X 轴脉冲系数 [脉冲/mm] @(0~) // 实测标定, 换轮/打滑要重标 */
#define CHASSIS_PULSE_PER_MM_Y      10.3f       /* Y轴与斜向脉冲系数 [脉冲/mm] @(0~) // 同上 */

/* ==================== 世界系平移 · 残留补偿后短行程保护（2026-10-23 加） ==================== */
/* 背景: 射靶/抓取留下的「路径残留偏移」会把下一步世界系平移缩短 —— 打右靶后 -460mm 的
 * 计划可能只剩 ~270mm。位置模式在短行程下几乎没有匀速段，默认 accel=170/speed=210 时
 * 容易冲一下/偏一下再急刹。本组只作用于**勾了「叠加上次残留偏移」(use_res=1)** 的
 * vChassisMoveWorld（app_chassis.c）:
 *   · 补偿后车体位移 ≤ SKIP_MM: 视为已到位，直接返回（不再发位置指令）;
 *   · 补偿后车体位移 < SHORT_MM: 加速度/速度取 min(当前值, SHORT_ACCEL/SHORT_SPEED)。
 * 不影响 use_res=0 的平移，也不改变终点。 */
#define WORLD_RES_SKIP_MM       2.0f    /* 残留补偿后忽略距离 [mm] @(0~20) // ≤ 此值视为已到位, 不发位置指令; 默认 2mm 与巡线直走的残差门同口径 */
#define WORLD_RES_SHORT_MM      400.0f  /* 短行程门槛 [mm] @(0~1000) // 补偿后车体位移 < 此值就柔化; 右靶实测 ~270mm, 中/左靶 ~460/647mm 不受影响 */
#define WORLD_RES_SHORT_ACCEL   80      /* 短行程加速度 @(0~255) // 短行程时加速度取 min(当前值, 本值), 不会把已调慢的路线调快; 默认 80 与现场 workaround 一致 */
#define WORLD_RES_SHORT_SPEED   150     /* 短行程速度 [rpm] @(0~65535) // 短行程时速度取 min(当前值, 本值); 默认 150 与现场 workaround 一致 */

/* ==================== 过减速带（慢速顶住被动对齐 + 位置模式大力冲坡） ==================== */
/* 麦轮辊子对横向力零阻抗: 车斜着顶 10mm 台阶时只有一个前轮先接触, 接触反力的横向分量
 * 让整车横移而不是转正, 四轮受力不对称又带出偏航。故先用低速顶住坎面, 靠接触反力把车
 * **被动转正**, 再用位置模式大力一次冲过（动作函数 vChassisCrossRampWait,
 * 路线级约束见 CLAUDE.md「雪弗板减速带过坎」）。
 * 标定顺序: 先标 RAMP_ALIGN_SPEED（用现有积木搭的零代码试验, 见 CLAUDE.md）→ 再标 RAMP_CROSS_*。
 * ⚠️ 位置模式的距离是**开环脉冲**: 轮子打滑时位置目标照样跑完而车没走到, 且应用层没有任何
 *    EMM 应答解析 → 冲坡失败是**静默**的, 后面必须接视觉重同步。 */
#define RAMP_ALIGN_MM           250.0f      /* 顶住阶段推进量 [mm] @(0~) // 低速位置模式推进量, 须盖过停车间隙; 被坎顶住时剩余脉冲永不完成 = 持续顶住 */
#define RAMP_ALIGN_SPEED        5          /* 顶住速度 [rpm] @(0~65535) // 取"转正后开始自己爬上去"的速度再下调 30% */
#define RAMP_ALIGN_ACCEL        1          /* 顶住加速度 @(0~255) // ⚠️0=不使用加速度曲线(直接启动), 与"温柔"相反; 落进 uint8_t */
#define RAMP_CROSS_ACCEL        180         /* 冲坡加速度 @(0~255) // ⚠️落进 uint8_t, >255 会静默截断 */
#define RAMP_CROSS_SPEED        250         /* 冲坡速度 [rpm] @(0~65535) // 落进 uint16_t; 越大动能越足 */
#define RAMP_CROSS_EXTRA_MS     300u        /* 冲坡后额外等待 [ms] @(0~) // 估时假设"能达到设定转速", 被坎挡住时它变成下界, 用它兜底 */

/* ==================== 看路（主摄量黄色区, 车体纵向 + 可选横向修正） ==================== */
/* 链路: 路线排 STEP_ROAD_ALIGN_WAIT → ucRpiRoadAlign 发 RPI_TASK_ROAD("G")
 *   → Pi 回 0x08 帧（**Δx = 黄色区左边缘的 x** [0.1px] + 左边缘 ex/ey
 *      + **Δy = 黄区下边缘的 y** [0.1px, 帧尾那个原先恒 0 的保留字段], 见 docs/串口协议.md §6i）
 *   → 位移[mm] = (理想 − 实测) × 比例系数 × 方向
 *     · **纵移**用 Δx + ROAD_DX_*（一直如此）
 *     · **横移**用 Δy + ROAD_DY_*，**只在积木参数 use_y=1 时做**（默认 0 = 老行为一字不变）
 * ⚠️ **单次开环**: 本步一次只走一步、内部不死循环（同 ucRpiRectAlign 的形态）;
 *    要迭代收敛就在 map.c 里**连排两块**同一积木。
 * ⚠️ 物理: 车越往前开, 地上的**黄色区越大、左边缘越往左跑** ⇒ Δx 是一把**越近越小**的
 *    测距尺。理想Δx = 车停在理想停车位时那把尺的读数（画面左边 x=0 为"原点"）。
 *    **横向**用**黄区下边缘的 y**（本车相机相对车体转了 90° ⇒ 图像 y↔车体横向）:
 *    黄区固定在画面右上角 ⇒ 它的**上**边缘永远被画面顶边裁掉（所以 flags bit2 常置位,
 *    那是上边缘触发的,**别拿它当 Δy 的门**），**下**边缘永远在画面内。
 * ⚠️ **未标定(=0)拒绝执行**（不响, 留痕。同 RECT_ALIGN_CX 那条纪律: 宁可不动车, 也不照占位值开跑）。
 *    横向前提是纵标定（纵向自己失败时整步不动车, 横向也不做）。
 * 标定顺序: ①车摆**理想停车位** → 蓝牙 Tab 读 road_dx 填进 ROAD_DX_IDEAL_PX
 *          → ②前后各挪 ±50mm, 看 road_dx 是变大还是变小(定 ROAD_DX_DIR 该填 +1 还是 −1)
 *          → ③再跑一步应显示 skip(已在死区内)。
 *    （要开横向再多两步: ④车横向挪 ±20mm 看 road_dy 变大还是变小 → 定 ROAD_DY_DIR;
 *      ⑤同①的停车位读 road_dy 填进 ROAD_DY_IDEAL_PX。⚠️ 两把尺都在**同一个**停车位标,
 *      但比例/方向各自独立 —— 图像 x 与图像 y 的 mm/px 不是同一个数。）
 *    （反向看路(rev=1)的两把理想值都**独立**: 纵向 ROAD_DX_IDEAL_REV_PX / 横向
 *      ROAD_DY_IDEAL_REV_PX —— 反向停车位照①⑤各标一遍; 未标(0)同各自的哨兵语义:
 *      纵向未标 → 反向步拒动+失败音, 横向未标 → 该轴跳过、纵向照常。）
 * ⚠️ 全部量都是蓝牙可改的**运行时量**（「蓝牙」Tab 的「看路」组, 零重编译）;
 *    这里改的值只决定**上电初值**。现场标定走蓝牙, 标好把终值写回这里固化。
 * ⚠️⚠️ 本文件的 `{...}` 是**闭集换算表**（只有 ms->Hz 与 ‰->%）: 这里**不能**写
 *    `{0=关,1=开}` 那种写法（那是 app_script.h 参数 DSL 的语法）—— 写了这个参数在
 *    「调参」Tab 里**根本存不进去**（写盘抛"未知转换", 用户只看到一句警告而值没落盘）。
 *    开关量一律 `@(范围)` + 备注里写含义。 */
#define ROAD_DX_IDEAL_PX           1150.0f   /* 理想Δx [px] @(0~1920) // 理想停车位下**黄色区左边缘的 x**; ⚠️**0 = 未标定** → 本步拒绝执行并响失败音（默认就是 0, 逼你先标）; 运时量=蓝牙 road_dx_ideal */
#define ROAD_DX_IDEAL_REV_PX      700.0f    /* 反向看路理想Δx [px] @(0~1920) // **rev=1 的反向步专用**（正向步不受它影响）: 反向理想停车位下的 Δx 读数（Pi 镜像系 = 黄区右边缘），与正向的 road_dx_ideal **不通用**; 标定法同正向（反向停车位读 road_dx 填进来）; ⚠️**0 = 未标定** → 反向步拒绝执行并响失败音（默认 0, 逼你先标）; 比例/死区/方向与正向共用; 运时量=蓝牙 road_dx_ideal_rev */
#define ROAD_DX_SCALE_MM_PER_PX    0.26f     /* 比例系数 [mm/px] @(0.01~5) // 位移[mm]=(理想Δx−实测Δx)×本值×方向; 填小 = 每步少走些 = 迭代阻尼; 运时量=蓝牙 road_scale */
#define ROAD_DX_DIR                (1.0f)    /* 方向 @(-1~1) // ⚠️本测量里 **实测Δx 变小 = 车走近**（黄区越大、左边缘越往左）, 所以通常填 **-1**; 现场按标定法确认; 运时量=蓝牙 road_sign */
#define ROAD_DX_DEADBAND_MM        2.0f      /* 纵移死区 [mm] @(0~) // |位移| 小于它不动车(防原地抖); 运时量=蓝牙 road_db_mm */
#define ROAD_DX_MAX_MM             150.0f    /* 单次最大位移 [mm] @(0~) // **安全钳位**: 误检出一个离谱的 Δx 时不许把车一次推出去撞墙; ⚠️**纵/横共用**这一个; 运时量=蓝牙 road_max_mm */
#define ROAD_ALIGN_ACCEL           120       /* 对位加速度 @(0~255) // ⚠️落进 uint8_t, >255 会静默截断; 运时量=蓝牙 road_accel */
#define ROAD_ALIGN_SPEED           60        /* 对位速度 [rpm] @(0~65535) // 落进 uint16_t; 运时量=蓝牙 road_speed */
/* ---- 横向那一路（Δy = 黄区**下边缘**的 y; 积木参数 use_y=1 才用）---- */
#define ROAD_DY_IDEAL_PX           600.0f    /* 理想Δy [px] @(0~1080) // 理想停车位下**黄区下边缘的 y**; ⚠️**0 = 未标定** → 该轴跳过(只打日志、不蜂鸣), 纵向照常; 运时量=蓝牙 road_dy_ideal */
#define ROAD_DY_IDEAL_REV_PX      600.0f    /* 反向看路理想Δy [px] @(0~1080) // **rev=1 的反向步专用**（正向步不受它影响）: 反向理想停车位下的 Δy 读数（黄区下边缘），与正向的 road_dy_ideal **不通用**（反向停车位是另一个位置, 别指望镜像几何理想对称）; ⚠️**0 = 未标定** → 反向步横向跳过(只打日志、不蜂鸣), 纵向照常（与正向同语义）; 比例/死区/方向与正向共用; 运时量=蓝牙 road_dy_ideal_rev */
#define ROAD_DY_SCALE_MM_PER_PX    0.3f      /* 横向比例系数 [mm/px] @(0.01~5) // 同纵向那条的算法; ⚠️初值只是占位, 必须实测标定（图像 y 的 mm/px ≠ 图像 x 的）; 运时量=蓝牙 road_scale_y */
#define ROAD_DY_DIR                (1.0f)    /* 横向方向 @(-1~1) // 现场挪车确认（实测Δy 变大 = 车往哪边偏, 填 +1 还是 −1 由标定法定）; 运时量=蓝牙 road_sign_y */
#define ROAD_DY_DEADBAND_MM        2.0f      /* 横向死区 [mm] @(0~) // ⚠️本测量在 proc_scale=0.5 下量化步长约 2px(≈0.7mm), 死区别小于 ~1mm 否则原地抖; 运时量=蓝牙 road_db_mm_y */
#define ROAD_RESCUE_MM             100.0f    /* 饱和救援步距 [mm] @(0~500) // 看路测到"尺子没数"的帧时**车体系开环后退**这段再重测一次(不叠加世界坐标系): ①黄区贴画面左缘=横向全黄(Δx≈0 饱和, Pi 带 CLIP_X 旗标放行, 见 _road.py) ②use_y=1 时黄区下边缘被 ROI 下沿裁掉(蓝牙遥测 road_dy=0)。两种都是车冲过头的症状, **方向 = road_sign**（与正常位移同一条：标定成能增大 Δx 的那个符号；不再写死负值——2026-10-30 实测写死负值会让车朝篷布走）; 重测还饱和就整步失败, 内部**不循环**。**0=关闭**: 关闭时 Δy 被裁照旧只 skip(老行为), Δx 饱和帧直接判失败(饱和值绝不进位移算式 —— 老行为里这种帧被 Pi 的 dx_min 闸门拒了, 根本到不了固件)。⚠️救援位移是 fChassisMoveDelay **估时**等待, EMM 实际可能还在走/车身还在晃 → 重发 G 前再沉淀 ROAD_RESCUE_SETTLE_MS（04:04 实测 40/100mm 都是"车没停稳就重测", dx 只变 10~20px）; 重测用整份 I(0) 超时, 整步最坏 ≈2×超时+这段位移时间+沉淀, 路线超时要留够; 运时量=蓝牙 road_rescue_mm */
#define ROAD_RESCUE_SETTLE_MS      300u      /* 饱和救援后沉淀 [ms] @(0~2000, 编译期) // 后退运动发完、重发 "G" 之前等这么久（vTaskDelay 让出式）: fChassisMoveDelay 只按梯形曲线估时, 实际 EMM 停稳/车身摇晃还要一点时间; 太小 = Pi 在运动中途取帧, 重测还是 CLIP_X（04:04 现场 40/100mm 两次都这样）; 只影响救援路径, 0=不等 */
#define ROAD_SETTLE_MS             300u      /* 看路前沉淀 [ms] @(0~2000) // **发 "G" 之前**先等这么久（vTaskDelay 让出式, 不饿死按键/OLED）: 车刚巡线停/刚转完弯时还在晃, 相机在运动中途取帧 → 清晰度下降 + Δx 跨帧漂, Pi 的散布闸判失败（2026-10-30 06:36:20 road_0007 实锤: 运动模糊 + 28px 散布, 下一次 G 就成功）。⚠️ 它与 ROAD_LED_OFF_DELAY_MS 是**两段独立等待**, 开灯下总前置 ≈ 本值 + 400ms; 嫌慢就先调小本值, 别去动关灯那段（那是给自动曝光收敛的）。0=不等（等同加这一行之前） */

/* ⚠️ 本段唯一的**编译期**量（不进蓝牙「看路」组）: 它是行为开关不是标定值,
 *    现场没有"边跑边改"的需求, 改完重编译即可（同 TARGET_CENTER_RCOMP_EN 的形态）。 */
#define ROAD_LED_OFF_EN            1         /* 看路前关 OpenMV 补光 @(0~1) // 1=发 "G" **之前**先把 OpenMV 的 P6 补光灯关掉（它的 LED 热点会冲淡主摄判黄区用的 R−B 色差），拿到结果帧后立刻恢复成 Pi 配置里记住的亮度; 0=不碰补光灯（老行为一字不变）。⚠️ 只覆盖**看路这一步**, 与巡线/识别无关; 恢复走唯一出口, 链路不通/等帧超时/没左边缘/未标定四条失败路径也照恢复 */
#define ROAD_LED_OFF_DELAY_MS      400u      /* 关灯后延时 [ms] @(0~2000) // **只在上面 =1 时生效**（=0 时整行不参与）: 关灯之后先等这么久, 再发 "G" 开始看路 —— 给主摄的**自动曝光**留出适应"灯灭了"的时间。为什么要它: 看路档是 `auto_exposure=3`（Pi config.py 的 ROAD_AUTO_EXPOSURE，**只有白平衡是固定的**）, 灯一灭画面亮度就变, AE 会追; 追的过程若正好落在那 9 帧投票窗里, Δx 就会漂, 而 `road_dx_ideal` 是在**开灯**状态下标的 → 这一步静默偏掉。**热租约时它最有用**（预热线程一直在读帧, 等这几百毫秒 AE 就收敛完了）; 冷开本来就带 15 帧预热, 再加等待只是更稳。⚠️ 这是纯阻塞等待（vTaskDelay 让出式, 不饿死其它任务; 中止点仍只在**步骤边界**, 同 STEP_DELAY）, 所以别填太大 —— 它不占积木的 I(0) 超时预算（那个是发 "G" 之后才起算）。0=不等（等同加这一行之前） */

/* ==================== 看路校准（黄区直边方向角 → 航向基准, 2026-10 加） ==================== */
/* 链路: 路线排 STEP_ROAD_YAW_WAIT → ucRpiRoadYaw 发 RPI_TASK_ROAD_YAW("H")
 *   → Pi 回 0x09 帧（**ang = 黄区直边的图像方向角** [0.01°], 见 docs/串口协议.md §6j）
 *   → 本端只发遥测（roadyaw_*）与调试串, **不动车、不改航向** —— 先验证阶段:
 *     现场把 roadyaw_ang / roadyaw_err 与陀螺 yaw 并排记录, 确认相关性之后再接
 *     「yaw_bias += k×err」类的**慢速互补**修正（**别硬置 yaw** —— 会踢到正在
 *     咬航向的巡线闭环, 而且一次坏帧就是一次航向跳变）。
 * ⚠️ 为什么角度能当航向基准: 黄区（比赛黄胶带/练习图米黄篷布）**固定在场上**、相机
 *    **固定在车上** ⇒ 直边在图像里的方向只随**车航向**变（直线方向对平移不敏感）——
 *    与「看路」那两把尺(Δx/Δy 把平移与航向混在一起)互补。err = (实测−理想)×方向
 *    就是「陀螺漂了多少」的现场读数。
 * ⚠️ Pi 侧掩膜**整体复用看路那套**（Y−B 自适应 + ROAD_WARM_*）, 自己的旋钮只有
 *    ROADYAW_ROI_*（人工罩住一段**直边**, 别把拐角/圆弧罩进来）与质量门 —— 见 Pi 仓库
 *    tasks/_road_yaw.py 顶部。窗边框点 Pi 会自动剔（车固连的直线混进拟合 = 测到常数）。
 * 标定顺序: ①车摆**基准停车位**（与看路同一位）→ 蓝牙读 roadyaw_ang 填进 ROADYAW_ANGLE_IDEAL_DEG
 *          → ②原地转个**已知角**（比如支点转 90°）, 看 roadyaw_err 的变化量与方向对不对得上
 *          → 反了翻 ROADYAW_DIR → ③此后 err 就是漂移读数; 台架上先看「静止时 err 是否≈0 且稳」。
 * ⚠️⚠️ **ideal 的未标定哨兵是 |值|>90, 不是 0**（与 road_dx_ideal 那套不同!）:
 *    竖直的直边 ang 本来就 = 0°, 0 是合法值 —— 所以这里默认填 999 逼你先标。
 * ⚠️ 全部量都是蓝牙可改的**运行时量**（「蓝牙」Tab 的「看路校准」组, 零重编译）;
 *    这里改的值只决定**上电初值**。 */
#define ROADYAW_ANGLE_IDEAL_DEG    (90.0f)   /* 基准方向角 [°] @(-90~90, 哨兵999) // 放直时**黄区直边的图像方向角**实测 = **+90**（直边近水平, mod 180 表示下 ±90 同一朝向, err 计算有折回两种写法等价; 按屏显写 90 免得"对不上"）; 换机位/换边 → 蓝牙 roadyaw_ideal 现场改; ⚠️|值|>90 = 未标定（哨兵 999）→ 本步照测照报（不响, 校准流程静音） */
#define ROADYAW_DIR                (-1.0f)   /* 方向 @(-1~1) // err=(实测−理想)×本值; **默认 −1 = 台架实测**（陀螺正漂/正转时相机读数减小: 90→88, err 要乘 −1 才与陀螺同号, 偏置推导才成立）; 现场原地转**已知角**复核, 反了改回 +1; 运时量=蓝牙 roadyaw_dir */
/* ---- 对齐偏置（STEP_ROAD_YAW_WAIT 消费; 2026-10 加）----
 * 每次看路校准都把全场航向零点对到相机基准: bias = wrap180(原始航向 − err) ⇒
 * 发布 yaw ≡ err（**"放直"= 0**）—— 上电摆放误差与累计漂移一次消掉。生效与否由下面的
 * **编译期**开关定 —— 现场不碰蓝牙, 蓝牙只拿来调参数。偏置**易失**: 上电归零
 * （航向零点本来就该每次开机重新定）。⚠️ 世界坐标系不受影响（世界航向记录换算回原始值, 跨校准的残留偏移不错轴）。 */
#define ROADYAW_APPLY_EN           1         /* 发布 yaw 扣漂移偏置 @(0~1) // 1=app_sensors 发布工作航向统一扣 roadyaw_bias（PID/巡线陀螺腿/OLED 全生效）; 0=只算不扣（偏置照样更新进遥测, 台架验证用）。⚠️编译期行为开关（同 ROAD_LED_OFF_EN 的形态）: 上电即生效, 不留运行时开关 —— 偏置上电本来就是 0, 开着也无副作用 */
#define ROADYAW_BIAS_MAX_DEG       15.0f     /* 偏置绝对值上限 [°] @(0~90) // 算出的 |漂移| 超过它 = 假阳性（锁错/误拟合/位姿差太远）→ 拒绝并保留旧偏置（不响, 留痕）; 正常一场的漂移到不了这个量级 */

/* ==================== OLED 菜单 ==================== */
/* 换行动画: 上下选择时, **选中那一行的文字从右侧滑入**（横向 8px → 0, 每拍 4px ≈ 100ms）。
 * 只动选中行、只动文字 —— 不整屏滑动: 屏 4 行 × 16px 且驱动画不了 y<0 的内容
 * （vOledShowImage 在 Y>63 直接 return），整屏滑会在顶边留下细黑边。 */
#define OLED_MENU_ANIM_EN   0   /* 换行动画 @(0~1) // 0=关(与加动画之前逐字节一致) 1=开。⚠️ 运行时也能改: 蓝牙 Tab「OLED」组的 oled_menu_anim（当场生效, 零重编译）; 这里只是**上电初值**（与 BALL_ / ARM_GROUP_OFS_ 那批标定量的惯例相同）。⚠️ 别把 8px 调大: 菜单标签预算 120px, 120+8=128 正好铺满一行, 再大就会在动画的头 1~2 帧里把长标签从尾部截掉 */

/* ==================== 蜂鸣 ==================== */
/* 非阻塞蜂鸣通道（请求槽/音型常量在 app_beam.h, 执行任务在 app_actuator.c::vBuzzerTask）。
 * 音型数值（失败音 0.8s×2 隔 0.5s / 丢靶短滴 0.2s）按用户 2026-10-27 定, 写死在
 * app_actuator.c 的 BUZZER_* 宏 —— 要改音型去那里, 不进控制台。 */
#define BUZZER_YAW_STALE_MS     600  /* 陀螺停摆判定窗 [ms] @(100~5000) // 跑动中姿态帧号停涨超过它 = 陀螺仪损坏 → 失败音一声; 判法=帧号法（与 LINE_GYRO_STALE_MS 同一套）, 必须 ≥ ATK 驱动单次阻塞读的 500ms; 保护类窗口量, 刻意不进蓝牙 */

/* ==================== 路线位移变量 ==================== */
/* 「默认路线」主表与其调用的子预设（安全/常规扫码、走左/走右边、过减速带、复位回起点）
 * 里每一步世界系平移的距离都提成了本段的宏 —— 改长度只改这里一处（控制台「位移」Tab
 * 可视化管理/「调参」Tab 直接改数字都落到这几行）, Keil 重编译烧录后生效。
 * map.c 参数槽里写的就是这些宏名（C 编译期展开成数值, 与 TIMER_CMD_START / ARM_ACT_n
 * 同一待遇）。测试沙盒预设（原地转弯/脚本重置的 300mm 等）不在路线调用链上, 刻意不提。
 * ⚠️ 删宏/改宏名前先确认 map.c 没有引用（「位移」Tab 删除时会查并拦;
 *    手改的话漏一处就是 undefined identifier —— 有意的硬失败）。
 * ⚠️ 位移是**带符号**的世界系分量（+X=启动左方, +Y=启动前方, 见 map.c 头注）,
 *    负值 = 沿负轴走; 「出发斜线」是斜向移动的行程量。 */
#define MOVE_OUT_DIAG      70.0f      /* 出发斜线 [mm] @(-2000~2000) // 斜线到出发区中央（斜向行程量） */
#define MOVE_ROAD_X        550.0f     /* 扫码后横移 [mm] @(-2000~2000) // 走完左/右边汇合后的世界系横移 */
#define MOVE_BULB_Y        625.0f     /* 灯泡前纵移 [mm] @(-2000~2000) // 看路对位后往灯泡方向的纵移 */
#define MOVE_LAMP_X        (-430.0f)  /* 灯泡横向 [mm] @(-2000~2000) // 前往灯泡处 */
#define MOVE_LASER_X       (-790.0f)  /* 激光半程 [mm] @(-2000~2000) // 走到激光半程 */
#define MOVE_FACE_X        (-920.0f)  /* 人像横向 [mm] @(-2000~2000) // 前往人像处 */
#define MOVE_LEAVE_X       (-460.0f)  /* 离靶横移 [mm] @(-2000~2000) // 离开激光准备转弯（该步勾了叠加残留） */
#define MOVE_HOSTAGE_Y     (-710.0f)  /* 人质纵向 [mm] @(-2000~2000) // 走到人质 */
#define MOVE_END1_Y        (-820.0f)  /* 尽头一段 [mm] @(-2000~2000) // 一步走到世界尽头·第一段（叠加残留） */
#define MOVE_END2_Y        (-830.0f)  /* 尽头二段 [mm] @(-2000~2000) // 一步走到世界尽头·第二段 */
#define MOVE_QR_SAFE_Y     630.0f     /* 扫码位·安全 [mm] @(-2000~2000) // 「安全扫码」一步前进到二维码位 */
#define MOVE_QR_NORM_Y     475.0f     /* 扫码位·常规 [mm] @(-2000~2000) // 「常规扫码」前进到二维码位 */
#define MOVE_QR_NEAR_Y     180.0f     /* 扫码补近 [mm] @(-2000~2000) // 「常规扫码」首扫失败后"再靠近一点"那步 */
#define MOVE_QR_BACK_Y     (-180.0f)  /* 扫码退回 [mm] @(-2000~2000) // 「常规扫码」扫完"退回准备转弯"那步 */
#define MOVE_LEFT_X        545.0f     /* 左边前进 [mm] @(-2000~2000) // 「走左边」过减速带前的横移 */
#define MOVE_RIGHT_X       (-470.0f)  /* 右边前进 [mm] @(-2000~2000) // 「走右边」过减速带前的横移 */
#define MOVE_RIGHT2_X      1300.0f    /* 右边续进 [mm] @(-2000~2000) // 「走右边」汇合巡线前多走的那段 */
#define MOVE_RAMP_Y        710.0f     /* 过减速带 [mm] @(-2000~2000) // 「过减速带(倒退顶住)」冲坎行程 —— 走左/走右边共用, 改这里一处 */
#define MOVE_HOME_X        1400.0f    /* 回出发点 [mm] @(-2000~2000) // 「复位回起点」横移回出发区 */

/* 自定义开关（「自定义」Tab 管理, STEP_IF 的自定义条件）—— 段本体在文件末尾; 下面先放说明 */
/* 每个开关 = 一个 0/1 编译期宏 + 控制台「自定义」Tab 清单里的一条:
 *   · app_script.h 的 emScriptCondTdf 尾部「生成块」多一个成员 → 条件下拉多一个
 *     「自定义:xxx」条目（app_script.c 的注册表生成块同步一行）;
 *   · 本段的宏 = 开关的**状态**（编译期）—— 控制台上点击切换 / 这里改数字 / 「调参」Tab
 *     勾选框, 都是改同一行, 改完 Keil 重编译烧录才上车。
 * 增删开关与改名走「自定义」Tab（生成块 + 本段一起重写）; 宏名定了就别改。
 * ⚠️ 删开关前控制台会查 map.c 引用（被 IF 用的删不掉 —— 删了就是 undefined identifier）。 */

/* ==================== 任务优先级 ==================== */
/* 取值 1~6：configMAX_PRIORITIES=7, 0 是空闲任务优先级不可用。越界时 FreeRTOS 只静默钳位
 * 而不报错，故每个都标 @(1~6) 让控制台给出黄框提示。
 * 相对顺序是隐式契约（下面每条备注里写明）：脚本 > 按键(2)、PID > 脚本、传感器 < 按键；
 * COMM/MOTOR/ARM/PID 同为 4，单独调高其中一个会改变其余任务的时间片。 */
#define APP_PRIO_OLED       1               /* OLED 优先级 [级] @(1~6) // 显存刷新, 最低 */
#define APP_PRIO_KEY        2               /* 按键优先级 [级] @(1~6) // 跑路线时仍要能急停 */
#define APP_PRIO_SCRIPT     3               /* 脚本运行器优先级 [级] @(1~6) // 须 > 按键(2), 运动中仍可响应按键 */
#define APP_PRIO_PID        4               /* PID 周期任务优先级 [级] @(1~6) // 须 > 脚本(3), 50ms 节拍不能被饿 */
#define APP_PRIO_ARM        4               /* 机械臂优先级 [级] @(1~6) // 与 MOTOR/COMM/PID 同为 4, 改一个即改时间片 */
#define APP_PRIO_MOTOR      4               /* 电机优先级 [级] @(1~6) // 同上 */
#define APP_PRIO_COMM       4               /* 通信优先级 [级] @(1~6) // 同上 */
#define APP_PRIO_SENSOR     1               /* 姿态传感器优先级 [级] @(1~6) // 须 < 按键(2), ATK 阻塞读帧最长 500ms */


/* ==================== 自定义开关 ==================== */
#define SW_COLOR_TASK_REVERSE        0  /* 色球反向 @(0~1) */
#define SW_TARGET_TASK_REVERSE       0  /* 标靶反向 @(0~1) */
#define SW_HOSTAGE_REVERSE           0  /* 人质反向 @(0~1) */
#define SW_DISABLED_LEFT_ROAD        0  /* 左边封路 @(0~1) */
#define SW_REVERSE_COLOR_AND_HOSTAGE 0  /* 色球与人质交换 @(0~1) */
#define SW_REVERSE                   0  /* 二维码板与人质台交换 @(0~1) */
#define SW_SWAP_HOS_AND_BALL_FUNCTION 0  /* 人质放置到爆爆桶+抓取色球 @(0~1) */
#endif /* __APP_CONFIG_H */
