Qexran/GongKeCompetition/电控/GongKeCompetition/Core/Inc/oled_config.h

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

#ifndef __OLED_CONFIG_H
#define __OLED_CONFIG_H

/* Platform selection (kept for compatibility with the driver's #if branches). */
#define ST                  1
#define TI                  0
#define QEPACK_PLATFORM     ST

/* OLED module switch and device count. */
#define OLED_IS_ENABLE      1
#define OLED_DEV_NUM        1
#define OLED_IS_USE_HARDWARE 0   /* 1 = hardware I2C (I2C2), 0 = software bit-bang */

/* Device alias used by application code. */
#define OLED0               emOledDevNum0

#endif /* __OLED_CONFIG_H */
