Qexran/GongKeCompetition/(commit log)

2026-11-11 add pcb file.
2026-11-11 docs: 添加Apache License 2.0开源协议及说明文档
2026-11-12 一阶段工程
    [AAA主摄像头支架.gcode.3mf, AAA第一部分人质.gcode.3mf, AAA第二部分人质.gcode.3mf, QE球体.gcode.3mf, c测试.SLDASM, 人质放置台.SLDPRT, 人质放置台.STEP, 人质放置台V2.0.STEP]
